AnBuiUCI/sscs-2026-zotnetic/FINAL/reportes/reporte_zotnetic_ES.txt

GUIÓN DEL REPORTE — TEAM ZOTNETIC B26

Acompaña a reporte_zotnetic_ES.pptx (presentación en español).
Qué dice cada diapositiva y para qué está, en el mismo orden que el
fichero. En español en las dos versiones: la presentación cambia de
idioma, quien la presenta no.

Generado por hacer_pptx.py junto con el .pptx. No editar a mano.
==============================================================================

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

DIAPOSITIVA 2 · 01 QUÉ HACE EL CHIP  [SECCIÓN]
----------------------------------------------
Separador. Antes de enseñar un transistor, qué problema resuelve el chip.

DIAPOSITIVA 3 · EL PRINCIPIO
----------------------------
La idea que hay que entender antes que nada: los cuatro puentes NO miden la
dirección del campo, miden su módulo en cuatro puntos.

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

La salida no dice cuánto, dice hacia dónde: un signo por eje.

DIAPOSITIVA 4 · ARQUITECTURA
----------------------------
El diagrama de bloques del sistema completo, el que ya teníais en la
presentación.

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

DIAPOSITIVA 5 · ESPECIFICACIONES
--------------------------------
La tabla de especificaciones: entradas, salidas, consumo, tipos de pad y
áreas, todo en una diapositiva.

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

DIAPOSITIVA 6 · ESPECIFICACIONES
--------------------------------
Y la misma información en unidades que se pueden imaginar. Todo el reporte
trabaja en dR/R —el cambio relativo de resistencia de un brazo del puente—
porque es lo que ve el circuito y no depende del sensor que se le ponga
delante. Pero nadie tiene intuición para 44 ppm.

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

DIAPOSITIVA 7 · 02 LOS TRES BLOQUES  [SECCIÓN]
----------------------------------------------
Separador. Empieza el recorrido por la jerarquía: primero qué hace cada bloque
y su diagrama interno, luego cada subbloque con su esquemático y sus
simulaciones, y al final el resultado del bloque.

DIAPOSITIVA 8 · GRADIENT_NAV2_V3 POR DENTRO
-------------------------------------------
El navegador por dentro, en un solo dibujo: cuatro bloques de sensado, tres de
peso y tres de salida.

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

DIAPOSITIVA 9 · LA ALIMENTACIÓN DEL BLOQUE
------------------------------------------
Cómo se reparte la alimentación dentro del bloque, que es lo último que se
rehízo.

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

DIAPOSITIVA 10 · BLOQUE 1 · SENSADO DE GRADIENTE
------------------------------------------------
El primero de los tres bloques: el sensado de gradiente.

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

DIAPOSITIVA 27 · BANCO DEL GRADIENTE · MÉTODO
---------------------------------------------
Explicados los tres subbloques, el resultado del bloque de sensado.

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

DIAPOSITIVA 28 · BANCO DEL GRADIENTE · MÉTODO
---------------------------------------------
El banco montado: los tres puentes a un lado y las cuatro cadenas colgando de
los mismos nodos, cada una con su fuente separada — se ven las cuatro.

DIAPOSITIVA 29 · TRAZABILIDAD DEL SENSADO
-----------------------------------------
La sub-sección de trazabilidad del sensado, que es lo que faltaba: hasta aquí
se enseñaba el resultado del bloque, no cómo llega la señal hasta él.

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

DIAPOSITIVA 30 · RESULTADO DEL BLOQUE · SENSADO DE GRADIENTE
------------------------------------------------------------
Aquí está el bloque entero en una sola hoja, que es como se pidió. Una COLUMNA
es un eje y una FILA es una etapa, así que un eje se sigue de arriba abajo sin
cambiar de diapositiva: el campo, lo que entrega su puente, el amplificador
que lo lee, el comparador y la decisión.

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

DIAPOSITIVA 31 · RESULTADO DEL BLOQUE · SENSADO DE GRADIENTE
------------------------------------------------------------
La misma hoja con el campo que da una AMR de verdad, dR/R del 2 %. La
diferencia con la anterior es la única variable: aquí el amplificador SATURA,
y se ve recortado contra los dos raíles en toda la fila tercera.

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

DIAPOSITIVA 32 · RESULTADO DEL BLOQUE · SENSADO DE GRADIENTE
------------------------------------------------------------
Esta diapositiva y la siguiente contestan una pregunta distinta a todo lo
anterior, y conviene decirlo antes de enseñarla. Hasta aquí el campo GIRABA
manteniendo su tamaño: se probaba si el chip acierta la dirección. Aquí se
hace lo contrario — la dirección se clava a 60°, en mitad de un sector, y lo
que se barre es el MÓDULO del campo, de casi nada hasta el 2 %.

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

DIAPOSITIVA 33 · RESULTADO DEL BLOQUE · SENSADO DE GRADIENTE
------------------------------------------------------------
La misma pregunta, en el extremo bajo y con su propia escala. Ésta es la que
da el número que importa: el campo MÍNIMO que el chip puede resolver.

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

DIAPOSITIVA 34 · RESULTADO DEL BLOQUE · SENSADO DE GRADIENTE
------------------------------------------------------------
El consumo de la cadena a lo largo del mismo barrido. Sube al pasar por la
zona activa y se aplana cuando el amplificador satura.

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

DIAPOSITIVA 35 · RESULTADO DEL BLOQUE · SENSADO DE GRADIENTE
------------------------------------------------------------
ANTES DE LEER LAS BARRAS, de qué es el porcentaje. Aquí el barrido sigue
subiendo el campo MUCHO después de que el amplificador sature, a propósito,
porque lo que se busca es dónde se rompe. Así que el denominador incluye
puntos que están fuera del alcance del bloque, y por eso salen barras del 75 %
donde otras diapositivas dan 95 %.

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

DIAPOSITIVA 36 · RESULTADO DEL BLOQUE · SENSADO DE GRADIENTE
------------------------------------------------------------
Y ahora sí, la vista condensada de la decisión, que va aquí y no antes porque
hasta este punto el comparador ya está explicado. Las salidas de los
amplificadores, las de los comparadores y las del decodificador, una debajo de
otra, con un color por eje para poder seguir un eje entero. Continuo el
esquemático, discontinuo el layout.

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

DIAPOSITIVA 37 · RESULTADO DEL BLOQUE · SENSADO DE GRADIENTE
------------------------------------------------------------
Y el número. Arriba, el eje decodificado contra el ideal — que es el eje
MENOR, no el mayor: está en la tabla de verdad del decodificador, X = XY·XZ.
Abajo, dónde cae cada frontera respecto a los 0, 120 y 240° exactos.

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

DIAPOSITIVA 38 · POR QUÉ UNOS CASOS FALLAN Y OTROS NO
-----------------------------------------------------
Ésta contesta la pregunta que deja la figura anterior: por qué los octantes
con más signos negativos salen peor. Y la respuesta no es que el chip trate
distinto a un signo que a otro.

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

DIAPOSITIVA 39 · GRADIENT2, TODO LO MEDIDO
------------------------------------------
Y todo lo medido en el bloque, junto. Hasta ahora estaba repartido entre cinco
diapositivas y no había dónde mirar «cuánto da GRADIENT2».

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

DIAPOSITIVA 40 · DÓNDE SE ROMPE, Y BAJO QUÉ CONDICIÓN
-----------------------------------------------------
Y como la tabla anterior deja una condición señalada, el paso siguiente es un
banco hecho para llevar ESA condición al límite y ninguna otra. Doce corridas
nuevas en el mismo esquemático.

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

DIAPOSITIVA 41 · BLOQUE 2 · WEIGHT
----------------------------------
El diagrama interno de WEIGHT: por dónde entra cada señal y qué sale. Se
recorre con el dedo de izquierda a derecha; los números vienen en la
diapositiva siguiente.

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

DIAPOSITIVA 46 · BLOQUE 3 · COMP_OUT
------------------------------------
El diagrama interno de COMP_OUT: por dónde entra cada señal y qué sale. Se
recorre con el dedo de izquierda a derecha; los números vienen en la
diapositiva siguiente.

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

DIAPOSITIVA 51 · ESD_CDM · PROTECCIÓN SECUNDARIA
------------------------------------------------
La protección secundaria. No está en la cadena de señal, pero sí en el área de
usuario y hay once instancias, una por pad analógico.

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

DIAPOSITIVA 53 · 03 RESULTADOS TOTALES  [SECCIÓN]
-------------------------------------------------
Separador. Explicados todos los bloques, los resultados del sistema completo.
Todos son comparaciones de layout contra esquemático.

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

DIAPOSITIVA 55 · BANCO DEL NAVEGADOR · MÉTODO
---------------------------------------------
El banco del navegador completo, el de la versión que se fabrica: los cuatro
puentes y, colgados de sus ocho nodos, los DOS navegadores — el del
esquemático y el reconstruido desde el layout con parásitos.

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

DIAPOSITIVA 56 · BANCO DEL NAVEGADOR · MÉTODO
---------------------------------------------
El método. El navegador del layout va extraído CON parásitos RC, que es lo que
hace la comparación honrada: sin parásitos se estaría comparando el
esquemático consigo mismo.

Cada cadena con su alimentación, para medir los dos consumos sin que se
mezclen.

DIAPOSITIVA 57 · RESULTADO · LAYOUT CONTRA ESQUEMÁTICO
------------------------------------------------------
El resultado en una imagen: las tres salidas de eje, las dos versiones
superpuestas.

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

DIAPOSITIVA 58 · RESULTADO · LAYOUT CONTRA ESQUEMÁTICO
------------------------------------------------------
Los números, sobre 721 puntos de 0 a 360°. Conviene decir que esta diapositiva
llegó a poner 100 %, y era un artefacto: el banco tenía la reconstrucción
cableada con el reparto de sensores viejo y estaba comparando un cableado
contra otro. Arreglado eso y refrescados los netlists extraídos, éstos son los
números de verdad.

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

DIAPOSITIVA 59 · RESULTADO · LAYOUT CONTRA ESQUEMÁTICO
------------------------------------------------------
Cómo se construye una decisión en el chip entero, que es lo que no estaba en
ninguna diapositiva: por cada eje, cuántas de las cuatro cadenas votan
(escalera gris) y qué lee el contador analógico (color).

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

DIAPOSITIVA 60 · RESULTADO · LAYOUT CONTRA ESQUEMÁTICO
------------------------------------------------------
Y las seis salidas que salen del chip, cada par con su gemela negada — que es
literalmente su negado, no el otro sentido.

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

DIAPOSITIVA 61 · RESULTADO · LAYOUT CONTRA ESQUEMÁTICO
------------------------------------------------------
Conviene dejar claro qué dicen esos seis pines, porque es fácil leerlos mal.
NO son seis sentidos. Son tres decisiones con su complemento: XP alto
significa «gana el eje X», y XN es exactamente su negado, que es lo que
alimenta el puente en H.

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

DIAPOSITIVA 62 · RESULTADO · LAYOUT CONTRA ESQUEMÁTICO
------------------------------------------------------
Los casos de prueba por octante en el navegador completo, que es lo que
pediste: el gradiente recorriendo la esfera entera, no un plano, de modo que
las ocho combinaciones de signo de X, Y y Z quedan cubiertas y con el mismo
número de muestras cada una.

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

DIAPOSITIVA 63 · RESULTADO · LAYOUT CONTRA ESQUEMÁTICO
------------------------------------------------------
Y el mismo barrido con el reparto de puertos anterior, para que se vea de
dónde se viene: 76.2 % contra 90.7 %.

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

DIAPOSITIVA 64 · RESULTADO · LAYOUT CONTRA ESQUEMÁTICO
------------------------------------------------------
Aviso antes de leerla: estas dos diapositivas son del reparto de puertos
ANTERIOR, no del que se fabrica. Están aquí porque son el diagnóstico que
llevó a la v3 — enseñan dónde se perdía el acierto, y sin ellas el cambio de
reparto parece un capricho.

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

DIAPOSITIVA 65 · RESULTADO · LAYOUT CONTRA ESQUEMÁTICO
------------------------------------------------------
Y ésta contesta la pregunta que deja la anterior: si cada cadena acierta el
90.9 %, ¿por qué el chip entero se queda en 76.2 %?

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

DIAPOSITIVA 66 · BANCO DE GEOMETRÍA · MÉTODO
--------------------------------------------
El banco de geometría: los cuatro sensores en los vértices del tetraedro de
una caja, y seis cajas distintas.

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

DE DÓNDE SALE:  XSCHEM/TEST_TOTAL/datos_geo/resumen.csv, seis cajas, producido
                por XSCHEM/TEST_TOTAL/run_nav2_geo.sh.

DIAPOSITIVA 67 · BANCO DE GEOMETRÍA · MÉTODO
--------------------------------------------
El banco de geometría montado: el navegador completo, con los sensores en los
vértices de una caja concreta. El barrido repite el experimento entero para
las seis.

DIAPOSITIVA 68 · RESULTADO · GEOMETRÍA DE LA CAJA
-------------------------------------------------
La tabla de las seis cajas. Lo que hay que leer es la FORMA, no el tamaño: la
caja cúbica de 1000 × 1000 llega al 97.8 % con gradiente alto, y achatarla a
Lz 500 cuesta acierto siempre, en las tres anchuras.

DIAPOSITIVA 69 · RESULTADO · GEOMETRÍA DE LA CAJA
-------------------------------------------------
La resolución, y por qué son DOS límites y no uno. Por abajo el offset de los
sensores pone un suelo: con un gradiente demasiado pequeño la diferencia entre
esquinas se pierde dentro del offset. Por arriba la saturación del
amplificador pone un techo. El número que se extrae —el gradiente más pequeño
con 95 % de acierto— captura los dos a la vez.

DIAPOSITIVA 70 · RESULTADO · GEOMETRÍA DE LA CAJA
-------------------------------------------------
Las seis cajas dibujadas. Al achatarlas el tetraedro pierde separación en z, y
con ella la información que distingue arriba de abajo. Explica de un vistazo
por qué la tabla penaliza siempre a las de Lz 500.

DIAPOSITIVA 71 · RESULTADO · GEOMETRÍA DE LA CAJA
-------------------------------------------------
El campo terrestre. Es común a los cuatro sensores, así que se cancela al
compararlos entre sí, pero NO en el amplificador, que lo ve entero y lo
amplifica. La curva enseña a qué nivel de fondo se pierde la medida.

DIAPOSITIVA 72 · BANCO DE FUENTE · MÉTODO
-----------------------------------------
El banco de fuente, la pregunta para la que existe el chip. Ya no se impone un
gradiente: se pone una fuente en un sitio y cada sensor lee el módulo en su
vértice.

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

DIAPOSITIVA 73 · BANCO DE FUENTE · MÉTODO
-----------------------------------------
El banco de fuente montado. Es el que más se parece a un experimento real con
un imán encima de la mesa.

DIAPOSITIVA 74 · RESULTADO · ¿APUNTA A LA FUENTE?
-------------------------------------------------
El ángulo que da el chip frente al ideal, por modelo y distancia.

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

DIAPOSITIVA 75 · RESULTADO · ¿APUNTA A LA FUENTE?
-------------------------------------------------
Ésta es la diapositiva que estaba al principio y que movimos aquí: ahora llega
en su sitio. Para cada uno de los cuatro vértices se dibuja el módulo que
debería leer y lo que su puente entrega. Las cuatro lecturas son distintas
entre sí, y esa diferencia ES el gradiente.

DIAPOSITIVA 76 · RESULTADO · ¿APUNTA A LA FUENTE?
-------------------------------------------------
Primero qué es cada eje, porque no es obvio. El eje horizontal NO es el ángulo
medido: es dónde está la fuente alrededor de la caja. El vertical sí es el
error — el ángulo entre el gradiente que el chip reconstruye de los cuatro
puentes y la dirección real a la fuente.

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

DIAPOSITIVA 77 · RESULTADO · ¿APUNTA A LA FUENTE?
-------------------------------------------------
La pregunta práctica: ¿sigue encontrando la fuente según te alejas? A la
izquierda, el acierto contra la distancia, con los dos modelos de campo y las
dos versiones de cableado. Cae de forma suave: a 2 mm el chip acierta el 91 %
y a 18 mm el 67 %.

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

DIAPOSITIVA 78 · RESULTADO · ¿APUNTA A LA FUENTE?
-------------------------------------------------
Los dos separados: lo que sale del chip, y lo que sale menos lo que daría un
chip perfecto. Lo segundo es la parte que pone el circuito. Justifica haber
corrido dos modelos en lugar de uno.

DIAPOSITIVA 79 · 04 VERIFICACIÓN FÍSICA  [SECCIÓN]
--------------------------------------------------
Separador. Se acaba la simulación y empieza lo que se entrega.

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

DIAPOSITIVA 81 · VERIFICACIÓN FÍSICA
------------------------------------
La verificación, toda sobre B26_A_filled4.gds, el fichero que se sube, no
sobre una versión anterior.

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

DIAPOSITIVA 82 · 05 CONCLUSIONES  [SECCIÓN]
-------------------------------------------
Separador. Lo esperado contra lo medido, incluido lo que no cerró.

DIAPOSITIVA 83 · LO ESPERADO CONTRA LO MEDIDO
---------------------------------------------
Tres cosas que se esperaban de una manera y resultaron ser de otra: XP y XN
cambiados respecto a su etiqueta, el umbral fuera de sitio, y el eje Z sin
poder ganar nunca.

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

DIAPOSITIVA 84 · LO QUE NO CERRÓ
--------------------------------
Lo que no cerró: el LVS de KLayout sobre el top no termina la extracción. Tres
intentos, ninguno llegó a comparar.

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

DIAPOSITIVA 85 · LA MEJORA, YA DENTRO DEL DIE
---------------------------------------------
El esquemático de la v3. Comparado con el del chip no cambia ni una celda: son
los mismos cuatro GRADIENT2, los mismos tres WEIGHT y los mismos tres
COMP_OUT.

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

DIAPOSITIVA 86 · LA MEJORA, YA DENTRO DEL DIE
---------------------------------------------
La v3 contra su propio layout, con las celdas extraídas con parásitos RC. El
verificador de grafo confirma que el navegador reconstruido ES el mismo
circuito que el esquemático de la v3, 31 celdas.

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

DIAPOSITIVA 87 · LA MEJORA, YA DENTRO DEL DIE
---------------------------------------------
De dónde sale la mejora, que se ve directamente en el análisis de las cadenas.

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

DIAPOSITIVA 88 · 06 ESTADO  [SECCIÓN]
-------------------------------------
Cierre. El chip está terminado y verificado, y el entregable es
B26_A_filled4.gds, con el navegador v3 dentro, sha 543d31ff.

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

Es la que conviene dejar en pantalla mientras se responden preguntas.
