AnBuiUCI/sscs-2026-zotnetic/FINAL/layouts_v2/RED_SUMA/RED_SUMA_flat_gf180_report.txt

# Reporte de layout: RED_SUMA
PDK: gf180
Transistores: 0
Nets: 0
Nets abutidas (difusion compartida): []
Ancho de la celda: 1.00 um
Tamano total: 3.00 x 121.30 um

## Transistores

## Conexiones (net -> pines)
