AnBuiUCI/sscs-2026-zotnetic/FINAL/integration/gds/2026-08-31_02/NOTAS.txt

2026-08-31_02 -- B26_A_filled.gds
=================================

source      openroad/out_integration/B26_A_filled.gds
written     2026-08-31 07:14
size        13,409,342 bytes raw, 2,492,394 gzipped
sha256      95ebcf92d8d36680bbf84d5530bdb882e7adeee7ccd2bdf8a0b5cda10dfe25ac

DRC filled  INCOMPLETE -- 5 table(s) raised: ldnmos, nwell, ldpmos, lvpwell, mslot
DRC circuit clean (1 tables)
density     clean
LVS klayout not run
LVS netgen  match uniquely

what changed
------------
Los escapes de pin pasan de placa maciza a peine: un dedo por diente mas una espina de 2 um que los une. Se van los once MSLOT.1 (placas de 55.7 x 44.3 um de Metal2, una por pad analogico, 5 al oeste y 6 al norte). El DRC de firma sobre el circuito corre en modo main/deep, que es el unico en el que la tabla mslot del PDK no revienta: 253 categorias, 0 items. Se entrega como B26_A_filled2.gds, byte a byte igual que este.

DRC completo -- anadido a mano el 2026-08-31, tras terminar el run
-----------------------------------------------------------------
La linea "DRC filled INCOMPLETE" de arriba es del run de TABLAS SEPARADAS, que
sobre un fichero relleno pierde cinco tablas (ldnmos, nwell, ldpmos, lvpwell y
mslot) y por eso no es un veredicto.

El run que si lo es, una sola tabla `main` en modo `deep` y un hilo, sobre este
mismo fichero:

    out/drc_B26_A_FILLED/B26_A_filled_main.lyrdb
    253 categorias declaradas, 0 items      LIMPIO
    MSLOT.1 entre las categorias, o sea que la regla corrio de verdad

Es la primera vez en este proyecto que el fichero que se entrega pasa el deck
COMPLETO, `mslot` incluida.
