AnBuiUCI/sscs-2026-zotnetic/FINAL/Layouts/COMP/COMP_flat_gf180.png

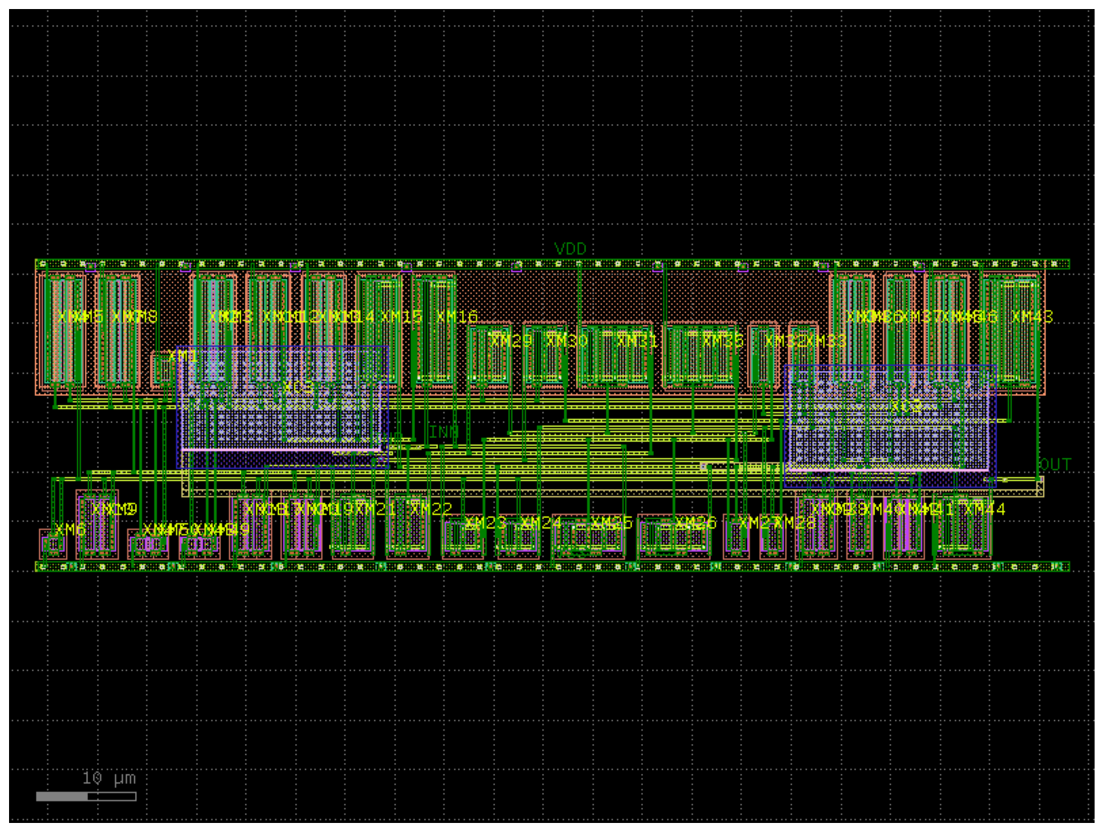
FINAL/Layouts/COMP/COMP_flat_gf180.png
