AnBuiUCI/sscs-2026-zotnetic/FINAL/Layouts/DECODER/DECODER_flat_gf180.png

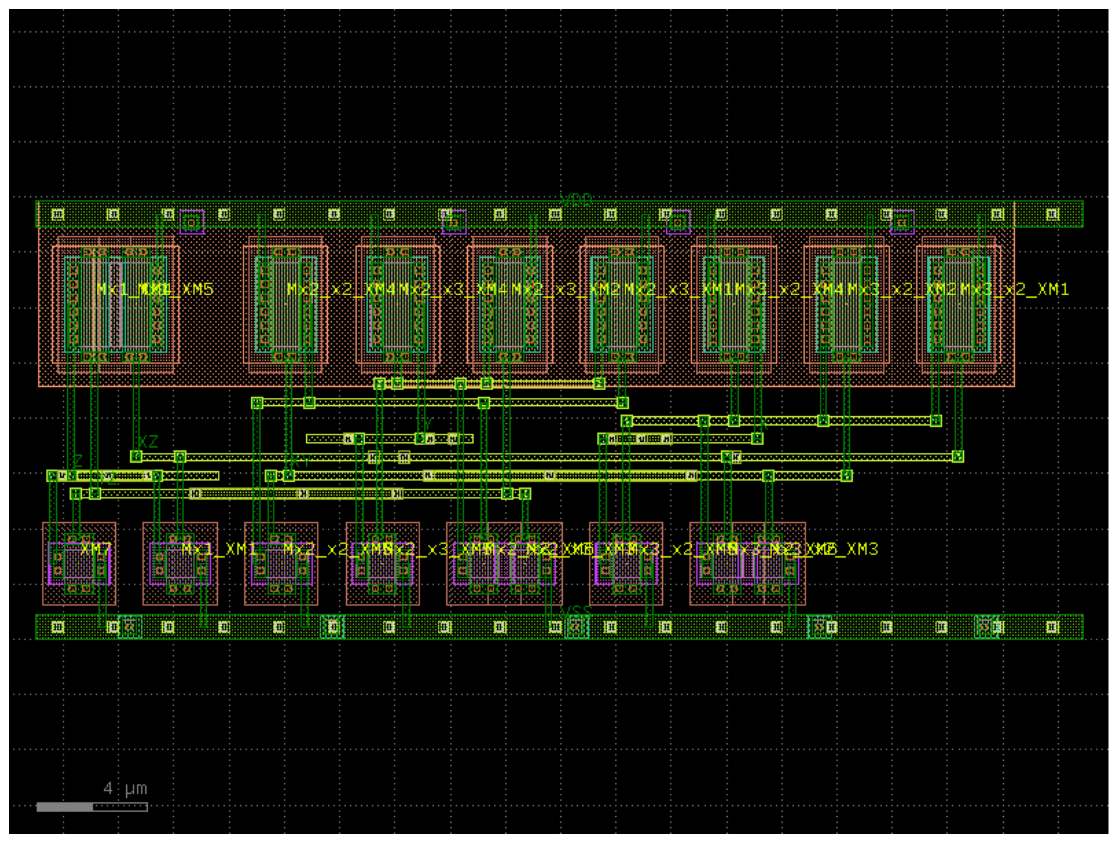
FINAL/Layouts/DECODER/DECODER_flat_gf180.png
