AnBuiUCI/sscs-2026-zotnetic/FINAL/Layouts/ESD_CDM/ESD_CDM_flat_gf180.png

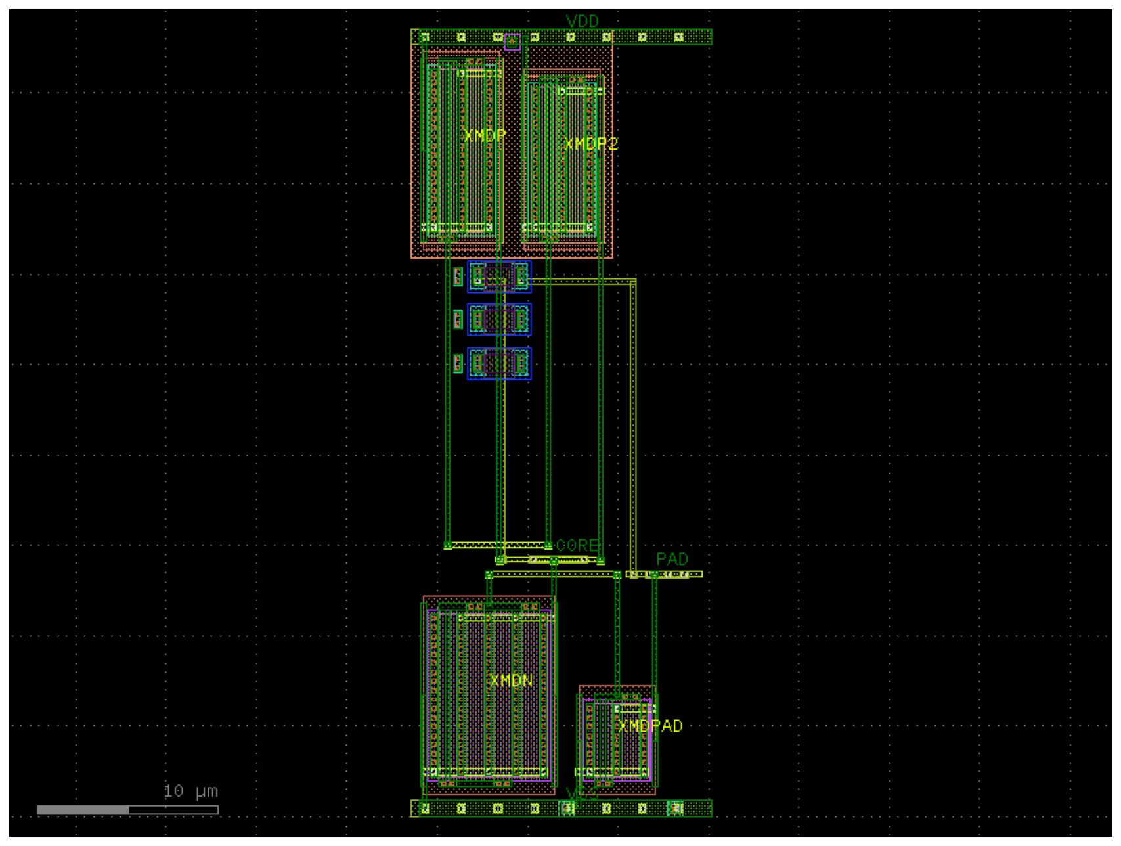
FINAL/Layouts/ESD_CDM/ESD_CDM_flat_gf180.png
