AnBuiUCI/sscs-2026-zotnetic/FINAL/Layouts/OPAM/OPAM_flat_gf180.png

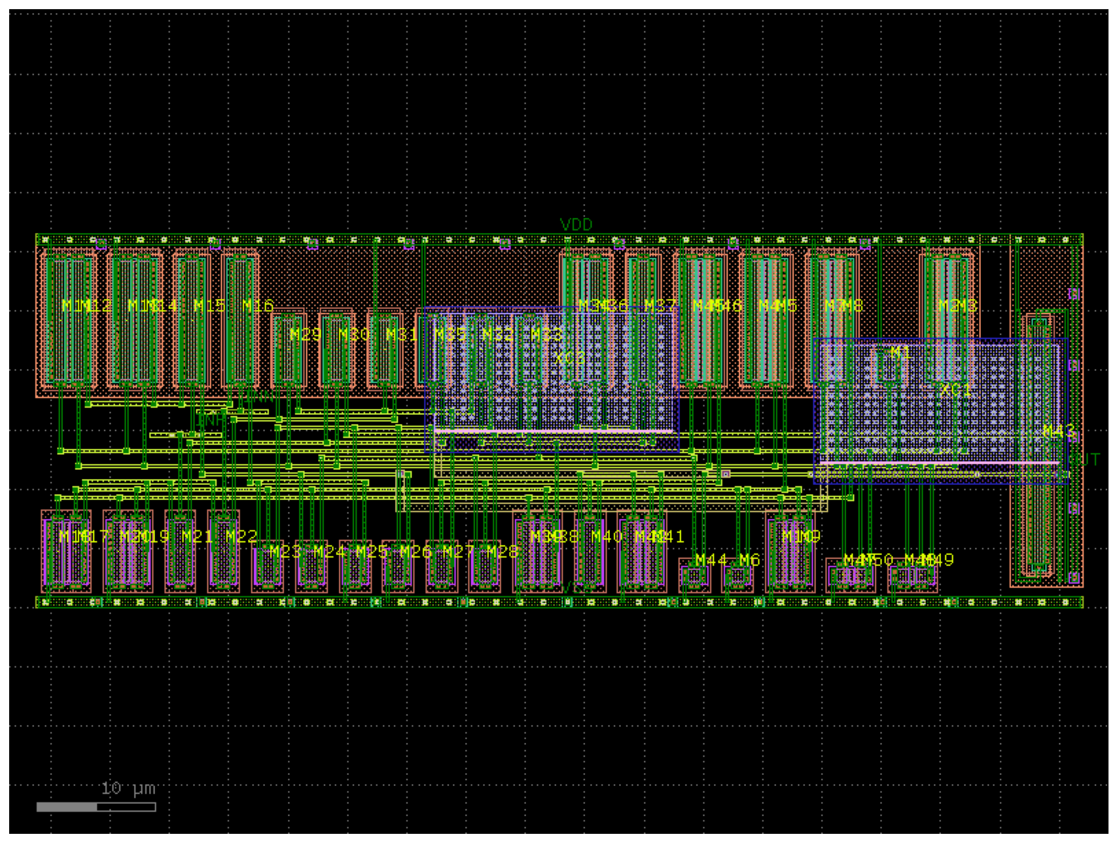
FINAL/Layouts/OPAM/OPAM_flat_gf180.png
