AnBuiUCI/sscs-2026-zotnetic/FINAL/Layouts/OPAM_LIN_flat/OPAM_LIN_flat_flat_gf180.png

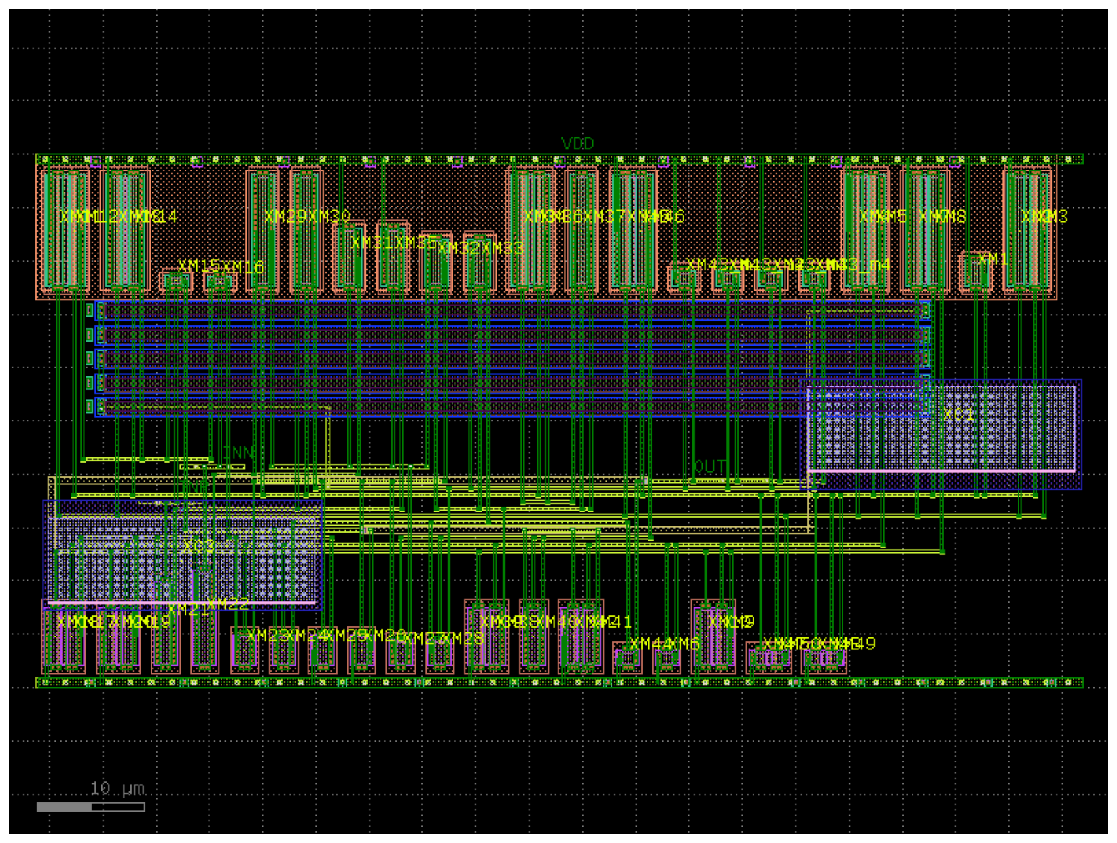
FINAL/Layouts/OPAM_LIN_flat/OPAM_LIN_flat_flat_gf180.png
