AnBuiUCI/sscs-2026-zotnetic/FINAL/Layouts/WEIGHT_COMP/WEIGHT_COMP_flat_gf180.png

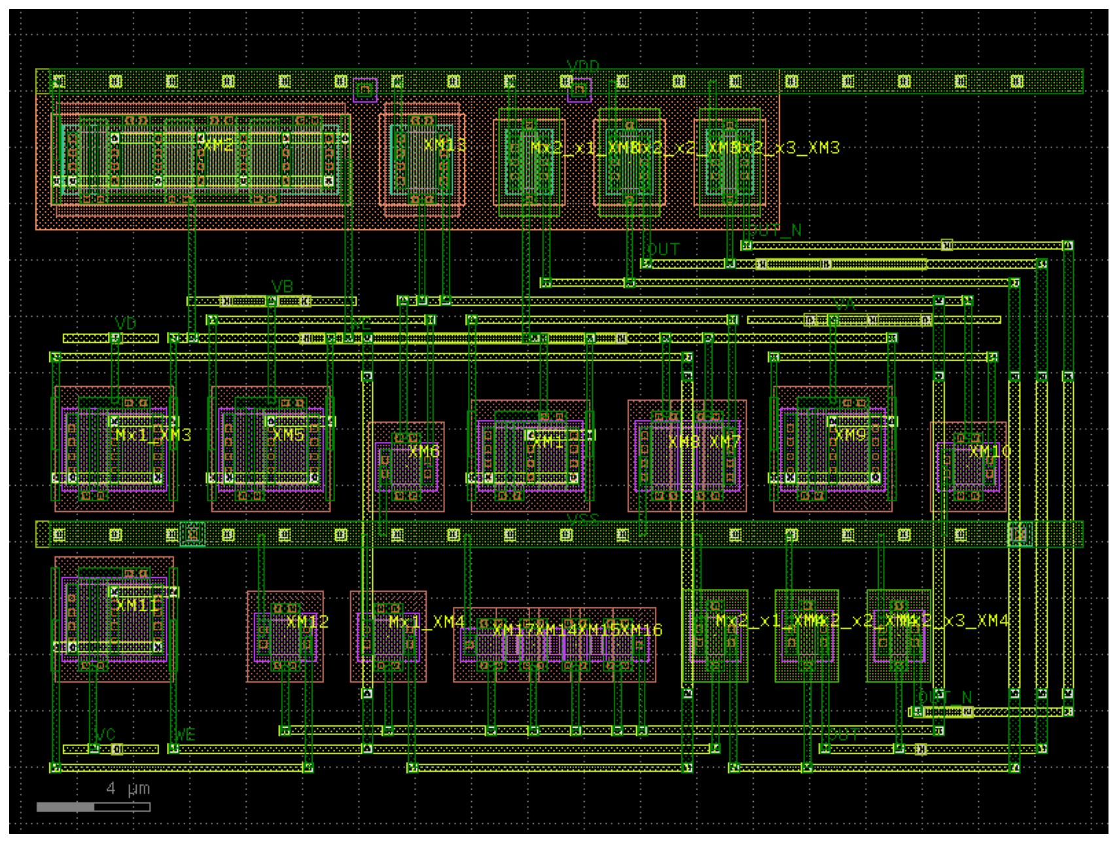
FINAL/Layouts/WEIGHT_COMP/WEIGHT_COMP_flat_gf180.png
