AnBuiUCI/sscs-2026-zotnetic/FINAL/layouts_v2/DECODER/DECODER_flat_gf180.png

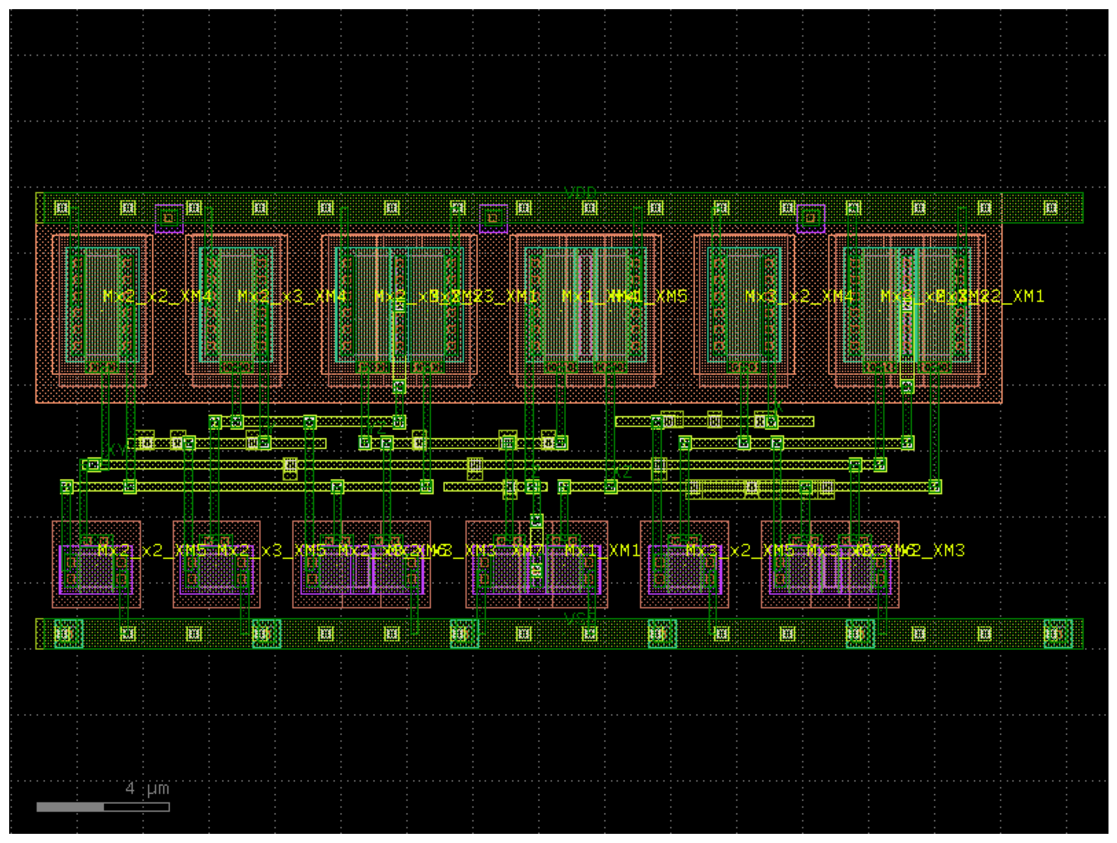
FINAL/layouts_v2/DECODER/DECODER_flat_gf180.png
