AnBuiUCI/sscs-2026-zotnetic/FINAL/layouts_v2/DECODER_MAX/DECODER_MAX_flat_gf180.png

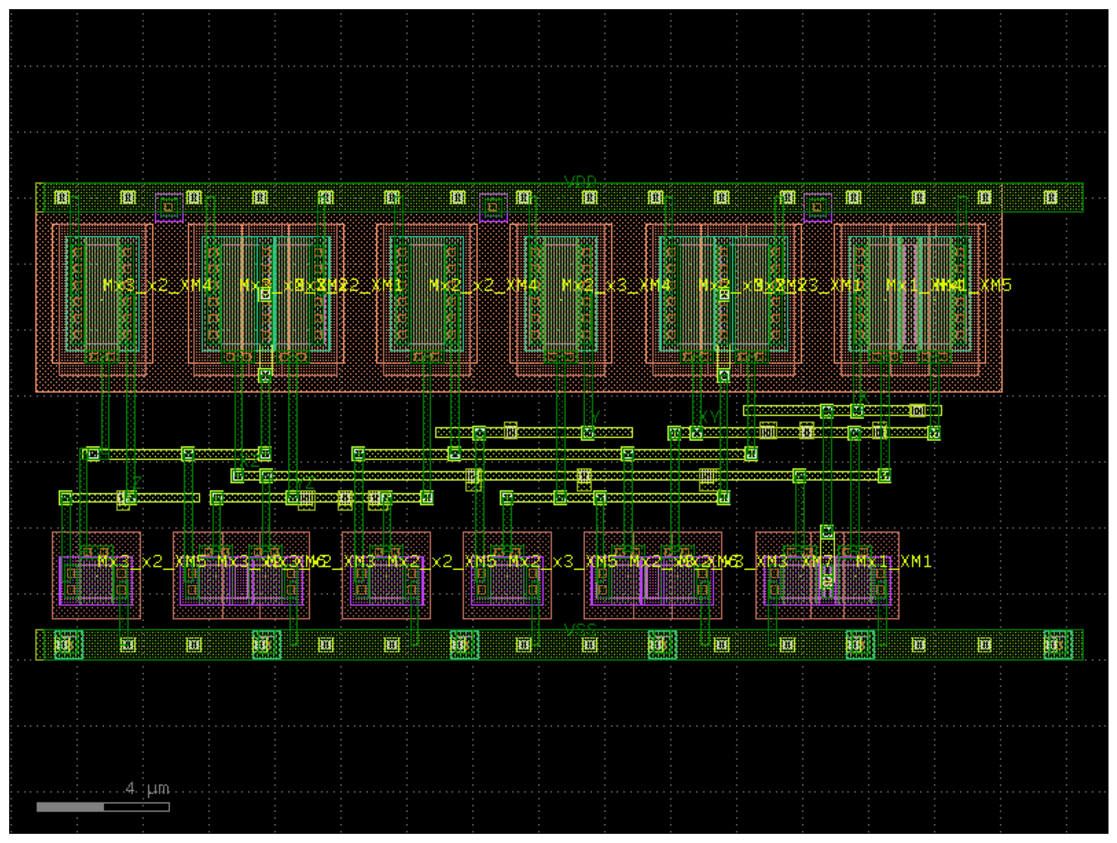
FINAL/layouts_v2/DECODER_MAX/DECODER_MAX_flat_gf180.png
