AnBuiUCI/sscs-2026-zotnetic/FINAL/layouts_v2/OPAM_LIN_flat/OPAM_LIN_flat_flat_gf180.png

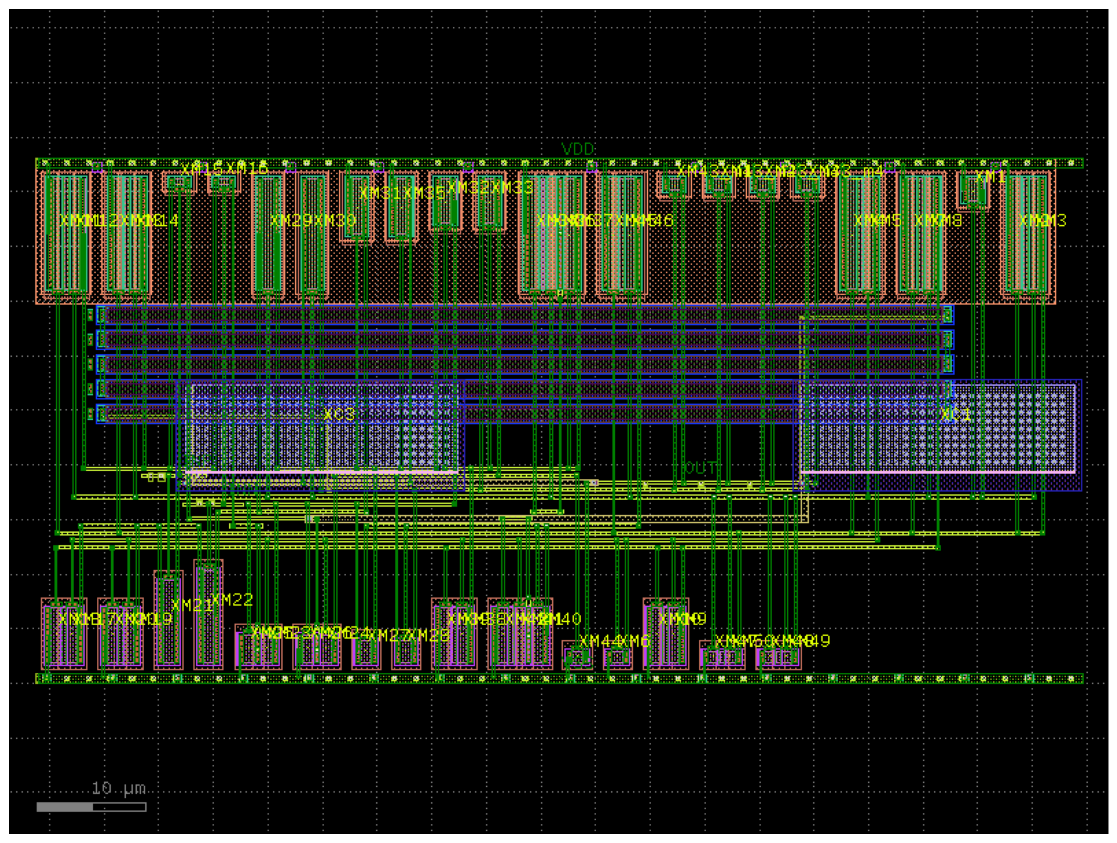
FINAL/layouts_v2/OPAM_LIN_flat/OPAM_LIN_flat_flat_gf180.png
