AnBuiUCI/sscs-2026-zotnetic/FINAL/layouts_v2/OPAM_SUMA/OPAM_SUMA_flat_gf180.png

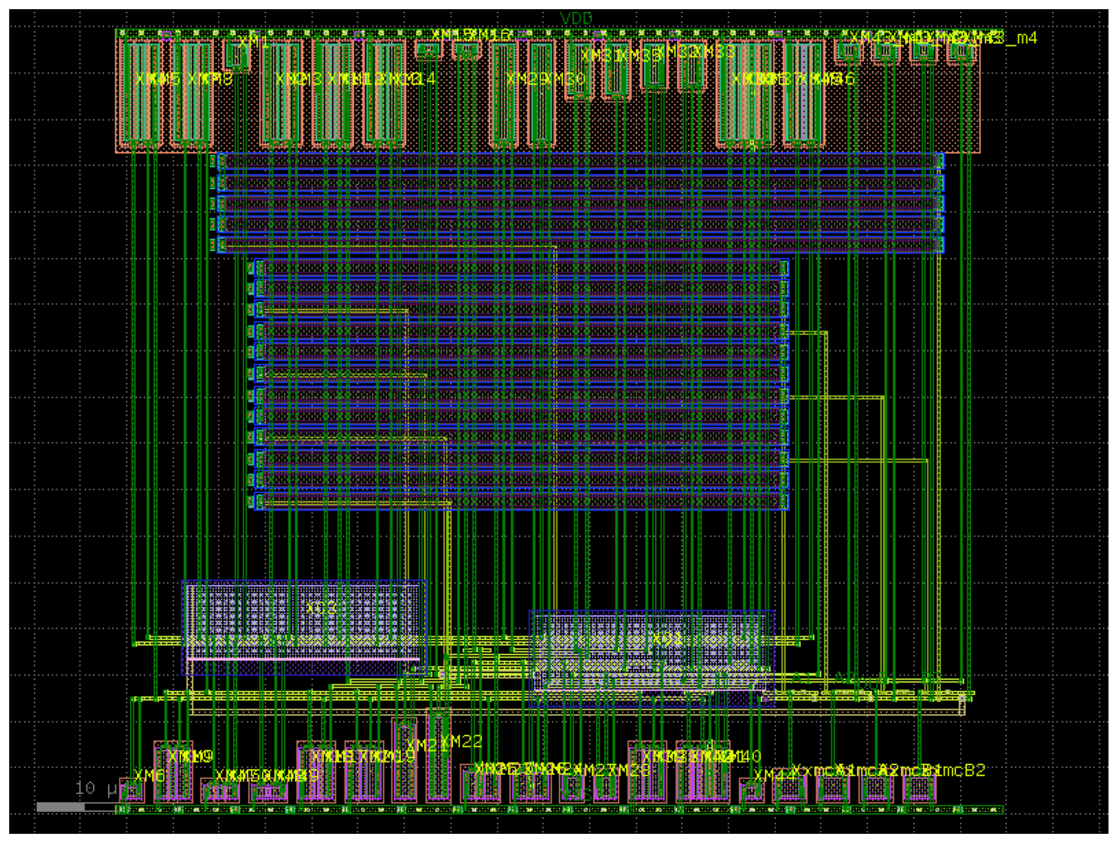
FINAL/layouts_v2/OPAM_SUMA/OPAM_SUMA_flat_gf180.png
