AnBuiUCI/sscs-2026-zotnetic/FINAL/layouts_v2/RED_SUMA/RED_SUMA_flat_gf180.png

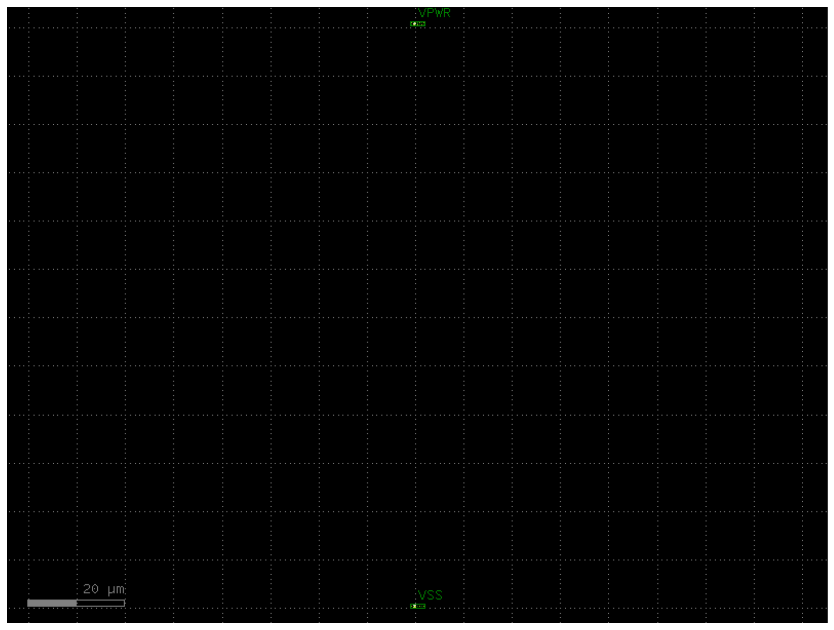
FINAL/layouts_v2/RED_SUMA/RED_SUMA_flat_gf180.png
