AnBuiUCI/sscs-2026-zotnetic/FINAL/layouts_v2/WEIGHT_COMP/WEIGHT_COMP_flat_gf180.png

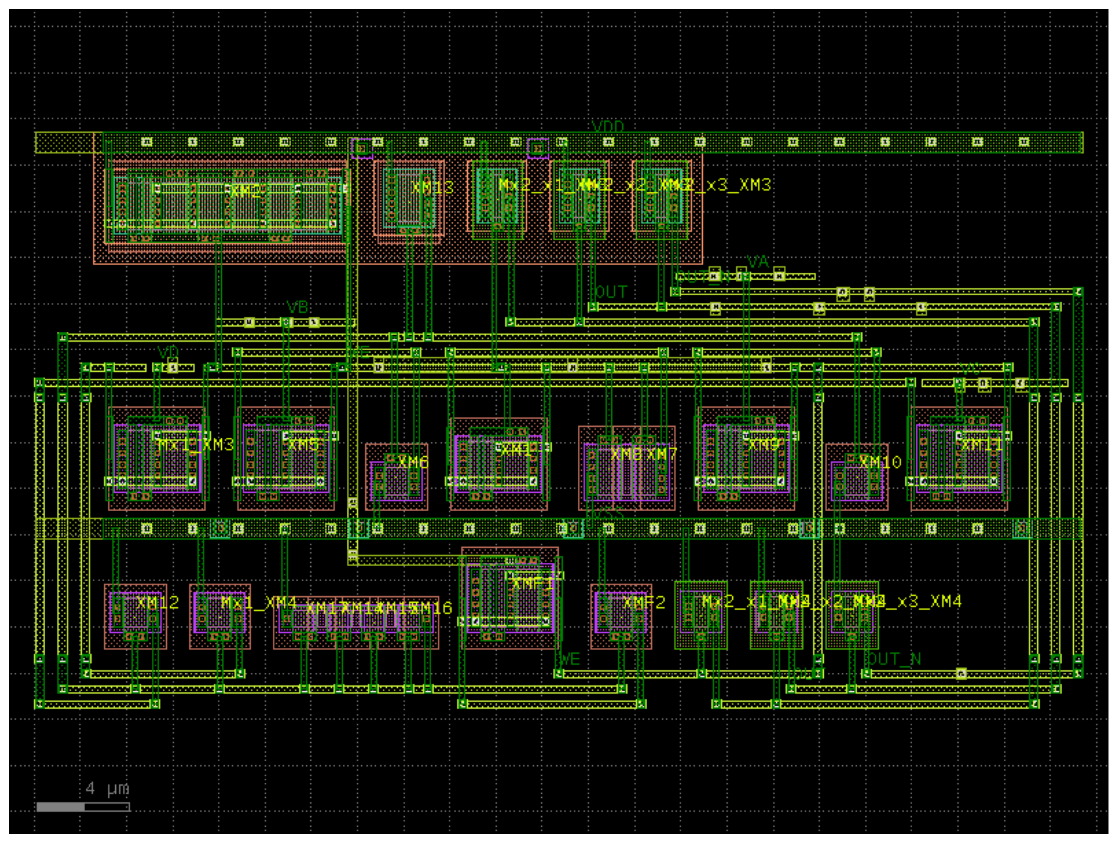
FINAL/layouts_v2/WEIGHT_COMP/WEIGHT_COMP_flat_gf180.png
