AnBuiUCI/sscs-2026-zotnetic/FINAL/openroad/out/GRADIENT_NAV.png

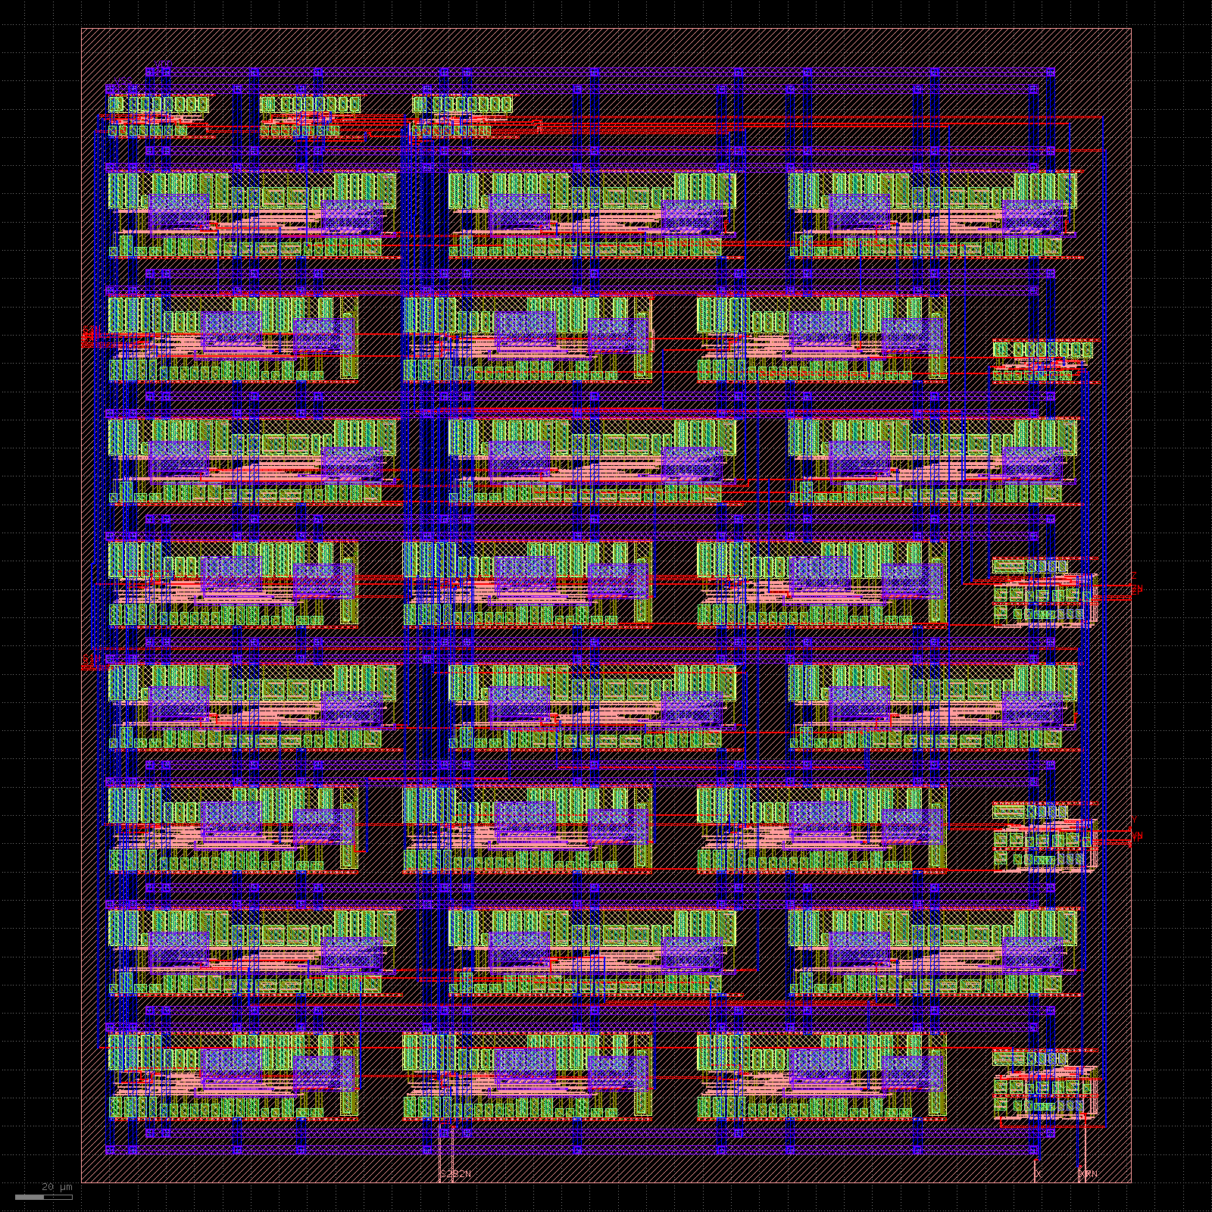
FINAL/openroad/out/GRADIENT_NAV.png
