AnBuiUCI/sscs-2026-zotnetic/FINAL/openroad/out_waferspace/cuatro.png

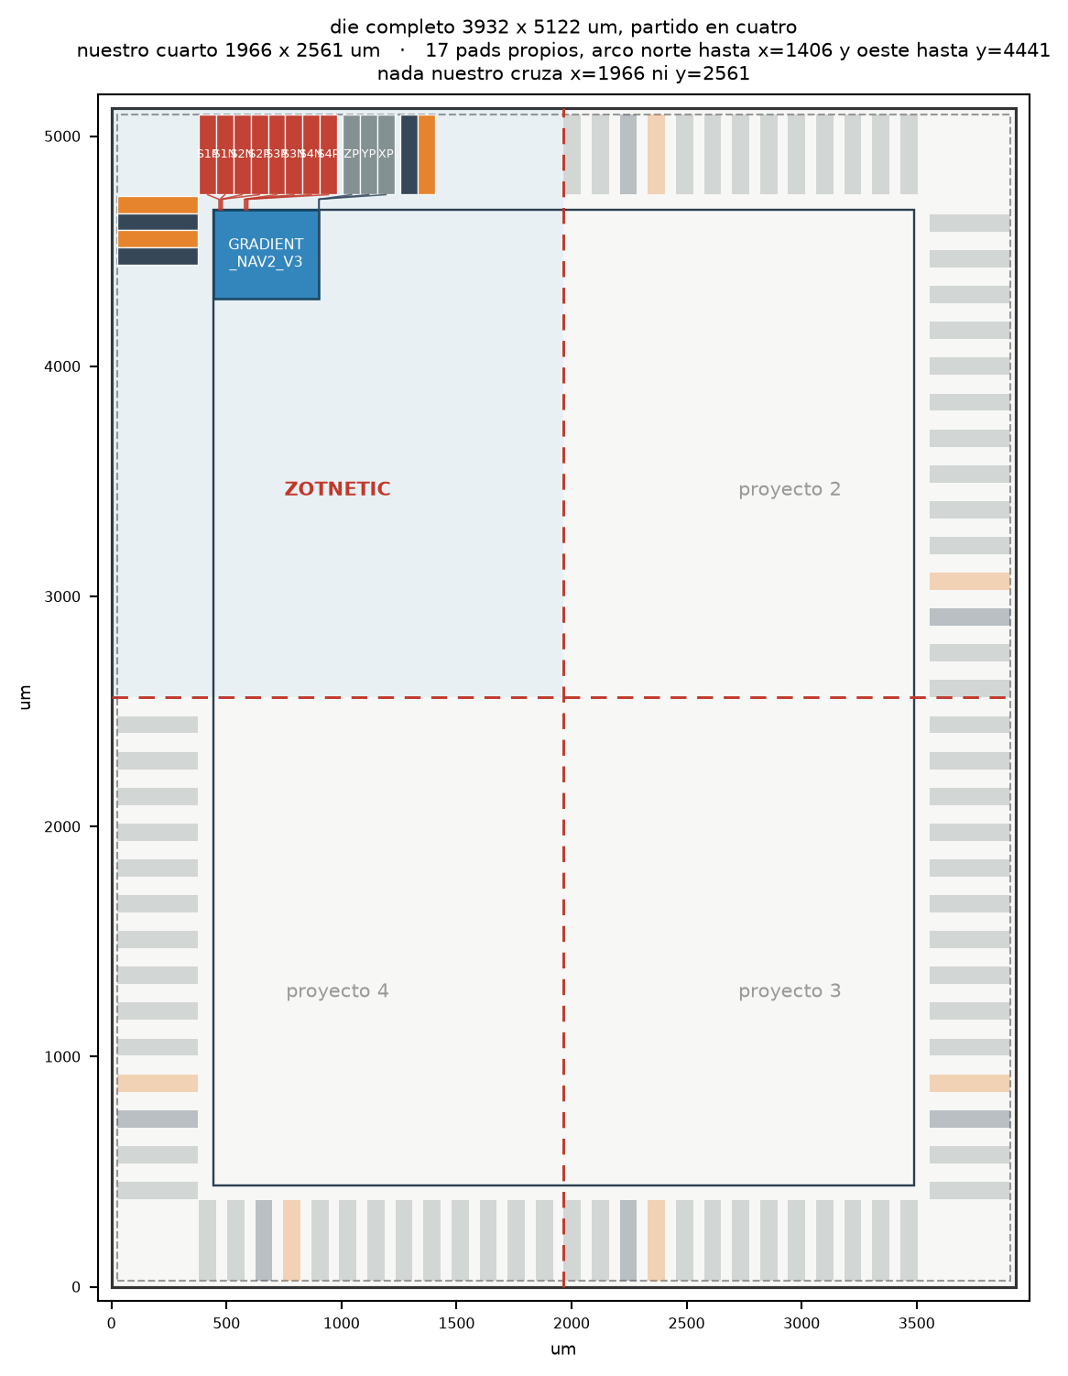
FINAL/openroad/out_waferspace/cuatro.png
