AnBuiUCI/sscs-2026-zotnetic/FINAL/openroad/out_waferspace/quarter.png

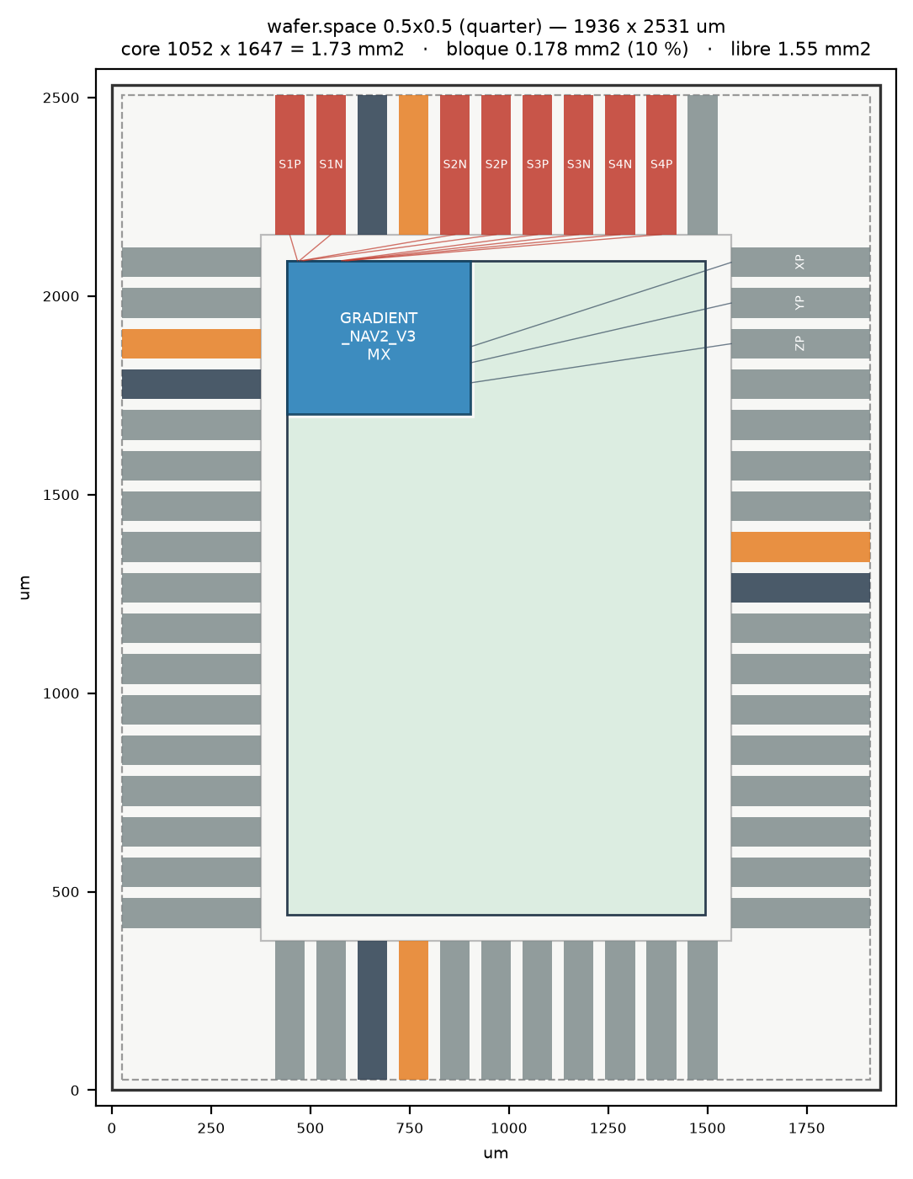
FINAL/openroad/out_waferspace/quarter.png
