AnBuiUCI/sscs-2026-zotnetic/FINAL/reportes/figuras/geo_desajuste.png

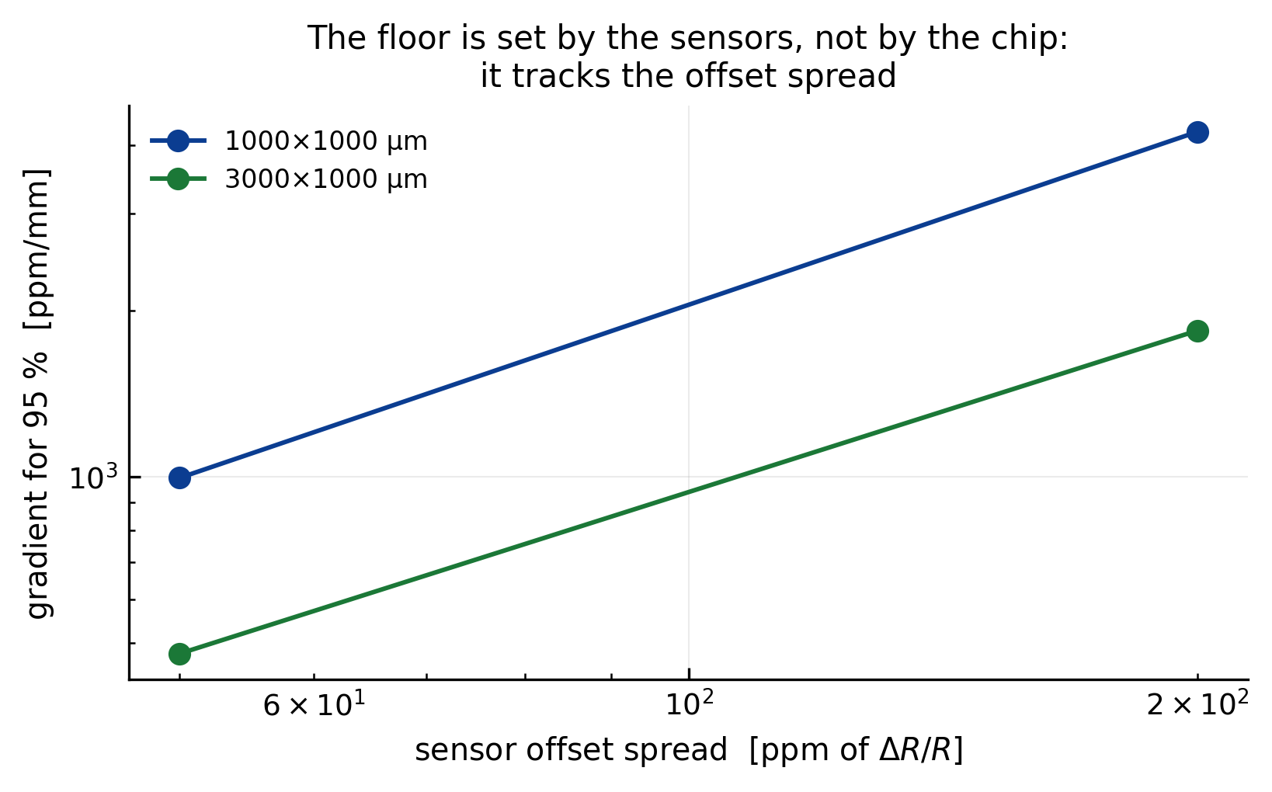
FINAL/reportes/figuras/geo_desajuste.png
