AnBuiUCI/sscs-2026-zotnetic/FINAL/reportes/figuras/geo_isotropia.png

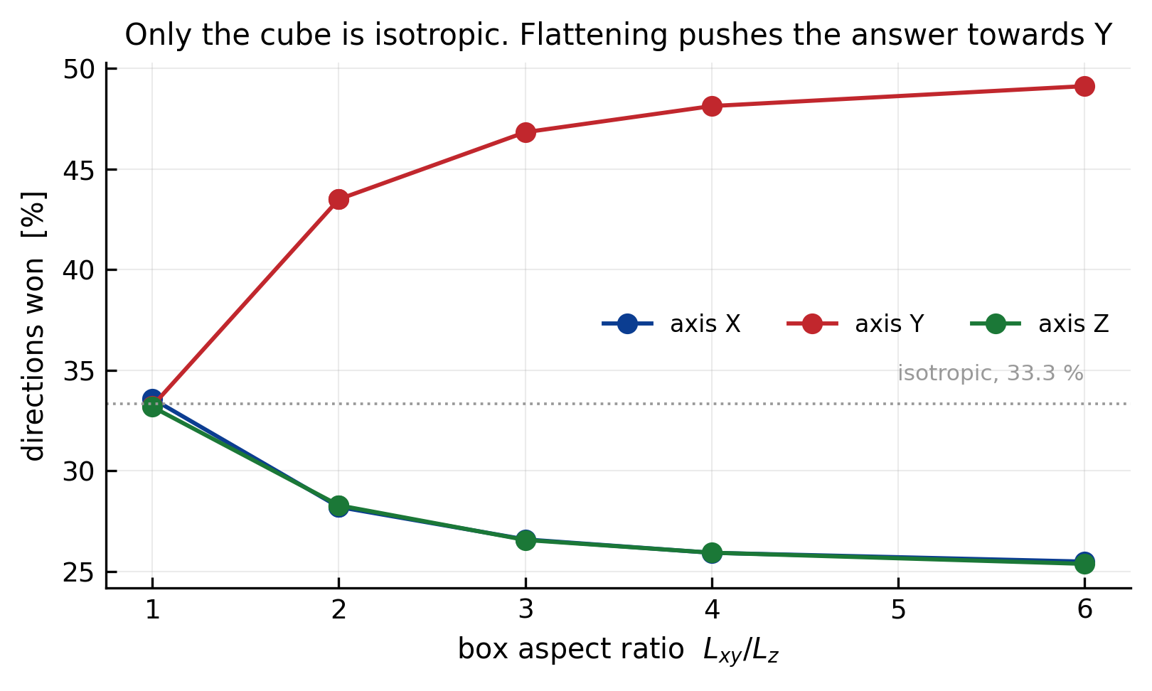
FINAL/reportes/figuras/geo_isotropia.png
