AnBuiUCI/sscs-2026-zotnetic/FINAL/reportes/figuras/geo_sentido_1000x1000.png

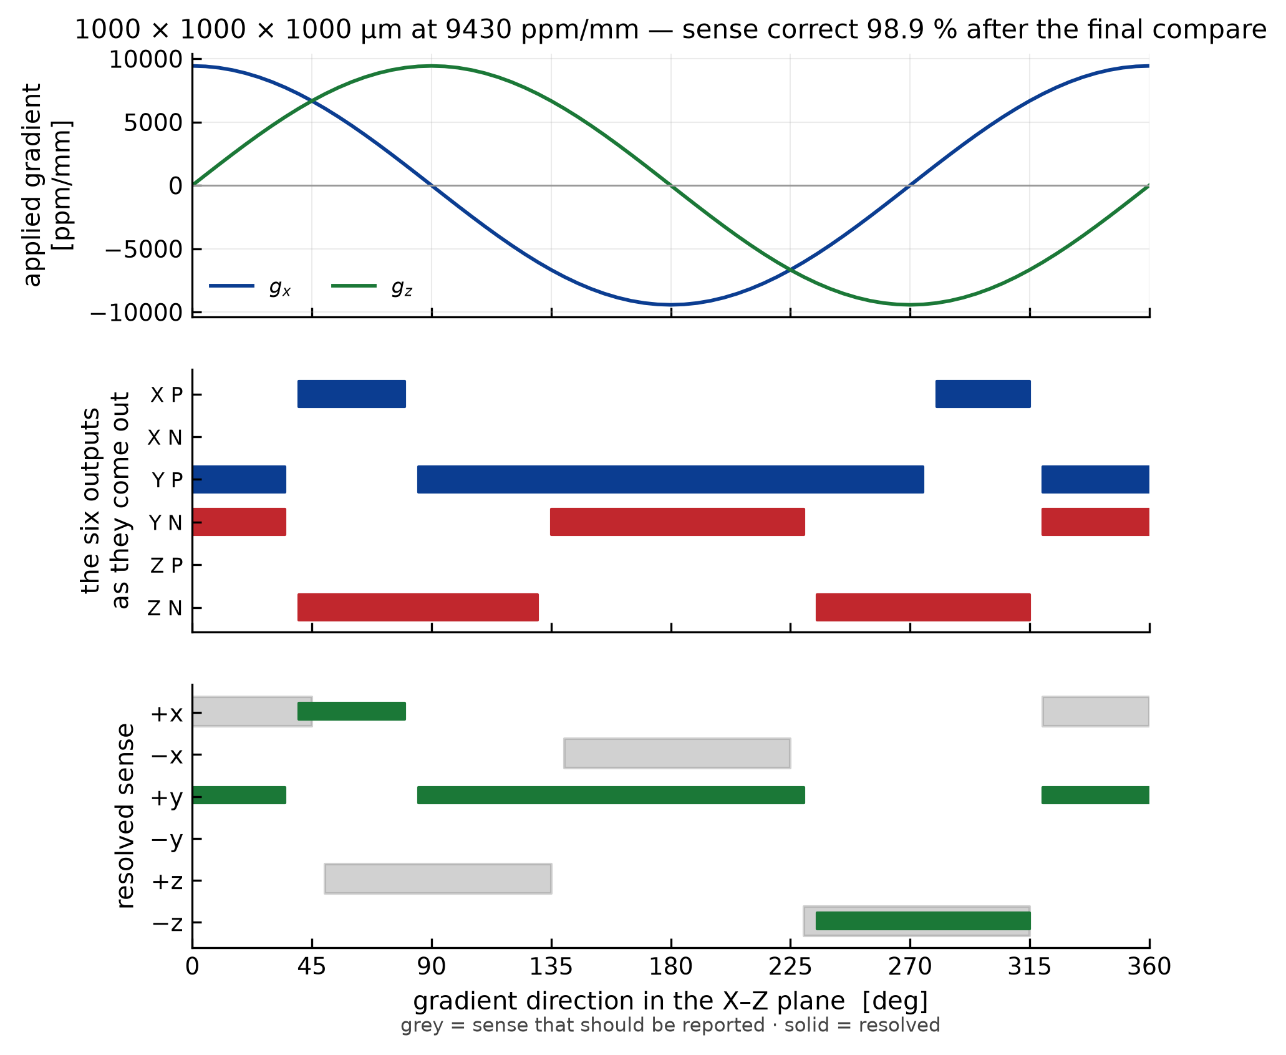
FINAL/reportes/figuras/geo_sentido_1000x1000.png
