AnBuiUCI/sscs-2026-zotnetic/FINAL/reportes/figuras/grad_amplificadores_fino.png

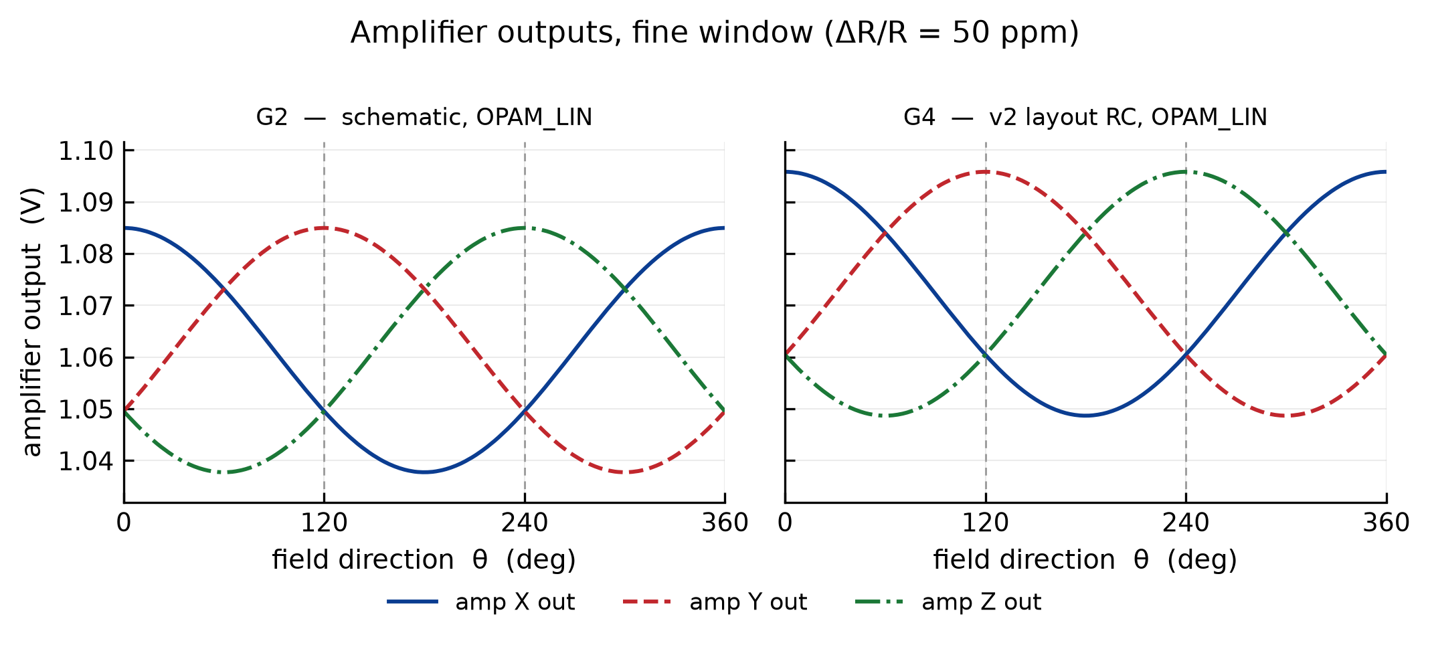
FINAL/reportes/figuras/grad_amplificadores_fino.png
