AnBuiUCI/sscs-2026-zotnetic/FINAL/reportes/figuras/grad_comparadores.png

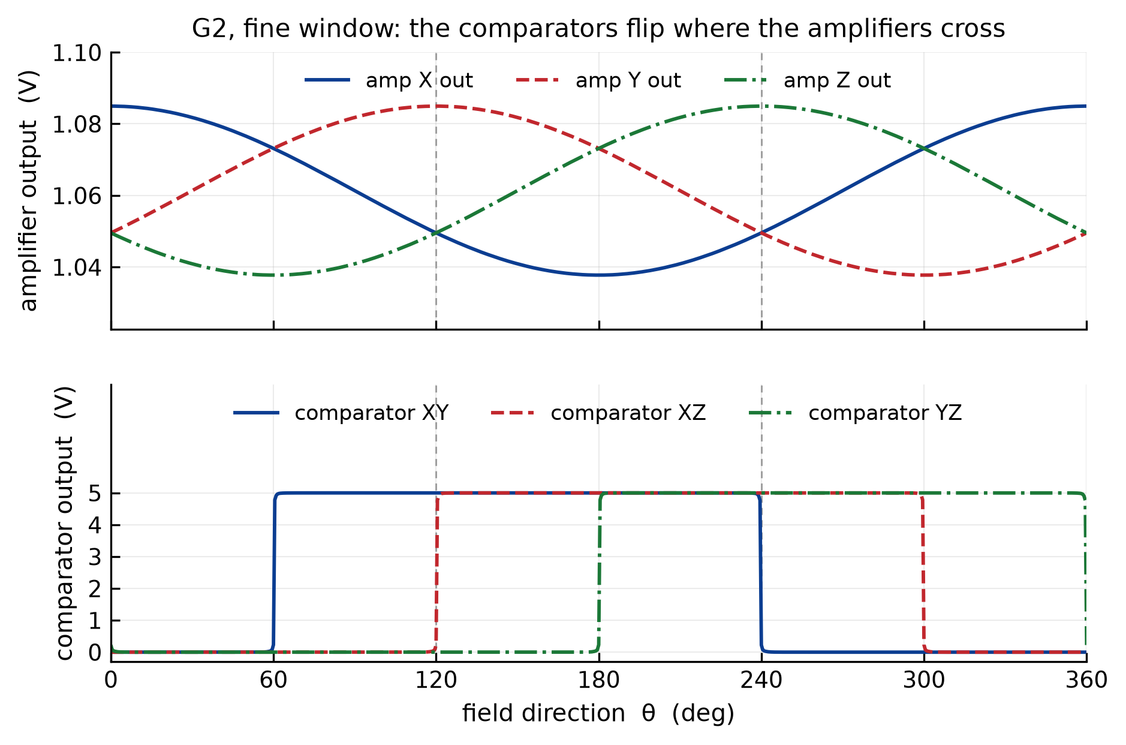
FINAL/reportes/figuras/grad_comparadores.png
