AnBuiUCI/sscs-2026-zotnetic/FINAL/reportes/figuras/grad_error_sectores.png

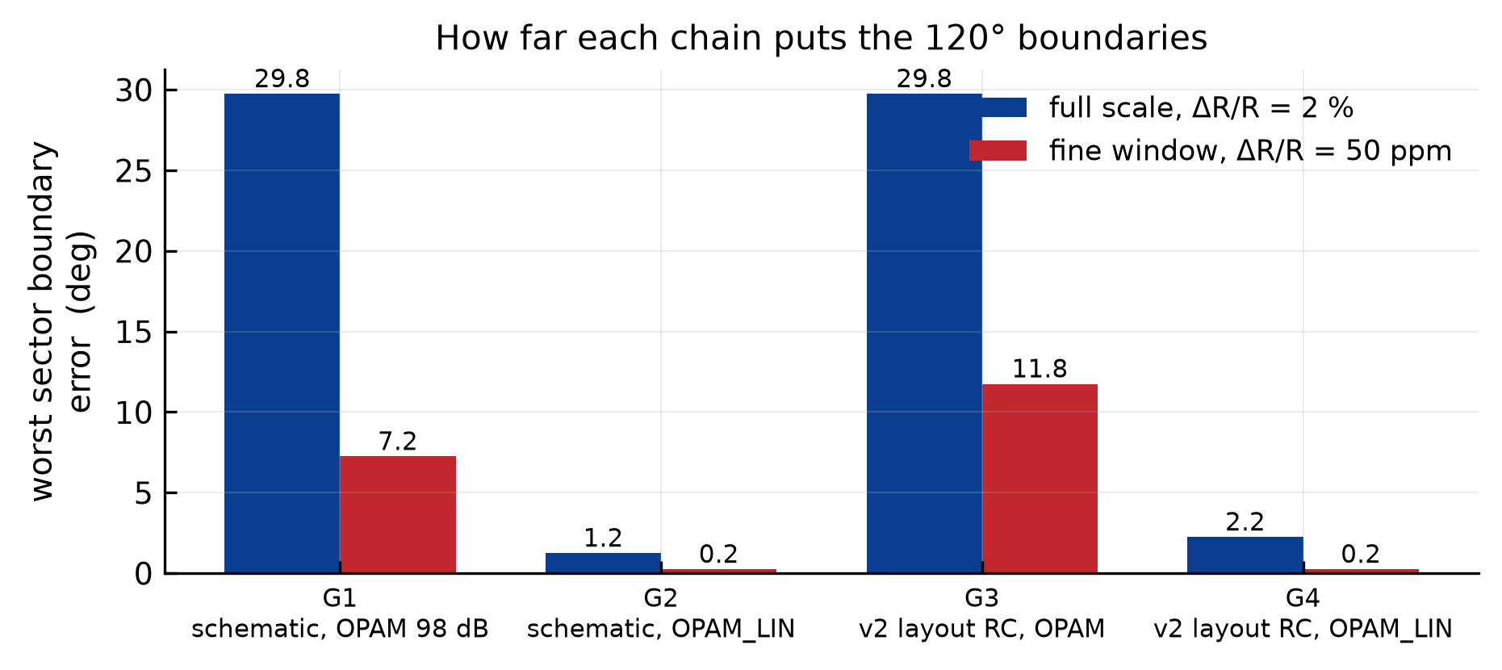
FINAL/reportes/figuras/grad_error_sectores.png
