AnBuiUCI/sscs-2026-zotnetic/FINAL/reportes/figuras/grad_estimulo.png

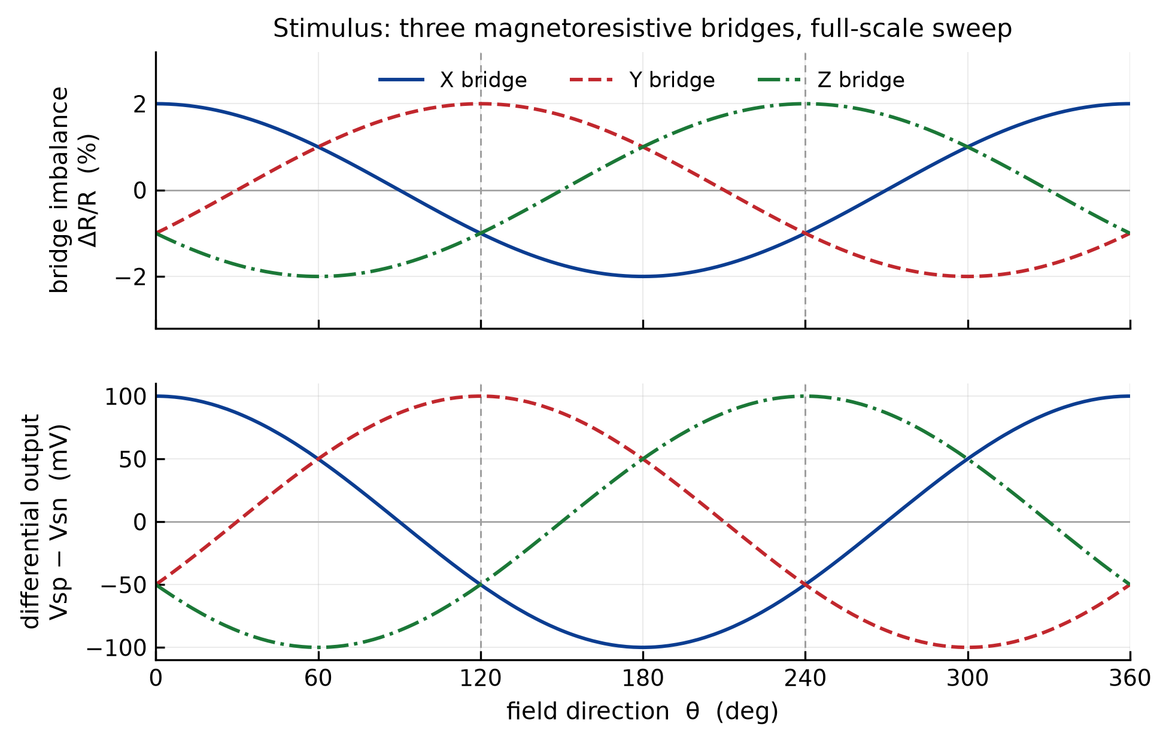
FINAL/reportes/figuras/grad_estimulo.png
