AnBuiUCI/sscs-2026-zotnetic/FINAL/reportes/figuras/grad_puente.png

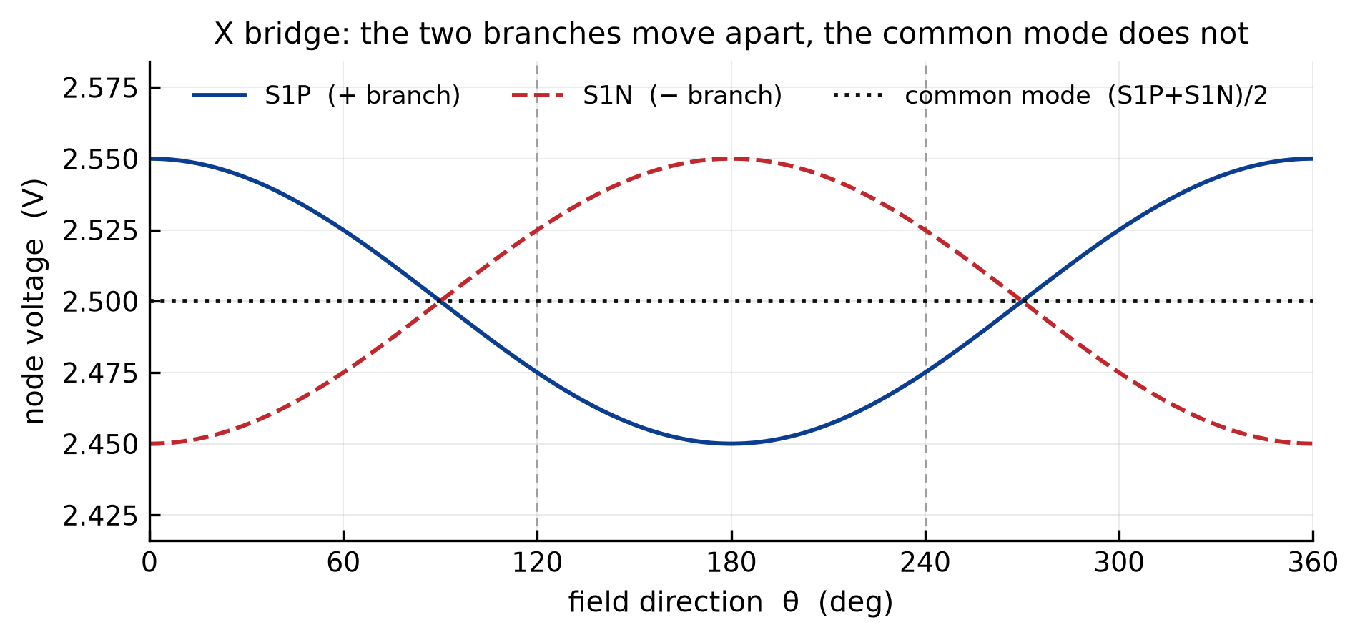
FINAL/reportes/figuras/grad_puente.png
