AnBuiUCI/sscs-2026-zotnetic/FINAL/reportes/figuras/grad_sectores.png

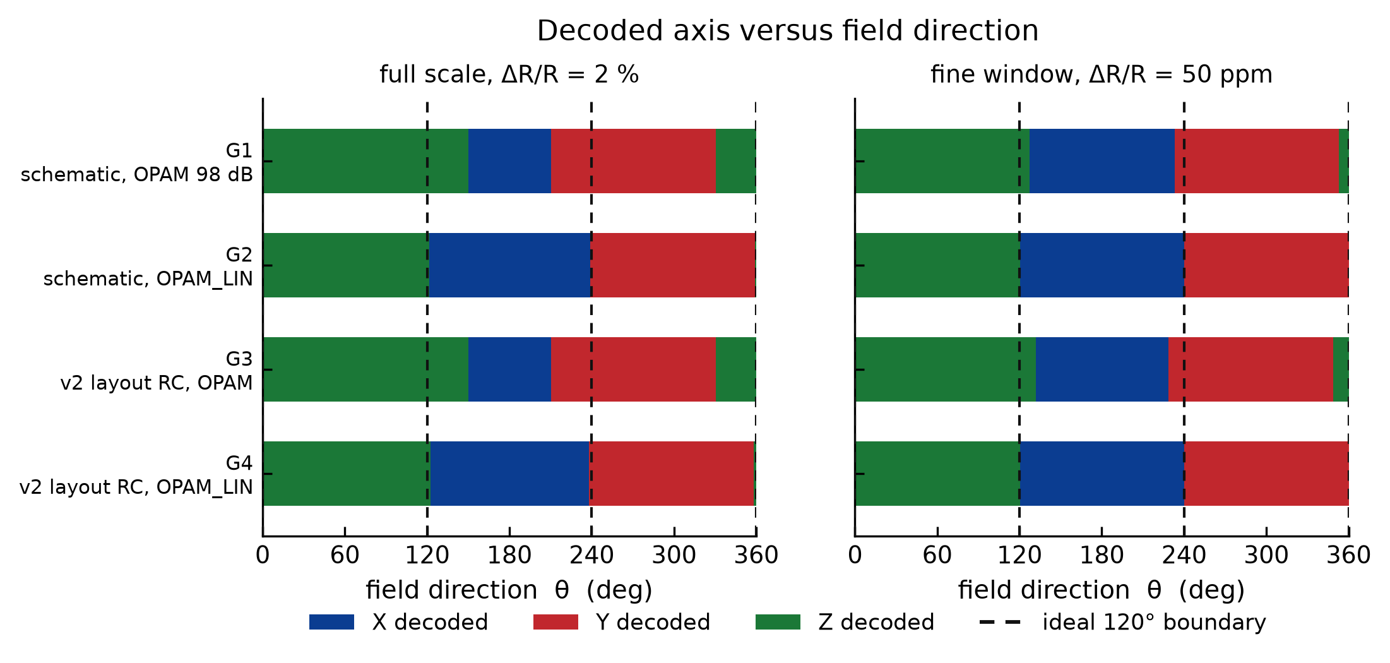
FINAL/reportes/figuras/grad_sectores.png
