AnBuiUCI/sscs-2026-zotnetic/FINAL/reportes/figuras/layout_DECODER_MAX.png

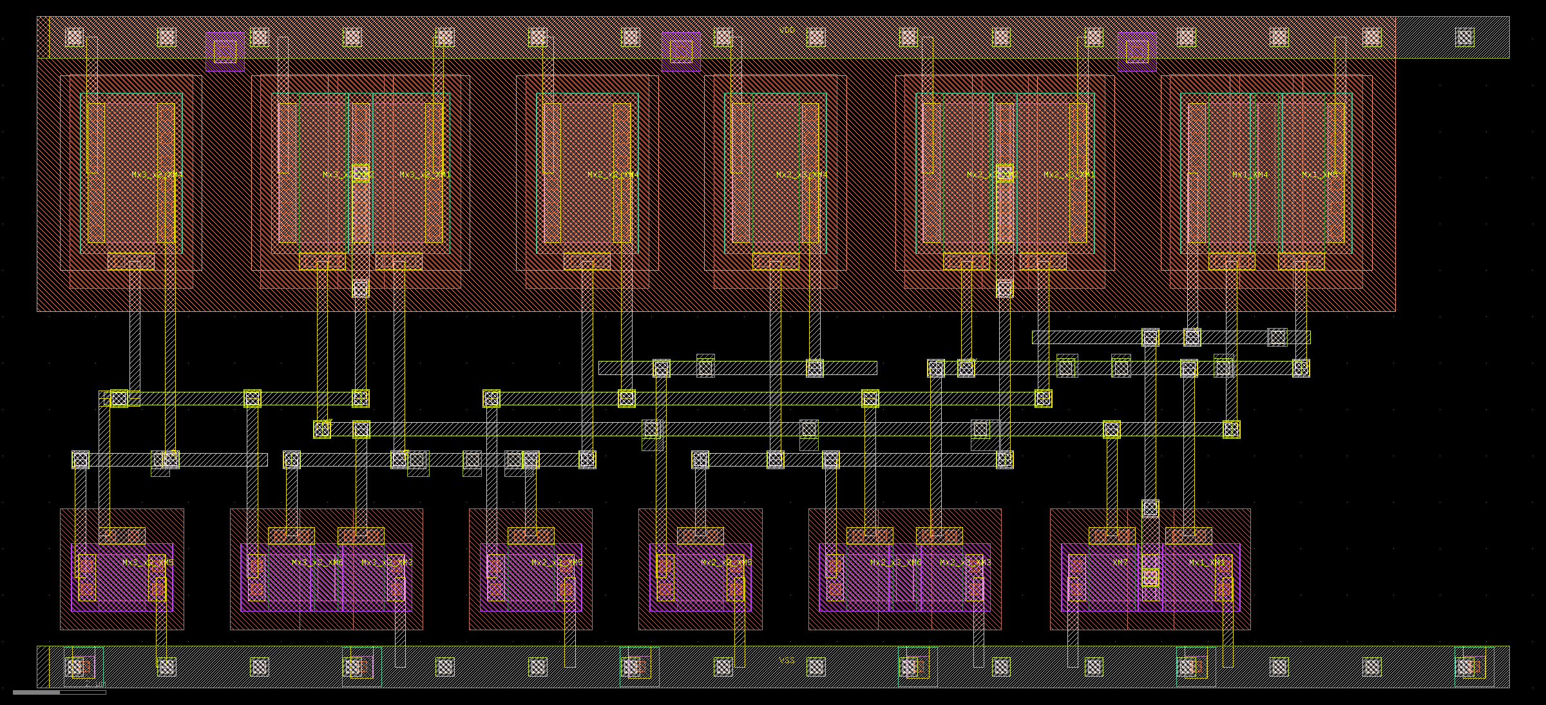
FINAL/reportes/figuras/layout_DECODER_MAX.png
