AnBuiUCI/sscs-2026-zotnetic/FINAL/reportes/figuras/layout_OPAM.png

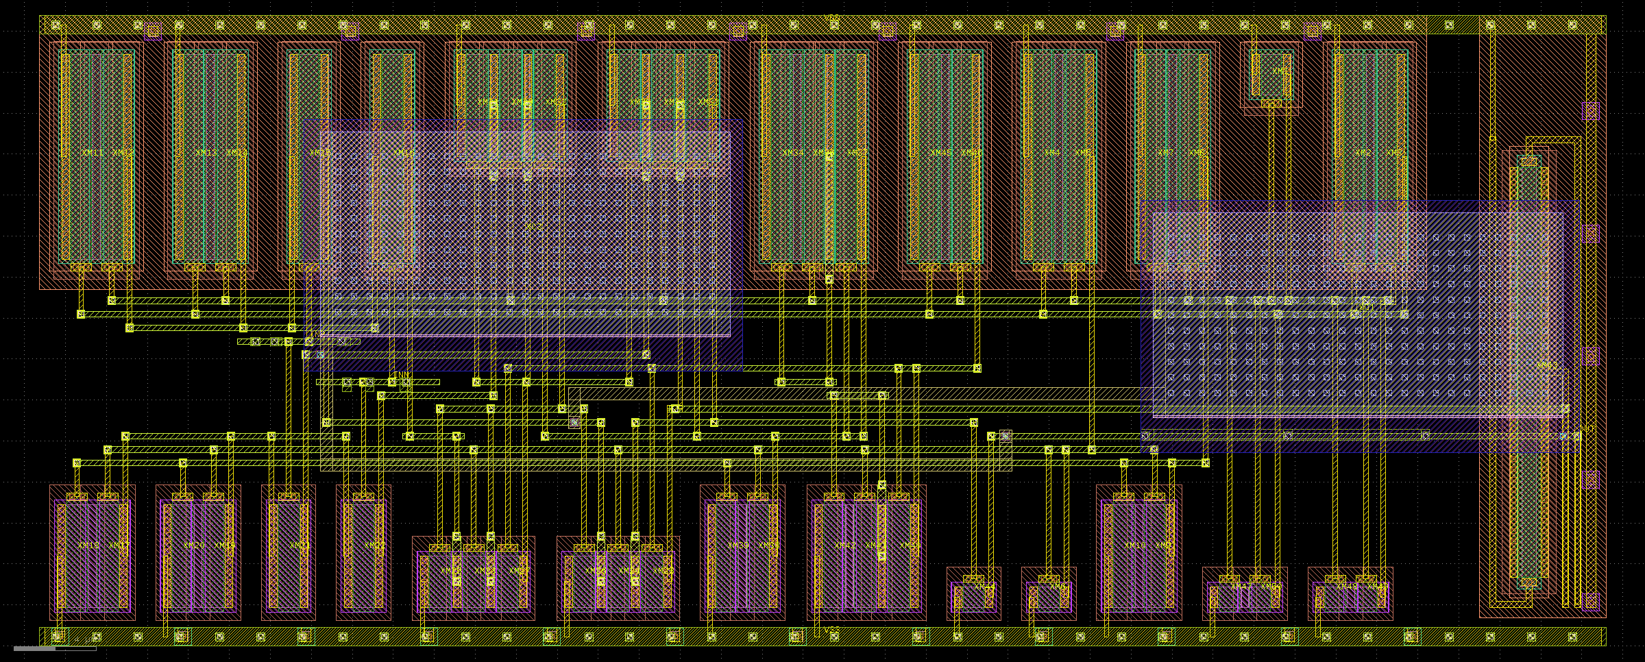
FINAL/reportes/figuras/layout_OPAM.png
