AnBuiUCI/sscs-2026-zotnetic/FINAL/reportes/figuras/sch_B26_A.png

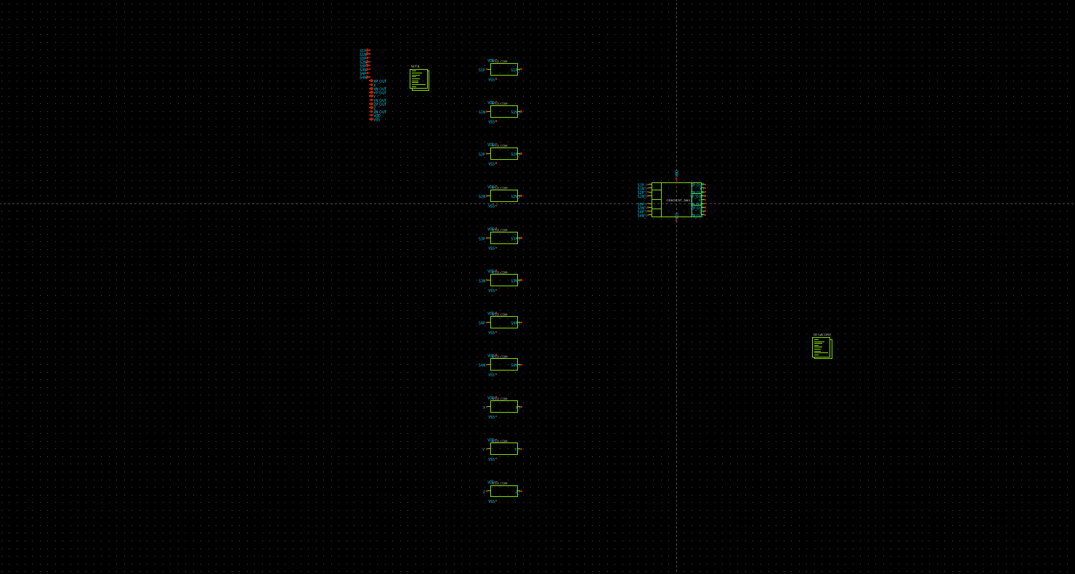
FINAL/reportes/figuras/sch_B26_A.png
