AnBuiUCI/sscs-2026-zotnetic/FINAL/reportes/figuras/sch_DECODER_MAX.png

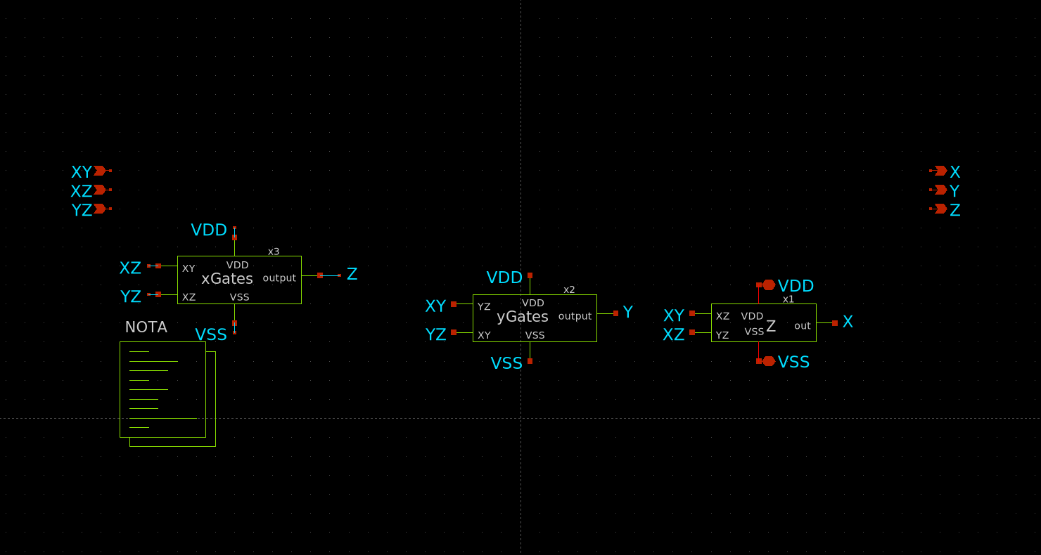
FINAL/reportes/figuras/sch_DECODER_MAX.png
