AnBuiUCI/sscs-2026-zotnetic/FINAL/reportes/figuras/sch_OPAM_LIN.png

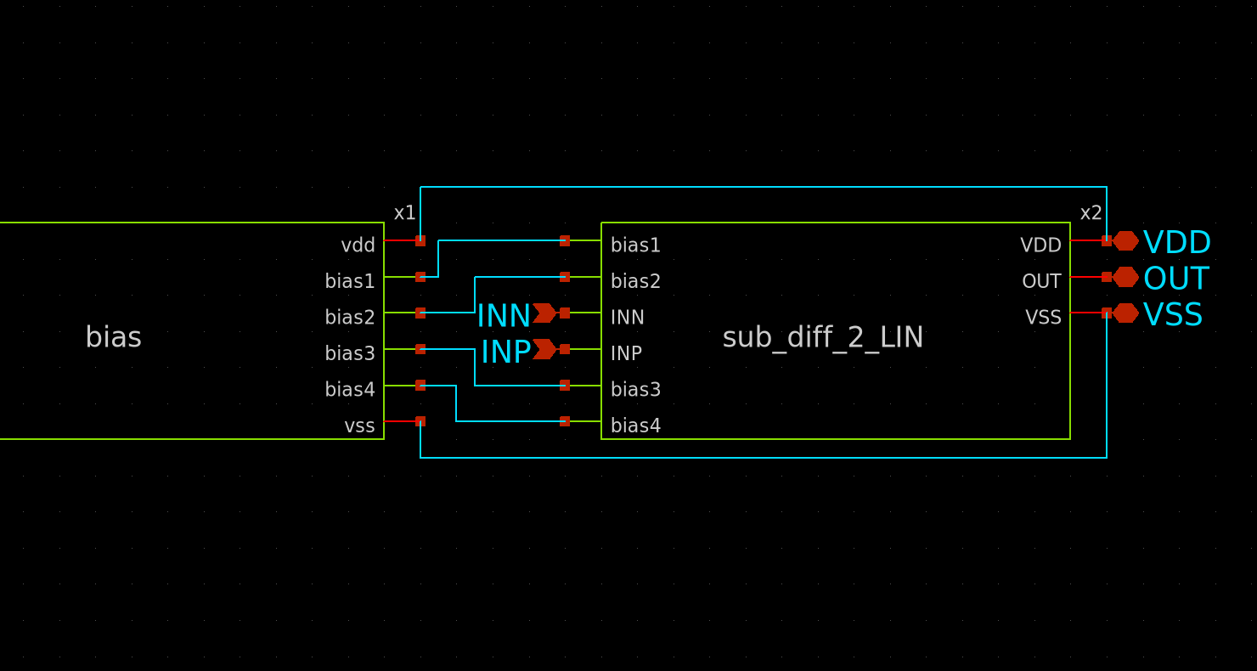
FINAL/reportes/figuras/sch_OPAM_LIN.png
