AnBuiUCI/sscs-2026-zotnetic/FINAL/reportes/figuras/sch_WEIGHT_COMP.png

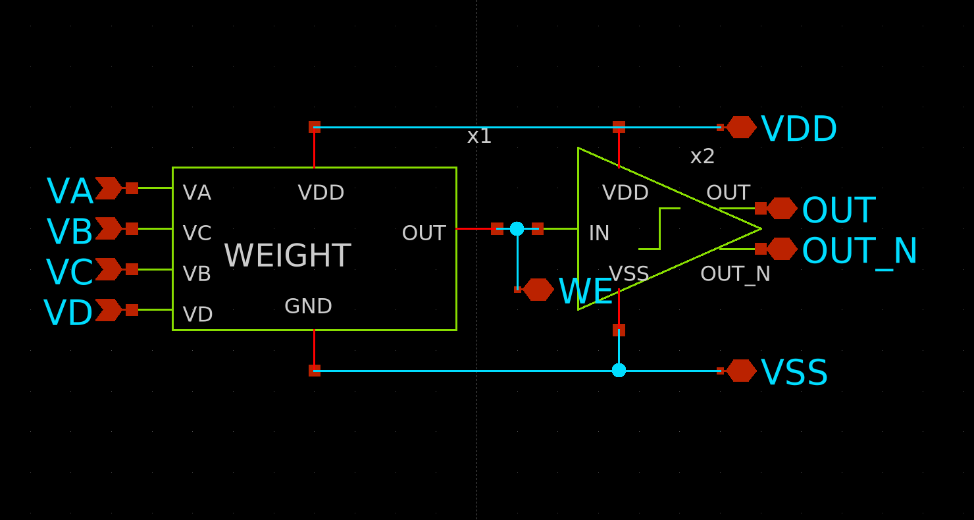
FINAL/reportes/figuras/sch_WEIGHT_COMP.png
