AnBuiUCI/sscs-2026-zotnetic/FINAL/reportes/figuras/src_caja.png

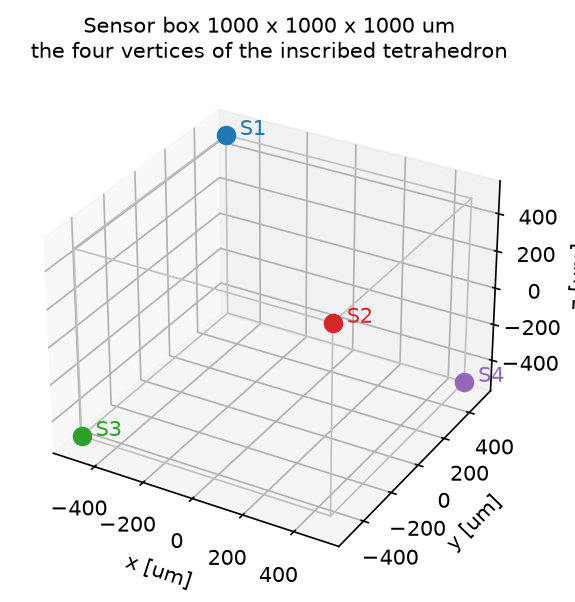
FINAL/reportes/figuras/src_caja.png
