AnBuiUCI/sscs-2026-zotnetic/FINAL/reportes/figuras/src_decision.png

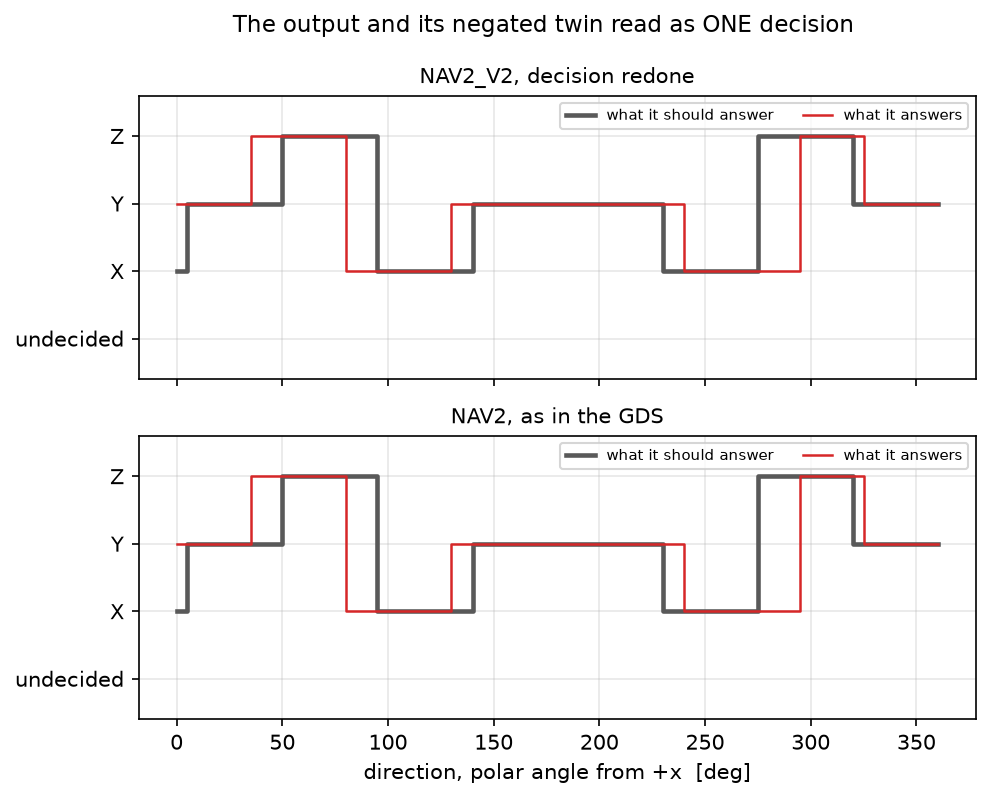
FINAL/reportes/figuras/src_decision.png
