AnBuiUCI/sscs-2026-zotnetic/FINAL/reportes/figuras/src_gradiente.png

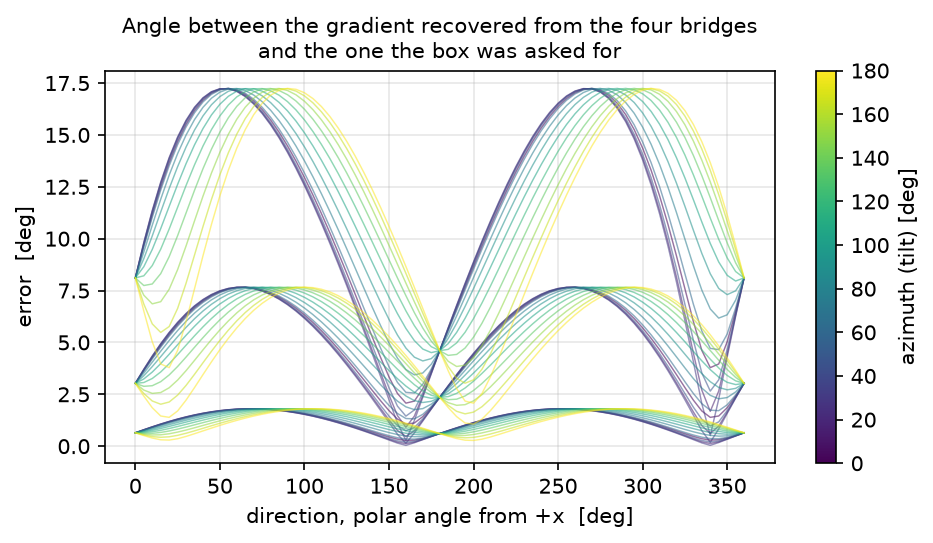
FINAL/reportes/figuras/src_gradiente.png
