AnBuiUCI/sscs-2026-zotnetic/FINAL/reportes/figuras/tb_comp_tran.png

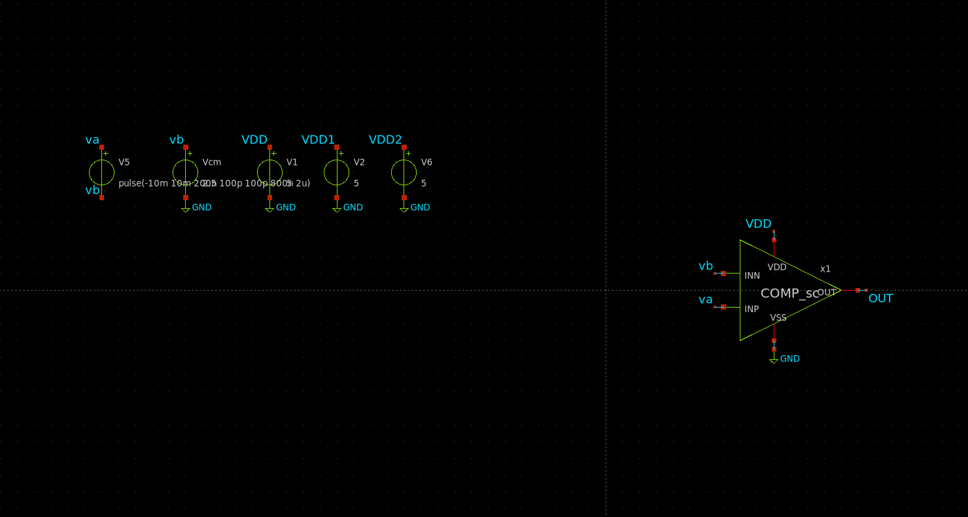
FINAL/reportes/figuras/tb_comp_tran.png
