AnBuiUCI/sscs-2026-zotnetic/FINAL/reportes/figuras/tb_opam_ac.png

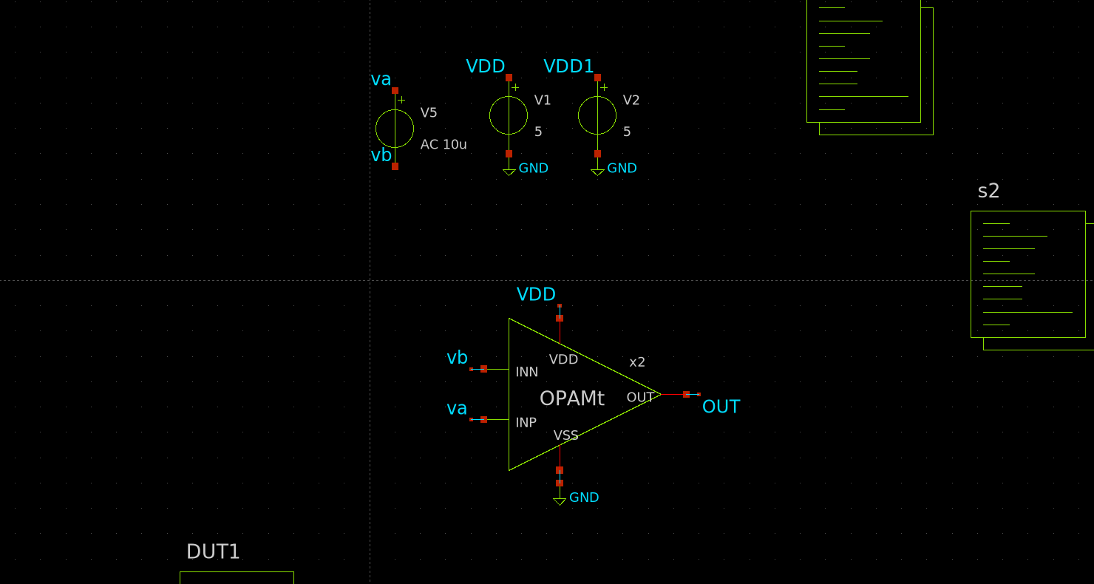
FINAL/reportes/figuras/tb_opam_ac.png
