AnBuiUCI/sscs-2026-zotnetic/FINAL/reportes/figuras/tb_TOTAL.png

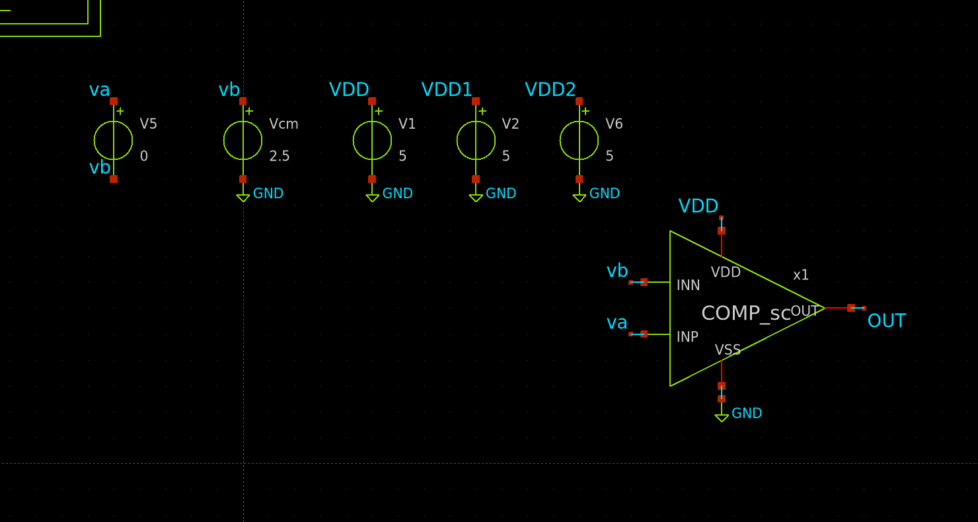
FINAL/reportes/figuras/tb_TOTAL.png
