AnBuiUCI/sscs-2026-zotnetic/FINAL/reportes/figuras/top_amplificador.png

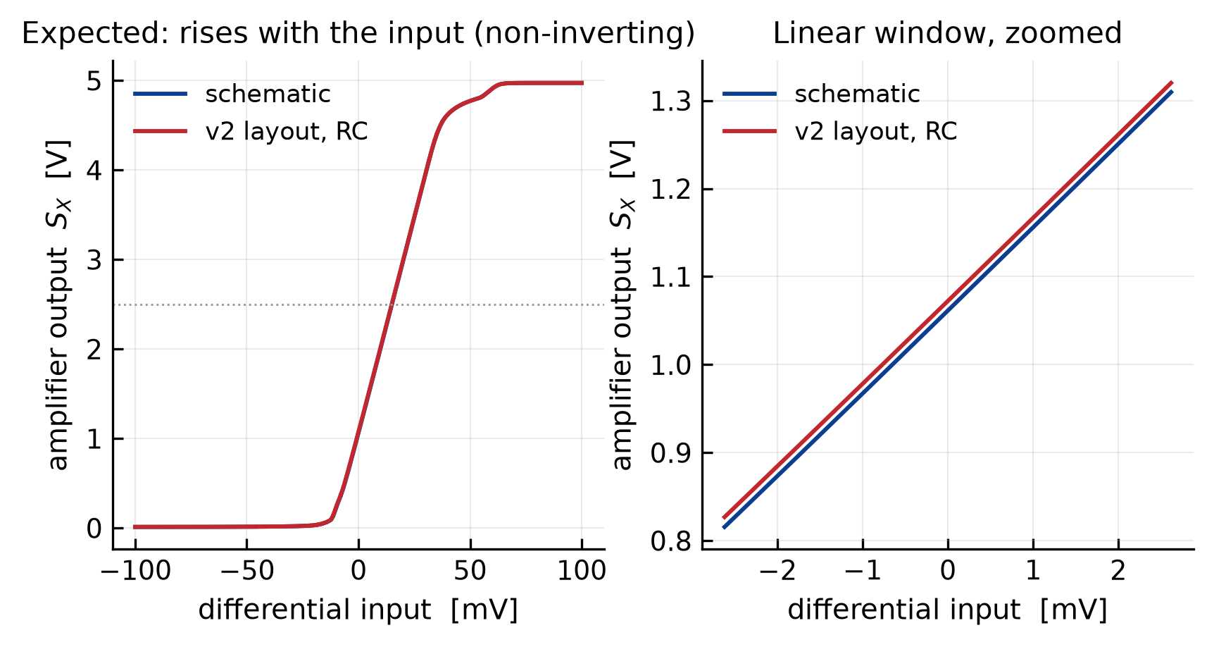
FINAL/reportes/figuras/top_amplificador.png
