AnBuiUCI/sscs-2026-zotnetic/FINAL/reportes/figuras/top_comparador.png

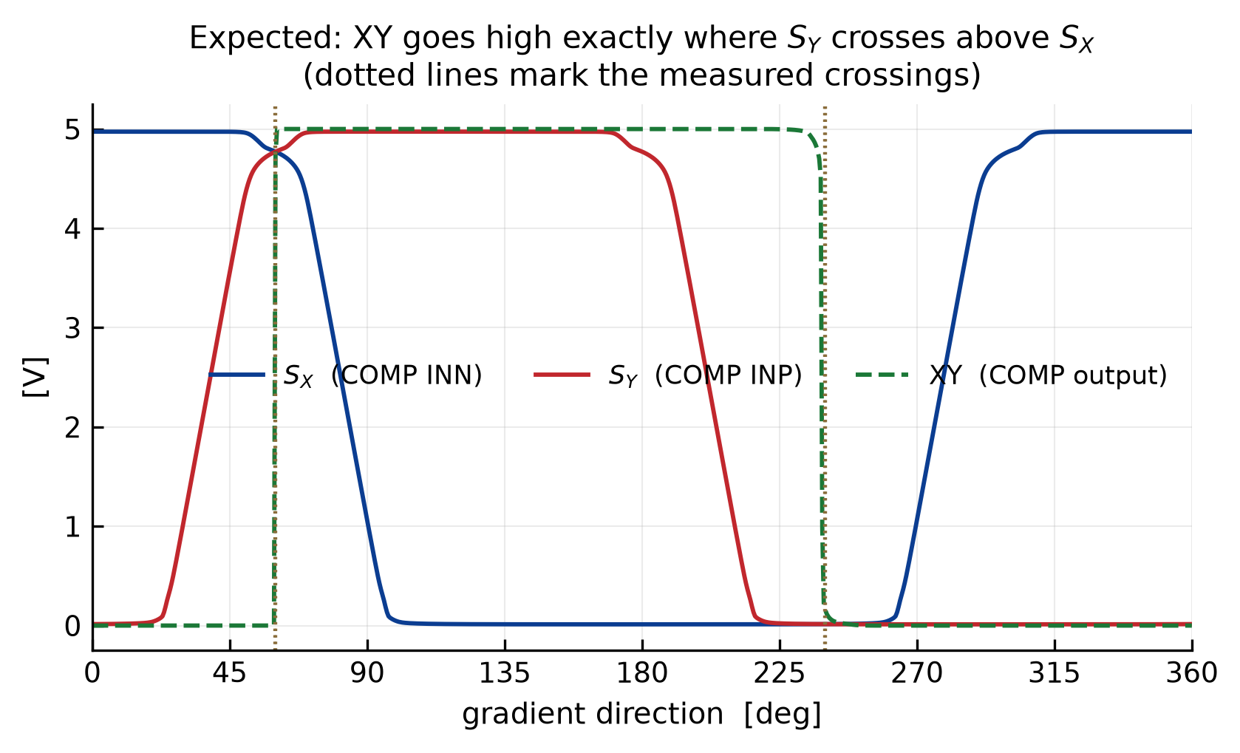
FINAL/reportes/figuras/top_comparador.png
