AnBuiUCI/sscs-2026-zotnetic/FINAL/reportes/figuras/top_decodificador.png

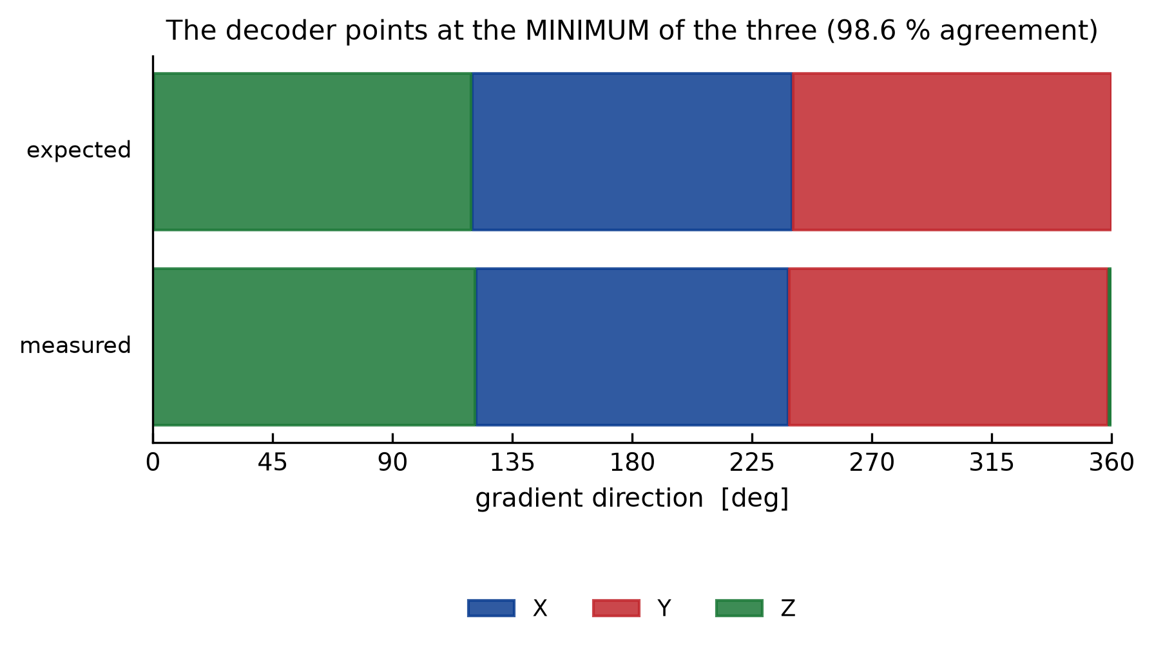
FINAL/reportes/figuras/top_decodificador.png
