AnBuiUCI/sscs-2026-zotnetic/FINAL/reportes/figuras/top_disparo.png

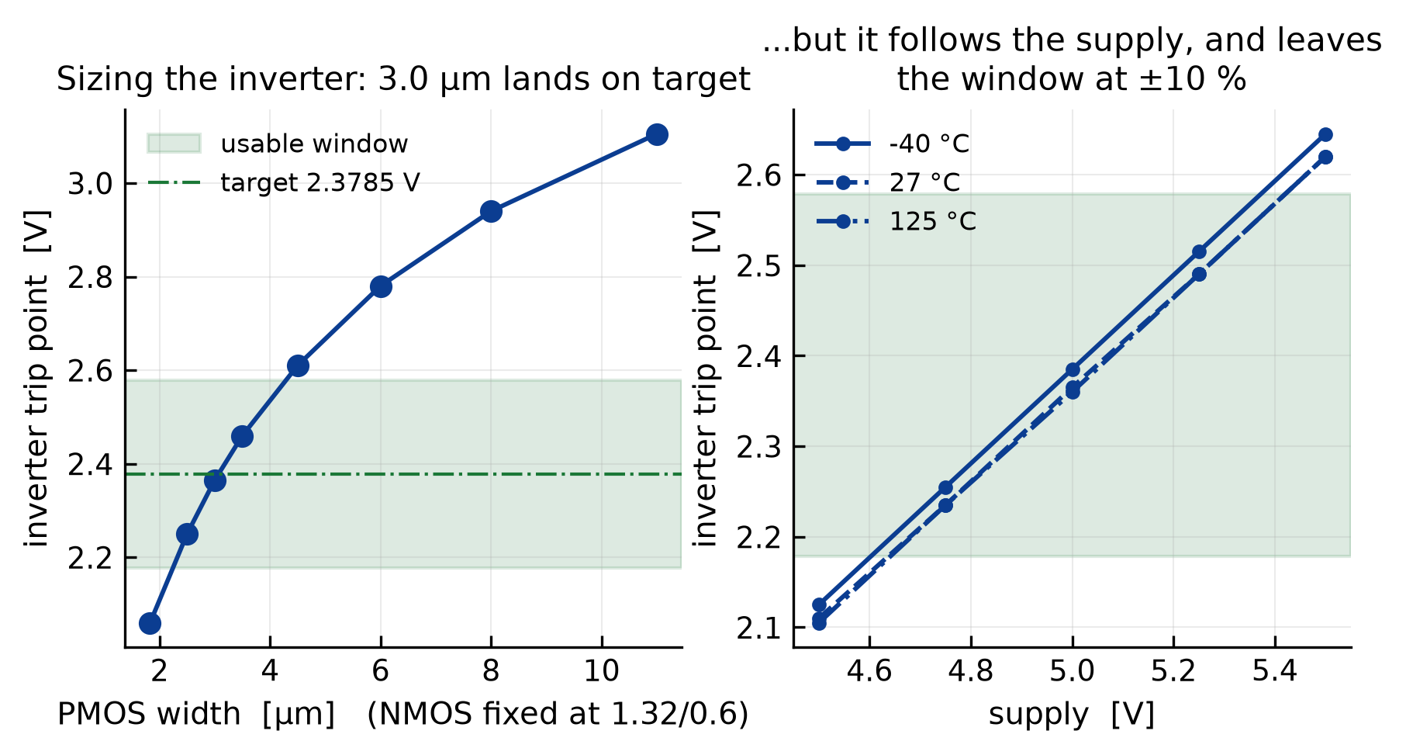
FINAL/reportes/figuras/top_disparo.png
