AnBuiUCI/sscs-2026-zotnetic/FINAL/reportes/figuras/top_estimulo.png

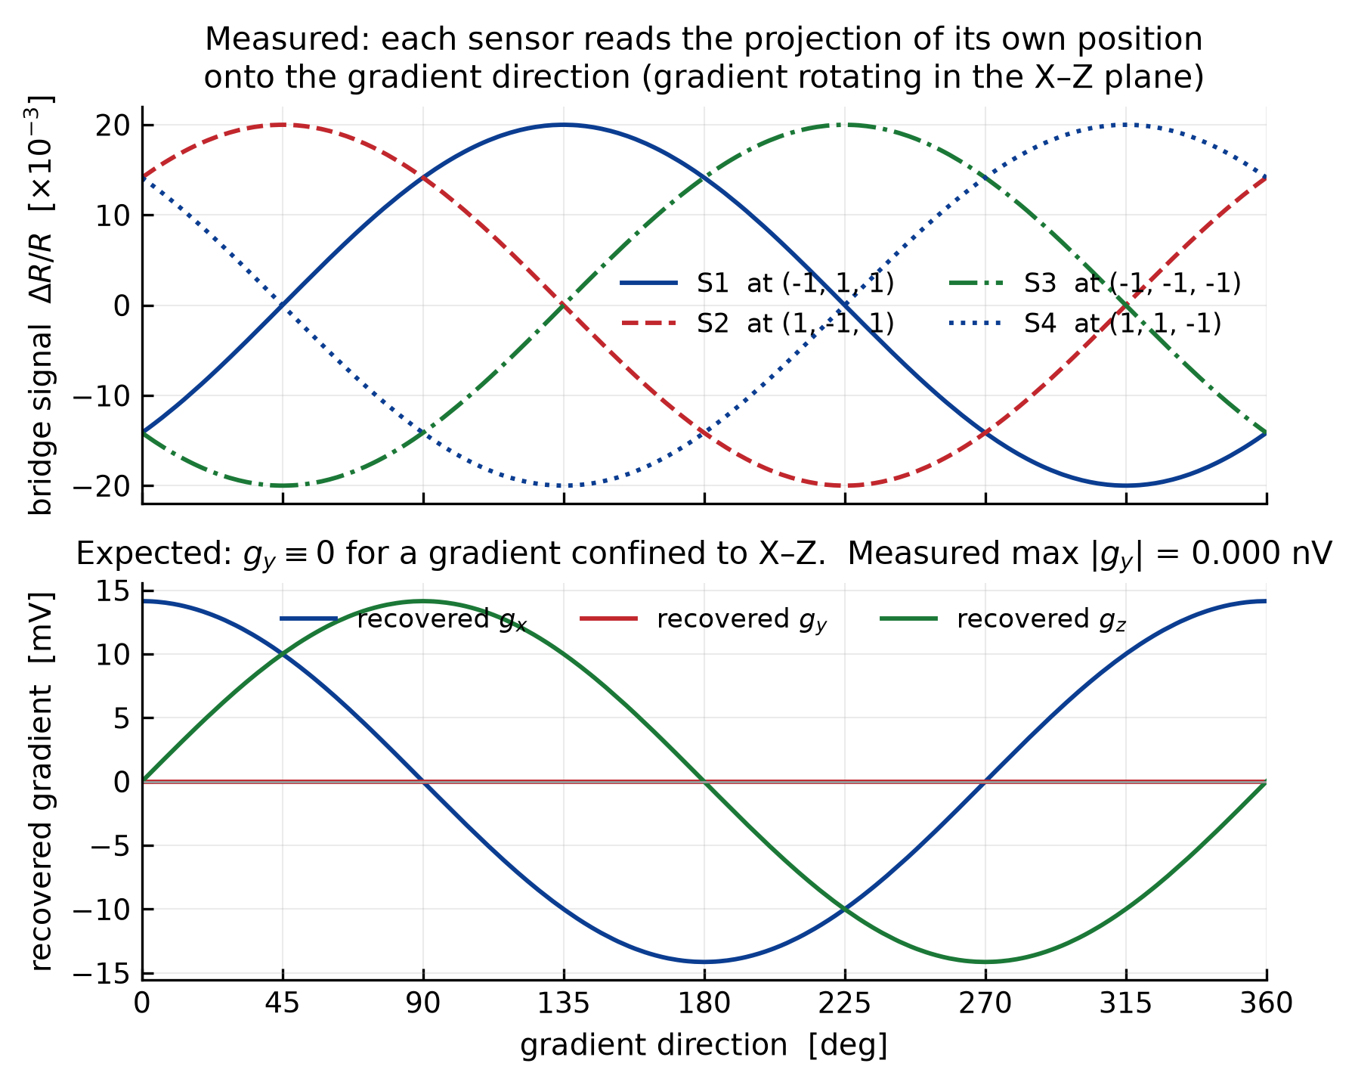
FINAL/reportes/figuras/top_estimulo.png
