AnBuiUCI/sscs-2026-zotnetic/FINAL/reportes/figuras/top_geometria.png

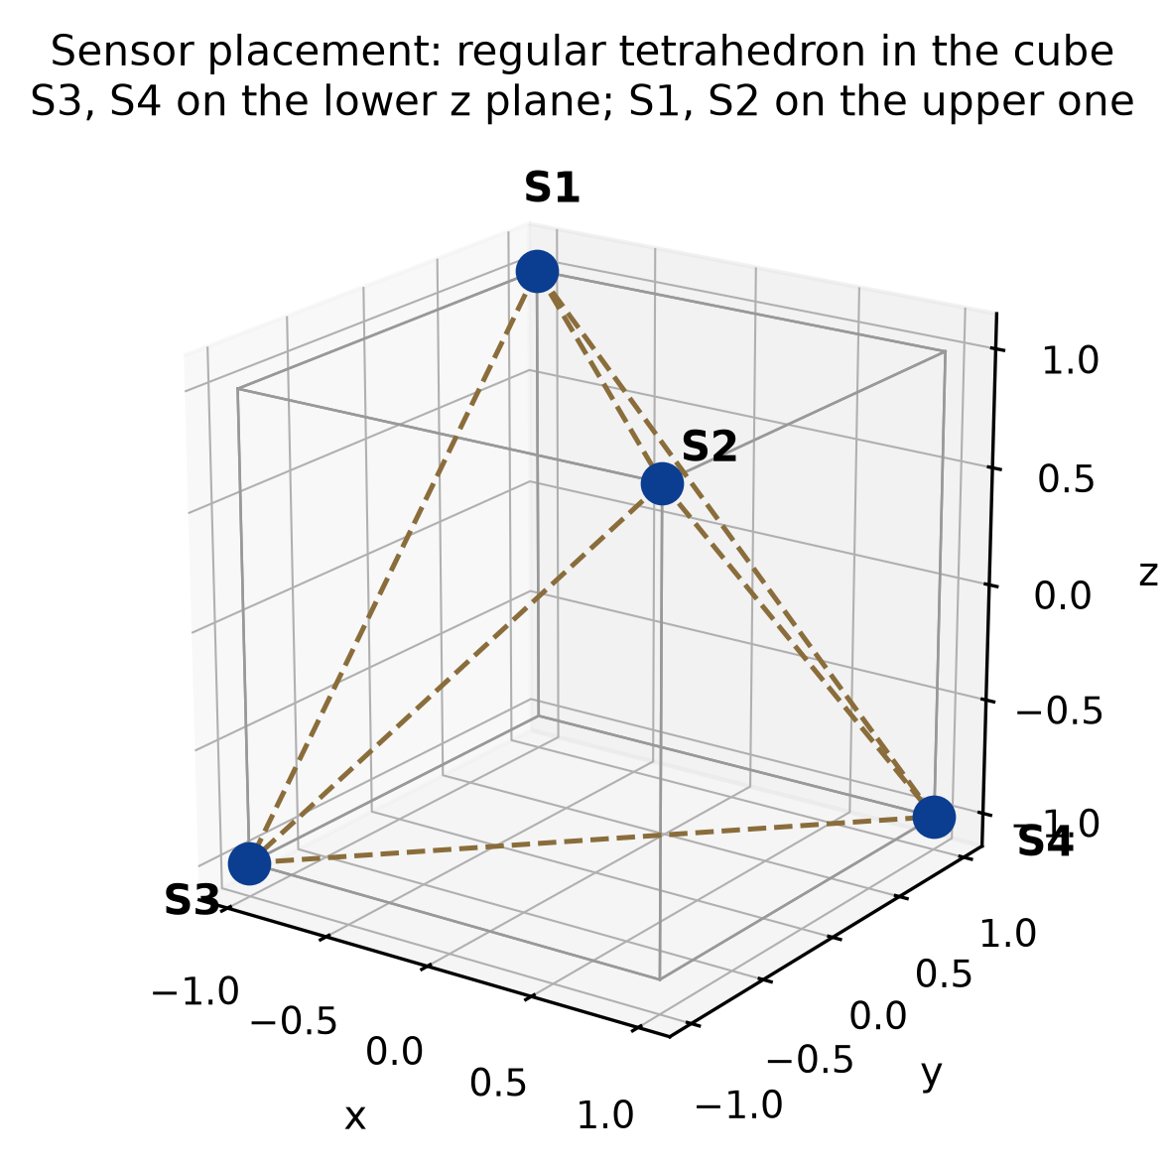
FINAL/reportes/figuras/top_geometria.png
