AnBuiUCI/sscs-2026-zotnetic/FINAL/reportes/figuras/top_pesos.png

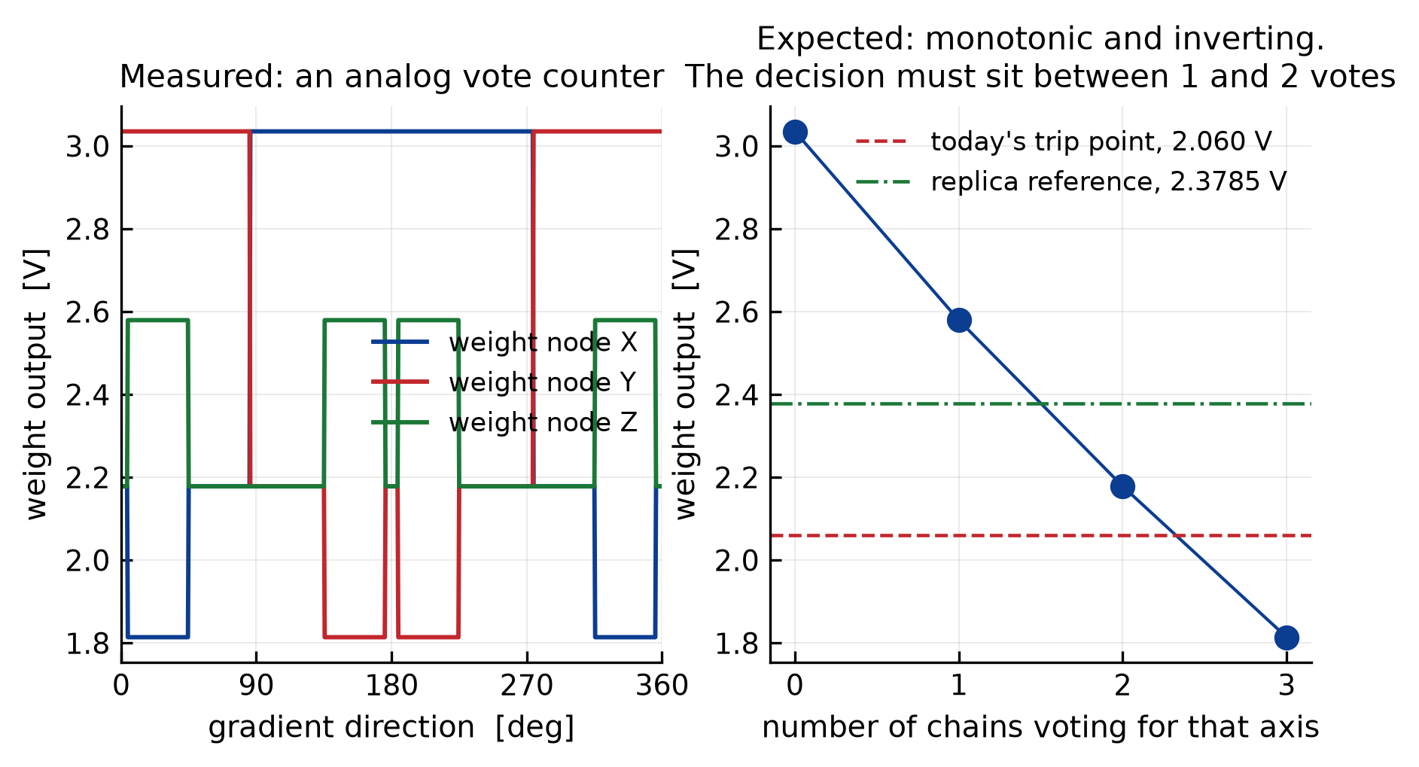
FINAL/reportes/figuras/top_pesos.png
