AnBuiUCI/sscs-2026-zotnetic/FINAL/reportes/figuras/top_salidas.png

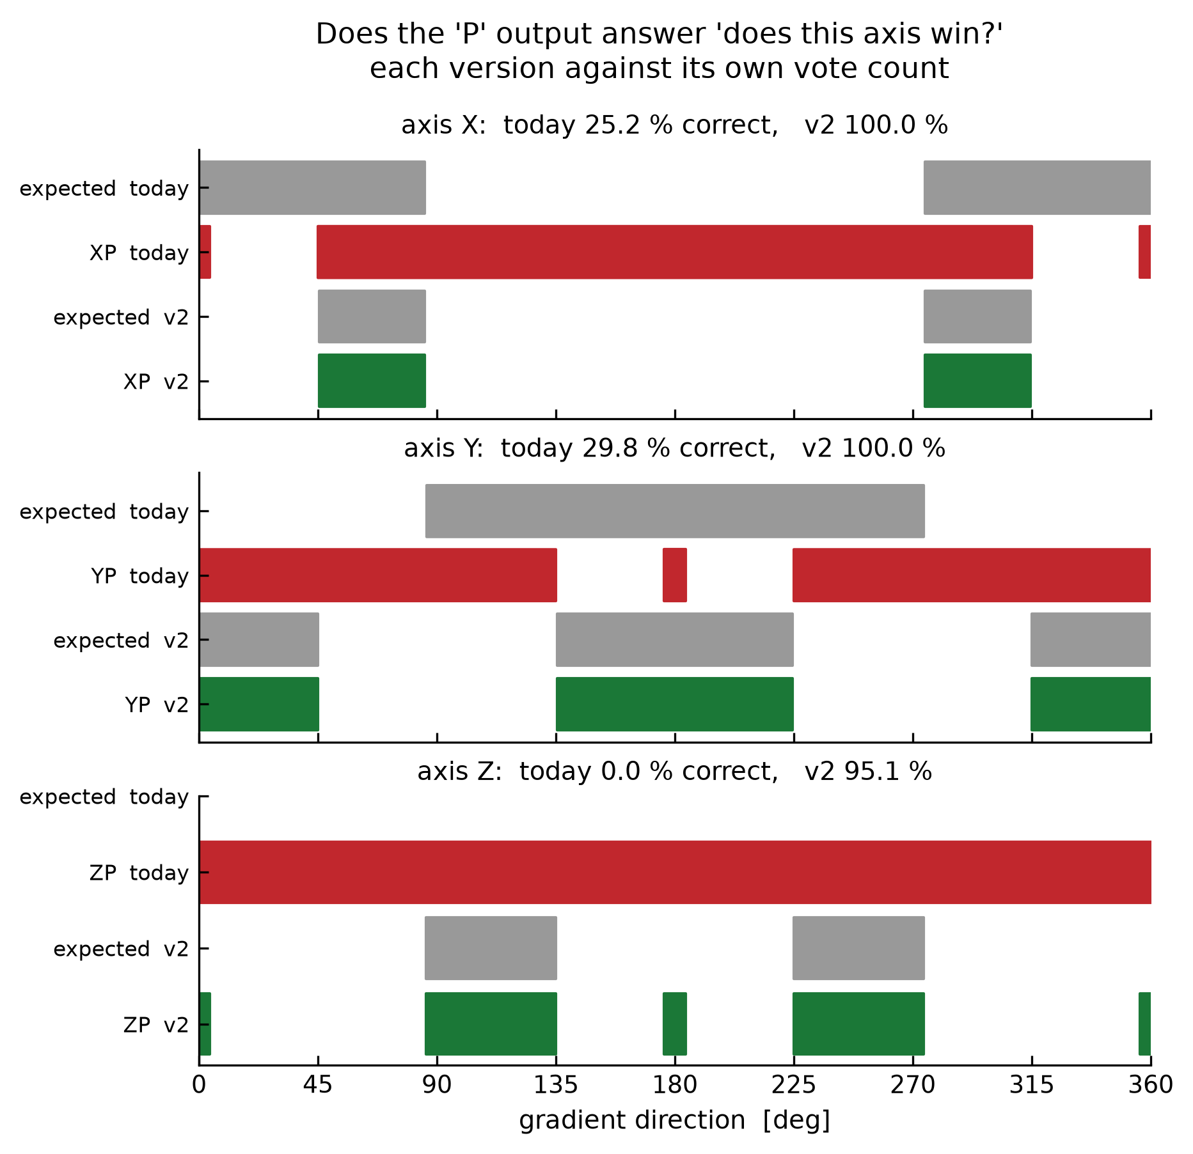
FINAL/reportes/figuras/top_salidas.png
