AnBuiUCI/sscs-2026-zotnetic/FINAL/reportes/figuras/trace_2_amplifiers_fine.png

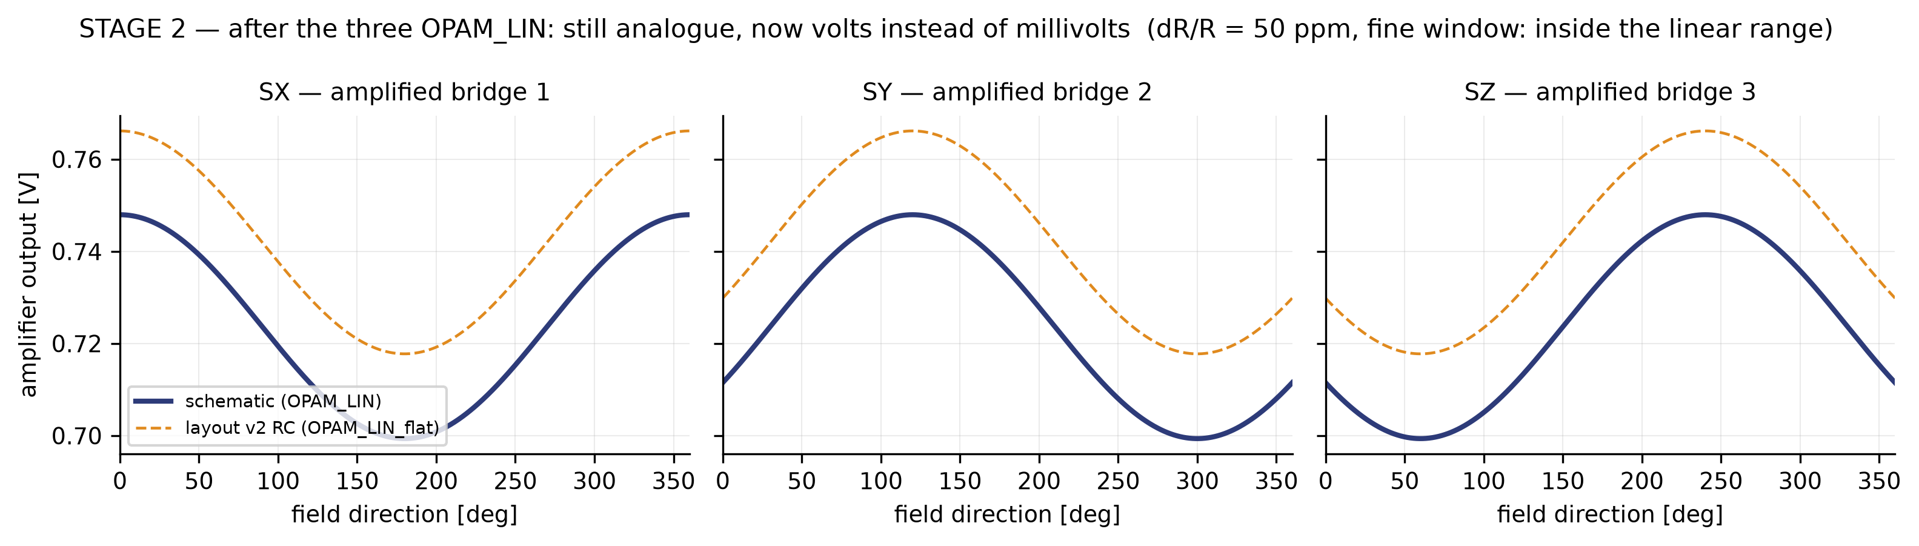
FINAL/reportes/figuras/trace_2_amplifiers_fine.png
