AnBuiUCI/sscs-2026-zotnetic/FINAL/reportes/figuras/trace_3_comparators.png

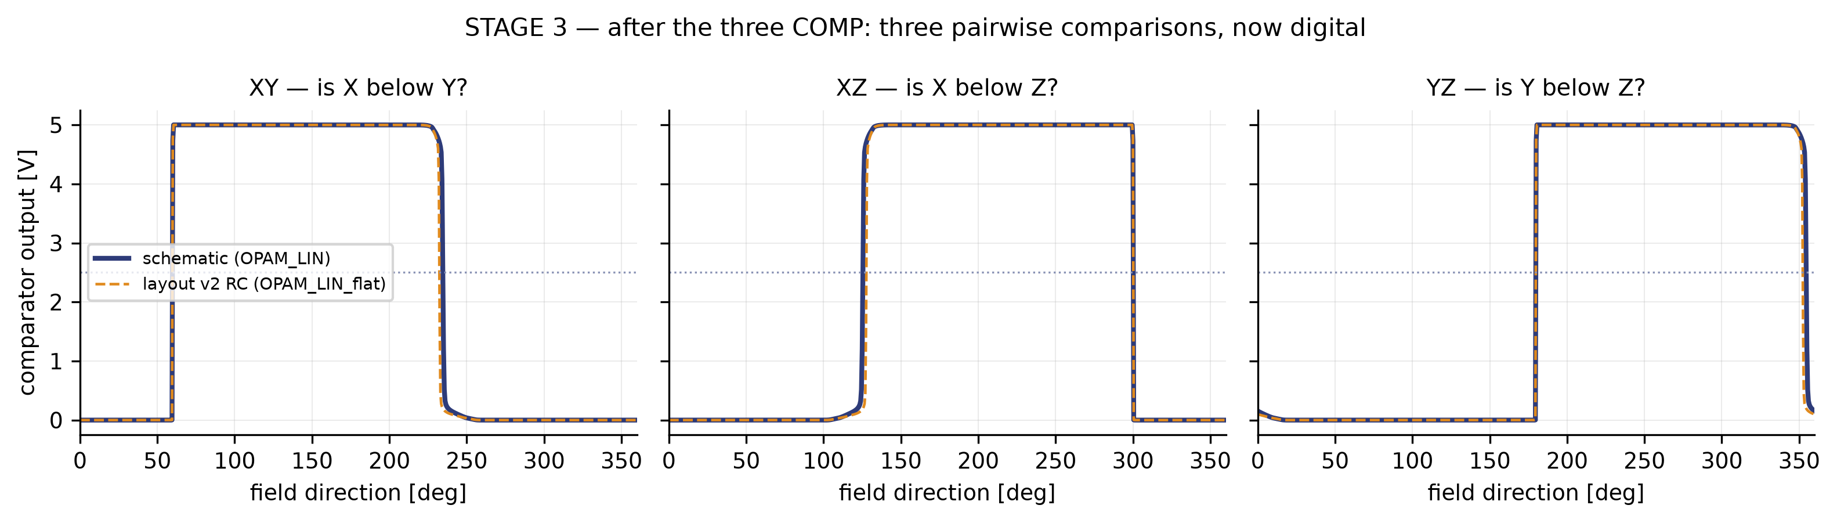
FINAL/reportes/figuras/trace_3_comparators.png
