AnBuiUCI/sscs-2026-zotnetic/FINAL/reportes/figuras/trace_4_decoder.png

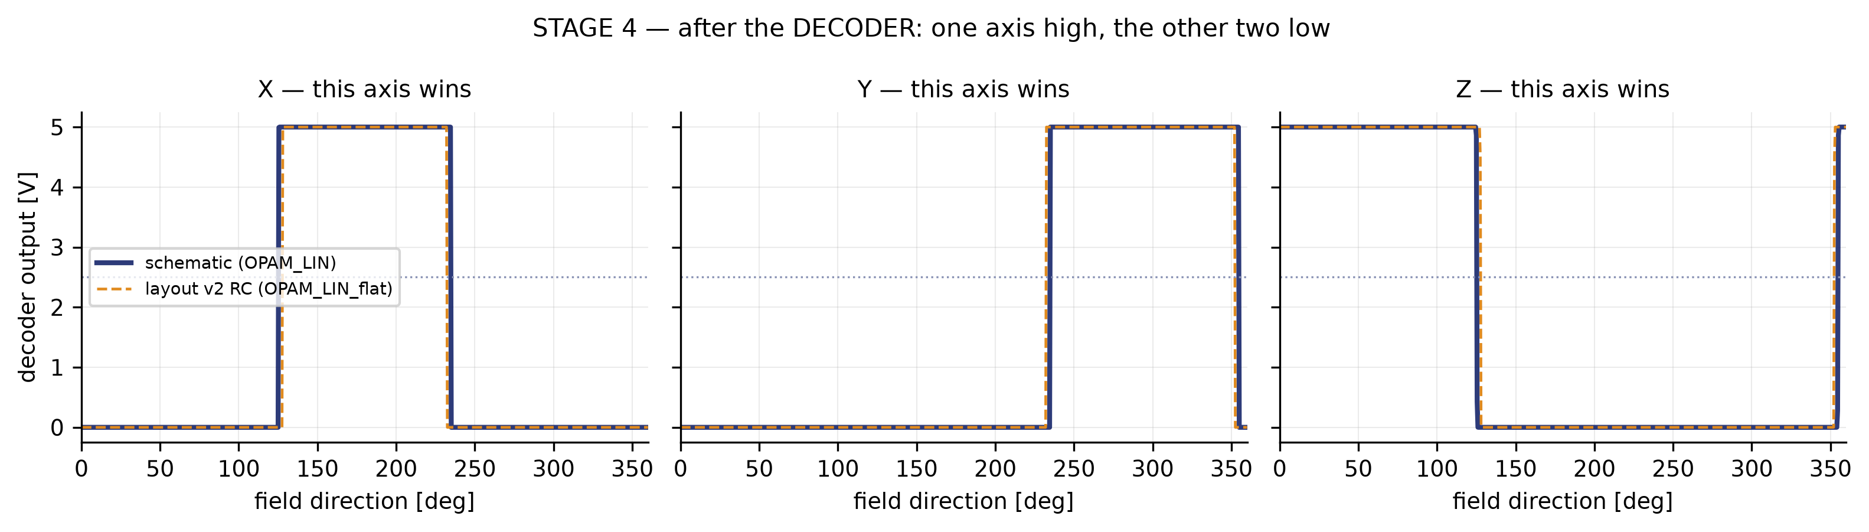
FINAL/reportes/figuras/trace_4_decoder.png
