AnBuiUCI/sscs-2026-zotnetic/FINAL/waferspace/out/quarter_layout.png

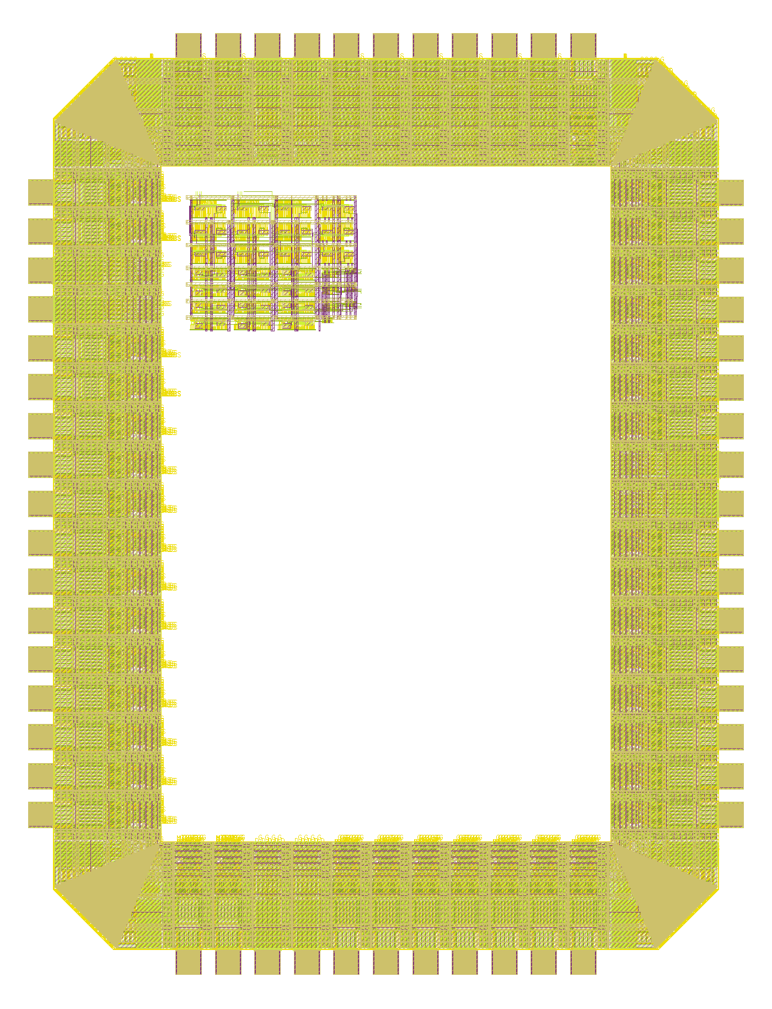
FINAL/waferspace/out/quarter_layout.png
