AnBuiUCI/sscs-2026-zotnetic/FINAL/waferspace/out_integracion/esquina.png

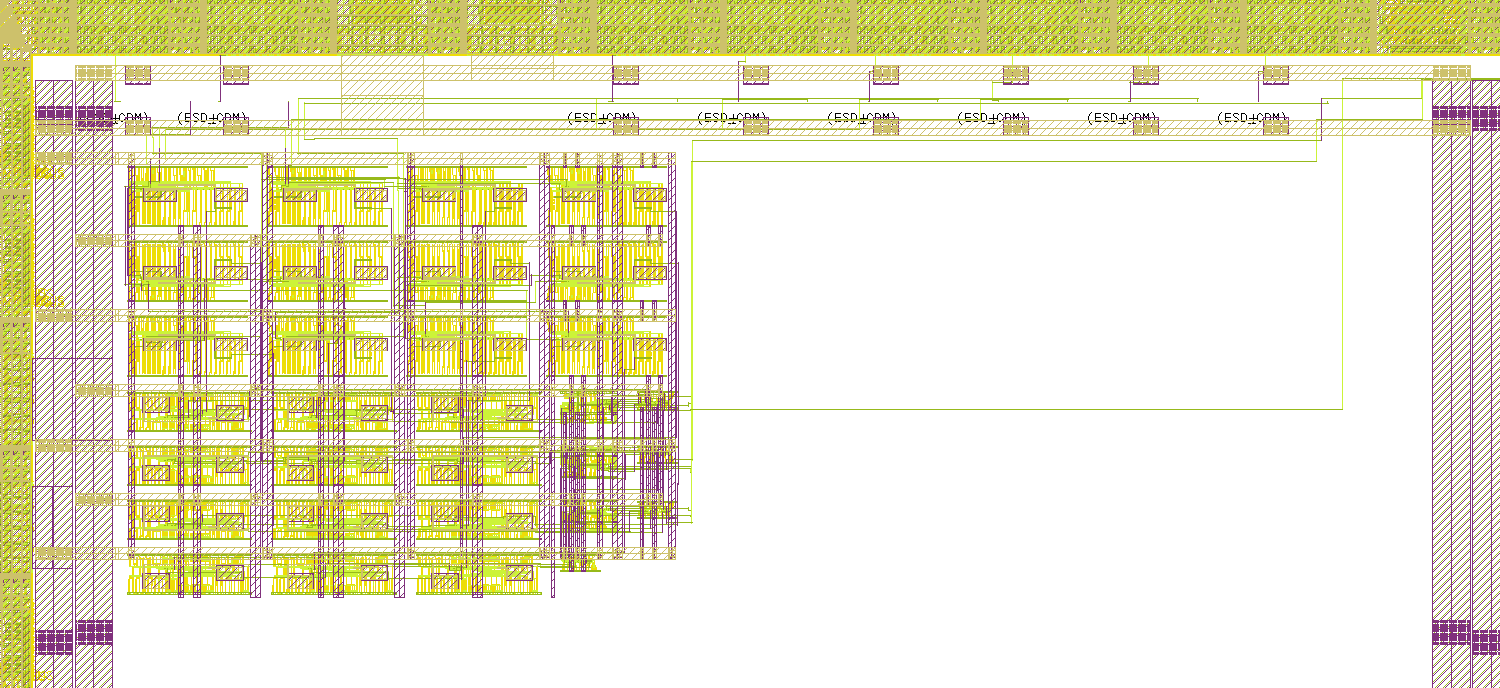
FINAL/waferspace/out_integracion/esquina.png
