AnBuiUCI/sscs-2026-zotnetic/FINAL/waferspace/out_integracion/integracion.png

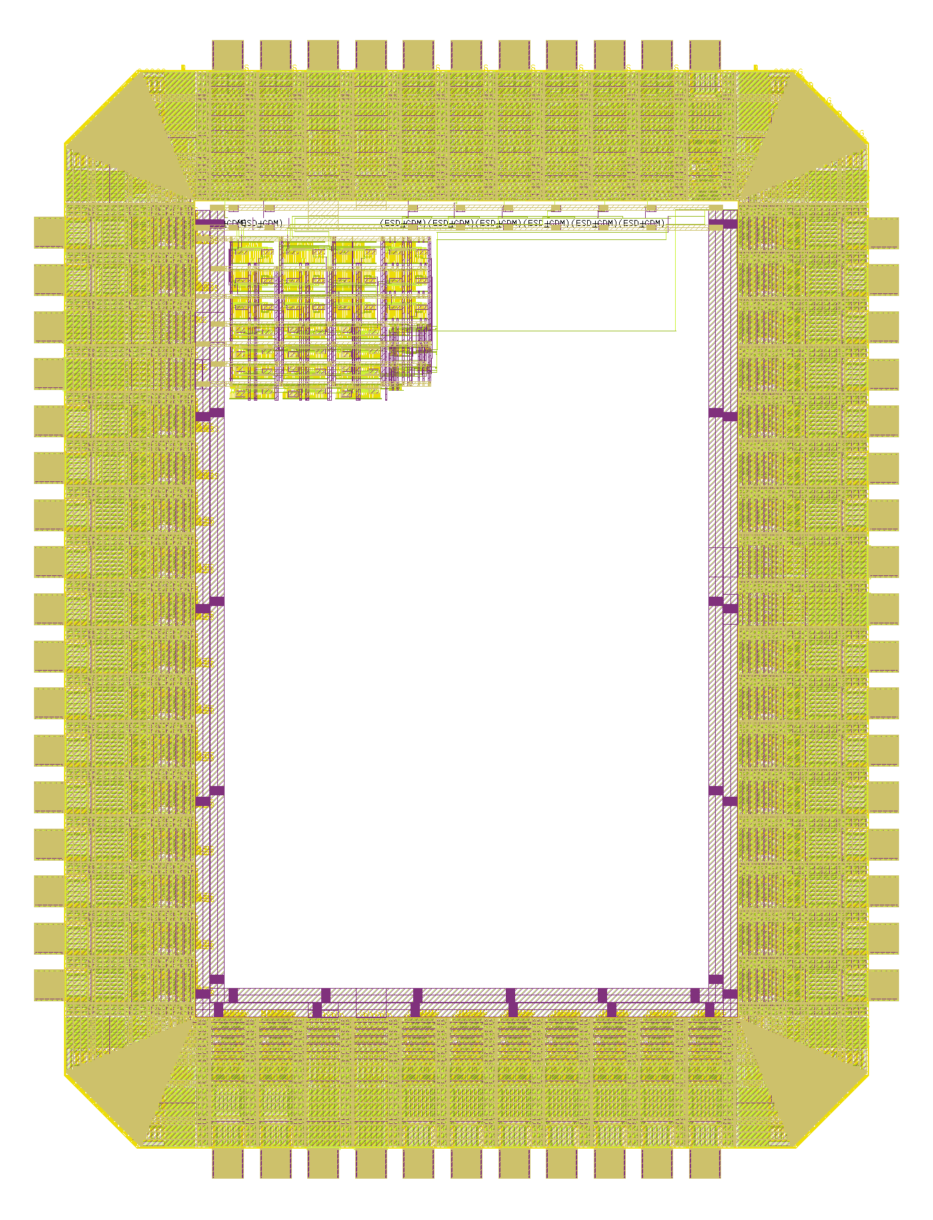
FINAL/waferspace/out_integracion/integracion.png
