AnBuiUCI/sscs-2026-zotnetic/FINAL/reportes/figuras/blk_OPAM_LIN_step.png

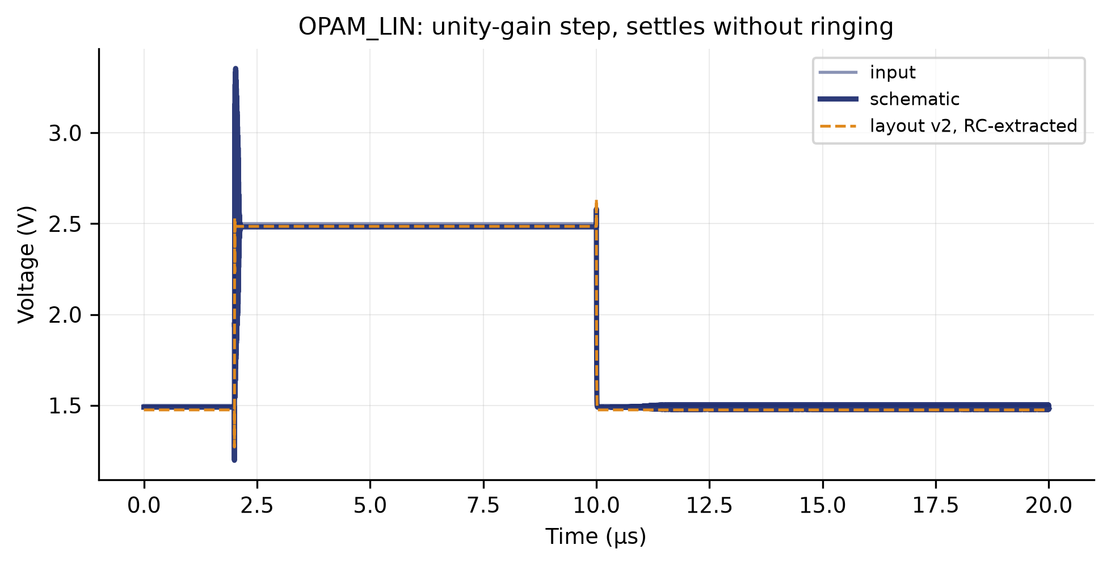
FINAL/reportes/figuras/blk_OPAM_LIN_step.png
