AnBuiUCI/sscs-2026-zotnetic/FINAL/XSCHEM/TEST/simulation/test_comp_tran.sch/step.png

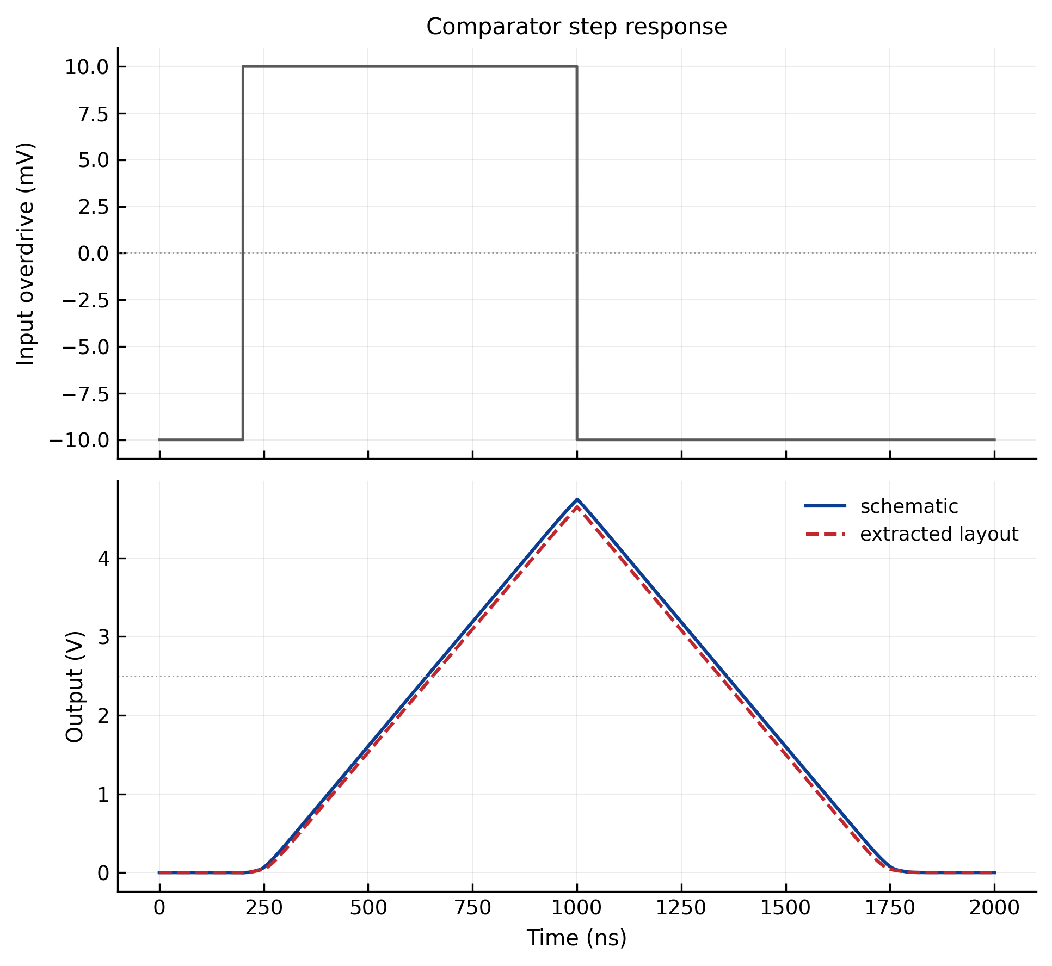
FINAL/XSCHEM/TEST/simulation/test_comp_tran.sch/step.png
