AnBuiUCI/sscs-2026-zotnetic/FINAL/XSCHEM/TEST/simulation/test_opam_g100_tran.sch/step.png

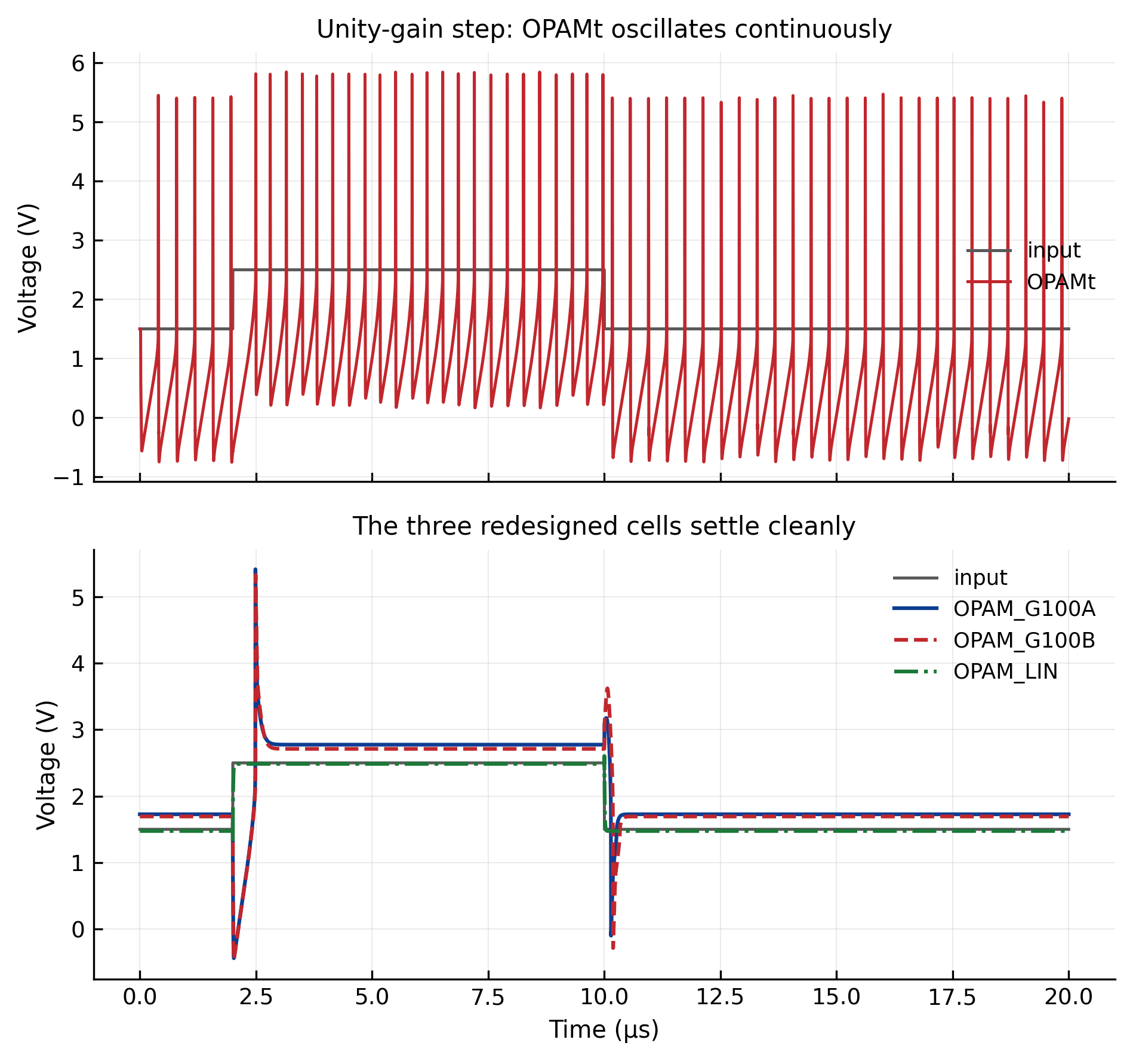
FINAL/XSCHEM/TEST/simulation/test_opam_g100_tran.sch/step.png
