AnBuiUCI/sscs-2026-zotnetic/activities/opamp2AKAM/simulations_testbench/simulation_results/biasTestBench.txt

4.54091 4.50033 0.341363 0.329879
4.54091 4.50033 0.341363 0.329879
4.54155 4.50033 0.340656 0.329122
4.54155 4.50033 0.340656 0.329122
4.54208 4.50034 0.340063 0.328862
4.54334 4.50033 0.338614 0.327808
4.5442 4.50033 0.337608 0.32716
4.57109 4.50035 0.297204 0.318748
4.56477 4.50034 0.308673 0.316467
4.5643 4.50033 0.309457 0.316592
4.55947 4.50033 0.317198 0.317525
4.55906 4.50033 0.317826 0.317689
4.55351 4.50034 0.325811 0.320612
4.55298 4.50033 0.326541 0.32081
4.55299 4.50034 0.252383 2.24822
4.553 4.50034 0.256198 2.10705
4.553 4.50032 0.260468 1.954
4.55299 4.50032 0.265292 1.75944
4.55299 4.50034 0.273903 1.39252
4.55298 4.50033 0.277271 1.24388
4.55297 4.50032 0.27143 1.50202
4.553 4.50035 0.270799 1.5309
4.55299 4.50035 0.270818 3.06819
4.553 4.50031 0.270813 1.62838
4.553 4.50031 0.270791 1.59565
4.55299 4.50035 0.270805 1.66186
4.553 4.50036 0.270794 1.6942
4.553 4.50033 0.270796 1.71029
4.55299 4.50035 0.270818 3.06819
4.55299 4.50033 0.270826 0.418535
4.55299 4.50035 0.270824 0.401985
4.55299 4.50035 0.270824 0.401985
4.55298 4.50033 0.270823 0.288559
4.553 4.50035 0.270796 0.28186
4.55299 4.50034 0.270811 0.221464
4.55299 4.50034 0.270813 0.218703
4.55298 4.50034 0.270832 0.203276
4.55297 4.50033 0.270832 0.202083
4.553 4.50033 0.270812 0.191086
4.553 4.50033 0.270796 0.186784
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
