AnBuiUCI/sscs-2026-zotnetic/activities/opamp2AKAM/simulations_testbench/simulation_results/sweep_results.txt

# bias1 bias2 bias3 bias4 gain
4 4 1.7 1 5000
4 4 1.7 1.2 4987.53
4 4 1.7 1.4 4987.53
4 4 1.9 1 4524.89
4 4 1.9 1.2 4975.12
4 4 1.9 1.4 4926.11
4 4 2.1 1 4728.13
4 4 2.1 1.2 4926.11
4 4 2.1 1.4 4878.05
4 4.2 1.7 1 4115.23
4 4.2 1.7 1.2 4975.12
4 4.2 1.7 1.4 4950.5
4 4.2 1.9 1 4950.5
4 4.2 1.9 1.2 4705.88
4 4.2 1.9 1.4 4608.29
4 4.2 2.1 1 4914
4 4.2 2.1 1.2 4854.37
4 4.2 2.1 1.4 4597.7
4 4.4 1.7 1 4587.16
4 4.4 1.7 1.2 4750.59
4 4.4 1.7 1.4 4524.89
4 4.4 1.9 1 4901.96
4 4.4 1.9 1.2 4545.45
4 4.4 1.9 1.4 4201.68
4 4.4 2.1 1 4830.92
4 4.4 2.1 1.2 3816.79
4 4.4 2.1 1.4 3787.88
4 4.6 1.7 1 1191.9
4 4.6 1.7 1.2 1164.14
4 4.6 1.7 1.4 1143.51
4 4.6 1.9 1 1101.32
4 4.6 1.9 1.2 1054.3
4 4.6 1.9 1.4 1068.95
4 4.6 2.1 1 1089.32
4 4.6 2.1 1.2 998.004
4 4.6 2.1 1.4 1012.15
4 4.8 1.7 1 19.4817
4 4.8 1.7 1.2 
4 4.8 1.7 1.4 
4 4.8 1.9 1 
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
