AnBuiUCI/sscs-2026-zotnetic/activities/opamp2AKAM/simulations_testbench/simulation_results/sweep_results_FINE.txt

# bias1 bias2 bias3 bias4 gain
4.78 4.58 1.88 1.38 1.1091
4.78 4.58 1.88 1.39 1.19503
4.78 4.58 1.88 1.4 0.996688
4.78 4.58 1.88 1.41 1.0395
4.78 4.58 1.88 1.42 1.06785
4.78 4.58 1.89 1.38 1.39381
4.78 4.58 1.89 1.39 1.14423
4.78 4.58 1.89 1.4 1.10593
4.78 4.58 1.89 1.41 1.17488
4.78 4.58 1.89 1.42 1.11303
4.78 4.58 1.9 1.38 1.09111
4.78 4.58 1.9 1.39 1.08972
4.78 4.58 1.9 1.4 0.987621
4.78 4.58 1.9 1.41 1.02016
4.78 4.58 1.9 1.42 1.11621
4.78 4.58 1.91 1.38 1.27928
4.78 4.58 1.91 1.39 0.986489
4.78 4.58 1.91 1.4 1.2302
4.78 4.58 1.91 1.41 1.19062
4.78 4.58 1.91 1.42 1.04365
4.78 4.58 1.92 1.38 1.01463
4.78 4.58 1.92 1.39 1.25287
4.78 4.58 1.92 1.4 1.18245
4.78 4.58 1.92 1.41 0.925767
4.78 4.58 1.92 1.42 1.14253
4.78 4.59 1.88 1.38 1.54609
4.78 4.59 1.88 1.39 1.38971
4.78 4.59 1.88 1.4 1.82099
4.78 4.59 1.88 1.41 1.11819
4.78 4.59 1.88 1.42 1.34635
4.78 4.59 1.89 1.38 1.20711
4.78 4.59 1.89 1.39 1.18668
4.78 4.59 1.89 1.4 1.07864
4.78 4.59 1.89 1.41 1.44325
4.78 4.59 1.89 1.42 1.37449
4.78 4.59 1.9 1.38 1.27271
4.78 4.59 1.9 1.39 1.26489
4.78 4.59 1.9 1.4 1.12151
4.78 4.59 1.9 1.41 1.43535
4.78 4.59 1.9 1.42 1.19053
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
