AnBuiUCI/sscs-2026-zotnetic/activities/opamp2AKAM/simulations_testbench/simulation_results/sweep_results_G100.txt

# bias1 bias2 bias3 bias4 gain
4.7 4.5 1.8 1.3 3527.34
4.7 4.5 1.8 1.4 263.193
4.7 4.5 1.9 1.3 296.648
4.7 4.5 1.9 1.4 294.811
4.7 4.5 2 1.3 328.839
4.7 4.5 2 1.4 323.102
4.7 4.5 2.1 1.3 355.682
4.7 4.5 2.1 1.4 349.528
4.7 4.6 1.8 1.3 124.054
4.7 4.6 1.8 1.4 125.881
4.7 4.6 1.9 1.3 120.926
4.7 4.6 1.9 1.4 3514.94
4.7 4.6 2 1.3 
4.7 4.6 2 1.4 3838.77
4.7 4.6 2.1 1.3 
4.7 4.6 2.1 1.4 
4.7 4.7 1.8 1.3 20.8128
4.7 4.7 1.8 1.4 21.3359
4.7 4.7 1.9 1.3 19.6516
4.7 4.7 1.9 1.4 20.0722
4.7 4.7 2 1.3 1375.52
4.7 4.7 2 1.4 
4.7 4.7 2.1 1.3 
4.7 4.7 2.1 1.4 
4.7 4.8 1.8 1.3 19.9296
4.7 4.8 1.8 1.4 20.1009
4.7 4.8 1.9 1.3 
4.7 4.8 1.9 1.4 20.2555
4.7 4.8 2 1.3 20.5956
4.7 4.8 2 1.4 20.7125
4.7 4.8 2.1 1.3 20.1177
4.7 4.8 2.1 1.4 20.0933
4.7 4.9 1.8 1.3 20.1301
4.7 4.9 1.8 1.4 20.1939
4.7 4.9 1.9 1.3 20.0832
4.7 4.9 1.9 1.4 20.2364
4.7 4.9 2 1.3 20.0763
4.7 4.9 2 1.4 20.1894
4.7 4.9 2.1 1.3 19.8107
4.7 4.9 2.1 1.4 19.9245
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
