AnBuiUCI/sscs-2026-zotnetic/activities/opamp2AKAM/simulations_testbench/simulation_results/tuningBias3.txt

bias3Value Gain
0 
0.05 
0.1 
0.15 
0.2 
0.25 73.0834
0.3 84.969
0.35 2136.75
0.4 4385.96
0.45 4796.16
0.5 4395.6
0.55 4926.11
0.6 4535.15
0.65 4866.18
0.7 4672.9
0.75 4464.29
0.8 4524.89
0.85 4040.4
0.9 4301.08
0.95 4149.38
1 3992.02
1.05 3861
1.1 3773.58
1.15 3752.35
1.2 3752.35
1.25 3552.4
1.3 4282.66
1.35 4587.16
1.4 4651.16
1.45 4651.16
1.5 4618.94
1.55 4576.66
1.6 4504.5
1.65 4385.96
1.7 4210.53
1.75 3984.06
1.8 3752.35
1.85 3514.94
1.9 3012.05
1.95 2735.98
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
