AnBuiUCI/sscs-2026-zotnetic/FINAL/XSCHEM/TEST_TOTAL/datos/ancho.csv

angle_deg | bx | by | bz | X1 | Y1 | Z1 | X2 | Y2 | Z2 | X3 | Y3 | Z3 | X4 | Y4 | Z4 | SX1 | SY1 | SZ1 | SX2 | SY2 | SZ2 | SX3 | SY3 | SZ3 | SX4 | SY4 | SZ4 | XY1 | XZ1 | YZ1 | XY2 | XZ2 | YZ2 | XY3 | XZ3 | YZ3 | XY4 | XZ4 | YZ4 | S1P | S1N | S2P | S2N | S3P | S3N | P_EXC | P_G1 | P_G2 | P_G3 | P_G4
0 | 0.02 | -0.01 | -0.01 | 1.66832e-08 | 1.66832e-08 | 5 | 1.66832e-08 | 1.66832e-08 | 5 | 1.67897e-08 | 1.67889e-08 | 5 | 1.67897e-08 | 1.67889e-08 | 5 | 5 | 1.73145e-08 | 1.73145e-08 | 4.95836 | 0.0378937 | 0.0378937 | 4.99968 | 0.000131644 | 0.000131644 | 4.95808 | 0.0381382 | 0.0381382 | 3.83688e-09 | 3.83688e-09 | 0.154895 | 3.83688e-09 | 3.83688e-09 | 0.154896 | 0.000305378 | 0.000305378 | 0.0989044 | 0.000305377 | 0.000305377 | 0.0988651 | 2.55 | 2.45 | 2.475 | 2.525 | 2.475 | 2.525 | -7.5e-05 | -0.0171742 | -0.016548 | -0.0170344 | -0.01641
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
