AnBuiUCI/sscs-2026-zotnetic/FINAL/XSCHEM/TEST_TOTAL/datos/fino.csv

angle_deg | bx | by | bz | X1 | Y1 | Z1 | X2 | Y2 | Z2 | X3 | Y3 | Z3 | X4 | Y4 | Z4 | SX1 | SY1 | SZ1 | SX2 | SY2 | SZ2 | SX3 | SY3 | SZ3 | SX4 | SY4 | SZ4 | XY1 | XZ1 | YZ1 | XY2 | XZ2 | YZ2 | XY3 | XZ3 | YZ3 | XY4 | XZ4 | YZ4 | S1P | S1N | S2P | S2N | S3P | S3N | P_EXC | P_G1 | P_G2 | P_G3 | P_G4
0 | 5e-05 | -2.5e-05 | -2.5e-05 | 1.66832e-08 | 1.66832e-08 | 5 | 1.66832e-08 | 1.66832e-08 | 5 | 1.67897e-08 | 1.67889e-08 | 5 | 1.67897e-08 | 1.67889e-08 | 5 | 0.062047 | 0.00196694 | 0.00196694 | 0.747949 | 0.711489 | 0.711489 | 0.0723861 | 0.00228592 | 0.00228592 | 0.766144 | 0.729839 | 0.729839 | 9.83677e-08 | 9.83677e-08 | 0.154895 | 5.0596e-07 | 5.0596e-07 | 0.158845 | 0.000309951 | 0.000309951 | 0.0989022 | 0.000312431 | 0.000312431 | 0.100862 | 2.50013 | 2.49987 | 2.49994 | 2.50006 | 2.49994 | 2.50006 | -7.5e-05 | -0.0171917 | -0.0169636 | -0.0170376 | -0.0168336
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
