AnBuiUCI/sscs-2026-zotnetic/FINAL/XSCHEM/TEST_TOTAL/datos_geo/caja.csv

kind | version | hit | indefinido | wrong | acierto_par_invertido
esfera_1e-03 | t | 69.9580 | 0.0000 | 30.0420 | 0.0000
esfera_1e-03 | v | 69.9580 | 0.0000 | 30.0420 | 0.0000
esfera_2e-03 | t | 83.6536 | 0.0293 | 16.3172 | 0.0000
esfera_2e-03 | v | 83.6536 | 0.0293 | 16.3172 | 0.0000
esfera_9e-03 | t | 90.0712 | 1.0236 | 8.9052 | 0.0000
esfera_9e-03 | v | 90.0712 | 1.0236 | 8.9052 | 0.0000
