AnBuiUCI/sscs-2026-zotnetic/FINAL/XSCHEM/TEST_TOTAL/datos_nav2/fino_nav2.csv

angulo | X | Y | Z | XP | XN | YP | YN | ZP | ZN | Xr | Yr | Zr | XPr | XNr | YPr | YNr | ZPr | ZNr | X1 | X2 | X3 | X4 | Y1 | Y2 | Y3 | Y4 | Z1 | Z2 | Z3 | Z4 | X1r | X2r | X3r | X4r | Y1r | Y2r | Y3r | Y4r | Z1r | Z2r | Z3r | Z4r | S1P | S1N | S2P | S2N | S3P | S3N | S4P | S4N | P_EXC | P_ESQ | P_LAY
0.0000 | 2.5794 | 1.81384 | 1.81384 | 7.55851e-09 | 5 | 5 | 0.00123953 | 5 | 0.00123953 | 2.57783 | 1.81088 | 1.81068 | 4.53427e-05 | 4.99996 | 4.99997 | 0.00121681 | 4.99997 | 0.00128 | 1.66832e-08 | 1.66832e-08 | 1.66832e-08 | 1.66832e-08 | 1.66832e-08 | 5 | 1.66832e-08 | 5 | 5 | 1.66833e-08 | 5 | 1.66833e-08 | 1.67901e-08 | 1.67899e-08 | 1.67901e-08 | 1.67899e-08 | 1.67931e-08 | 5 | 1.67931e-08 | 5 | 5 | 1.68006e-08 | 5 | 1.68006e-08 | 2.49991 | 2.50009 | 2.50009 | 2.49991 | 2.49991 | 2.50009 | 2.50009 | 2.49991 | -0.0001 | -0.0769385 | -0.0763929
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
