AnBuiUCI/sscs-2026-zotnetic/FINAL/XSCHEM/TEST_TOTAL/datos_geo_pre_resim_0904/caja.csv

kind | version | hit | indefinido | wrong | acierto_par_invertido
esfera_1e-03 | t | 69.9580 | 0.0000 | 30.0420 | 0.0000
esfera_1e-03 | v | 69.9580 | 0.0000 | 30.0420 | 0.0000
esfera_2e-03 | t | 83.6828 | 0.0000 | 16.3172 | 0.0000
esfera_2e-03 | v | 83.6828 | 0.0000 | 16.3172 | 0.0000
esfera_9e-03 | t | 90.7010 | 0.3838 | 8.9152 | 0.0000
esfera_9e-03 | v | 90.7010 | 0.3838 | 8.9152 | 0.0000
