AnBuiUCI/sscs-2026-zotnetic/FINAL/XSCHEM/TEST_TOTAL/datos_geo_pre_resim_0904/manifiesto.csv

idx | tipo | lxy_um | lz_um | gmm | bg | tilt_deg | off
1 | esfera_1e-03 | 1000 | 1000 | 1.000000e-03 | 0.000000e+00 | 0 | 2.000000e-04
2 | esfera_2e-03 | 1000 | 1000 | 2.223000e-03 | 0.000000e+00 | 0 | 2.000000e-04
3 | esfera_9e-03 | 1000 | 1000 | 9.430000e-03 | 0.000000e+00 | 0 | 2.000000e-04
4 | esfera_1e-03 | 1000 | 1000 | 1.000000e-03 | 0.000000e+00 | 15 | 2.000000e-04
5 | esfera_2e-03 | 1000 | 1000 | 2.223000e-03 | 0.000000e+00 | 15 | 2.000000e-04
6 | esfera_9e-03 | 1000 | 1000 | 9.430000e-03 | 0.000000e+00 | 15 | 2.000000e-04
7 | esfera_1e-03 | 1000 | 1000 | 1.000000e-03 | 0.000000e+00 | 30 | 2.000000e-04
8 | esfera_2e-03 | 1000 | 1000 | 2.223000e-03 | 0.000000e+00 | 30 | 2.000000e-04
9 | esfera_9e-03 | 1000 | 1000 | 9.430000e-03 | 0.000000e+00 | 30 | 2.000000e-04
10 | esfera_1e-03 | 1000 | 1000 | 1.000000e-03 | 0.000000e+00 | 45 | 2.000000e-04
11 | esfera_2e-03 | 1000 | 1000 | 2.223000e-03 | 0.000000e+00 | 45 | 2.000000e-04
12 | esfera_9e-03 | 1000 | 1000 | 9.430000e-03 | 0.000000e+00 | 45 | 2.000000e-04
13 | esfera_1e-03 | 1000 | 1000 | 1.000000e-03 | 0.000000e+00 | 60 | 2.000000e-04
14 | esfera_2e-03 | 1000 | 1000 | 2.223000e-03 | 0.000000e+00 | 60 | 2.000000e-04
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
