AnBuiUCI/sscs-2026-zotnetic/FINAL/XSCHEM/TEST_TOTAL/datos_nav2_pre_resim/fino_nav2.csv

angulo | X | Y | Z | XP | XN | YP | YN | ZP | ZN | Xr | Yr | Zr | XPr | XNr | YPr | YNr | ZPr | ZNr | X1 | X2 | X3 | X4 | Y1 | Y2 | Y3 | Y4 | Z1 | Z2 | Z3 | Z4 | X1r | X2r | X3r | X4r | Y1r | Y2r | Y3r | Y4r | Z1r | Z2r | Z3r | Z4r | S1P | S1N | S2P | S2N | S3P | S3N | S4P | S4N | P_EXC | P_ESQ | P_LAY
0.0000 | 2.17814 | 3.03521 | 2.17814 | 4.95175 | 7.59397e-09 | 5 | 7.55851e-09 | 4.95175 | 7.59397e-09 | 2.17666 | 3.03529 | 2.17586 | 4.94525 | 0.000103974 | 5 | 5.87453e-05 | 4.94393 | 0.000253665 | 1.66832e-08 | 5 | 1.66832e-08 | 5 | 1.66832e-08 | 1.66832e-08 | 1.66832e-08 | 1.66832e-08 | 5 | 3.63966e-08 | 5 | 3.6398e-08 | 1.67894e-08 | 5 | 1.67894e-08 | 5 | 1.67938e-08 | 1.67989e-08 | 1.67938e-08 | 1.67989e-08 | 5 | 3.72323e-08 | 5 | 3.72321e-08 | 2.49991 | 2.50009 | 2.50009 | 2.49991 | 2.49991 | 2.50009 | 2.50009 | 2.49991 | -0.0001 | -0.076842 | -0.0763046
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
