AnBuiUCI/sscs-2026-zotnetic/FINAL/XSCHEM/TEST_TOTAL/datos_top/disparo_vdd.csv

wp_um | vdd | temp_c | trip_v
3.0 | 4.5 | -40 | 2.1250
3.0 | 4.75 | -40 | 2.2550
3.0 | 5.0 | -40 | 2.3850
3.0 | 5.25 | -40 | 2.5150
3.0 | 5.5 | -40 | 2.6450
3.0 | 4.5 | 27 | 2.1100
3.0 | 4.75 | 27 | 2.2350
3.0 | 5.0 | 27 | 2.3650
3.0 | 5.25 | 27 | 2.4900
3.0 | 5.5 | 27 | 2.6200
3.0 | 4.5 | 125 | 2.1050
3.0 | 4.75 | 125 | 2.2350
3.0 | 5.0 | 125 | 2.3600
3.0 | 5.25 | 125 | 2.4900
3.0 | 5.5 | 125 | 2.6200
