AnBuiUCI/sscs-2026-zotnetic/FINAL/XSCHEM/TEST_TOTAL/datos_top/disparo_w.csv

wp_um | vdd | temp_c | trip_v
1.83 | 5.0 | 27 | 2.0600
2.5 | 5.0 | 27 | 2.2500
3.0 | 5.0 | 27 | 2.3650
3.5 | 5.0 | 27 | 2.4600
4.5 | 5.0 | 27 | 2.6100
6.0 | 5.0 | 27 | 2.7800
8.0 | 5.0 | 27 | 2.9400
11.0 | 5.0 | 27 | 3.1050
