AnBuiUCI/sscs-2026-zotnetic/FINAL/XSCHEM/TEST_TOTAL/datos_nav2_v2/fino_nav2_v2.csv

angulo | X | Y | Z | XP | XN | YP | YN | ZP | ZN | Xv | Yv | Zv | XPv | XNv | YPv | YNv | ZPv | ZNv | h_X1 | h_X2 | h_X3 | h_X4 | h_Y1 | h_Y2 | h_Y3 | h_Y4 | h_Z1 | h_Z2 | h_Z3 | h_Z4 | v_X1 | v_X2 | v_X3 | v_X4 | v_Y1 | v_Y2 | v_Y3 | v_Y4 | v_Z1 | v_Z2 | v_Z3 | v_Z4 | S1P | S1N | S2P | S2N | S3P | S3N | S4P | S4N | VREF | P_EXC | P_HOY | P_V2
0.0000 | 2.17814 | 3.03521 | 2.17814 | 4.95175 | 7.59397e-09 | 5 | 7.55851e-09 | 4.95175 | 7.59397e-09 | 3.03521 | 2.17814 | 2.17814 | 3.83685e-09 | 5 | 5 | 1.66832e-08 | 5 | 1.66832e-08 | 1.66832e-08 | 5 | 1.66832e-08 | 5 | 1.66832e-08 | 1.66832e-08 | 1.66832e-08 | 1.66832e-08 | 5 | 3.63987e-08 | 5 | 3.63969e-08 | 1.66832e-08 | 1.66832e-08 | 1.66832e-08 | 1.66832e-08 | 1.66832e-08 | 5 | 1.66832e-08 | 5 | 5 | 1.66832e-08 | 5 | 1.66832e-08 | 2.49991 | 2.50009 | 2.50009 | 2.49991 | 2.49991 | 2.50009 | 2.50009 | 2.49991 | 2.37855 | -0.0001 | -0.0768421 | -0.0875705
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
