AnBuiUCI/sscs-2026-zotnetic/FINAL/XSCHEM/TEST_TOTAL/datos_fuente/por_barrido/s001.csv

ang | peso | ux | uy | uz | miss | miss_ideal | b1_ideal | b1_medido | b2_ideal | b2_medido | b3_ideal | b3_medido | b4_ideal | b4_medido | XPv | XPt | Xv | Xt | XNv | XNt | YPv | YPt | Yv | Yt | YNv | YNt | ZPv | ZPt | Zv | Zt | ZNv | ZNt | k1XY | k1XZ | k1YZ | k2XY | k2XZ | k2YZ | k3XY | k3XZ | k3YZ | k4XY | k4XZ | k4YZ | dominante_ideal_v | votos_X_v | votos_Y_v | votos_Z_v | dominante_ideal_t | votos_X_t | votos_Y_t | votos_Z_t
0 | 0 | 1 | 0 | 0 | 1.32273 | 0 | 0.0029653 | 0.00316529 | 0.007698 | 0.00757399 | 0.0029653 | 0.00302729 | 0.007698 | 0.00752799 | 3.94036e-09 | 7.59397e-09 | 2.17814 | 2.17814 | 5 | 4.95175 | 5 | 5 | 1.81384 | 1.81384 | 1.66832e-08 | 0.00123953 | 3.94036e-09 | 7.59397e-09 | 2.17814 | 2.17814 | 5 | 4.95175 | 5 | 2.2113e-08 | 3.83687e-09 | 3.83687e-09 | 4.99996 | 5 | 5 | 5 | 3.83687e-09 | 3.83687e-09 | 0.00244431 | 5 | 0 | 2 | 2 | 0 | 0 | 2 | 2 | 0
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
