AnBuiUCI/sscs-2026-zotnetic/FINAL/XSCHEM/TEST/doc/figuras/banco_ac.png

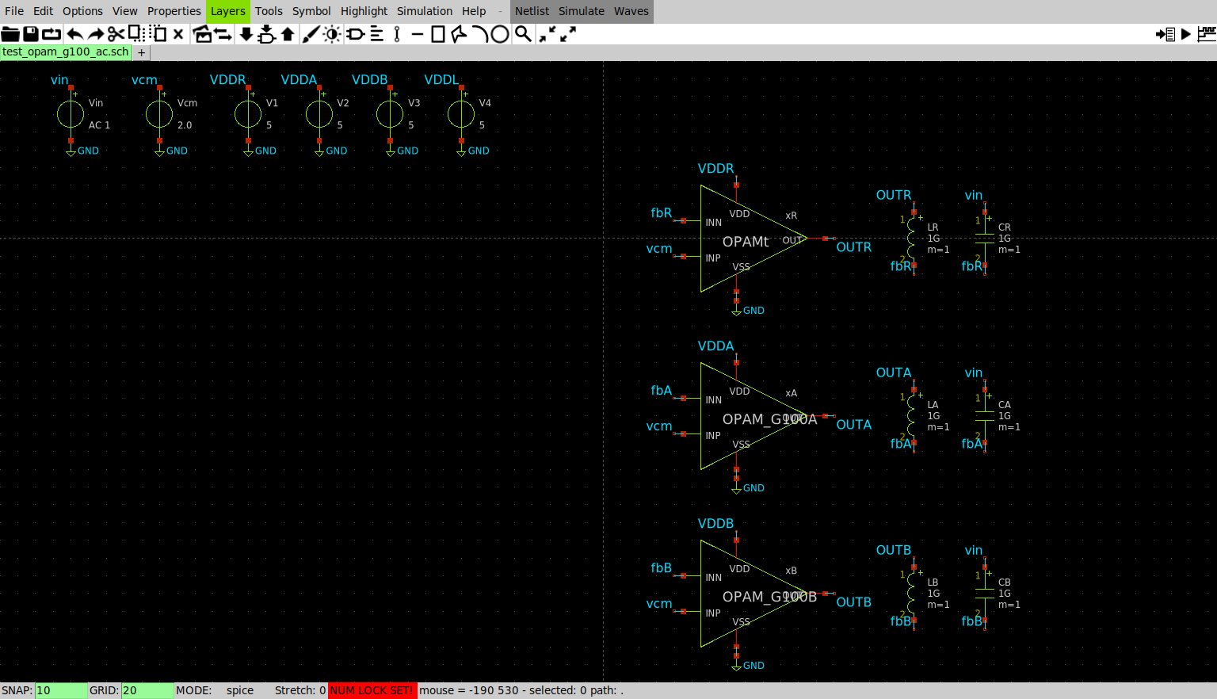
FINAL/XSCHEM/TEST/doc/figuras/banco_ac.png
