AnBuiUCI/sscs-2026-zotnetic/FINAL/XSCHEM/TEST/doc/figuras/banco_dc.png

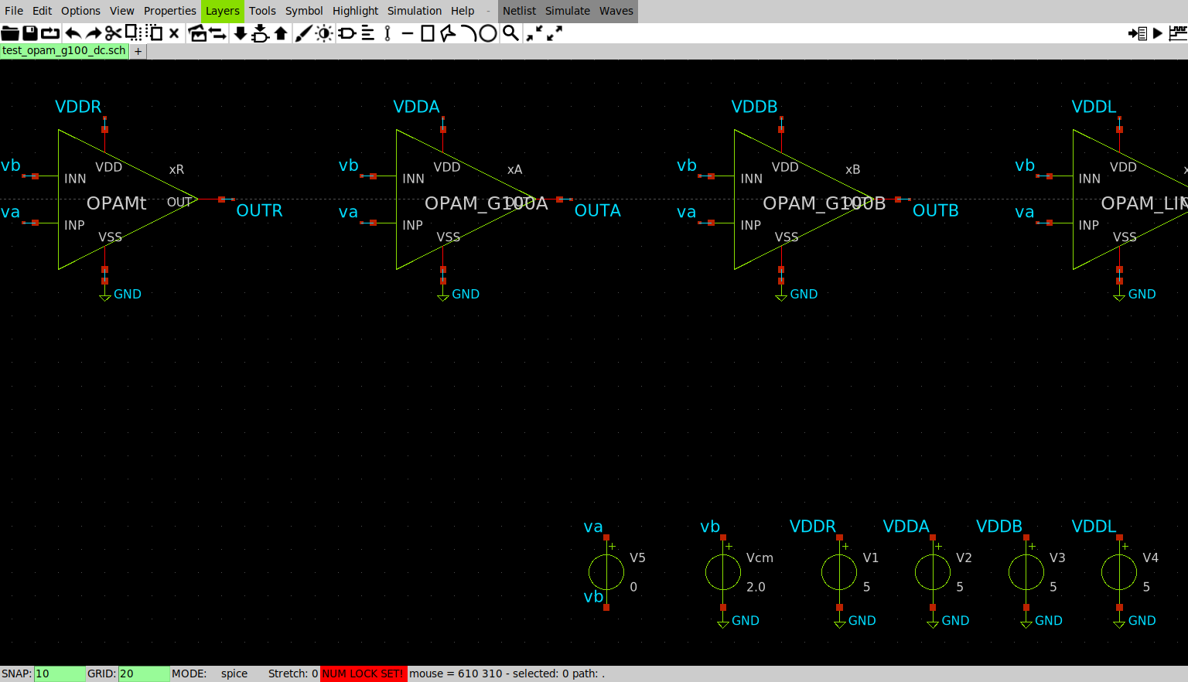
FINAL/XSCHEM/TEST/doc/figuras/banco_dc.png
