AnBuiUCI/sscs-2026-zotnetic/FINAL/XSCHEM/TEST/doc/figuras/banco_tran.png

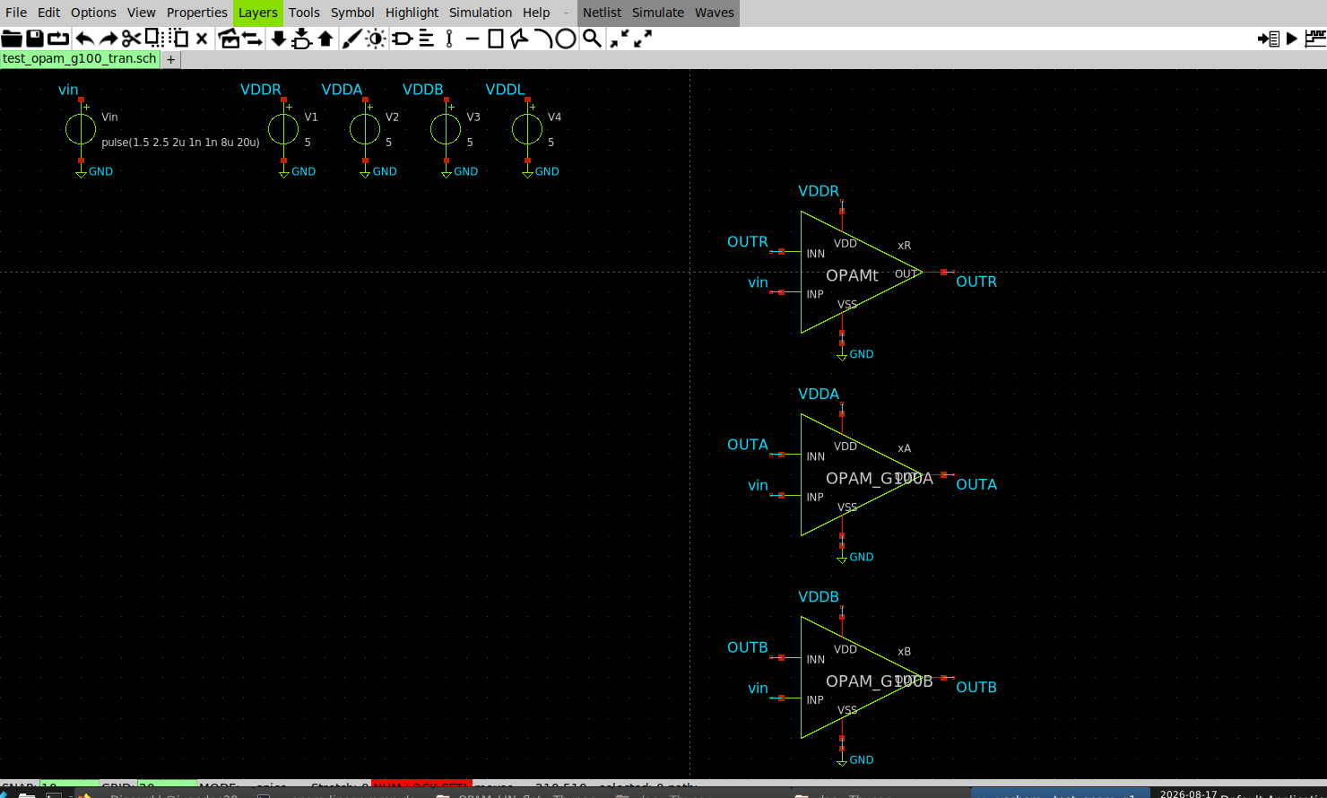
FINAL/XSCHEM/TEST/doc/figuras/banco_tran.png
