AnBuiUCI/sscs-2026-zotnetic/FINAL/XSCHEM/TEST/doc/figuras/bode.png

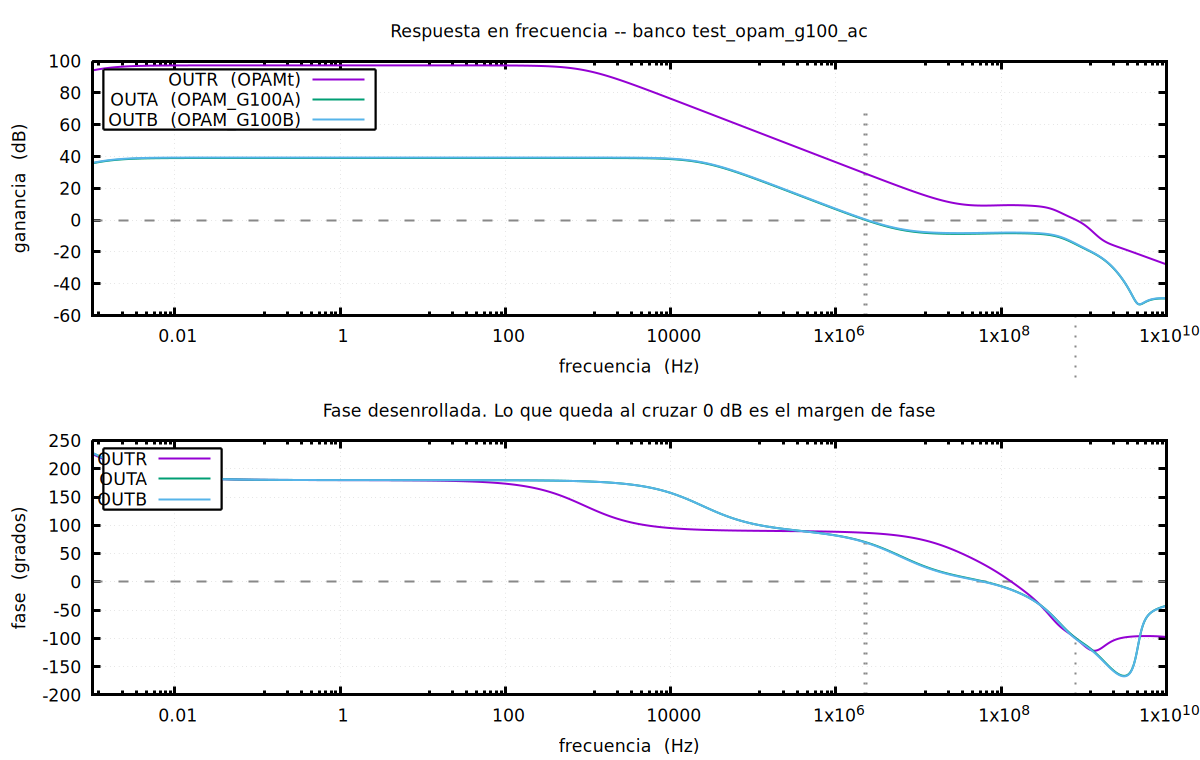
FINAL/XSCHEM/TEST/doc/figuras/bode.png
