AnBuiUCI/sscs-2026-zotnetic/FINAL/XSCHEM/TEST/doc/figuras/dc_pendiente.png

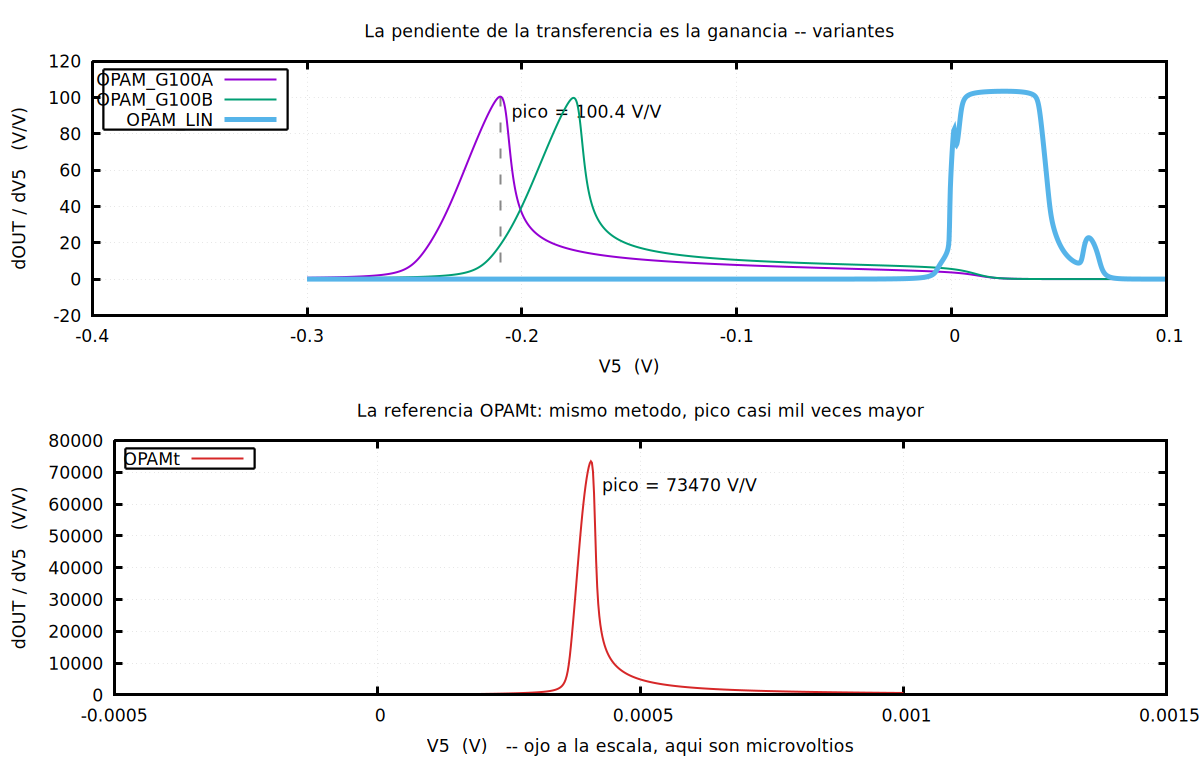
FINAL/XSCHEM/TEST/doc/figuras/dc_pendiente.png
