AnBuiUCI/sscs-2026-zotnetic/FINAL/XSCHEM/TEST/doc/figuras/dc_transferencia.png

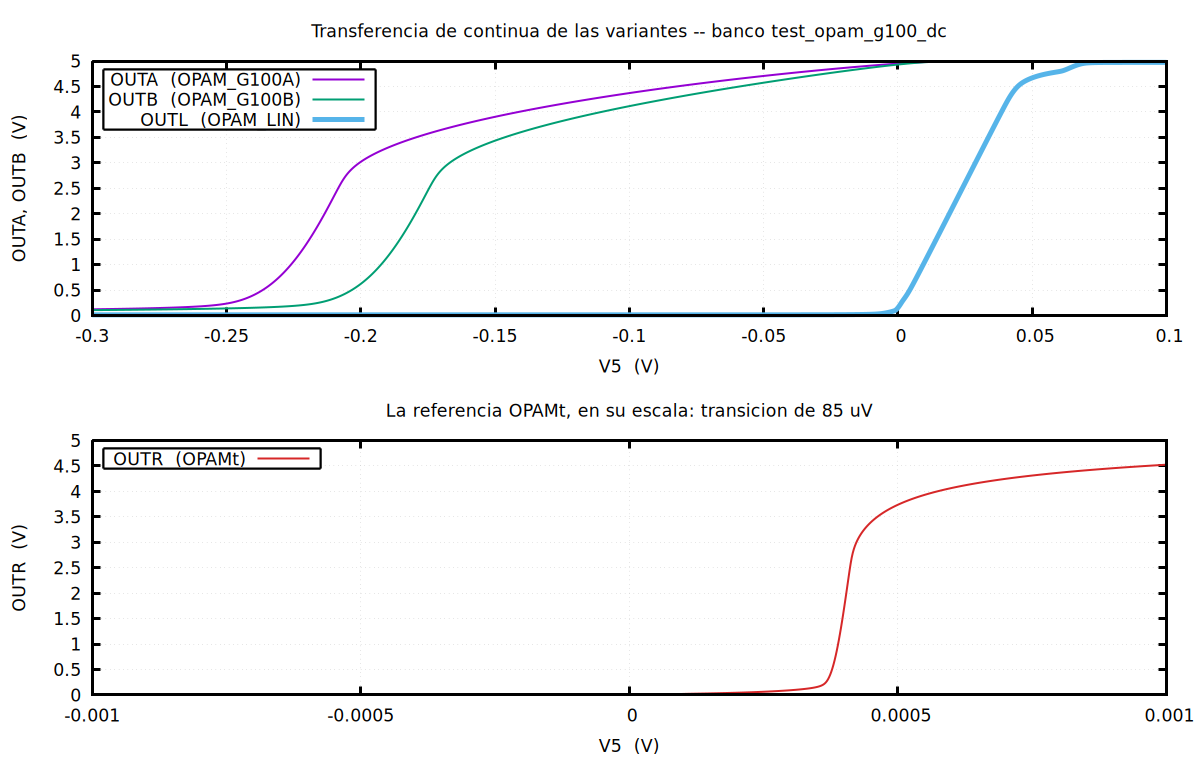
FINAL/XSCHEM/TEST/doc/figuras/dc_transferencia.png
