AnBuiUCI/sscs-2026-zotnetic/FINAL/XSCHEM/TEST/doc/figuras/ganancia_vs_out.png

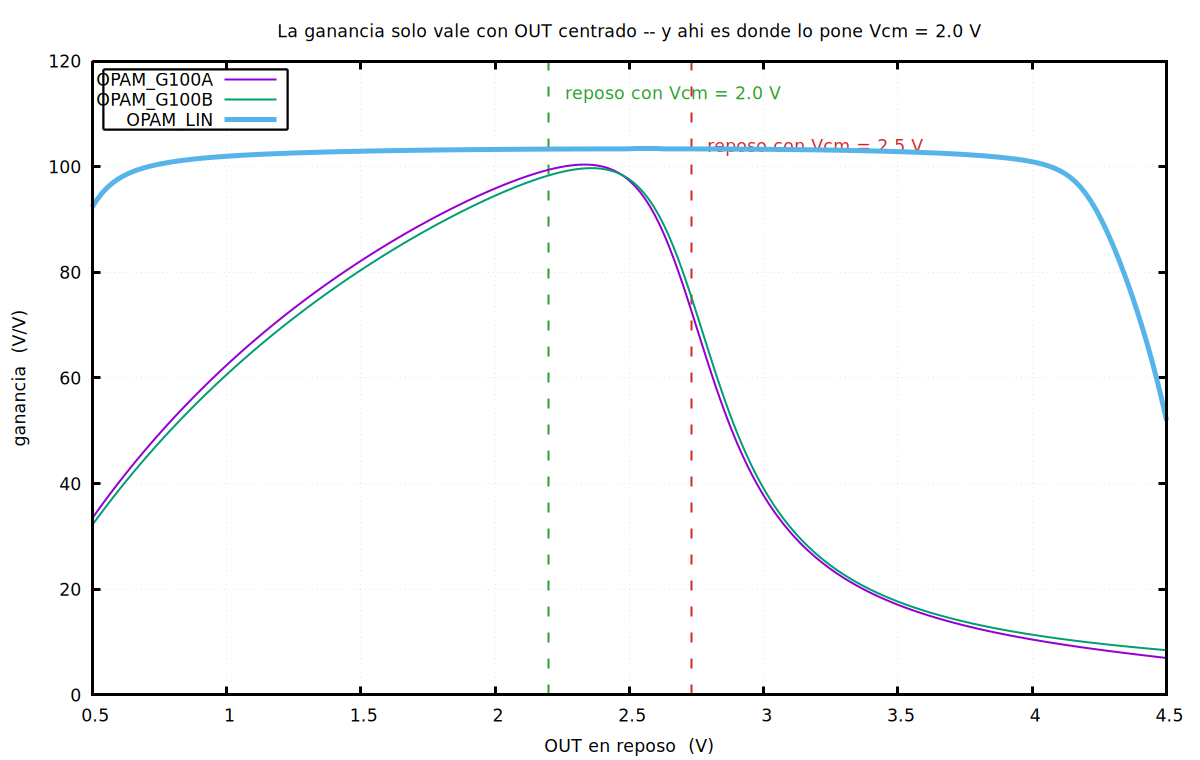
FINAL/XSCHEM/TEST/doc/figuras/ganancia_vs_out.png
