AnBuiUCI/sscs-2026-zotnetic/FINAL/XSCHEM/TEST/doc/figuras/lin_rfb.png

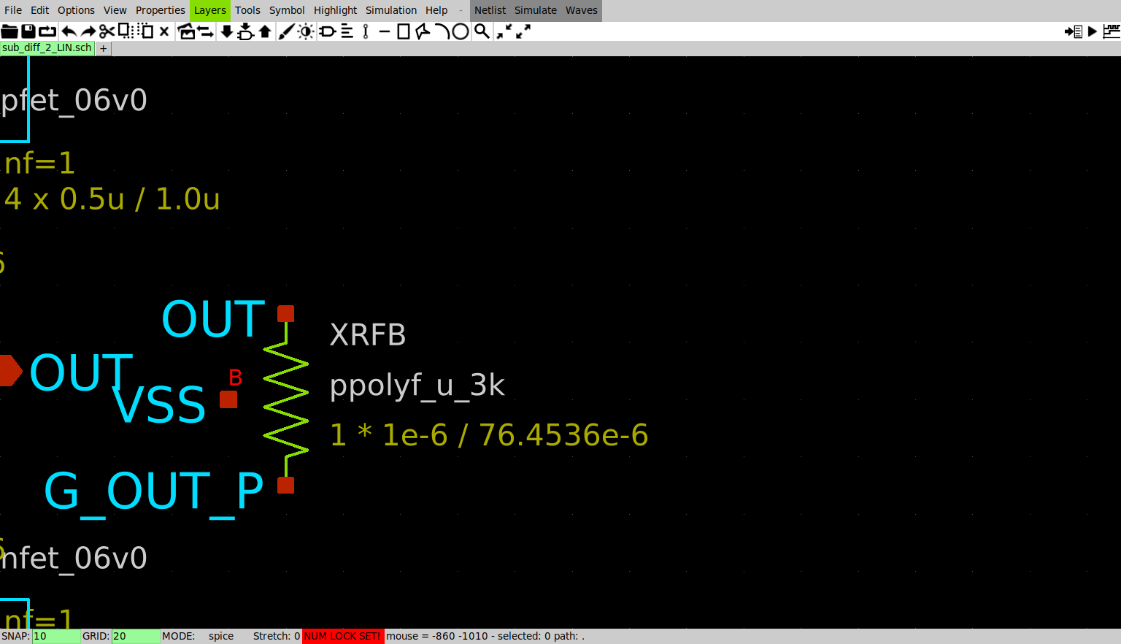
FINAL/XSCHEM/TEST/doc/figuras/lin_rfb.png
