AnBuiUCI/sscs-2026-zotnetic/FINAL/XSCHEM/TEST/doc/figuras/lin_zoom.png

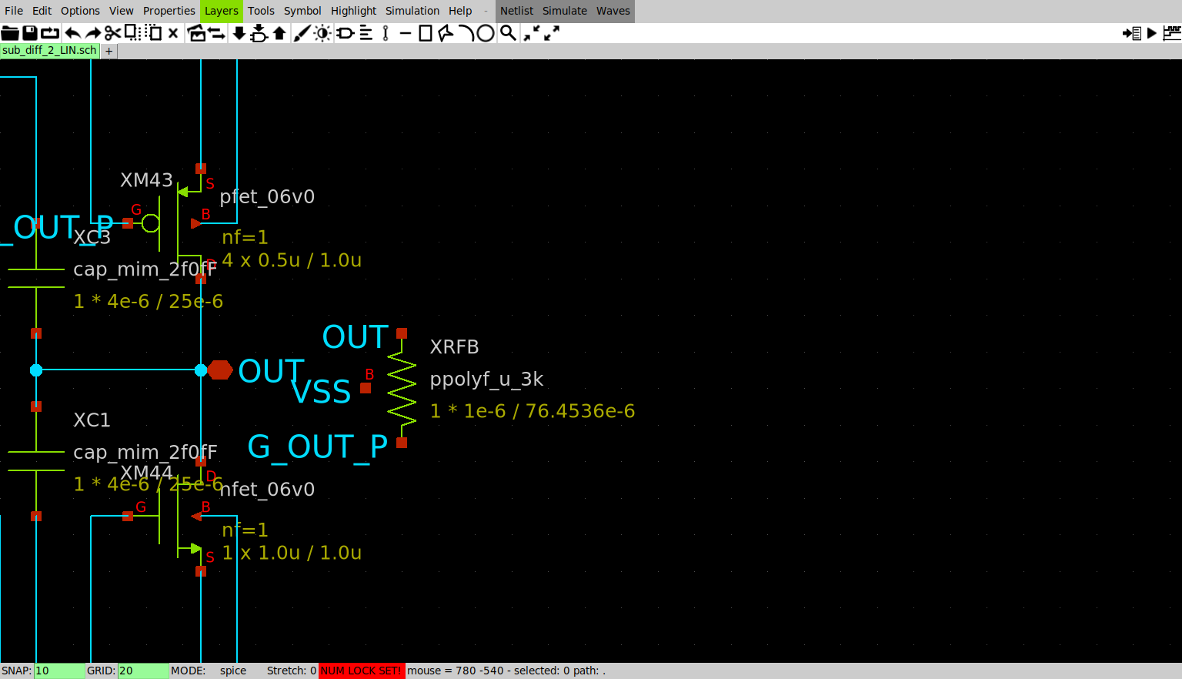
FINAL/XSCHEM/TEST/doc/figuras/lin_zoom.png
