AnBuiUCI/sscs-2026-zotnetic/FINAL/XSCHEM/TEST/doc/figuras/linealidad.png

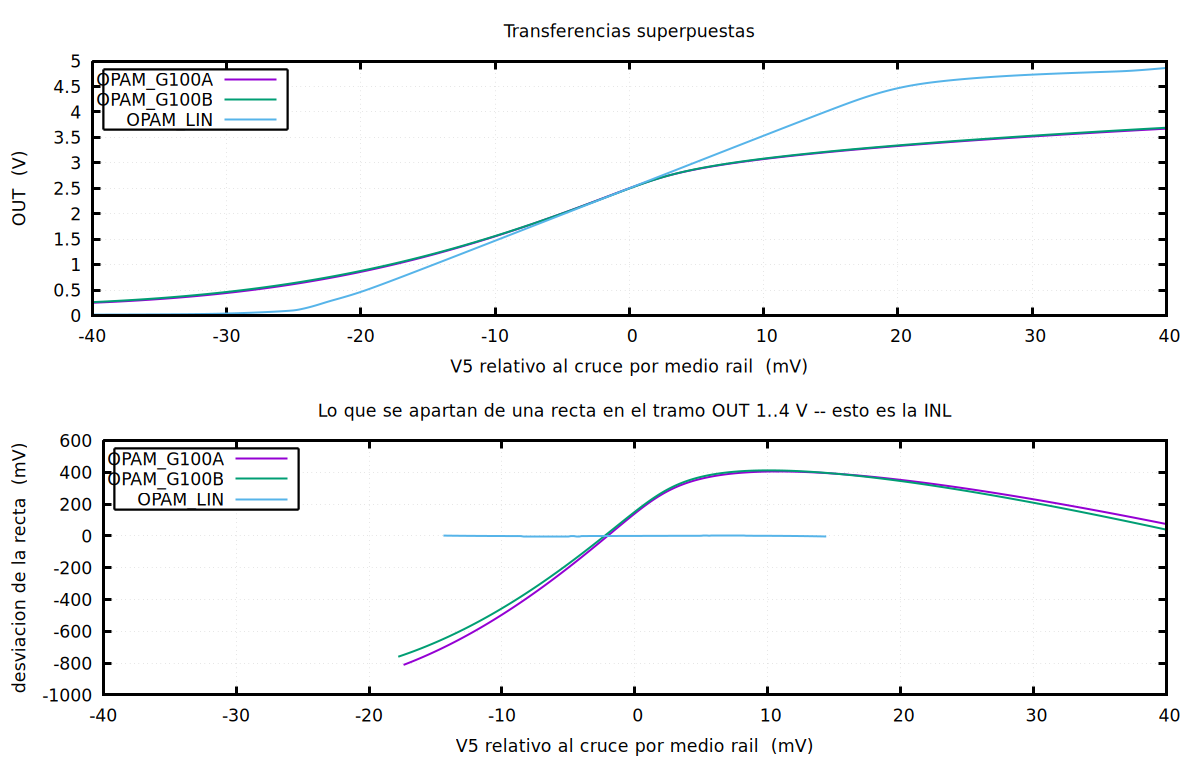
FINAL/XSCHEM/TEST/doc/figuras/linealidad.png
