AnBuiUCI/sscs-2026-zotnetic/FINAL/XSCHEM/TEST/doc/figuras/opamt.png

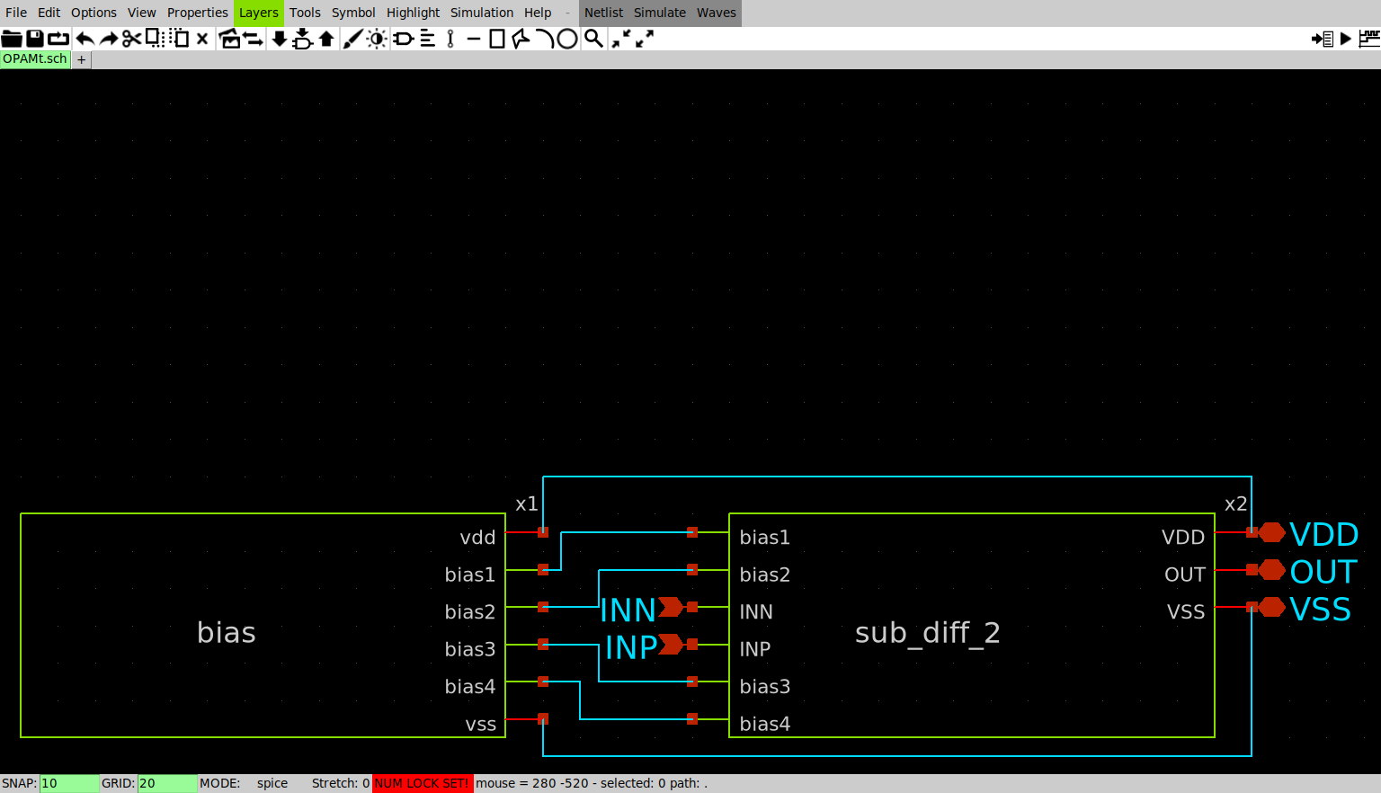
FINAL/XSCHEM/TEST/doc/figuras/opamt.png
