AnBuiUCI/sscs-2026-zotnetic/FINAL/XSCHEM/TEST/doc/figuras/sub_diff.png

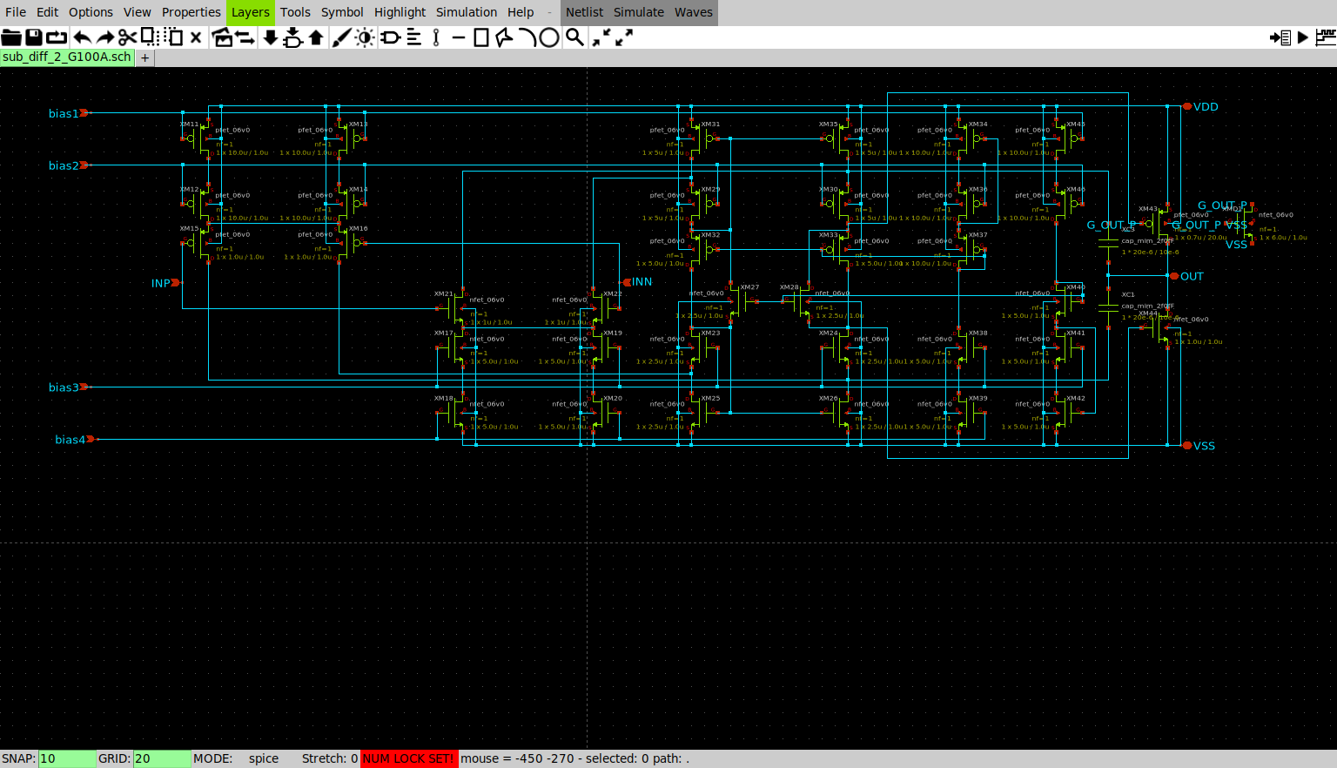
FINAL/XSCHEM/TEST/doc/figuras/sub_diff.png
