AnBuiUCI/sscs-2026-zotnetic/FINAL/XSCHEM/TEST/doc/figuras/sub_diff_der.png

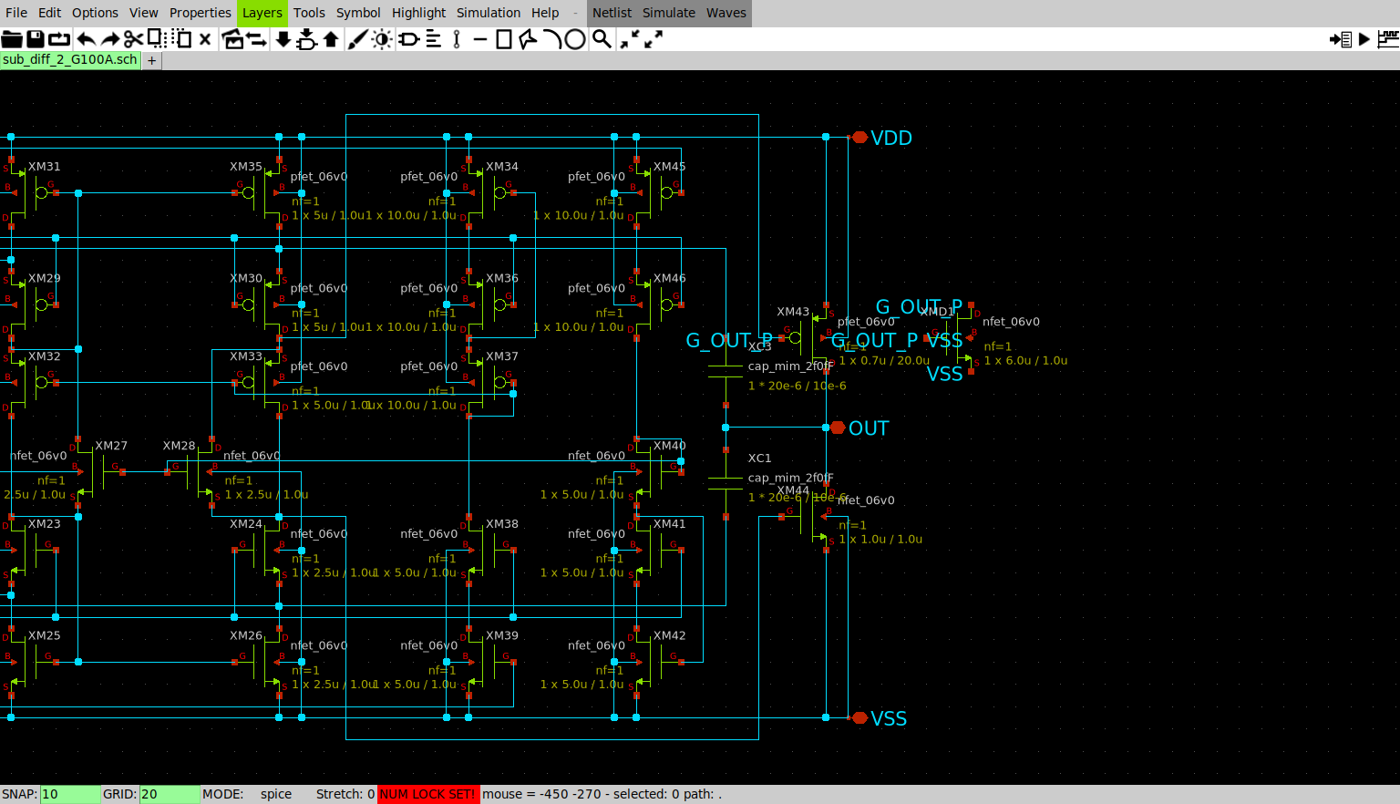
FINAL/XSCHEM/TEST/doc/figuras/sub_diff_der.png
