AnBuiUCI/sscs-2026-zotnetic/FINAL/XSCHEM/TEST/doc/figuras/sub_diff_zoom.png

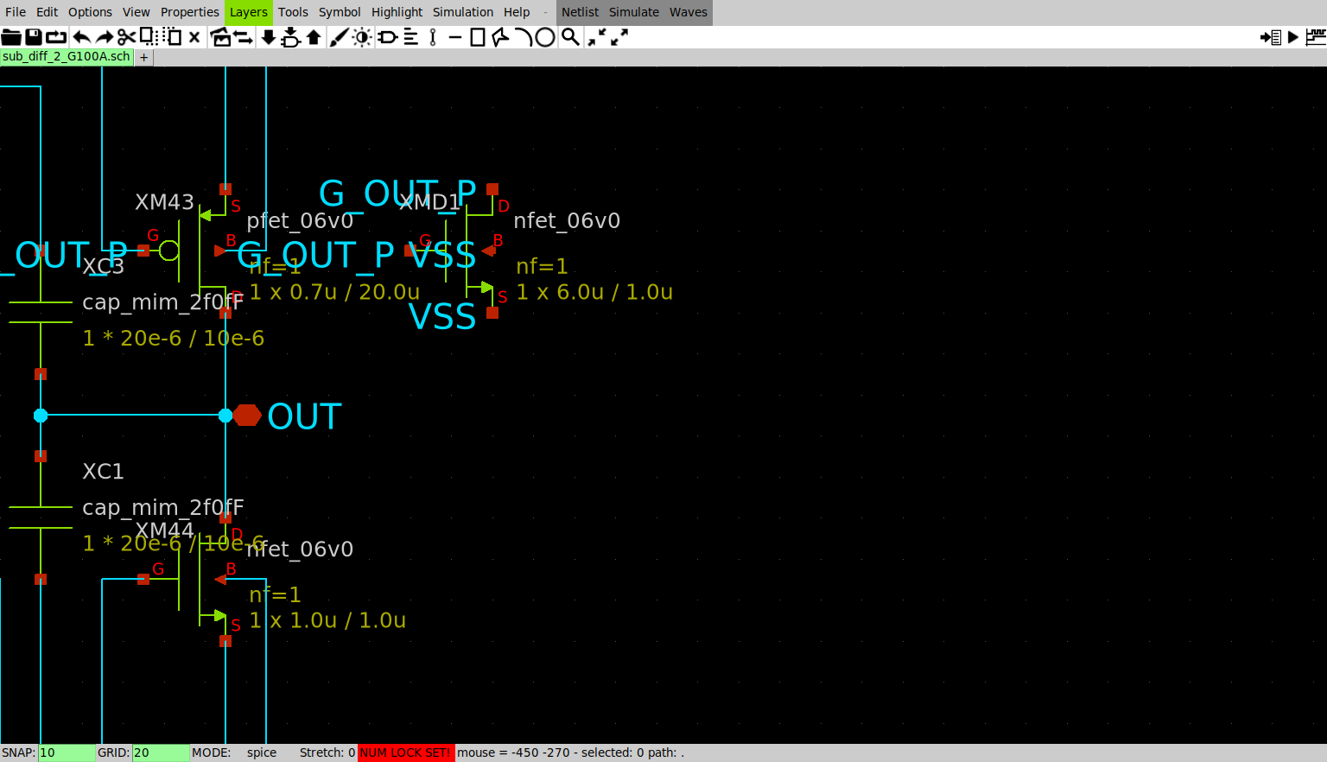
FINAL/XSCHEM/TEST/doc/figuras/sub_diff_zoom.png
