AnBuiUCI/sscs-2026-zotnetic/FINAL/XSCHEM/TEST/doc/figuras/transitorio.png

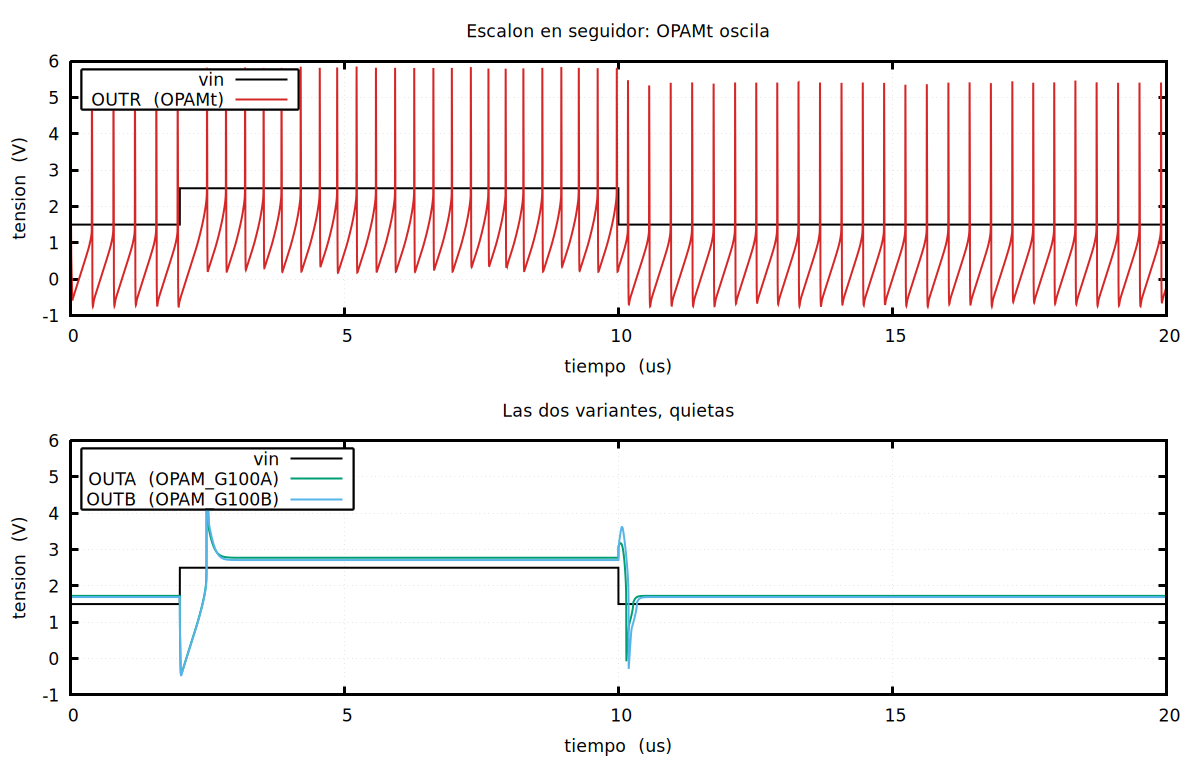
FINAL/XSCHEM/TEST/doc/figuras/transitorio.png
