AnBuiUCI/sscs-2026-zotnetic/FINAL/XSCHEM/TEST/simulation/test_decoder.sch/logic.png

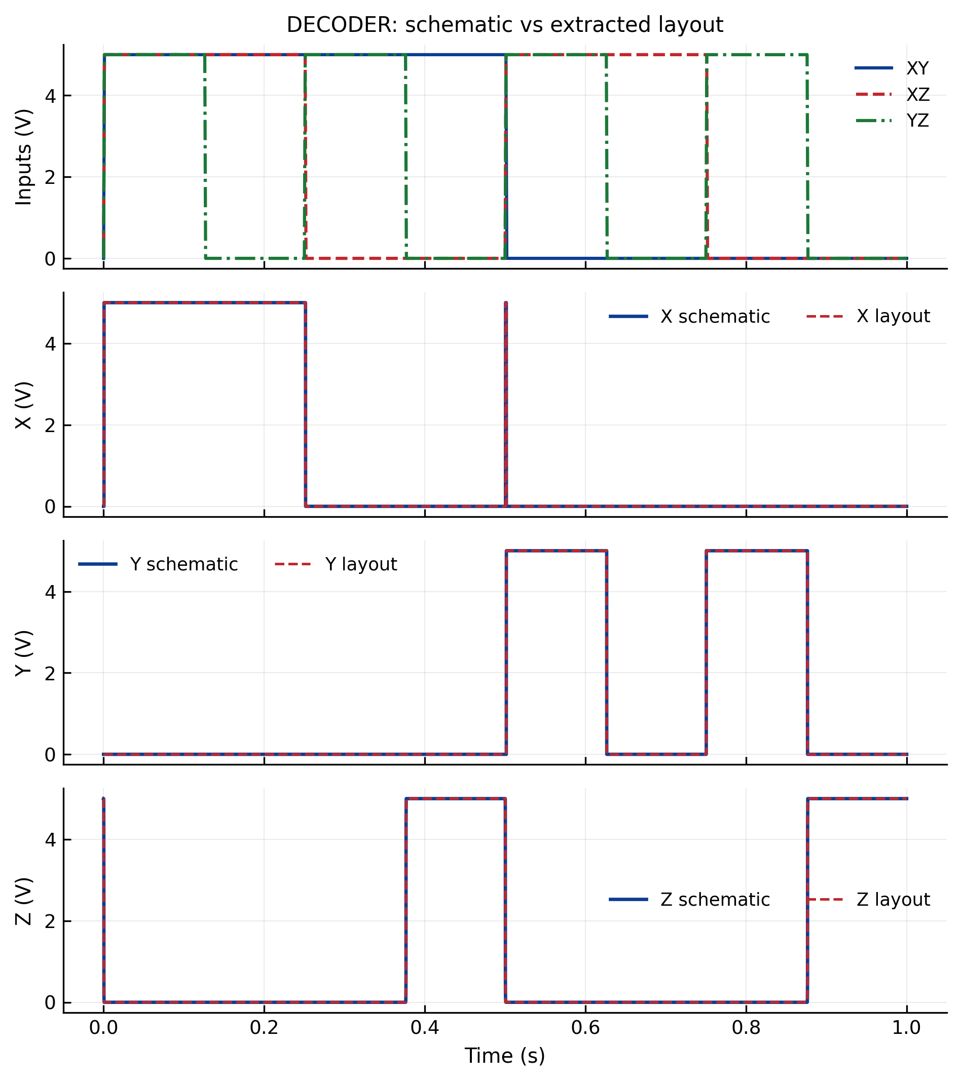
FINAL/XSCHEM/TEST/simulation/test_decoder.sch/logic.png
