AnBuiUCI/sscs-2026-zotnetic/FINAL/XSCHEM/TEST/simulation/test_decoder.sch/power.png

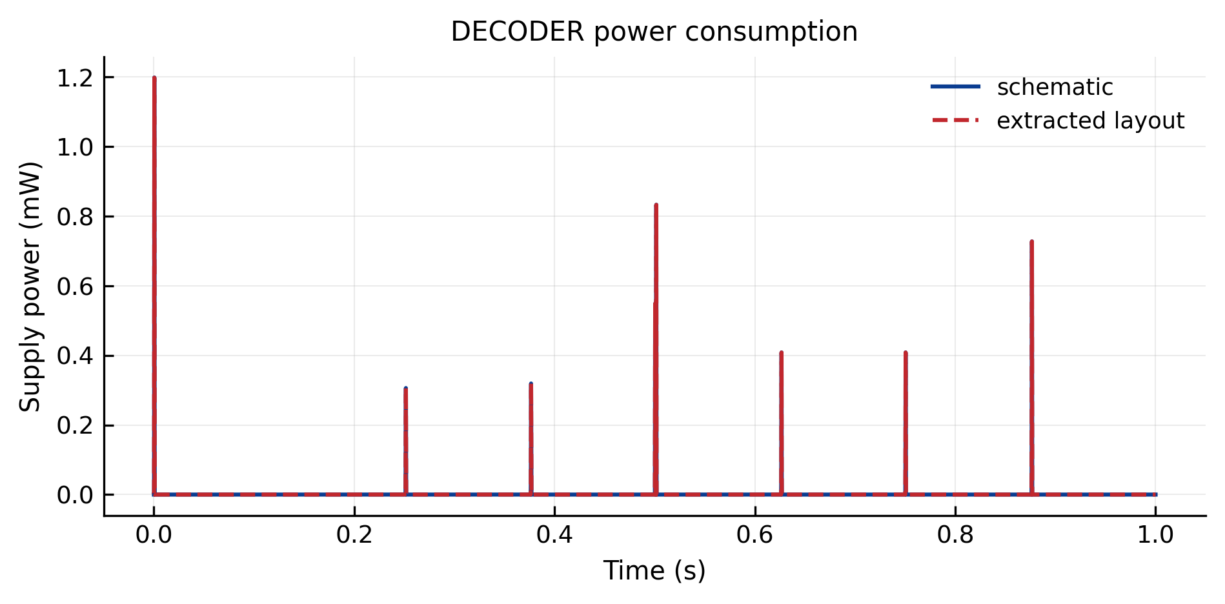
FINAL/XSCHEM/TEST/simulation/test_decoder.sch/power.png
