AnBuiUCI/sscs-2026-zotnetic/FINAL/XSCHEM/TEST/simulation/test_opam_g100_ac.sch/bode.png

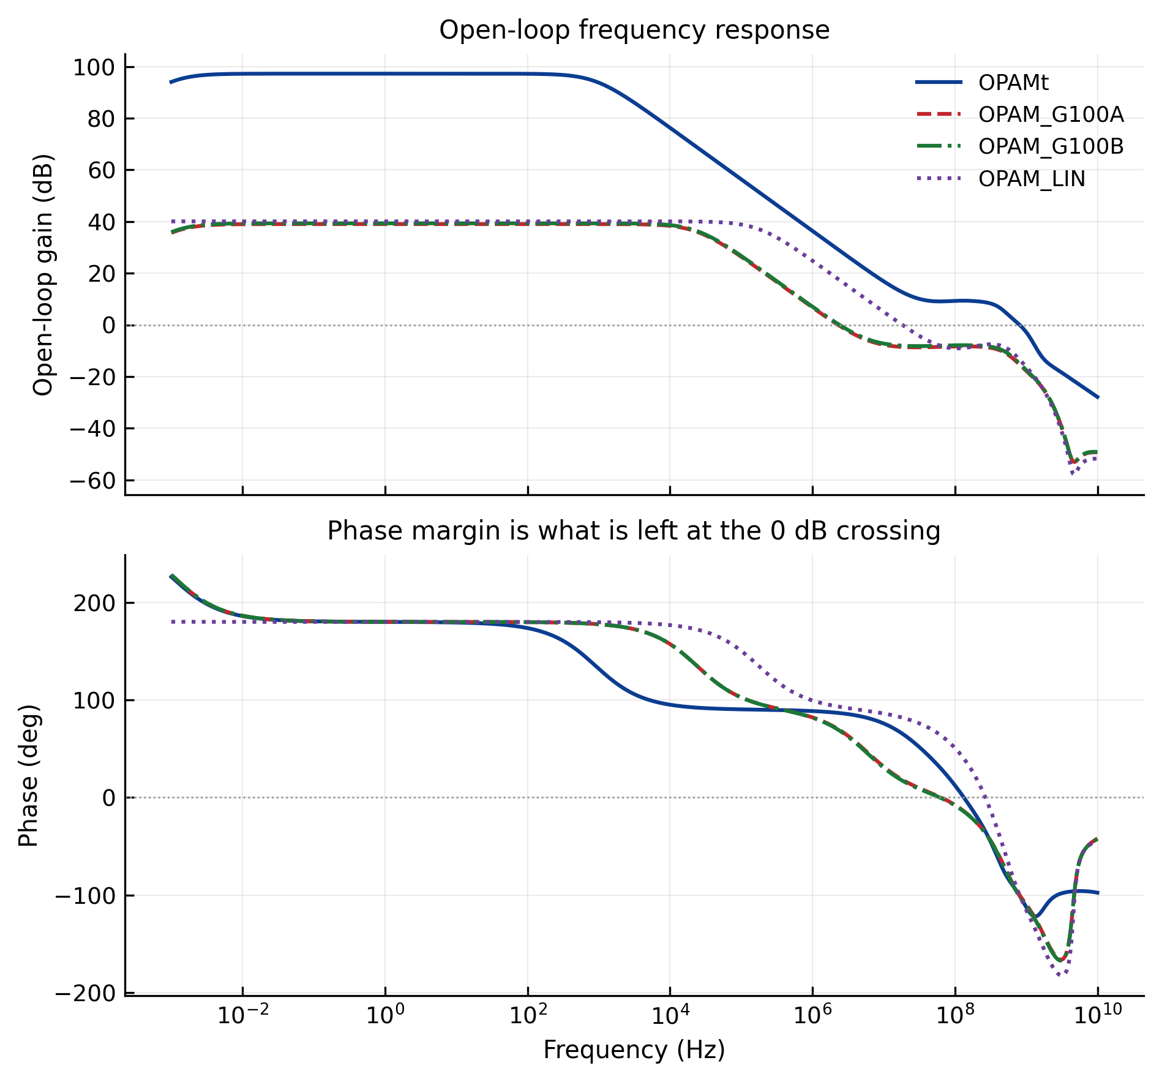
FINAL/XSCHEM/TEST/simulation/test_opam_g100_ac.sch/bode.png
