AnBuiUCI/sscs-2026-zotnetic/FINAL/XSCHEM/TEST/simulation/test_opam_g100_dc.sch/power.png

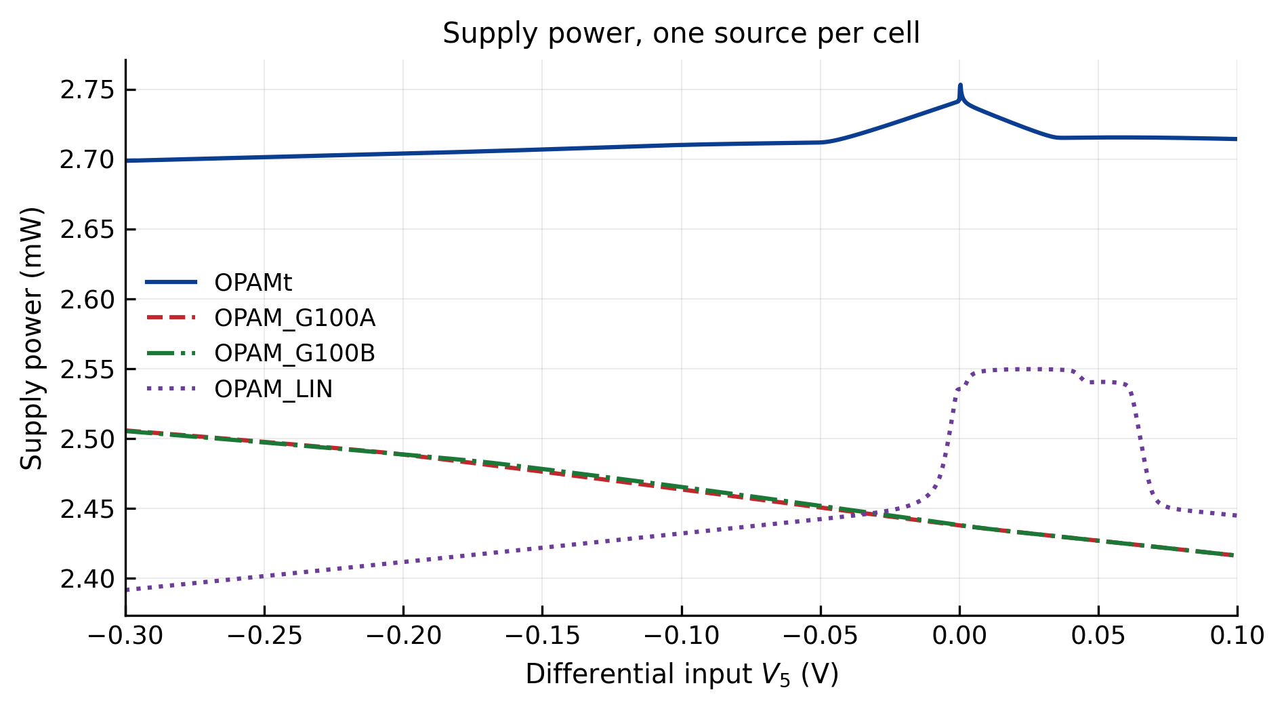
FINAL/XSCHEM/TEST/simulation/test_opam_g100_dc.sch/power.png
