AnBuiUCI/sscs-2026-zotnetic/FINAL/XSCHEM/TEST/simulation/test_weight.sch_pre/signals.png

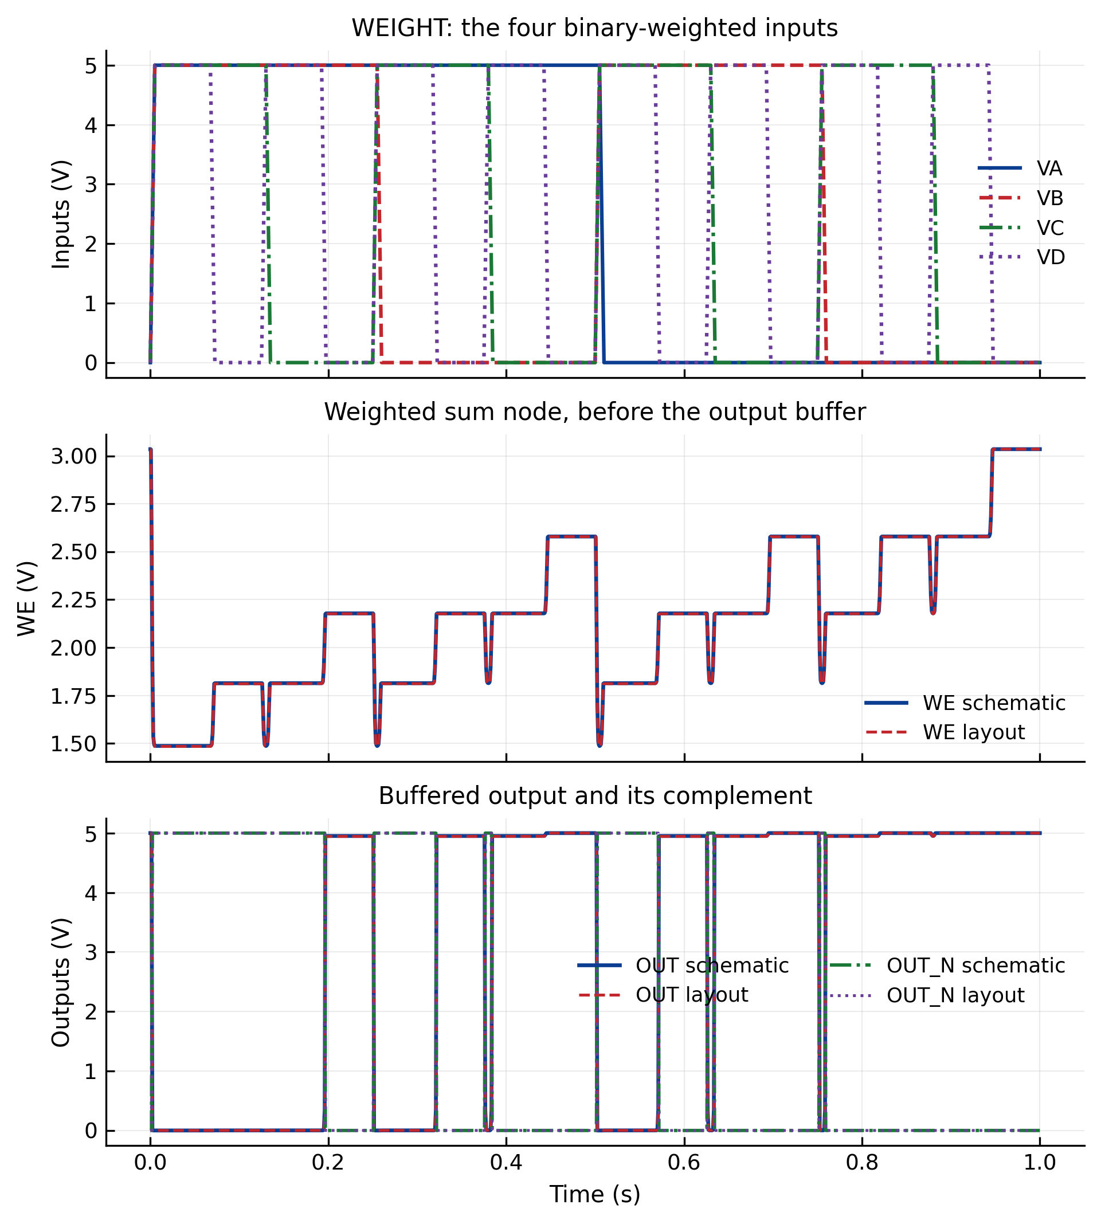
FINAL/XSCHEM/TEST/simulation/test_weight.sch_pre/signals.png
