AnBuiUCI/sscs-2026-zotnetic/FINAL/XSCHEM/TEST_TOTAL/doc/figuras/amplificadores_ancho.png

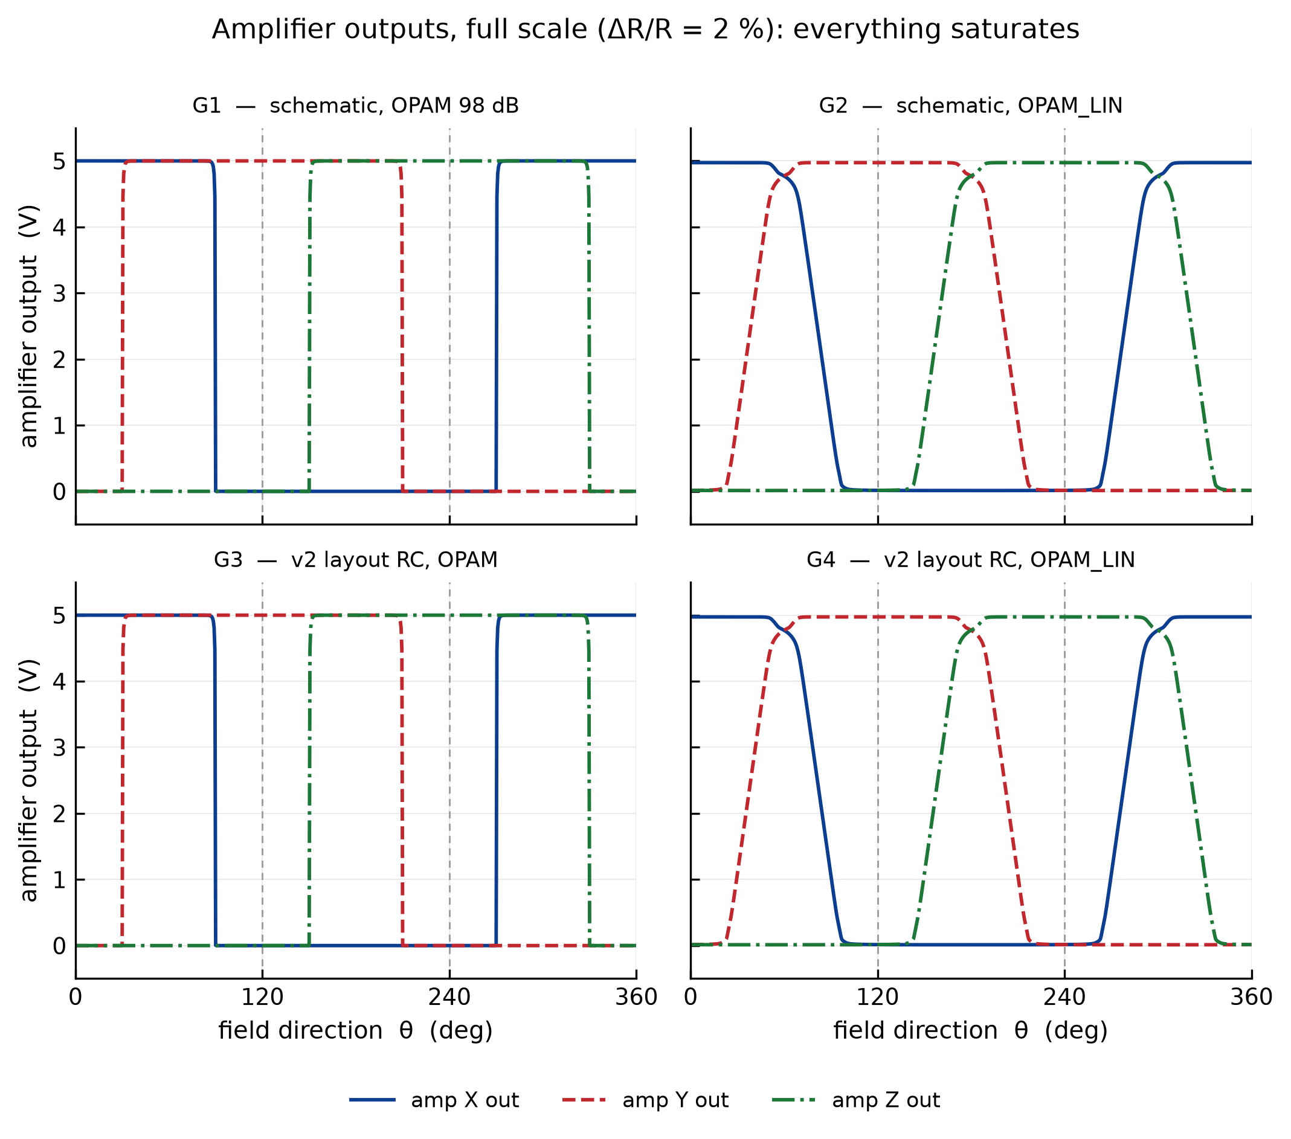
FINAL/XSCHEM/TEST_TOTAL/doc/figuras/amplificadores_ancho.png
