AnBuiUCI/sscs-2026-zotnetic/FINAL/XSCHEM/TEST_TOTAL/doc/figuras/error_sectores.png

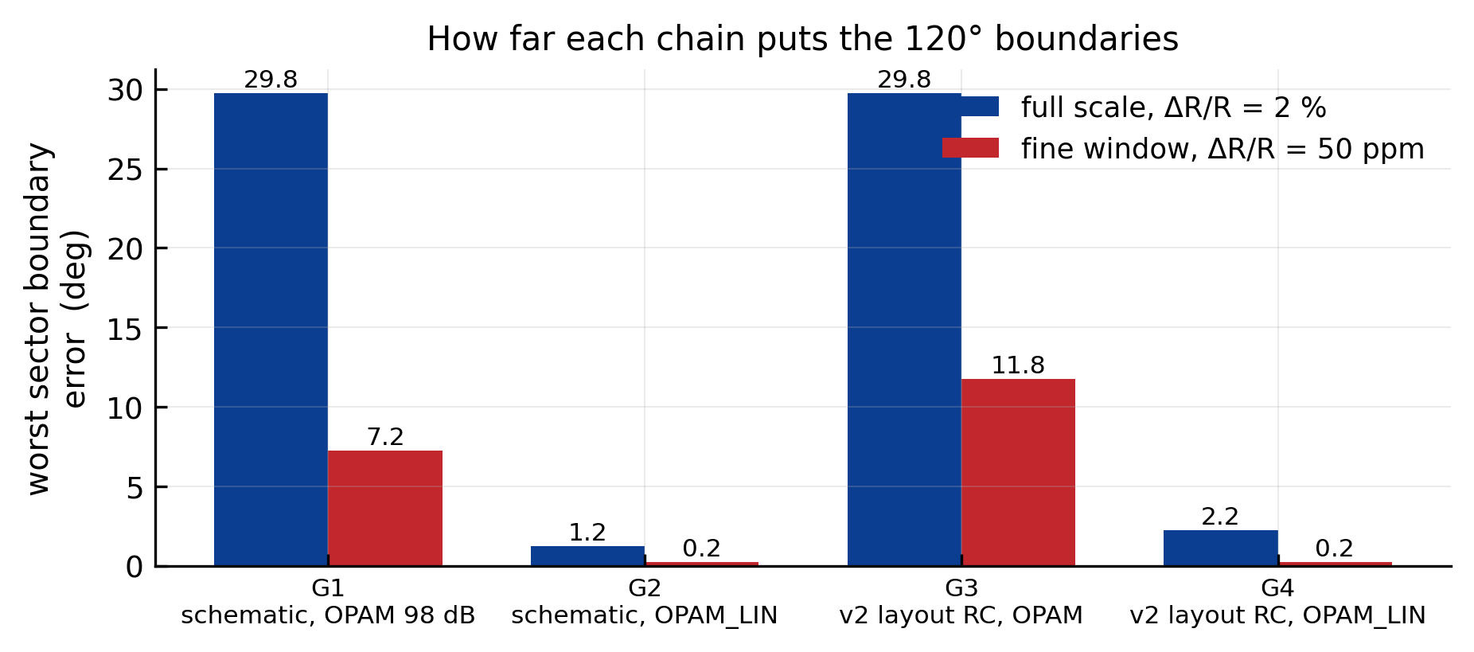
FINAL/XSCHEM/TEST_TOTAL/doc/figuras/error_sectores.png
