AnBuiUCI/sscs-2026-zotnetic/FINAL/XSCHEM/TEST_TOTAL/doc_caja/figuras/bloque1.png

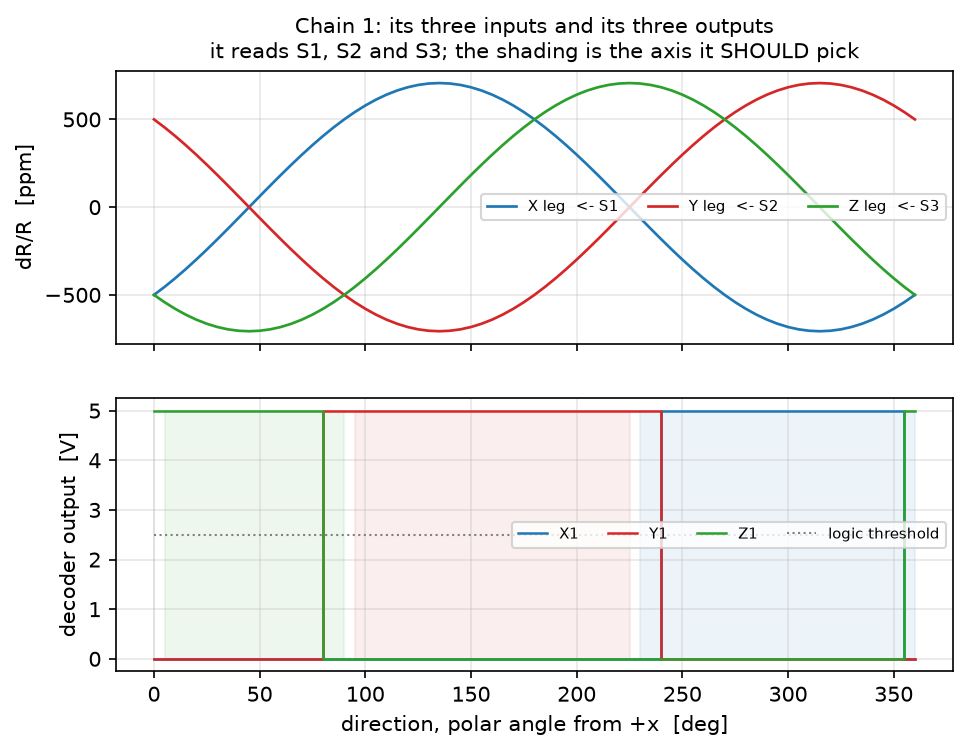
FINAL/XSCHEM/TEST_TOTAL/doc_caja/figuras/bloque1.png
