AnBuiUCI/sscs-2026-zotnetic/FINAL/XSCHEM/TEST_TOTAL/doc_caja/figuras/bloque2.png

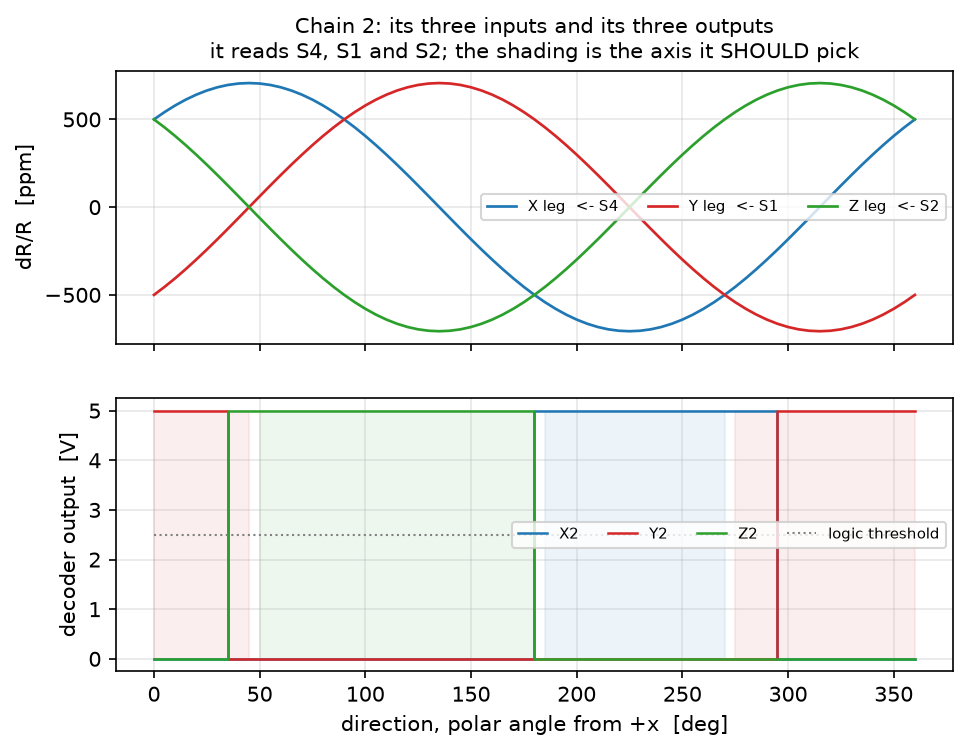
FINAL/XSCHEM/TEST_TOTAL/doc_caja/figuras/bloque2.png
