AnBuiUCI/sscs-2026-zotnetic/FINAL/XSCHEM/TEST_TOTAL/doc_caja/figuras/fuente_apunta.png

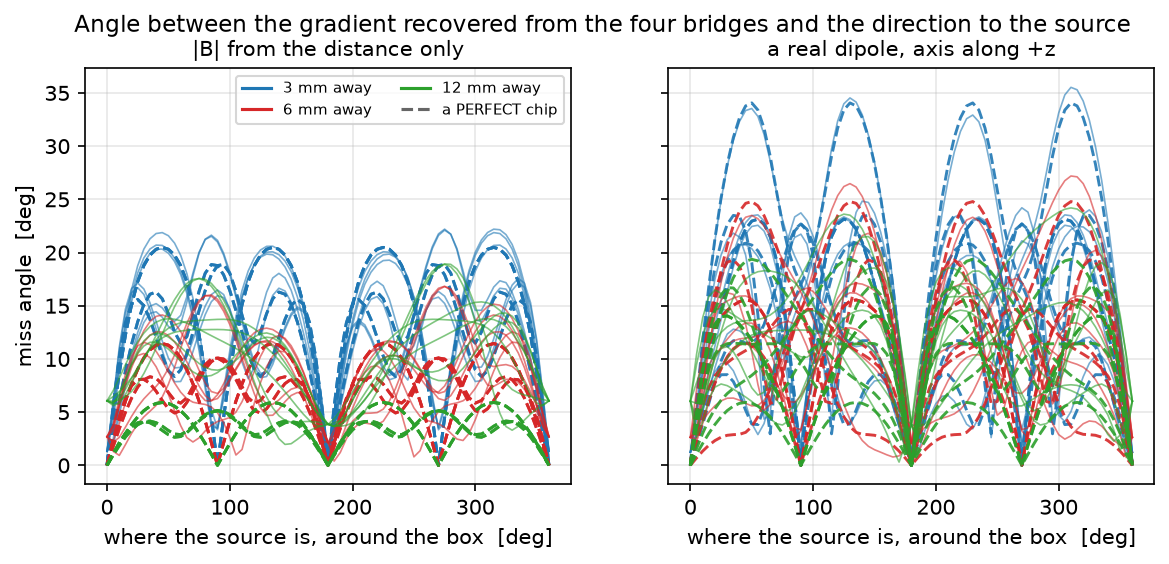
FINAL/XSCHEM/TEST_TOTAL/doc_caja/figuras/fuente_apunta.png
