AnBuiUCI/sscs-2026-zotnetic/FINAL/XSCHEM/TEST_TOTAL/doc_caja/figuras/sensores.png

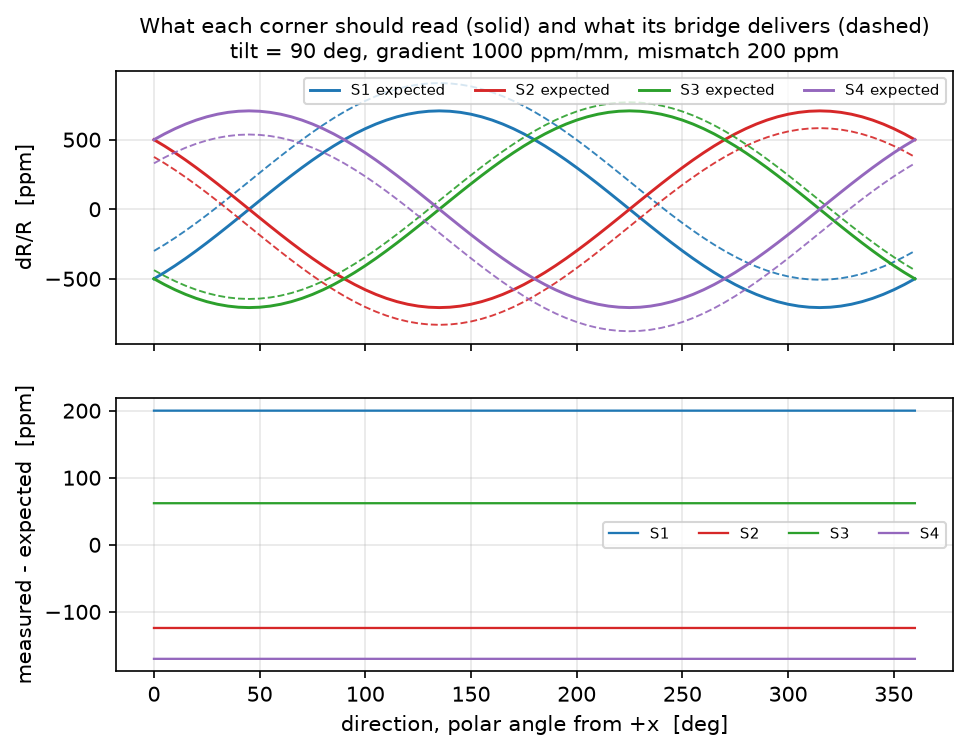
FINAL/XSCHEM/TEST_TOTAL/doc_caja/figuras/sensores.png
