AnBuiUCI/sscs-2026-zotnetic/FINAL/XSCHEM/TEST_TOTAL/doc_geo/figuras/campo_salidas_3000x500.png

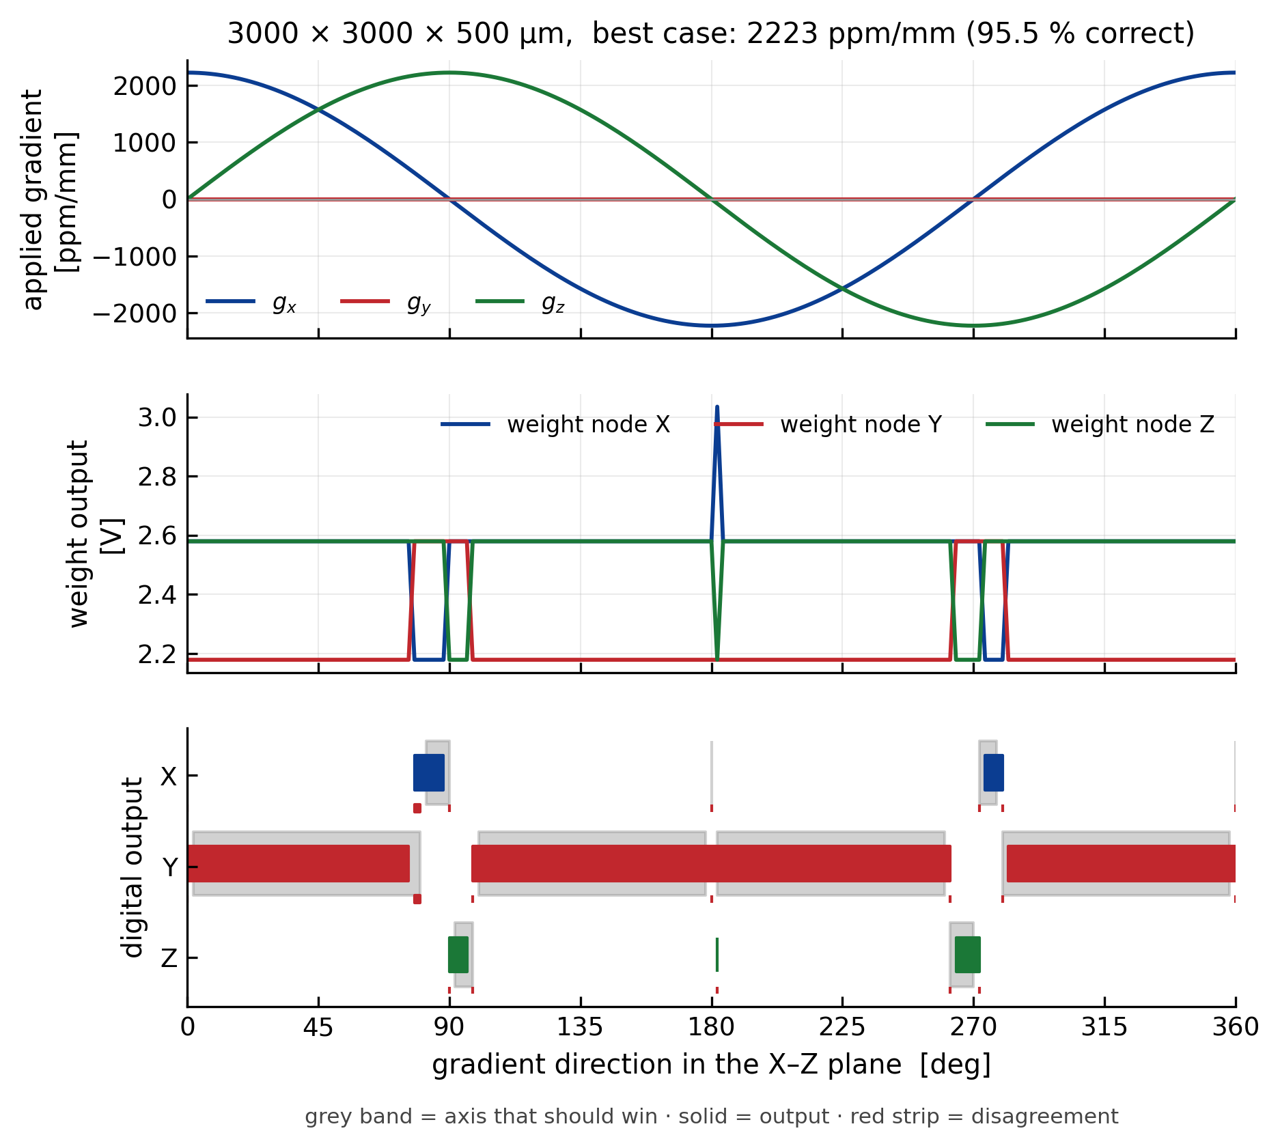
FINAL/XSCHEM/TEST_TOTAL/doc_geo/figuras/campo_salidas_3000x500.png
