AnBuiUCI/sscs-2026-zotnetic/FINAL/XSCHEM/TEST_TOTAL/doc_geo/figuras/sentido_1000x1000.png

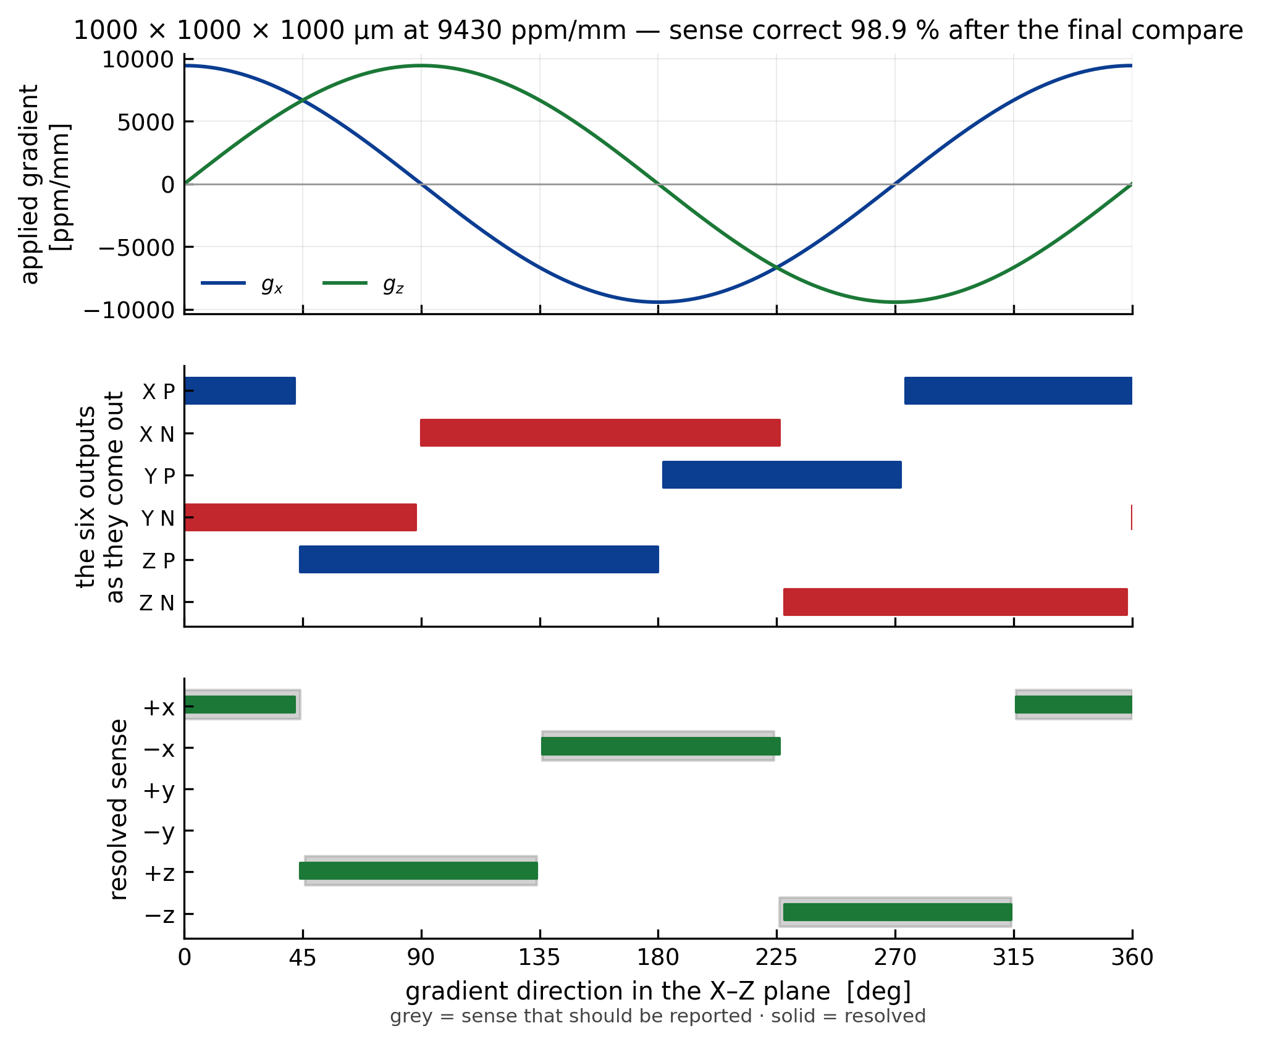
FINAL/XSCHEM/TEST_TOTAL/doc_geo/figuras/sentido_1000x1000.png
