AnBuiUCI/sscs-2026-zotnetic/FINAL/XSCHEM/TEST_TOTAL/doc_top/figuras/estimulo.png

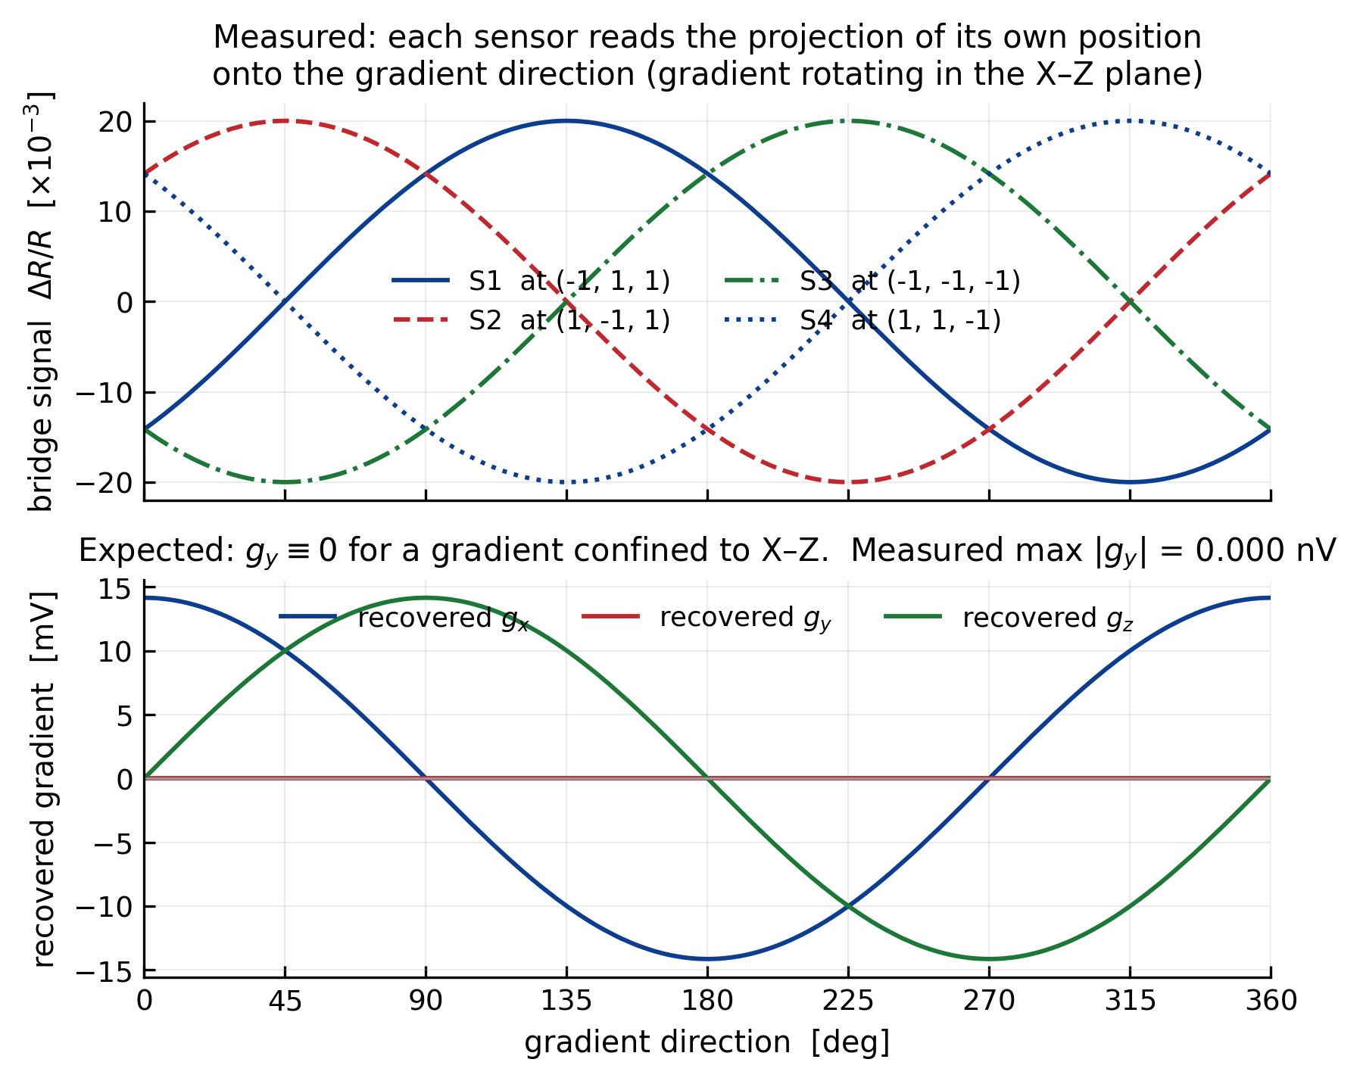
FINAL/XSCHEM/TEST_TOTAL/doc_top/figuras/estimulo.png
