AnBuiUCI/sscs-2026-zotnetic/FINAL/openroad/work_lvs/GRADIENT_NAV2_V3_extracted_ordered.spice

* NGSPICE file created from GRADIENT_NAV2_V3.ext - technology: gf180mcuD

.subckt GRADIENT_NAV2_V3 VDD VSS XP X XN YP Y YN ZP Z ZN S2P S2N S4P S4N S3P S3N S1P S1N
X0 a_55330_28838# a_55130_28794# VSS VSS nfet_06v0 ad=1.25p pd=5.5u as=2.2p ps=10.88u w=5u l=1u
X1 a_42790_49723# a_34818_54123# VDD VDD pfet_06v0 ad=2.6p pd=10.52u as=4.4p ps=20.88u w=10u l=1u
X2 a_19390_53193# a_2294_53077# VDD VDD pfet_06v0 ad=2.5p pd=10.5u as=4.4p ps=20.88u w=10u l=1u
X3 VDD VSS VDD VDD pfet_06v0 ad=0.44p pd=2.88u as=1.86749n ps=8.9035m w=1u l=2u
X4 a_25154_28838# a_24954_28794# a_24854_28838# VSS nfet_06v0 ad=2.2p pd=10.88u as=1.25p ps=5.5u w=5u l=1u
X5 a_70694_35696# a_69382_35580# VDD VDD pfet_06v0 ad=2.5p pd=10.5u as=4.4p ps=20.88u w=10u l=1u
X6 a_62366_58305# a_48510_63573# a_63566_62889# VSS nfet_06v0 ad=2.2p pd=10.88u as=1.25p ps=5.5u w=5u l=1u
X7 VDD VSS VDD VDD pfet_06v0 ad=7.92p pd=36.88u as=0 ps=0 w=18u l=2u
X8 a_72054_51200# a_72142_51084# Y VSS nfet_06v0 ad=1.0912p pd=5.84u as=0.6448p ps=3u w=2.48u l=1u
X9 VSS a_72314_66956# a_72142_51084# VSS nfet_06v0 ad=0.44p pd=2.88u as=0.44p ps=2.88u w=1u l=1u
X10 a_34818_58419# a_25666_58305# a_31030_62819# VDD pfet_06v0 ad=1.3p pd=5.52u as=2.2p ps=10.88u w=5u l=1u
X11 a_72338_24088# a_73430_16930# VDD VDD pfet_06v0 ad=2.2p pd=10.88u as=2.2p ps=10.88u w=5u l=1u
X12 a_41226_45413# a_25326_46213# a_41426_45529# VSS nfet_06v0 ad=1.65p pd=5.66u as=1.25p ps=5.5u w=5u l=1u
X13 a_31030_49723# a_25666_53077# a_34818_54123# VDD pfet_06v0 ad=2.2p pd=10.88u as=1.3p ps=5.52u w=5u l=1u
X14 a_49938_24088# a_51030_16930# VDD VDD pfet_06v0 ad=2.2p pd=10.88u as=2.2p ps=10.88u w=5u l=1u
X15 a_69542_24788# a_69342_24672# VSS VSS nfet_06v0 ad=1.25p pd=5.5u as=2.2p ps=10.88u w=5u l=1u
X16 a_4718_16930# a_5794_25172# VSS VSS nfet_06v0 ad=0.825p pd=3.16u as=1.1p ps=5.88u w=2.5u l=1u
X17 a_9598_24788# a_2254_24672# VSS VSS nfet_06v0 ad=1.25p pd=5.5u as=2.2p ps=10.88u w=5u l=1u
X18 a_7758_66967# a_25568_33300# VDD VDD pfet_06v0 ad=0.44p pd=2.88u as=0.44p ps=2.88u w=1u l=1u
X19 a_76410_51130# Y VSS VSS nfet_06v0 ad=0.5p pd=2.5u as=0.88p ps=4.88u w=2u l=1u
X20 a_25666_58305# a_25666_58305# a_28322_63689# VSS nfet_06v0 ad=0.44p pd=2.88u as=0.25p ps=1.5u w=1u l=1u
X21 a_60222_4870# a_47282_11612# VSS VSS nfet_06v0 ad=0.25p pd=1.5u as=0.44p ps=2.88u w=1u l=1u
X22 a_2986_49609# a_2594_53077# a_3606_53193# VDD pfet_06v0 ad=4.4p pd=20.88u as=2.5p ps=10.5u w=10u l=1u
X23 a_8870_62775# a_3168_33300# VDD VDD pfet_06v0 ad=0.44p pd=2.88u as=0.44p ps=2.88u w=1u l=1u
X24 a_19718_62819# a_11746_58419# VDD VDD pfet_06v0 ad=4.4p pd=20.88u as=2.6p ps=10.52u w=10u l=1u
X25 VSS VDD VSS VSS nfet_06v0 ad=4.29p pd=20.38u as=1.23306n ps=6.04388m w=9.75u l=2u
X26 a_55770_53123# a_48510_49609# a_56438_49723# VSS nfet_06v0 ad=1.1p pd=5.88u as=0.65p ps=3.02u w=2.5u l=1u
X27 a_28742_16930# a_24994_16886# a_27650_24088# VDD pfet_06v0 ad=4.4p pd=20.88u as=4.4p ps=20.88u w=10u l=1u
X28 a_75022_28794# a_75022_28794# a_77530_28794# VSS nfet_06v0 ad=2.2p pd=10.88u as=1.65p ps=5.66u w=5u l=1u
X29 a_31470_70483# a_33254_67083# VSS VSS nfet_06v0 ad=0.65p pd=3.02u as=0.65p ps=3.02u w=2.5u l=1u
X30 a_5530_37596# a_5794_28794# VSS VSS nfet_06v0 ad=0.825p pd=3.16u as=1.1p ps=5.88u w=2.5u l=1u
X31 a_49242_49609# a_48850_53077# a_49862_53193# VDD pfet_06v0 ad=4.4p pd=20.88u as=2.5p ps=10.5u w=10u l=1u
X32 a_69582_16930# a_69382_16886# VDD VDD pfet_06v0 ad=2.5p pd=10.5u as=4.4p ps=20.88u w=10u l=1u
X33 VDD VSS VDD VDD pfet_06v0 ad=4.29p pd=20.38u as=0 ps=0 w=9.75u l=2u
X34 a_25194_11728# a_24994_11612# a_26006_11728# VDD pfet_06v0 ad=4.4p pd=20.88u as=2.5p ps=10.5u w=10u l=1u
X35 a_55770_70483# a_56438_67083# VSS VSS nfet_06v0 ad=0.65p pd=3.02u as=0.65p ps=3.02u w=2.5u l=1u
X36 a_72882_4826# a_69642_4826# a_72618_13628# VSS nfet_06v0 ad=1.1p pd=5.88u as=0.825p ps=3.16u w=2.5u l=1u
X37 a_24894_11728# a_24694_11612# VDD VDD pfet_06v0 ad=2.5p pd=10.5u as=4.4p ps=20.88u w=10u l=1u
X38 a_33254_49723# a_39182_54077# a_33702_54123# VDD pfet_06v0 ad=2.2p pd=10.88u as=2.2p ps=10.88u w=5u l=1u
X39 a_32586_41059# a_33254_45959# VSS VSS nfet_06v0 ad=0.65p pd=3.02u as=1.1p ps=5.88u w=2.5u l=1u
X40 a_48750_58349# a_48550_58305# VDD VDD pfet_06v0 ad=2.5p pd=10.5u as=4.4p ps=20.88u w=10u l=1u
X41 VSS a_56438_67083# a_54654_70483# VSS nfet_06v0 ad=0.65p pd=3.02u as=0.65p ps=3.02u w=2.5u l=1u
X42 a_72104_61958# a_72104_61958# a_74368_62110# VSS nfet_06v0 ad=0.308p pd=2.28u as=0.175p ps=1.2u w=0.7u l=1u
X43 a_76686_24788# a_69342_24672# VSS VSS nfet_06v0 ad=1.25p pd=5.5u as=2.2p ps=10.88u w=5u l=1u
X44 VDD a_33702_58419# a_32142_62819# VDD pfet_06v0 ad=1.3p pd=5.52u as=1.3p ps=5.52u w=5u l=1u
X45 a_25366_58305# a_25666_58305# a_27290_63689# VSS nfet_06v0 ad=0.44p pd=2.88u as=0.25p ps=1.5u w=1u l=1u
X46 VSS VDD VSS VSS nfet_06v0 ad=7.92p pd=36.88u as=0 ps=0 w=18u l=2u
X47 a_54286_24788# a_46942_24672# VSS VSS nfet_06v0 ad=1.25p pd=5.5u as=2.2p ps=10.88u w=5u l=1u
X48 a_3168_19326# a_18586_19776# VSS ppolyf_u_1k r_width=1u r_length=76.45u
X49 a_32142_49723# a_33702_54123# VDD VDD pfet_06v0 ad=1.3p pd=5.52u as=1.3p ps=5.52u w=5u l=1u
X50 a_57550_63319# a_62366_58305# a_58002_58419# VDD pfet_06v0 ad=2.2p pd=10.88u as=2.2p ps=10.88u w=5u l=1u
X51 a_32142_67083# a_33702_71483# VDD VDD pfet_06v0 ad=1.3p pd=5.52u as=2.2p ps=10.88u w=5u l=1u
X52 a_24654_28794# a_24994_35580# a_40542_35696# VDD pfet_06v0 ad=4.4p pd=20.88u as=2.5p ps=10.5u w=10u l=1u
X53 a_53210_40989# a_7758_45415# a_55770_41059# VDD pfet_06v0 ad=4.4p pd=20.88u as=2.6p ps=10.52u w=10u l=1u
X54 a_7934_4826# a_7934_4826# a_10442_4826# VSS nfet_06v0 ad=2.2p pd=10.88u as=1.65p ps=5.66u w=5u l=1u
X55 VDD a_56886_54123# a_54214_49723# VDD pfet_06v0 ad=1.3p pd=5.52u as=1.3p ps=5.52u w=5u l=1u
X56 VDD a_56886_58419# a_55326_62819# VDD pfet_06v0 ad=2.2p pd=10.88u as=1.3p ps=5.52u w=5u l=1u
X57 a_72618_37596# a_72882_28794# VSS VSS nfet_06v0 ad=0.825p pd=3.16u as=1.1p ps=5.88u w=2.5u l=1u
X58 a_3168_10682# a_7758_45415# VSS ppolyf_u_1k r_width=1u r_length=76.45u
X59 a_50218_37596# a_50482_28794# VSS VSS nfet_06v0 ad=0.825p pd=3.16u as=1.1p ps=5.88u w=2.5u l=1u
X60 a_52550_49653# a_49242_49609# VSS VSS nfet_06v0 ad=1.25p pd=5.5u as=2.2p ps=10.88u w=5u l=1u
X61 VDD VSS VDD VDD pfet_06v0 ad=0.44p pd=2.88u as=0 ps=0 w=1u l=2u
X62 a_42790_67083# a_34366_67083# VSS VSS nfet_06v0 ad=1.3p pd=5.52u as=2.2p ps=10.88u w=5u l=1u
X63 VSS a_19718_49723# a_88406_49640# VSS nfet_06v0 ad=0.44p pd=2.88u as=0.25p ps=1.5u w=1u l=1u
X64 a_9070_49723# a_2594_53077# a_10630_54123# VDD pfet_06v0 ad=2.2p pd=10.88u as=1.3p ps=5.52u w=5u l=1u
X65 a_70256_19326# a_85674_19776# VSS ppolyf_u_1k r_width=1u r_length=76.45u
X66 a_65646_58349# a_48550_58305# VDD VDD pfet_06v0 ad=2.5p pd=10.5u as=4.4p ps=20.88u w=10u l=1u
X67 a_30334_28794# a_24994_35580# a_35070_35696# VDD pfet_06v0 ad=4.4p pd=20.88u as=2.5p ps=10.5u w=10u l=1u
X68 a_33254_67083# a_25326_66969# a_32586_70483# VSS nfet_06v0 ad=0.65p pd=3.02u as=1.1p ps=5.88u w=2.5u l=1u
X69 a_69882_11728# a_69682_11612# a_70694_11728# VDD pfet_06v0 ad=4.4p pd=20.88u as=2.5p ps=10.5u w=10u l=1u
X70 a_2594_16886# a_2594_16886# a_15534_25588# VSS nfet_06v0 ad=0.44p pd=2.88u as=0.25p ps=1.5u w=1u l=1u
X71 a_72314_66956# a_65974_67083# VDD VDD pfet_06v0 ad=0.99p pd=3.66u as=1.32p ps=6.88u w=3u l=1u
X72 a_7758_62775# a_49206_24288# cap_mim_2f0_m4m5_noshield c_width=25u c_length=8u
X73 a_73254_51084# a_84634_49596# VDD VDD pfet_06v0 ad=1.32p pd=6.88u as=1.32p ps=6.88u w=3u l=1u
X74 a_24954_24672# a_24994_16886# a_39430_16930# VDD pfet_06v0 ad=4.4p pd=20.88u as=2.5p ps=10.5u w=10u l=1u
X75 a_8398_58419# a_10182_63319# VSS VSS nfet_06v0 ad=0.65p pd=3.02u as=0.65p ps=3.02u w=2.5u l=1u
X76 a_29998_67013# a_25326_66969# a_29666_67013# VSS nfet_06v0 ad=1.25p pd=5.5u as=1.65p ps=5.66u w=5u l=1u
X77 a_70256_10682# a_7758_49607# VSS ppolyf_u_1k r_width=1u r_length=76.45u
X78 a_2554_24672# a_2594_16886# a_17030_16930# VDD pfet_06v0 ad=4.4p pd=20.88u as=2.5p ps=10.5u w=10u l=1u
X79 a_54214_67083# a_48850_70437# a_58002_71483# VDD pfet_06v0 ad=2.2p pd=10.88u as=1.3p ps=5.52u w=5u l=1u
X80 a_4218_46329# a_2594_40945# VSS VSS nfet_06v0 ad=0.25p pd=1.5u as=0.44p ps=2.88u w=1u l=1u
X81 a_26058_62773# a_25326_63573# a_26258_62889# VSS nfet_06v0 ad=2.2p pd=10.88u as=1.25p ps=5.5u w=5u l=1u
X82 a_24694_11612# a_24994_11612# a_36902_4870# VSS nfet_06v0 ad=0.44p pd=2.88u as=0.25p ps=1.5u w=1u l=1u
X83 a_85566_60230# a_83814_60230# a_84634_60114# VSS nfet_06v0 ad=0.25p pd=1.5u as=0.44p ps=2.88u w=1u l=1u
X84 a_78314_35696# a_78114_35580# VDD VDD pfet_06v0 ad=2.5p pd=10.5u as=4.4p ps=20.88u w=10u l=1u
X85 VSS a_87474_49596# a_73254_43142# VSS nfet_06v0 ad=0.44p pd=2.88u as=0.44p ps=2.88u w=1u l=1u
X86 ZN a_75388_58336# VSS VSS nfet_05v0 ad=0.5808p pd=3.52u as=0.5808p ps=3.52u w=1.32u l=0.6u
X87 VSS VDD VSS VSS nfet_06v0 ad=0.44p pd=2.88u as=0 ps=0 w=1u l=2u
X88 a_9598_4870# a_2254_4826# VSS VSS nfet_06v0 ad=1.25p pd=5.5u as=2.2p ps=10.88u w=5u l=1u
X89 a_52622_25272# a_52622_25272# a_55130_24672# VSS nfet_06v0 ad=2.2p pd=10.88u as=1.65p ps=5.66u w=5u l=1u
X90 a_69642_28794# a_69682_35580# a_84118_35696# VDD pfet_06v0 ad=4.4p pd=20.88u as=2.5p ps=10.5u w=10u l=1u
X91 a_11746_71483# a_2594_70437# a_7958_67083# VDD pfet_06v0 ad=1.3p pd=5.52u as=2.2p ps=10.88u w=5u l=1u
X92 VDD a_58002_41059# a_65974_45459# VDD pfet_06v0 ad=2.6p pd=10.52u as=2.6p ps=10.52u w=10u l=1u
X93 a_48750_40989# a_48550_40945# VDD VDD pfet_06v0 ad=2.5p pd=10.5u as=4.4p ps=20.88u w=10u l=1u
X94 a_25566_53193# a_25366_53077# VDD VDD pfet_06v0 ad=2.5p pd=10.5u as=4.4p ps=20.88u w=10u l=1u
X95 a_25366_58305# a_25666_58305# a_28602_58349# VDD pfet_06v0 ad=4.4p pd=20.88u as=2.5p ps=10.5u w=10u l=1u
X96 a_8398_58419# a_7758_62775# a_6954_58349# VDD pfet_06v0 ad=2.6p pd=10.52u as=4.4p ps=20.88u w=10u l=1u
X97 VDD VSS VDD VDD pfet_06v0 ad=0.44p pd=2.88u as=0 ps=0 w=1u l=2u
X98 VDD a_10630_58419# a_7958_62819# VDD pfet_06v0 ad=1.3p pd=5.52u as=1.3p ps=5.52u w=5u l=1u
X99 a_4218_49653# a_2594_53077# VSS VSS nfet_06v0 ad=0.25p pd=1.5u as=0.44p ps=2.88u w=1u l=1u
X100 a_55326_62819# a_56886_58419# VDD VDD pfet_06v0 ad=1.3p pd=5.52u as=2.2p ps=10.88u w=5u l=1u
X101 a_8870_66967# a_74490_28838# VSS VSS nfet_06v0 ad=0.44p pd=2.88u as=0.44p ps=2.88u w=1u l=1u
X102 a_73166_51200# a_73254_51084# Y VSS nfet_06v0 ad=1.0912p pd=5.84u as=0.6448p ps=3u w=2.48u l=1u
X103 a_57550_45959# a_62366_40945# a_58002_41059# VDD pfet_06v0 ad=2.2p pd=10.88u as=2.2p ps=10.88u w=5u l=1u
X104 VSS VDD VSS VSS nfet_06v0 ad=7.92p pd=36.88u as=0 ps=0 w=18u l=2u
X105 VDD VSS VDD VDD pfet_06v0 ad=4.29p pd=20.38u as=0 ps=0 w=9.75u l=2u
X106 a_82622_28838# a_69682_35580# VSS VSS nfet_06v0 ad=0.25p pd=1.5u as=0.44p ps=2.88u w=1u l=1u
X107 a_30830_66967# a_52090_28838# VSS VSS nfet_06v0 ad=0.44p pd=2.88u as=0.44p ps=2.88u w=1u l=1u
X108 a_42790_62819# a_34818_58419# VDD VDD pfet_06v0 ad=4.4p pd=20.88u as=2.6p ps=10.52u w=10u l=1u
X109 a_60222_28838# a_47282_35580# VSS VSS nfet_06v0 ad=0.25p pd=1.5u as=0.44p ps=2.88u w=1u l=1u
X110 a_31030_67083# a_30830_66967# a_29666_67013# VSS nfet_06v0 ad=1.3p pd=5.52u as=2.2p ps=10.88u w=5u l=1u
X111 a_6654_70553# a_2294_70437# VDD VDD pfet_06v0 ad=2.5p pd=10.5u as=4.4p ps=20.88u w=10u l=1u
X112 a_54654_53123# a_48510_49609# a_57550_49723# VSS nfet_06v0 ad=1.1p pd=5.88u as=0.65p ps=3.02u w=2.5u l=1u
X113 a_2794_35696# a_2594_35580# a_3606_35696# VDD pfet_06v0 ad=4.4p pd=20.88u as=2.5p ps=10.5u w=10u l=1u
X114 a_3606_58349# a_2294_58305# VDD VDD pfet_06v0 ad=2.5p pd=10.5u as=4.4p ps=20.88u w=10u l=1u
X115 a_65646_40989# a_48550_40945# VDD VDD pfet_06v0 ad=2.5p pd=10.5u as=4.4p ps=20.88u w=10u l=1u
X116 VSS a_10182_45959# a_8398_41059# VSS nfet_06v0 ad=1.1p pd=5.88u as=0.65p ps=3.02u w=2.5u l=1u
X117 a_9514_41059# a_8870_45415# a_6954_40989# VDD pfet_06v0 ad=2.6p pd=10.52u as=4.4p ps=20.88u w=10u l=1u
X118 a_81590_28838# a_69682_35580# VSS VSS nfet_06v0 ad=0.25p pd=1.5u as=0.44p ps=2.88u w=1u l=1u
X119 a_48294_16930# a_46982_16886# VDD VDD pfet_06v0 ad=2.5p pd=10.5u as=4.4p ps=20.88u w=10u l=1u
X120 VSS VDD VSS VSS nfet_06v0 ad=0.44p pd=2.88u as=0 ps=0 w=1u l=2u
X121 a_86922_40946# a_65974_45459# a_77242_60502# VDD pfet_06v0 ad=0.75p pd=3.5u as=1.32p ps=6.88u w=3u l=1u
X122 a_18354_49653# a_18154_49609# VSS VSS nfet_06v0 ad=1.25p pd=5.5u as=2.2p ps=10.88u w=5u l=1u
X123 VDD VSS VDD VDD pfet_06v0 ad=4.29p pd=20.38u as=0 ps=0 w=9.75u l=2u
X124 a_49862_58349# a_48550_58305# VDD VDD pfet_06v0 ad=2.5p pd=10.5u as=4.4p ps=20.88u w=10u l=1u
X125 a_5794_25172# a_2554_24672# a_5530_16930# VSS nfet_06v0 ad=1.1p pd=5.88u as=0.825p ps=3.16u w=2.5u l=1u
X126 a_19718_49723# a_11294_49723# VSS VSS nfet_06v0 ad=1.3p pd=5.52u as=2.2p ps=10.88u w=5u l=1u
X127 a_6342_11728# a_2594_11612# a_5250_4870# VDD pfet_06v0 ad=4.4p pd=20.88u as=4.4p ps=20.88u w=10u l=1u
X128 VDD VSS VDD VDD pfet_06v0 ad=0.44p pd=2.88u as=0 ps=0 w=1u l=2u
X129 a_72618_13628# a_72882_4826# VSS VSS nfet_06v0 ad=0.825p pd=3.16u as=1.1p ps=5.88u w=2.5u l=1u
X130 a_64610_49653# a_64410_49609# VSS VSS nfet_06v0 ad=1.25p pd=5.5u as=2.2p ps=10.88u w=5u l=1u
X131 a_65974_62819# a_57550_63319# VSS VSS nfet_06v0 ad=2.2p pd=10.88u as=1.3p ps=5.52u w=5u l=1u
X132 a_77242_60502# a_65974_45459# VSS VSS nfet_06v0 ad=0.33p pd=1.66u as=0.44p ps=2.88u w=1u l=1u
X133 a_7286_70553# a_2594_70437# a_6954_70553# VDD pfet_06v0 ad=2.5p pd=10.5u as=3.3p ps=10.66u w=10u l=1u
X134 a_78114_11612# a_69682_11612# a_78314_11728# VDD pfet_06v0 ad=3.3p pd=10.66u as=2.5p ps=10.5u w=10u l=1u
X135 a_12006_25588# a_7402_25288# VSS VSS nfet_06v0 ad=0.44p pd=2.88u as=0.44p ps=2.88u w=1u l=1u
X136 a_55714_11612# a_47282_11612# a_55914_11728# VDD pfet_06v0 ad=3.3p pd=10.66u as=2.5p ps=10.5u w=10u l=1u
X137 VDD a_10630_41059# a_7958_45459# VDD pfet_06v0 ad=2.2p pd=10.88u as=1.3p ps=5.52u w=5u l=1u
X138 a_87154_16930# a_69382_16886# VDD VDD pfet_06v0 ad=2.5p pd=10.5u as=4.4p ps=20.88u w=10u l=1u
X139 a_25366_40945# a_25666_40945# a_28602_40989# VDD pfet_06v0 ad=4.4p pd=20.88u as=2.5p ps=10.5u w=10u l=1u
X140 Z Z VDD VDD pfet_06v0 ad=0.52p pd=2.52u as=0.88p ps=4.88u w=2u l=1u
X141 a_42790_45459# a_31030_45459# cap_mim_2f0_m4m5_noshield c_width=20u c_length=10u
X142 a_69342_4826# a_69642_4826# a_80558_4870# VSS nfet_06v0 ad=2.2p pd=10.88u as=1.25p ps=5.5u w=5u l=1u
X143 a_72882_25172# a_69642_24672# a_72618_16930# VSS nfet_06v0 ad=1.1p pd=5.88u as=0.825p ps=3.16u w=2.5u l=1u
X144 a_73430_11728# a_69682_11612# a_72338_4870# VDD pfet_06v0 ad=4.4p pd=20.88u as=4.4p ps=20.88u w=10u l=1u
X145 a_3486_24788# a_2254_24672# VSS VSS nfet_06v0 ad=1.25p pd=5.5u as=2.2p ps=10.88u w=5u l=1u
X146 VDD a_56886_41059# a_54214_45459# VDD pfet_06v0 ad=2.2p pd=10.88u as=1.3p ps=5.52u w=5u l=1u
X147 a_64754_16930# a_46982_16886# VDD VDD pfet_06v0 ad=2.5p pd=10.5u as=4.4p ps=20.88u w=10u l=1u
X148 a_27650_24088# a_28742_16930# VDD VDD pfet_06v0 ad=2.2p pd=10.88u as=2.2p ps=10.88u w=5u l=1u
X149 a_34366_67083# a_25326_66969# a_31470_70483# VSS nfet_06v0 ad=0.65p pd=3.02u as=1.1p ps=5.88u w=2.5u l=1u
X150 a_2594_35580# a_2594_35580# VDD VDD pfet_06v0 ad=0.88p pd=4.88u as=0.88p ps=4.88u w=2u l=1u
X151 a_51786_53193# a_48550_53077# VDD VDD pfet_06v0 ad=2.5p pd=10.5u as=4.4p ps=20.88u w=10u l=1u
X152 VSS a_26058_66969# a_29998_67013# VSS nfet_06v0 ad=2.2p pd=10.88u as=1.25p ps=5.5u w=5u l=1u
X153 a_9514_41059# a_2254_46213# a_10182_45959# VSS nfet_06v0 ad=1.1p pd=5.88u as=0.65p ps=3.02u w=2.5u l=1u
X154 a_75388_58336# Z VDD VDD pfet_05v0 ad=0.8052p pd=4.54u as=0.8052p ps=4.54u w=1.83u l=0.5u
X155 a_75010_43282# X X VSS nfet_06v0 ad=0.88p pd=4.88u as=0.52p ps=2.52u w=2u l=1u
X156 a_61902_49609# a_61902_49609# a_64410_49609# VSS nfet_06v0 ad=2.2p pd=10.88u as=1.65p ps=5.66u w=5u l=1u
X157 a_72338_28838# S2N a_69842_28838# VSS nfet_06v0 ad=3.74p pd=17.88u as=3.74p ps=17.88u w=8.5u l=1u
X158 a_34818_41059# a_25666_40945# a_31030_45459# VDD pfet_06v0 ad=1.3p pd=5.52u as=2.2p ps=10.88u w=5u l=1u
X159 a_69682_11612# a_69682_11612# a_82622_4870# VSS nfet_06v0 ad=0.44p pd=2.88u as=0.25p ps=1.5u w=1u l=1u
X160 a_2254_66969# a_2594_70437# a_2494_70553# VDD pfet_06v0 ad=4.4p pd=20.88u as=2.5p ps=10.5u w=10u l=1u
X161 a_9514_70483# a_10182_67083# VSS VSS nfet_06v0 ad=0.65p pd=3.02u as=1.1p ps=5.88u w=2.5u l=1u
X162 a_2254_24672# a_2594_16886# a_18142_16930# VDD pfet_06v0 ad=4.4p pd=20.88u as=2.5p ps=10.5u w=10u l=1u
X163 VSS VDD VSS VSS nfet_06v0 ad=7.92p pd=36.88u as=0 ps=0 w=18u l=2u
X164 a_35870_24788# a_24654_24672# VSS VSS nfet_06v0 ad=1.25p pd=5.5u as=2.2p ps=10.88u w=5u l=1u
X165 a_7758_62775# a_47856_21126# VDD VDD pfet_06v0 ad=0.44p pd=2.88u as=0.44p ps=2.88u w=1u l=1u
X166 VSS VDD VSS VSS nfet_06v0 ad=7.92p pd=36.88u as=0 ps=0 w=18u l=2u
X167 a_13470_24788# a_2254_24672# VSS VSS nfet_06v0 ad=1.25p pd=5.5u as=2.2p ps=10.88u w=5u l=1u
X168 a_70574_24788# a_69342_24672# VSS VSS nfet_06v0 ad=1.25p pd=5.5u as=2.2p ps=10.88u w=5u l=1u
X169 a_3606_40989# a_2294_40945# VDD VDD pfet_06v0 ad=2.5p pd=10.5u as=4.4p ps=20.88u w=10u l=1u
X170 a_16110_58305# a_2254_63573# a_17310_62889# VSS nfet_06v0 ad=2.2p pd=10.88u as=1.25p ps=5.5u w=5u l=1u
X171 a_6594_62889# a_2254_63573# a_6294_62889# VSS nfet_06v0 ad=1.65p pd=5.66u as=1.25p ps=5.5u w=5u l=1u
X172 VSS VDD VSS VSS nfet_06v0 ad=4.29p pd=20.38u as=0 ps=0 w=9.75u l=2u
X173 a_19718_45459# a_11746_41059# VDD VDD pfet_06v0 ad=4.4p pd=20.88u as=2.6p ps=10.52u w=10u l=1u
X174 a_70256_33300# a_69682_35580# a_71606_28838# VDD pfet_06v0 ad=4.4p pd=20.88u as=4.4p ps=20.88u w=10u l=1u
X175 VSS a_11294_67083# a_19718_67083# VSS nfet_06v0 ad=1.3p pd=5.52u as=1.3p ps=5.52u w=5u l=1u
X176 a_69542_28838# a_69342_28794# VSS VSS nfet_06v0 ad=1.25p pd=5.5u as=2.2p ps=10.88u w=5u l=1u
X177 a_49862_40989# a_48550_40945# VDD VDD pfet_06v0 ad=2.5p pd=10.5u as=4.4p ps=20.88u w=10u l=1u
X178 a_26678_53193# a_25366_53077# VDD VDD pfet_06v0 ad=2.5p pd=10.5u as=4.4p ps=20.88u w=10u l=1u
X179 a_27930_16930# a_28194_25172# VSS VSS nfet_06v0 ad=0.825p pd=3.16u as=1.1p ps=5.88u w=2.5u l=1u
X180 a_9598_28838# a_2254_28794# VSS VSS nfet_06v0 ad=1.25p pd=5.5u as=2.2p ps=10.88u w=5u l=1u
X181 a_75388_53540# Y VSS VSS nfet_05v0 ad=0.5808p pd=3.52u as=0.5808p ps=3.52u w=1.32u l=0.6u
X182 a_29802_28838# a_31790_36780# a_25568_33300# VDD pfet_06v0 ad=1.76p pd=8.88u as=1.76p ps=8.88u w=4u l=1u
X183 a_71806_13618# a_72882_4826# VSS VSS nfet_06v0 ad=0.825p pd=3.16u as=1.1p ps=5.88u w=2.5u l=1u
X184 VSS VDD VSS VSS nfet_06v0 ad=4.29p pd=20.38u as=0 ps=0 w=9.75u l=2u
X185 a_7402_28838# a_9390_36780# a_3168_33300# VDD pfet_06v0 ad=1.76p pd=8.88u as=1.76p ps=8.88u w=4u l=1u
X186 a_4518_4870# a_6342_11728# VDD VDD pfet_06v0 ad=2.2p pd=10.88u as=2.2p ps=10.88u w=5u l=1u
X187 VDD a_33702_41059# a_32142_45459# VDD pfet_06v0 ad=1.3p pd=5.52u as=1.3p ps=5.52u w=5u l=1u
X188 VSS VDD VSS VSS nfet_06v0 ad=4.29p pd=20.38u as=0 ps=0 w=9.75u l=2u
X189 a_26006_35696# a_24694_35580# VDD VDD pfet_06v0 ad=2.5p pd=10.5u as=4.4p ps=20.88u w=10u l=1u
X190 a_86922_58418# a_65974_62819# a_79086_60502# VDD pfet_06v0 ad=0.75p pd=3.5u as=1.32p ps=6.88u w=3u l=1u
X191 ZP ZN VDD VDD pfet_05v0 ad=0.8052p pd=4.54u as=0.8052p ps=4.54u w=1.83u l=0.5u
X192 VSS a_33254_67083# a_32586_70483# VSS nfet_06v0 ad=1.1p pd=5.88u as=0.65p ps=3.02u w=2.5u l=1u
X193 a_33042_24788# a_32842_24672# VSS VSS nfet_06v0 ad=1.25p pd=5.5u as=2.2p ps=10.88u w=5u l=1u
X194 a_32142_67083# a_8870_66967# a_29666_67013# VSS nfet_06v0 ad=1.3p pd=5.52u as=2.2p ps=10.88u w=5u l=1u
X195 a_11294_63319# a_2254_63573# a_8398_58419# VSS nfet_06v0 ad=0.65p pd=3.02u as=1.1p ps=5.88u w=2.5u l=1u
X196 a_73768_49992# a_72104_49876# VSS VSS nfet_06v0 ad=0.175p pd=1.2u as=0.308p ps=2.28u w=0.7u l=1u
X197 a_28322_67013# a_25666_70437# VSS VSS nfet_06v0 ad=0.25p pd=1.5u as=0.44p ps=2.88u w=1u l=1u
X198 a_10642_24788# a_10442_24672# VSS VSS nfet_06v0 ad=1.25p pd=5.5u as=2.2p ps=10.88u w=5u l=1u
X199 a_76686_28838# a_69342_28794# VSS VSS nfet_06v0 ad=1.25p pd=5.5u as=2.2p ps=10.88u w=5u l=1u
X200 VDD a_56886_41059# a_55326_45459# VDD pfet_06v0 ad=2.2p pd=10.88u as=1.3p ps=5.52u w=5u l=1u
X201 VSS a_56438_49723# a_55770_53123# VSS nfet_06v0 ad=0.65p pd=3.02u as=0.65p ps=3.02u w=2.5u l=1u
X202 a_72054_60546# a_72142_60502# Z VSS nfet_06v0 ad=1.0912p pd=5.84u as=0.6448p ps=3u w=2.48u l=1u
X203 a_6954_58349# a_2594_58305# a_6654_58349# VDD pfet_06v0 ad=3.3p pd=10.66u as=2.5p ps=10.5u w=10u l=1u
X204 a_38718_63273# a_38718_63273# a_41226_62773# VSS nfet_06v0 ad=2.2p pd=10.88u as=1.65p ps=5.66u w=5u l=1u
X205 VSS a_10182_67083# a_8398_70483# VSS nfet_06v0 ad=0.65p pd=3.02u as=0.65p ps=3.02u w=2.5u l=1u
X206 a_54286_28838# a_46942_28794# VSS VSS nfet_06v0 ad=1.25p pd=5.5u as=2.2p ps=10.88u w=5u l=1u
X207 a_41226_66969# a_25326_66969# a_41426_67013# VSS nfet_06v0 ad=1.65p pd=5.66u as=1.25p ps=5.5u w=5u l=1u
X208 a_2594_58305# a_2594_58305# VDD VDD pfet_06v0 ad=0.88p pd=4.88u as=0.88p ps=4.88u w=2u l=1u
X209 a_27650_4870# S3N a_25154_4870# VSS nfet_06v0 ad=3.74p pd=17.88u as=3.74p ps=17.88u w=8.5u l=1u
X210 a_75010_51200# Y Y VSS nfet_06v0 ad=0.88p pd=4.88u as=0.52p ps=2.52u w=2u l=1u
X211 a_32142_67083# a_25666_70437# a_33702_71483# VDD pfet_06v0 ad=2.2p pd=10.88u as=1.3p ps=5.52u w=5u l=1u
X212 a_71606_4870# a_73430_11728# VDD VDD pfet_06v0 ad=2.2p pd=10.88u as=2.2p ps=10.88u w=5u l=1u
X213 a_75388_40976# X VDD VDD pfet_05v0 ad=0.8052p pd=4.54u as=0.8052p ps=4.54u w=1.83u l=0.5u
X214 a_77242_43142# a_87474_42642# VDD VDD pfet_06v0 ad=1.32p pd=6.88u as=1.32p ps=6.88u w=3u l=1u
X215 a_53210_53193# a_12006_25588# a_54654_53123# VDD pfet_06v0 ad=4.4p pd=20.88u as=2.6p ps=10.52u w=10u l=1u
X216 a_49206_4870# a_51030_11728# VDD VDD pfet_06v0 ad=2.2p pd=10.88u as=2.2p ps=10.88u w=5u l=1u
X217 VDD Z Z VDD pfet_06v0 ad=0.88p pd=4.88u as=0.52p ps=2.52u w=2u l=1u
X218 VDD VSS VDD VDD pfet_06v0 ad=7.92p pd=36.88u as=0 ps=0 w=18u l=2u
X219 VDD a_48550_53077# a_53542_53193# VDD pfet_06v0 ad=4.4p pd=20.88u as=2.5p ps=10.5u w=10u l=1u
X220 a_27290_67013# a_25666_70437# VSS VSS nfet_06v0 ad=0.25p pd=1.5u as=0.44p ps=2.88u w=1u l=1u
X221 a_85230_35696# a_69382_35580# VDD VDD pfet_06v0 ad=2.5p pd=10.5u as=4.4p ps=20.88u w=10u l=1u
X222 a_47856_9332# a_63274_9332# VSS ppolyf_u_1k r_width=1u r_length=76.45u
X223 a_30334_25272# a_30334_25272# a_32842_24672# VSS nfet_06v0 ad=2.2p pd=10.88u as=1.65p ps=5.66u w=5u l=1u
X224 X a_72142_43142# a_72054_43186# VSS nfet_06v0 ad=0.6448p pd=3u as=1.0912p ps=5.84u w=2.48u l=1u
X225 a_7934_25272# a_7934_25272# a_10442_24672# VSS nfet_06v0 ad=2.2p pd=10.88u as=1.65p ps=5.66u w=5u l=1u
X226 VSS a_84634_60114# a_79086_51084# VSS nfet_06v0 ad=0.44p pd=2.88u as=0.44p ps=2.88u w=1u l=1u
X227 VDD VSS VDD VDD pfet_06v0 ad=0.44p pd=2.88u as=0 ps=0 w=1u l=2u
X228 VSS VDD VSS VSS nfet_06v0 ad=0.44p pd=2.88u as=0 ps=0 w=1u l=2u
X229 VDD a_2294_58305# a_7286_58349# VDD pfet_06v0 ad=4.4p pd=20.88u as=2.5p ps=10.5u w=10u l=1u
X230 VSS a_42790_49723# a_73254_60502# VSS nfet_06v0 ad=0.44p pd=2.88u as=0.33p ps=1.66u w=1u l=1u
X231 VSS a_56438_63319# a_54654_58419# VSS nfet_06v0 ad=1.1p pd=5.88u as=0.65p ps=3.02u w=2.5u l=1u
X232 a_40818_58305# a_25666_58305# a_41018_58349# VDD pfet_06v0 ad=3.3p pd=10.66u as=2.5p ps=10.5u w=10u l=1u
X233 a_6954_70553# a_7758_66967# a_8398_70483# VDD pfet_06v0 ad=4.4p pd=20.88u as=2.6p ps=10.52u w=10u l=1u
X234 a_54078_12812# a_47242_4826# a_54286_4870# VSS nfet_06v0 ad=2.2p pd=10.88u as=1.25p ps=5.5u w=5u l=1u
X235 a_2294_53077# a_2594_53077# a_5530_53193# VDD pfet_06v0 ad=4.4p pd=20.88u as=2.5p ps=10.5u w=10u l=1u
X236 a_47142_24788# a_46942_24672# VSS VSS nfet_06v0 ad=1.25p pd=5.5u as=2.2p ps=10.88u w=5u l=1u
X237 a_32586_70483# a_33254_67083# VSS VSS nfet_06v0 ad=0.65p pd=3.02u as=1.1p ps=5.88u w=2.5u l=1u
X238 VDD a_33702_58419# a_31030_62819# VDD pfet_06v0 ad=2.2p pd=10.88u as=1.3p ps=5.52u w=5u l=1u
X239 VSS VDD VSS VSS nfet_06v0 ad=4.29p pd=20.38u as=0 ps=0 w=9.75u l=2u
X240 a_8398_41059# a_2254_46213# a_11294_45959# VSS nfet_06v0 ad=1.1p pd=5.88u as=0.65p ps=3.02u w=2.5u l=1u
X241 VDD a_10630_41059# a_7958_45459# VDD pfet_06v0 ad=1.3p pd=5.52u as=1.3p ps=5.52u w=5u l=1u
X242 a_8398_41059# a_7758_45415# a_6954_40989# VDD pfet_06v0 ad=2.6p pd=10.52u as=4.4p ps=20.88u w=10u l=1u
X243 a_2254_46213# a_2254_46213# VSS VSS nfet_06v0 ad=0.44p pd=2.88u as=0.44p ps=2.88u w=1u l=1u
X244 XP XN VDD VDD pfet_05v0 ad=0.8052p pd=4.54u as=0.8052p ps=4.54u w=1.83u l=0.5u
X245 a_55326_45459# a_56886_41059# VDD VDD pfet_06v0 ad=1.3p pd=5.52u as=2.2p ps=10.88u w=5u l=1u
X246 a_39430_11728# a_24694_11612# VDD VDD pfet_06v0 ad=2.5p pd=10.5u as=4.4p ps=20.88u w=10u l=1u
X247 a_15534_4870# a_2594_11612# VSS VSS nfet_06v0 ad=0.25p pd=1.5u as=0.44p ps=2.88u w=1u l=1u
X248 a_52622_28794# a_52622_28794# a_55130_28794# VSS nfet_06v0 ad=2.2p pd=10.88u as=1.65p ps=5.66u w=5u l=1u
X249 a_42790_45459# a_34818_41059# VDD VDD pfet_06v0 ad=4.4p pd=20.88u as=2.6p ps=10.52u w=10u l=1u
X250 a_49242_49609# a_48510_49609# a_49442_49653# VSS nfet_06v0 ad=2.2p pd=10.88u as=1.25p ps=5.5u w=5u l=1u
X251 a_47182_16930# a_46982_16886# VDD VDD pfet_06v0 ad=2.5p pd=10.5u as=4.4p ps=20.88u w=10u l=1u
X252 a_6954_40989# a_2594_40945# a_6654_40989# VDD pfet_06v0 ad=3.3p pd=10.66u as=2.5p ps=10.5u w=10u l=1u
X253 a_8870_45415# a_47856_9332# VDD VDD pfet_06v0 ad=0.44p pd=2.88u as=0.44p ps=2.88u w=1u l=1u
X254 a_6926_45529# a_2254_46213# a_6594_45529# VSS nfet_06v0 ad=1.25p pd=5.5u as=1.65p ps=5.66u w=5u l=1u
X255 a_29666_49653# a_25326_49609# a_29366_49653# VSS nfet_06v0 ad=1.65p pd=5.66u as=1.25p ps=5.5u w=5u l=1u
X256 a_31470_53123# a_12006_25588# a_30026_53193# VDD pfet_06v0 ad=2.6p pd=10.52u as=4.4p ps=20.88u w=10u l=1u
X257 a_40382_45529# a_26058_45413# VSS VSS nfet_06v0 ad=1.25p pd=5.5u as=2.2p ps=10.88u w=5u l=1u
X258 a_2594_40945# a_2594_40945# VDD VDD pfet_06v0 ad=0.88p pd=4.88u as=0.88p ps=4.88u w=2u l=1u
X259 a_52550_62889# a_49242_62773# VSS VSS nfet_06v0 ad=1.25p pd=5.5u as=2.2p ps=10.88u w=5u l=1u
X260 VDD VSS VDD VDD pfet_06v0 ad=4.29p pd=20.38u as=0 ps=0 w=9.75u l=2u
X261 a_28194_4826# a_24954_4826# a_27930_13628# VSS nfet_06v0 ad=1.1p pd=5.88u as=0.825p ps=3.16u w=2.5u l=1u
X262 a_5250_63689# a_2594_58305# VSS VSS nfet_06v0 ad=0.25p pd=1.5u as=0.44p ps=2.88u w=1u l=1u
X263 a_69842_4870# a_69642_4826# a_69542_4870# VSS nfet_06v0 ad=2.2p pd=10.88u as=1.25p ps=5.5u w=5u l=1u
X264 a_2254_49609# a_2254_49609# VSS VSS nfet_06v0 ad=0.44p pd=2.88u as=0.44p ps=2.88u w=1u l=1u
X265 a_47856_34650# a_63274_34200# VSS ppolyf_u_1k r_width=1u r_length=76.45u
X266 a_70256_9332# a_85674_9332# VSS ppolyf_u_1k r_width=1u r_length=76.45u
X267 a_25154_4870# a_24954_4826# a_24854_4870# VSS nfet_06v0 ad=2.2p pd=10.88u as=1.25p ps=5.5u w=5u l=1u
X268 Y Y VDD VDD pfet_06v0 ad=0.52p pd=2.52u as=0.52p ps=2.52u w=2u l=1u
X269 VDD VSS VDD VDD pfet_06v0 ad=0.44p pd=2.88u as=0 ps=0 w=1u l=2u
X270 a_72304_49992# a_72104_49876# VSS VSS nfet_06v0 ad=0.5456p pd=3.36u as=0.5456p ps=3.36u w=1.24u l=1u
X271 a_69342_4826# a_69682_11612# a_85230_11728# VDD pfet_06v0 ad=4.4p pd=20.88u as=2.5p ps=10.5u w=10u l=1u
X272 a_73430_35696# a_75022_28794# a_72882_28794# VSS nfet_06v0 ad=0.88p pd=4.88u as=0.88p ps=4.88u w=2u l=1u
X273 a_2454_4870# a_2254_4826# VSS VSS nfet_06v0 ad=1.25p pd=5.5u as=2.2p ps=10.88u w=5u l=1u
X274 a_79086_43142# a_87474_60114# VDD VDD pfet_06v0 ad=1.32p pd=6.88u as=1.32p ps=6.88u w=3u l=1u
X275 VDD a_2294_40945# a_7286_40989# VDD pfet_06v0 ad=4.4p pd=20.88u as=2.5p ps=10.5u w=10u l=1u
X276 a_30830_66967# a_47856_33300# VDD VDD pfet_06v0 ad=0.44p pd=2.88u as=0.44p ps=2.88u w=1u l=1u
X277 a_65974_67083# a_58002_71483# VDD VDD pfet_06v0 ad=2.6p pd=10.52u as=4.4p ps=20.88u w=10u l=1u
X278 a_42466_16930# a_24694_16886# VDD VDD pfet_06v0 ad=2.5p pd=10.5u as=4.4p ps=20.88u w=10u l=1u
X279 a_46982_11612# a_47282_11612# a_59190_4870# VSS nfet_06v0 ad=0.44p pd=2.88u as=0.25p ps=1.5u w=1u l=1u
X280 a_40818_40945# a_25666_40945# a_41018_40989# VDD pfet_06v0 ad=3.3p pd=10.66u as=2.5p ps=10.5u w=10u l=1u
X281 a_9514_53123# a_10182_49723# VSS VSS nfet_06v0 ad=0.65p pd=3.02u as=0.65p ps=3.02u w=2.5u l=1u
X282 a_65974_49723# a_58002_54123# VDD VDD pfet_06v0 ad=4.4p pd=20.88u as=2.6p ps=10.52u w=10u l=1u
X283 VDD VSS VDD VDD pfet_06v0 ad=7.92p pd=36.88u as=0 ps=0 w=18u l=2u
X284 a_7934_28794# a_2594_35580# a_12670_35696# VDD pfet_06v0 ad=4.4p pd=20.88u as=2.5p ps=10.5u w=10u l=1u
X285 VSS a_57550_49723# a_65974_49723# VSS nfet_06v0 ad=1.3p pd=5.52u as=1.3p ps=5.52u w=5u l=1u
X286 VSS a_75154_66956# a_72142_43142# VSS nfet_06v0 ad=0.44p pd=2.88u as=0.44p ps=2.88u w=1u l=1u
X287 a_52910_58349# a_48550_58305# VDD VDD pfet_06v0 ad=2.5p pd=10.5u as=4.4p ps=20.88u w=10u l=1u
X288 a_31030_62819# a_33702_58419# VDD VDD pfet_06v0 ad=1.3p pd=5.52u as=2.2p ps=10.88u w=5u l=1u
X289 a_73166_60546# a_73254_60502# Z VSS nfet_06v0 ad=1.0912p pd=5.84u as=0.6448p ps=3u w=2.48u l=1u
X290 a_4518_28838# S1P a_2754_28838# VSS nfet_06v0 ad=3.3p pd=15.88u as=3.3p ps=15.88u w=7.5u l=1u
X291 a_25568_9332# a_24994_11612# a_26918_4870# VDD pfet_06v0 ad=4.4p pd=20.88u as=4.4p ps=20.88u w=10u l=1u
X292 a_6594_49653# a_7758_49607# a_7958_49723# VSS nfet_06v0 ad=2.2p pd=10.88u as=1.3p ps=5.52u w=5u l=1u
X293 VDD a_33702_54123# a_31030_49723# VDD pfet_06v0 ad=1.3p pd=5.52u as=1.3p ps=5.52u w=5u l=1u
X294 X X VDD VDD pfet_06v0 ad=0.52p pd=2.52u as=0.88p ps=4.88u w=2u l=1u
X295 a_52850_45529# a_7758_45415# a_55326_45459# VSS nfet_06v0 ad=2.2p pd=10.88u as=1.3p ps=5.52u w=5u l=1u
X296 a_2754_24788# a_2554_24672# a_2454_24788# VSS nfet_06v0 ad=2.2p pd=10.88u as=1.25p ps=5.5u w=5u l=1u
X297 a_55914_35696# a_55714_35580# VDD VDD pfet_06v0 ad=2.5p pd=10.5u as=4.4p ps=20.88u w=10u l=1u
X298 a_53182_49653# a_48510_49609# a_52850_49653# VSS nfet_06v0 ad=1.25p pd=5.5u as=1.65p ps=5.66u w=5u l=1u
X299 VSS VDD VSS VSS nfet_06v0 ad=4.29p pd=20.38u as=0 ps=0 w=9.75u l=2u
X300 a_36902_28838# a_24994_35580# VSS VSS nfet_06v0 ad=0.25p pd=1.5u as=0.44p ps=2.88u w=1u l=1u
X301 a_33702_58419# a_25666_58305# a_32142_62819# VDD pfet_06v0 ad=1.3p pd=5.52u as=2.2p ps=10.88u w=5u l=1u
X302 a_51506_63689# a_48850_58305# VSS VSS nfet_06v0 ad=0.25p pd=1.5u as=0.44p ps=2.88u w=1u l=1u
X303 a_72338_24088# S3N a_69842_24788# VSS nfet_06v0 ad=3.74p pd=17.88u as=3.74p ps=17.88u w=8.5u l=1u
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
