AnBuiUCI/sscs-2026-zotnetic/FINAL/openroad/work_lvs_prueba/B26_A_extracted.spice

* NGSPICE file created from B26_A.ext - technology: gf180mcuD

.subckt B26_A S1N S1P S2N S2P S3N S3P S4N S4P VDD VSS X XN_IN XN_OUT XP_IN XP_OUT
+ Y YN_IN YN_OUT YP_IN YP_OUT Z ZN_IN ZN_OUT ZP_IN ZP_OUT S1N_I S1P_I S2N_I S2P_I
+ S3N_I S3P_I S4N_I S4P_I X_I Y_I Z_I
X0 a_52560_157284# a_67978_157284# VSS ppolyf_u_1k r_width=1u r_length=76.45u
X1 a_60034_140838# a_59834_140794# VSS VSS nfet_06v0 ad=1.25p pd=5.5u as=2.2p ps=10.88u w=5u l=1u
X2 a_99296_173976# a_106078_175068# Y_I VSS nfet_06v0 ad=1.0912p pd=5.84u as=0.6448p ps=3u w=2.48u l=1u
X3 a_112558_173624# a_110806_173624# a_111626_173580# VSS nfet_06v0 ad=0.25p pd=1.5u as=0.44p ps=2.88u w=1u l=1u
X4 a_73934_140794# a_74234_140794# a_85150_140838# VSS nfet_06v0 ad=2.2p pd=10.88u as=1.25p ps=5.5u w=5u l=1u
X5 a_99096_182484# a_99096_182484# VDD VDD pfet_06v0 ad=0.88p pd=4.88u as=0.88p ps=4.88u w=2u l=1u
X6 a_73934_128810# a_74274_135596# a_89822_135712# VDD pfet_06v0 ad=4.4p pd=20.88u as=2.5p ps=10.5u w=10u l=1u
X7 a_91602_182373# a_91402_182329# VSS VSS nfet_06v0 ad=1.25p pd=5.5u as=2.2p ps=10.88u w=5u l=1u
X8 a_36506_185843# a_29246_182329# a_37174_182443# VSS nfet_06v0 ad=1.1p pd=5.88u as=0.65p ps=3.02u w=2.5u l=1u
X9 VSS VDD VSS VSS nfet_06v0 ad=7.92p pd=36.88u as=1.23306n ps=6.04388m w=18u l=2u
X10 a_102014_140794# a_102014_140794# a_104522_140794# VSS nfet_06v0 ad=2.2p pd=10.88u as=1.65p ps=5.66u w=5u l=1u
X11 VSS a_38286_191067# a_46710_191067# VSS nfet_06v0 ad=1.3p pd=5.52u as=1.3p ps=5.52u w=5u l=1u
X12 VDD a_60694_186843# a_59134_182443# VDD pfet_06v0 ad=2.2p pd=10.88u as=1.3p ps=5.52u w=5u l=1u
X13 a_38998_140838# a_30160_145300# VDD VDD pfet_06v0 ad=0.44p pd=2.88u as=0.44p ps=2.88u w=1u l=1u
X14 a_79614_152778# a_74274_159564# a_84350_159680# VDD pfet_06v0 ad=4.4p pd=20.88u as=2.5p ps=10.5u w=10u l=1u
X15 a_79842_182373# a_34750_182327# a_82318_182443# VSS nfet_06v0 ad=2.2p pd=10.88u as=1.3p ps=5.52u w=5u l=1u
X16 a_31710_149586# a_38998_140838# cap_mim_2f0_m4m5_noshield c_width=25u c_length=8u
X17 VDD VSS VDD VDD pfet_06v0 ad=4.29p pd=20.38u as=1.86749n ps=8.9035m w=9.75u l=2u
X18 a_31210_165013# a_29586_168437# VSS VSS nfet_06v0 ad=0.25p pd=1.5u as=0.44p ps=2.88u w=1u l=1u
X19 VSS a_61358_173707# a_69782_173707# VSS nfet_06v0 ad=1.3p pd=5.52u as=1.3p ps=5.52u w=5u l=1u
X20 a_53250_182373# a_53050_182329# VSS VSS nfet_06v0 ad=1.25p pd=5.5u as=2.2p ps=10.88u w=5u l=1u
X21 a_96634_140794# a_96674_147580# a_111110_147696# VDD pfet_06v0 ad=4.4p pd=20.88u as=2.5p ps=10.5u w=10u l=1u
X22 S4N S4N_I VDD ppolyf_u r_width=16u r_length=4u
X23 a_75842_194421# a_75842_194421# a_78498_190997# VSS nfet_06v0 ad=0.44p pd=2.88u as=0.25p ps=1.5u w=1u l=1u
X24 a_36062_182443# a_35862_182327# a_33586_182373# VSS nfet_06v0 ad=1.3p pd=5.52u as=2.2p ps=10.88u w=5u l=1u
X25 a_99096_165124# a_99096_165124# a_101360_165240# VSS nfet_06v0 ad=0.308p pd=2.28u as=0.175p ps=1.2u w=0.7u l=1u
X26 VSS a_83430_191067# a_82762_194467# VSS nfet_06v0 ad=0.65p pd=3.02u as=0.65p ps=3.02u w=2.5u l=1u
X27 a_30178_182373# a_29978_182329# VSS VSS nfet_06v0 ad=1.25p pd=5.5u as=2.2p ps=10.88u w=5u l=1u
X28 a_33918_182373# a_29246_182329# a_33586_182373# VSS nfet_06v0 ad=1.25p pd=5.5u as=1.65p ps=5.66u w=5u l=1u
X29 a_54110_137602# S3P_I a_52186_135712# VDD pfet_06v0 ad=0.242p pd=1.98u as=0.242p ps=1.98u w=0.55u l=1u
X30 VDD a_75542_177061# a_80534_177177# VDD pfet_06v0 ad=4.4p pd=20.88u as=2.5p ps=10.5u w=10u l=1u
D0 VSS X diode_nd2ps_06v0 pj=40u area=99.99999p
X31 a_75502_182329# a_75842_185797# a_75742_185913# VDD pfet_06v0 ad=4.4p pd=20.88u as=2.5p ps=10.5u w=10u l=1u
X32 VDD a_83878_186843# a_81206_182443# VDD pfet_06v0 ad=1.3p pd=5.52u as=1.3p ps=5.52u w=5u l=1u
X33 VSS a_60246_165083# a_59578_168483# VSS nfet_06v0 ad=1.1p pd=5.88u as=0.65p ps=3.02u w=2.5u l=1u
X34 VSS VDD VSS VSS nfet_06v0 ad=4.29p pd=20.38u as=0 ps=0 w=9.75u l=2u
X35 a_59578_194467# a_60246_191067# VSS VSS nfet_06v0 ad=0.65p pd=3.02u as=1.1p ps=5.88u w=2.5u l=1u
X36 a_102104_165240# a_99096_165124# VSS VSS nfet_06v0 ad=0.5456p pd=3.36u as=0.5456p ps=3.36u w=1.24u l=1u
X37 a_34750_164967# a_30160_133316# VDD VDD pfet_06v0 ad=0.44p pd=2.88u as=0.44p ps=2.88u w=1u l=1u
X38 a_29746_152822# a_29546_152778# a_30478_152822# VSS nfet_06v0 ad=2.2p pd=10.88u as=1.25p ps=5.5u w=5u l=1u
X39 a_58022_182443# a_60694_186843# VDD VDD pfet_06v0 ad=1.3p pd=5.52u as=2.2p ps=10.88u w=5u l=1u
X40 a_33286_182373# a_29978_182329# VSS VSS nfet_06v0 ad=1.25p pd=5.5u as=2.2p ps=10.88u w=5u l=1u
X41 a_29486_168553# a_29286_168437# VDD VDD pfet_06v0 ad=2.5p pd=10.5u as=4.4p ps=20.88u w=10u l=1u
X42 a_74134_140838# a_73934_140794# VSS VSS nfet_06v0 ad=1.25p pd=5.5u as=2.2p ps=10.88u w=5u l=1u
X43 a_77474_152778# a_74234_152778# a_77210_161580# VSS nfet_06v0 ad=1.1p pd=5.88u as=0.825p ps=3.16u w=2.5u l=1u
X44 X_I X_I VDD VDD pfet_06v0 ad=0.52p pd=2.52u as=0.88p ps=4.88u w=2u l=1u
X45 a_37622_178107# a_29586_177061# a_36062_173707# VDD pfet_06v0 ad=1.3p pd=5.52u as=2.2p ps=10.88u w=5u l=1u
X46 a_53910_140838# a_55734_147696# VDD VDD pfet_06v0 ad=2.2p pd=10.88u as=2.2p ps=10.88u w=5u l=1u
X47 a_85150_152822# a_73934_152778# VSS VSS nfet_06v0 ad=1.25p pd=5.5u as=2.2p ps=10.88u w=5u l=1u
X48 a_34750_190951# a_56794_152822# VSS VSS nfet_06v0 ad=0.44p pd=2.88u as=0.44p ps=2.88u w=1u l=1u
X49 a_59578_177107# a_52318_173593# a_60246_173707# VSS nfet_06v0 ad=1.1p pd=5.88u as=0.65p ps=3.02u w=2.5u l=1u
X50 a_59134_191067# a_52658_194421# a_60694_195467# VDD pfet_06v0 ad=2.2p pd=10.88u as=1.3p ps=5.52u w=5u l=1u
X51 a_52658_168437# a_52658_168437# a_55314_165013# VSS nfet_06v0 ad=0.44p pd=2.88u as=0.25p ps=1.5u w=1u l=1u
X52 a_76930_152822# S4N_I a_74434_152822# VSS nfet_06v0 ad=3.74p pd=17.88u as=3.74p ps=17.88u w=8.5u l=1u
X53 a_104146_166448# a_99096_165124# VSS VSS nfet_06v0 ad=0.5456p pd=3.36u as=0.5456p ps=3.36u w=1.24u l=1u
X54 a_96534_140838# a_96334_140794# VSS VSS nfet_06v0 ad=1.25p pd=5.5u as=2.2p ps=10.88u w=5u l=1u
X55 VSS VDD VSS VSS nfet_06v0 ad=4.29p pd=20.38u as=0 ps=0 w=9.75u l=2u
X56 a_111110_159680# a_96374_159564# VDD VDD pfet_06v0 ad=2.5p pd=10.5u as=4.4p ps=20.88u w=10u l=1u
X57 a_29746_128854# a_29546_128810# a_30478_128854# VSS nfet_06v0 ad=2.2p pd=10.88u as=1.25p ps=5.5u w=5u l=1u
X58 a_35862_190951# a_97248_157284# VDD VDD pfet_06v0 ad=0.44p pd=2.88u as=0.44p ps=2.88u w=1u l=1u
X59 a_36062_165083# a_29586_168437# a_37622_169483# VDD pfet_06v0 ad=2.2p pd=10.88u as=1.3p ps=5.52u w=5u l=1u
X60 a_74848_134666# a_35862_164967# VSS ppolyf_u_1k r_width=1u r_length=76.45u
X61 a_77474_128810# a_74234_128810# a_77210_137612# VSS nfet_06v0 ad=1.1p pd=5.88u as=0.825p ps=3.16u w=2.5u l=1u
X62 a_33946_185913# a_34750_182327# a_35390_185843# VDD pfet_06v0 ad=4.4p pd=20.88u as=2.6p ps=10.52u w=10u l=1u
X63 a_99330_152822# S2N_I a_96834_152822# VSS nfet_06v0 ad=3.74p pd=17.88u as=3.74p ps=17.88u w=8.5u l=1u
X64 a_32522_161580# S3N_I a_29786_159680# VDD pfet_06v0 ad=0.22p pd=1.88u as=0.22p ps=1.88u w=0.5u l=1u
X65 a_57822_164967# a_56794_128854# VSS VSS nfet_06v0 ad=0.44p pd=2.88u as=0.44p ps=2.88u w=1u l=1u
X66 a_85150_128854# a_73934_128810# VSS VSS nfet_06v0 ad=1.25p pd=5.5u as=2.2p ps=10.88u w=5u l=1u
X67 a_79542_182373# a_76234_182329# VSS VSS nfet_06v0 ad=1.25p pd=5.5u as=2.2p ps=10.88u w=5u l=1u
X68 VDD a_37622_186843# a_34950_182443# VDD pfet_06v0 ad=2.2p pd=10.88u as=1.3p ps=5.52u w=5u l=1u
X69 a_91194_177177# a_90994_177061# VDD VDD pfet_06v0 ad=2.5p pd=10.5u as=4.4p ps=20.88u w=10u l=1u
X70 a_56718_194537# a_52358_194421# VDD VDD pfet_06v0 ad=2.5p pd=10.5u as=4.4p ps=20.88u w=10u l=1u
X71 X_I a_104234_166332# a_104146_166448# VSS nfet_06v0 ad=0.6448p pd=3u as=1.0912p ps=5.84u w=2.48u l=1u
X72 a_56658_173637# a_52318_173593# a_56358_173637# VSS nfet_06v0 ad=1.65p pd=5.66u as=1.25p ps=5.5u w=5u l=1u
X73 VSS a_37174_173707# a_35390_177107# VSS nfet_06v0 ad=1.1p pd=5.88u as=0.65p ps=3.02u w=2.5u l=1u
X74 a_76930_128854# S1N_I a_74434_128854# VSS nfet_06v0 ad=3.74p pd=17.88u as=3.74p ps=17.88u w=8.5u l=1u
X75 a_68418_182373# a_68218_182329# VSS VSS nfet_06v0 ad=1.25p pd=5.5u as=2.2p ps=10.88u w=5u l=1u
X76 a_51886_135712# a_51686_135596# VDD VDD pfet_06v0 ad=2.5p pd=10.5u as=4.4p ps=20.88u w=10u l=1u
X77 a_97248_134666# a_34750_173591# VSS ppolyf_u_1k r_width=1u r_length=76.45u
X78 a_56658_182373# a_35862_182327# a_59134_182443# VSS nfet_06v0 ad=2.2p pd=10.88u as=1.3p ps=5.52u w=5u l=1u
X79 VSS VDD VSS VSS nfet_06v0 ad=4.29p pd=20.38u as=0 ps=0 w=9.75u l=2u
X80 a_58462_185843# a_60246_182443# VSS VSS nfet_06v0 ad=0.65p pd=3.02u as=0.65p ps=3.02u w=2.5u l=1u
X81 a_99330_128854# S1N_I a_96834_128854# VSS nfet_06v0 ad=3.74p pd=17.88u as=3.74p ps=17.88u w=8.5u l=1u
X82 a_42526_152822# a_29586_159564# VSS VSS nfet_06v0 ad=0.25p pd=1.5u as=0.44p ps=2.88u w=1u l=1u
X83 a_81070_148780# a_74234_140794# a_81278_140838# VSS nfet_06v0 ad=2.2p pd=10.88u as=1.25p ps=5.5u w=5u l=1u
X84 a_38998_140838# a_34394_140838# VSS VSS nfet_06v0 ad=0.44p pd=2.88u as=0.44p ps=2.88u w=1u l=1u
X85 a_34950_182443# a_37622_186843# VDD VDD pfet_06v0 ad=1.3p pd=5.52u as=2.2p ps=10.88u w=5u l=1u
X86 a_58022_182443# a_57822_182327# a_56658_182373# VSS nfet_06v0 ad=1.3p pd=5.52u as=2.2p ps=10.88u w=5u l=1u
X87 a_104234_166332# a_114466_164956# VDD VDD pfet_06v0 ad=1.32p pd=6.88u as=1.32p ps=6.88u w=3u l=1u
X88 VDD VSS VDD VDD pfet_06v0 ad=4.29p pd=20.38u as=0 ps=0 w=9.75u l=2u
X89 a_29446_152822# a_29246_152778# VSS VSS nfet_06v0 ad=1.25p pd=5.5u as=2.2p ps=10.88u w=5u l=1u
X90 VSS a_111626_182316# a_106078_175068# VSS nfet_06v0 ad=0.44p pd=2.88u as=0.44p ps=2.88u w=1u l=1u
X91 a_35390_177107# a_37174_173707# VSS VSS nfet_06v0 ad=0.65p pd=3.02u as=1.1p ps=5.88u w=2.5u l=1u
X92 Y Y_I VDD ppolyf_u r_width=16u r_length=4u
X93 a_36590_152822# a_29246_152778# VSS VSS nfet_06v0 ad=1.25p pd=5.5u as=2.2p ps=10.88u w=5u l=1u
X94 a_46710_191067# a_38286_191067# VSS VSS nfet_06v0 ad=1.3p pd=5.52u as=2.2p ps=10.88u w=5u l=1u
X95 a_59134_182443# a_60694_186843# VDD VDD pfet_06v0 ad=1.3p pd=5.52u as=1.3p ps=5.52u w=5u l=1u
X96 a_76434_182373# a_76234_182329# VSS VSS nfet_06v0 ad=1.25p pd=5.5u as=2.2p ps=10.88u w=5u l=1u
X97 a_96674_147580# a_96674_147580# a_109614_140838# VSS nfet_06v0 ad=0.44p pd=2.88u as=0.25p ps=1.5u w=1u l=1u
X98 a_69782_173707# a_61358_173707# VSS VSS nfet_06v0 ad=1.3p pd=5.52u as=2.2p ps=10.88u w=5u l=1u
X99 a_52358_194421# a_52658_194421# a_55594_194537# VDD pfet_06v0 ad=4.4p pd=20.88u as=2.5p ps=10.5u w=10u l=1u
X100 a_42526_128854# a_29586_135596# VSS VSS nfet_06v0 ad=0.25p pd=1.5u as=0.44p ps=2.88u w=1u l=1u
X101 S3N S3N_I VDD ppolyf_u r_width=16u r_length=4u
X102 YP_OUT YN_OUT VDD VDD pfet_05v0 ad=0.8052p pd=4.54u as=0.8052p ps=4.54u w=1.83u l=0.5u
X103 VSS a_83430_165083# a_82762_168483# VSS nfet_06v0 ad=1.1p pd=5.88u as=0.65p ps=3.02u w=2.5u l=1u
X104 a_99096_173860# a_99096_173860# VDD VDD pfet_06v0 ad=0.88p pd=4.88u as=0.88p ps=4.88u w=2u l=1u
X105 a_82762_194467# a_83430_191067# VSS VSS nfet_06v0 ad=0.65p pd=3.02u as=1.1p ps=5.88u w=2.5u l=1u
X106 a_42638_182329# a_29586_185797# a_46382_185913# VDD pfet_06v0 ad=4.4p pd=20.88u as=2.5p ps=10.5u w=10u l=1u
X107 a_90558_190997# a_76234_190953# VSS VSS nfet_06v0 ad=1.25p pd=5.5u as=2.2p ps=10.88u w=5u l=1u
X108 a_81206_182443# a_83878_186843# VDD VDD pfet_06v0 ad=1.3p pd=5.52u as=2.2p ps=10.88u w=5u l=1u
X109 a_29446_128854# a_29246_128810# VSS VSS nfet_06v0 ad=1.25p pd=5.5u as=2.2p ps=10.88u w=5u l=1u
X110 a_36590_128854# a_29246_128810# VSS VSS nfet_06v0 ad=1.25p pd=5.5u as=2.2p ps=10.88u w=5u l=1u
X111 a_81646_168483# a_92966_165083# cap_mim_2f0_m4m5_noshield c_width=20u c_length=10u
X112 VSS VDD VSS VSS nfet_06v0 ad=7.92p pd=36.88u as=0 ps=0 w=18u l=2u
X113 a_102002_166448# X_I X_I VSS nfet_06v0 ad=0.88p pd=4.88u as=0.52p ps=2.52u w=2u l=1u
X114 a_88894_173593# a_75842_177061# a_92638_177177# VDD pfet_06v0 ad=4.4p pd=20.88u as=2.5p ps=10.5u w=10u l=1u
X115 a_82762_177107# a_75502_173593# a_83430_173707# VSS nfet_06v0 ad=1.1p pd=5.88u as=0.65p ps=3.02u w=2.5u l=1u
D1 VSS Y diode_nd2ps_06v0 pj=40u area=99.99999p
X116 a_112222_159680# a_96374_159564# VDD VDD pfet_06v0 ad=2.5p pd=10.5u as=4.4p ps=20.88u w=10u l=1u
X117 a_30598_135712# a_29286_135596# VDD VDD pfet_06v0 ad=2.5p pd=10.5u as=4.4p ps=20.88u w=10u l=1u
X118 a_60694_195467# a_52658_194421# a_59134_191067# VDD pfet_06v0 ad=1.3p pd=5.52u as=2.2p ps=10.88u w=5u l=1u
X119 a_54110_137602# a_57822_164967# cap_mim_2f0_m4m5_noshield c_width=25u c_length=8u
X120 a_98598_152822# a_100422_159680# VDD VDD pfet_06v0 ad=2.2p pd=10.88u as=2.2p ps=10.88u w=5u l=1u
X121 a_37174_173707# a_29246_173593# a_36506_177107# VSS nfet_06v0 ad=0.65p pd=3.02u as=1.1p ps=5.88u w=2.5u l=1u
X122 a_81070_160764# a_81070_160764# a_82706_159564# VDD pfet_06v0 ad=4.4p pd=20.88u as=3.3p ps=10.66u w=10u l=1u
X123 a_37622_169483# a_29586_168437# a_36062_165083# VDD pfet_06v0 ad=1.3p pd=5.52u as=2.2p ps=10.88u w=5u l=1u
X124 a_84994_195467# a_75842_194421# a_81206_191067# VDD pfet_06v0 ad=1.3p pd=5.52u as=2.2p ps=10.88u w=5u l=1u
X125 a_92966_182443# a_84994_186843# VDD VDD pfet_06v0 ad=4.4p pd=20.88u as=2.6p ps=10.52u w=10u l=1u
X126 a_35390_185843# a_34750_182327# a_33946_185913# VDD pfet_06v0 ad=2.6p pd=10.52u as=4.4p ps=20.88u w=10u l=1u
X127 S3P S3P_I VDD ppolyf_u r_width=16u r_length=4u
X128 a_61810_169483# a_65710_164969# a_61358_165083# VSS nfet_06v0 ad=1.1p pd=5.88u as=1.1p ps=5.88u w=2.5u l=1u
X129 a_29246_190953# a_29246_190953# VSS VSS nfet_06v0 ad=0.44p pd=2.88u as=0.44p ps=2.88u w=1u l=1u
X130 VDD VSS VDD VDD pfet_06v0 ad=4.29p pd=20.38u as=0 ps=0 w=9.75u l=2u
X131 a_89822_135712# a_73974_135596# VDD VDD pfet_06v0 ad=2.5p pd=10.5u as=4.4p ps=20.88u w=10u l=1u
X132 a_61358_191067# a_52318_190953# a_58462_194467# VSS nfet_06v0 ad=0.65p pd=3.02u as=1.1p ps=5.88u w=2.5u l=1u
X133 VDD a_38738_186843# a_46710_182443# VDD pfet_06v0 ad=2.6p pd=10.52u as=2.6p ps=10.52u w=10u l=1u
X134 a_96874_147696# a_96674_147580# a_97686_147696# VDD pfet_06v0 ad=4.4p pd=20.88u as=2.5p ps=10.5u w=10u l=1u
X135 a_55186_140794# a_58782_148780# a_55734_147696# VDD pfet_06v0 ad=1.76p pd=8.88u as=1.76p ps=8.88u w=4u l=1u
X136 a_84350_159680# a_73974_159564# VDD VDD pfet_06v0 ad=2.5p pd=10.5u as=4.4p ps=20.88u w=10u l=1u
X137 VSS a_60246_182443# a_58462_185843# VSS nfet_06v0 ad=0.65p pd=3.02u as=0.65p ps=3.02u w=2.5u l=1u
D2 Y VDD diode_pd2nw_06v0 pj=40u area=99.99999p
X138 a_78498_190997# a_75842_194421# VSS VSS nfet_06v0 ad=0.25p pd=1.5u as=0.44p ps=2.88u w=1u l=1u
X139 a_34394_152822# a_36382_160764# a_30160_157284# VDD pfet_06v0 ad=1.76p pd=8.88u as=1.76p ps=8.88u w=4u l=1u
X140 a_69782_191067# a_61358_191067# VSS VSS nfet_06v0 ad=2.2p pd=10.88u as=1.3p ps=5.52u w=5u l=1u
X141 a_101360_165240# a_99096_165124# a_101060_165240# VSS nfet_06v0 ad=0.175p pd=1.2u as=0.175p ps=1.2u w=0.7u l=1u
X142 a_91402_190953# a_75502_190953# a_91602_190997# VSS nfet_06v0 ad=1.65p pd=5.66u as=1.25p ps=5.5u w=5u l=1u
X143 VDD VSS VDD VDD pfet_06v0 ad=0.44p pd=2.88u as=0 ps=0 w=1u l=2u
X144 a_33946_194537# a_35862_190951# a_36506_194467# VDD pfet_06v0 ad=4.4p pd=20.88u as=2.6p ps=10.52u w=10u l=1u
X145 a_80534_177177# a_75842_177061# a_80202_177177# VDD pfet_06v0 ad=2.5p pd=10.5u as=3.3p ps=10.66u w=10u l=1u
X146 a_75742_185913# a_75542_185797# VDD VDD pfet_06v0 ad=2.5p pd=10.5u as=4.4p ps=20.88u w=10u l=1u
X147 a_29586_135596# a_29586_135596# VDD VDD pfet_06v0 ad=0.88p pd=4.88u as=0.88p ps=4.88u w=2u l=1u
X148 a_82318_182443# a_83878_186843# VDD VDD pfet_06v0 ad=1.3p pd=5.52u as=1.3p ps=5.52u w=5u l=1u
X149 a_29586_185797# a_29586_185797# a_32242_182373# VSS nfet_06v0 ad=0.44p pd=2.88u as=0.25p ps=1.5u w=1u l=1u
X150 a_36506_177107# a_35862_173591# a_33946_177177# VDD pfet_06v0 ad=2.6p pd=10.52u as=4.4p ps=20.88u w=10u l=1u
X151 a_66174_186797# a_66174_186797# a_67810_185797# VDD pfet_06v0 ad=4.4p pd=20.88u as=3.3p ps=10.66u w=10u l=1u
X152 VSS a_46710_165083# a_115398_165000# VSS nfet_06v0 ad=0.44p pd=2.88u as=0.25p ps=1.5u w=1u l=1u
X153 a_30478_152822# a_29246_152778# VSS VSS nfet_06v0 ad=1.25p pd=5.5u as=2.2p ps=10.88u w=5u l=1u
X154 a_29286_177061# a_29586_177061# a_31210_173637# VSS nfet_06v0 ad=0.44p pd=2.88u as=0.25p ps=1.5u w=1u l=1u
X155 a_53050_190953# a_52318_190953# a_53250_190997# VSS nfet_06v0 ad=2.2p pd=10.88u as=1.25p ps=5.5u w=5u l=1u
X156 VDD a_60694_186843# a_59134_182443# VDD pfet_06v0 ad=1.3p pd=5.52u as=1.3p ps=5.52u w=5u l=1u
D3 VSS Y diode_nd2ps_06v0 pj=40u area=99.99999p
X157 a_75542_194421# a_75842_194421# a_78778_194537# VDD pfet_06v0 ad=4.4p pd=20.88u as=2.5p ps=10.5u w=10u l=1u
X158 VDD a_37622_186843# a_36062_182443# VDD pfet_06v0 ad=1.3p pd=5.52u as=1.3p ps=5.52u w=5u l=1u
X159 a_86182_140838# a_74274_147580# VSS VSS nfet_06v0 ad=0.25p pd=1.5u as=0.44p ps=2.88u w=1u l=1u
X160 a_99134_175068# a_99306_190940# VDD VDD pfet_06v0 ad=1.32p pd=6.88u as=1.32p ps=6.88u w=3u l=1u
X161 a_57822_182327# a_101482_140838# VSS VSS nfet_06v0 ad=0.44p pd=2.88u as=0.44p ps=2.88u w=1u l=1u
X162 a_100158_183808# a_99096_182484# VSS VSS nfet_06v0 ad=0.5456p pd=3.36u as=0.5456p ps=3.36u w=1.24u l=1u
X163 a_55314_165013# a_52658_168437# VSS VSS nfet_06v0 ad=0.25p pd=1.5u as=0.44p ps=2.88u w=1u l=1u
X164 a_79082_140838# a_74234_140794# a_76398_149586# VSS nfet_06v0 ad=1.1p pd=5.88u as=0.825p ps=3.16u w=2.5u l=1u
X165 a_74848_145750# a_90266_145300# VSS ppolyf_u_1k r_width=1u r_length=76.45u
X166 a_82762_168483# a_83430_165083# VSS VSS nfet_06v0 ad=0.65p pd=3.02u as=0.65p ps=3.02u w=2.5u l=1u
X167 VSS a_46710_173707# a_110806_173624# VSS nfet_06v0 ad=0.44p pd=2.88u as=0.44p ps=2.88u w=1u l=1u
X168 VDD VSS VDD VDD pfet_06v0 ad=7.92p pd=36.88u as=0 ps=0 w=18u l=2u
D4 VSS S4N diode_nd2ps_06v0 pj=40u area=99.99999p
X169 VSS a_76234_182329# a_80174_182373# VSS nfet_06v0 ad=2.2p pd=10.88u as=1.25p ps=5.5u w=5u l=1u
X170 a_62062_147696# a_51686_147580# VDD VDD pfet_06v0 ad=2.5p pd=10.5u as=4.4p ps=20.88u w=10u l=1u
X171 a_68010_168553# a_67810_168437# VDD VDD pfet_06v0 ad=2.5p pd=10.5u as=4.4p ps=20.88u w=10u l=1u
X172 a_96374_159564# a_96674_159564# a_108582_152822# VSS nfet_06v0 ad=0.44p pd=2.88u as=0.25p ps=1.5u w=1u l=1u
X173 a_33586_190997# a_29246_190953# a_33286_190997# VSS nfet_06v0 ad=1.65p pd=5.66u as=1.25p ps=5.5u w=5u l=1u
X174 a_59134_173707# a_35862_173591# a_56658_173637# VSS nfet_06v0 ad=1.3p pd=5.52u as=2.2p ps=10.88u w=5u l=1u
X175 a_38286_173707# a_29246_173593# a_35390_177107# VSS nfet_06v0 ad=0.65p pd=3.02u as=1.1p ps=5.88u w=2.5u l=1u
X176 a_30478_128854# a_29246_128810# VSS VSS nfet_06v0 ad=1.25p pd=5.5u as=2.2p ps=10.88u w=5u l=1u
X177 VDD VSS VDD VDD pfet_06v0 ad=0.44p pd=2.88u as=0 ps=0 w=1u l=2u
D5 VSS S4N diode_nd2ps_06v0 pj=40u area=99.99999p
X178 VSS VDD VSS VSS nfet_06v0 ad=7.92p pd=36.88u as=0 ps=0 w=18u l=2u
X179 a_74234_152778# a_74274_159564# a_88710_159680# VDD pfet_06v0 ad=4.4p pd=20.88u as=2.5p ps=10.5u w=10u l=1u
X180 X_I X_I a_102002_166448# VSS nfet_06v0 ad=0.52p pd=2.52u as=0.88p ps=4.88u w=2u l=1u
X181 a_97248_145750# a_112666_145300# VSS ppolyf_u_1k r_width=1u r_length=76.45u
X182 a_100246_183692# a_92966_173707# VSS VSS nfet_06v0 ad=0.33p pd=1.66u as=0.44p ps=2.88u w=1u l=1u
X183 a_83430_173707# a_75502_173593# a_82762_177107# VSS nfet_06v0 ad=0.65p pd=3.02u as=1.1p ps=5.88u w=2.5u l=1u
X184 a_83878_195467# a_75842_194421# a_82318_191067# VDD pfet_06v0 ad=1.3p pd=5.52u as=2.2p ps=10.88u w=5u l=1u
X185 Z_I a_100246_183692# a_100158_183808# VSS nfet_06v0 ad=0.6448p pd=3u as=1.0912p ps=5.84u w=2.48u l=1u
X186 VDD VSS VDD VDD pfet_06v0 ad=4.29p pd=20.38u as=0 ps=0 w=9.75u l=2u
X187 a_69782_173707# a_61810_178107# VDD VDD pfet_06v0 ad=4.4p pd=20.88u as=2.6p ps=10.52u w=10u l=1u
X188 a_56990_182373# a_52318_182329# a_56658_182373# VSS nfet_06v0 ad=1.25p pd=5.5u as=1.65p ps=5.66u w=5u l=1u
D6 S3P VDD diode_pd2nw_06v0 pj=40u area=99.99999p
X189 a_56358_173637# a_53050_173593# VSS VSS nfet_06v0 ad=1.25p pd=5.5u as=2.2p ps=10.88u w=5u l=1u
X190 a_51686_135596# a_51986_135596# a_69458_135712# VDD pfet_06v0 ad=4.4p pd=20.88u as=2.5p ps=10.5u w=10u l=1u
X191 a_52658_177061# a_52658_177061# VDD VDD pfet_06v0 ad=0.88p pd=4.88u as=0.88p ps=4.88u w=2u l=1u
X192 a_67810_194421# a_52658_194421# a_68010_194537# VDD pfet_06v0 ad=3.3p pd=10.66u as=2.5p ps=10.5u w=10u l=1u
X193 a_96374_135596# a_96674_135596# a_108582_128854# VSS nfet_06v0 ad=0.44p pd=2.88u as=0.25p ps=1.5u w=1u l=1u
X194 a_30160_145300# a_45578_145300# VSS ppolyf_u_1k r_width=1u r_length=76.45u
X195 a_81206_182443# a_57822_182327# a_79842_182373# VSS nfet_06v0 ad=1.3p pd=5.52u as=2.2p ps=10.88u w=5u l=1u
D7 Y VDD diode_pd2nw_06v0 pj=40u area=99.99999p
X196 a_79842_190997# a_75502_190953# a_79542_190997# VSS nfet_06v0 ad=1.65p pd=5.66u as=1.25p ps=5.5u w=5u l=1u
X197 a_84994_169483# a_88894_164969# a_84542_165083# VSS nfet_06v0 ad=1.1p pd=5.88u as=1.1p ps=5.88u w=2.5u l=1u
X198 VDD VSS VDD VDD pfet_06v0 ad=0.44p pd=2.88u as=0 ps=0 w=1u l=2u
X199 a_99046_183808# a_99096_182484# VSS VSS nfet_06v0 ad=0.5456p pd=3.36u as=0.5456p ps=3.36u w=1.24u l=1u
X200 VSS a_61358_165083# a_69782_165083# VSS nfet_06v0 ad=1.3p pd=5.52u as=1.3p ps=5.52u w=5u l=1u
X201 a_68218_190953# a_52318_190953# a_68418_190997# VSS nfet_06v0 ad=1.65p pd=5.66u as=1.25p ps=5.5u w=5u l=1u
X202 a_29286_185797# a_29586_185797# a_32522_185913# VDD pfet_06v0 ad=4.4p pd=20.88u as=2.5p ps=10.5u w=10u l=1u
X203 a_81278_140838# a_73934_140794# VSS VSS nfet_06v0 ad=1.25p pd=5.5u as=2.2p ps=10.88u w=5u l=1u
X204 VDD VSS VDD VDD pfet_06v0 ad=4.29p pd=20.38u as=0 ps=0 w=9.75u l=2u
X205 a_31710_161570# a_32786_152778# VSS VSS nfet_06v0 ad=0.825p pd=3.16u as=1.1p ps=5.88u w=2.5u l=1u
X206 a_76398_161570# a_57822_190951# cap_mim_2f0_m4m5_noshield c_width=25u c_length=8u
X207 a_29978_190953# a_29246_190953# a_30178_190997# VSS nfet_06v0 ad=2.2p pd=10.88u as=1.25p ps=5.5u w=5u l=1u
X208 a_38018_159564# a_29586_159564# a_38218_159680# VDD pfet_06v0 ad=3.3p pd=10.66u as=2.5p ps=10.5u w=10u l=1u
X209 VSS VDD VSS VSS nfet_06v0 ad=0.44p pd=2.88u as=0 ps=0 w=1u l=2u
X210 a_46710_182443# a_38738_186843# VDD VDD pfet_06v0 ad=2.6p pd=10.52u as=4.4p ps=20.88u w=10u l=1u
X211 VSS a_83430_182443# a_81646_185843# VSS nfet_06v0 ad=0.65p pd=3.02u as=0.65p ps=3.02u w=2.5u l=1u
X212 a_32242_128854# a_33334_135712# VDD VDD pfet_06v0 ad=2.2p pd=10.88u as=2.2p ps=10.88u w=5u l=1u
X213 a_29786_147696# a_29586_147580# a_29486_147696# VDD pfet_06v0 ad=4.4p pd=20.88u as=2.5p ps=10.5u w=10u l=1u
X214 VSS a_99306_190940# a_99134_175068# VSS nfet_06v0 ad=0.44p pd=2.88u as=0.44p ps=2.88u w=1u l=1u
D8 S2P VDD diode_pd2nw_06v0 pj=40u area=99.99999p
X215 a_35862_164967# a_74848_133316# VDD VDD pfet_06v0 ad=0.44p pd=2.88u as=0.44p ps=2.88u w=1u l=1u
X216 a_54110_161570# a_55186_152778# VSS VSS nfet_06v0 ad=0.825p pd=3.16u as=1.1p ps=5.88u w=2.5u l=1u
X217 a_92966_191067# a_84542_191067# VSS VSS nfet_06v0 ad=2.2p pd=10.88u as=1.3p ps=5.52u w=5u l=1u
X218 a_109614_140838# a_96674_147580# VSS VSS nfet_06v0 ad=0.25p pd=1.5u as=0.44p ps=2.88u w=1u l=1u
X219 a_57822_182327# a_97248_145300# VDD VDD pfet_06v0 ad=0.44p pd=2.88u as=0.44p ps=2.88u w=1u l=1u
X220 a_55594_194537# a_52358_194421# VDD VDD pfet_06v0 ad=2.5p pd=10.5u as=4.4p ps=20.88u w=10u l=1u
X221 a_99134_183692# a_92966_191067# VSS VSS nfet_06v0 ad=0.33p pd=1.66u as=0.44p ps=2.88u w=1u l=1u
X222 a_54642_128854# a_55734_135712# VDD VDD pfet_06v0 ad=2.2p pd=10.88u as=2.2p ps=10.88u w=5u l=1u
X223 a_32522_149596# S2N_I a_29786_147696# VDD pfet_06v0 ad=0.22p pd=1.88u as=0.22p ps=1.88u w=0.5u l=1u
X224 a_59578_168483# a_52318_164969# a_60246_165083# VSS nfet_06v0 ad=1.1p pd=5.88u as=0.65p ps=3.02u w=2.5u l=1u
X225 a_44938_168553# a_44738_168437# VDD VDD pfet_06v0 ad=2.5p pd=10.5u as=4.4p ps=20.88u w=10u l=1u
X226 a_31710_137602# a_32786_128810# VSS VSS nfet_06v0 ad=0.825p pd=3.16u as=1.1p ps=5.88u w=2.5u l=1u
X227 a_46382_185913# a_29286_185797# VDD VDD pfet_06v0 ad=2.5p pd=10.5u as=4.4p ps=20.88u w=10u l=1u
X228 a_76234_190953# a_75502_190953# a_76434_190997# VSS nfet_06v0 ad=2.2p pd=10.88u as=1.25p ps=5.5u w=5u l=1u
X229 VDD a_83878_186843# a_82318_182443# VDD pfet_06v0 ad=1.3p pd=5.52u as=1.3p ps=5.52u w=5u l=1u
X230 a_31510_128854# a_33334_135712# VDD VDD pfet_06v0 ad=2.2p pd=10.88u as=2.2p ps=10.88u w=5u l=1u
X231 a_92638_177177# a_75542_177061# VDD VDD pfet_06v0 ad=2.5p pd=10.5u as=4.4p ps=20.88u w=10u l=1u
X232 a_53050_164969# a_52658_168437# a_53670_168553# VDD pfet_06v0 ad=4.4p pd=20.88u as=2.5p ps=10.5u w=10u l=1u
X233 a_54110_137602# a_55186_128810# VSS VSS nfet_06v0 ad=0.825p pd=3.16u as=1.1p ps=5.88u w=2.5u l=1u
X234 a_101482_152822# a_103470_160764# a_97248_157284# VDD pfet_06v0 ad=1.76p pd=8.88u as=1.76p ps=8.88u w=4u l=1u
X235 a_36062_182443# a_37622_186843# VDD VDD pfet_06v0 ad=1.3p pd=5.52u as=2.2p ps=10.88u w=5u l=1u
D9 S3P VDD diode_pd2nw_06v0 pj=40u area=99.99999p
X236 VSS a_69782_165083# a_104234_183692# VSS nfet_06v0 ad=0.44p pd=2.88u as=0.33p ps=1.66u w=1u l=1u
X237 a_44738_194421# a_29586_194421# a_44938_194537# VDD pfet_06v0 ad=3.3p pd=10.66u as=2.5p ps=10.5u w=10u l=1u
X238 a_96674_135596# a_96674_135596# VDD VDD pfet_06v0 ad=0.88p pd=4.88u as=0.88p ps=4.88u w=2u l=1u
X239 a_38738_186843# a_42638_182329# a_38286_182443# VSS nfet_06v0 ad=1.1p pd=5.88u as=1.1p ps=5.88u w=2.5u l=1u
X240 a_55734_147696# a_51986_147580# a_54642_140838# VDD pfet_06v0 ad=4.4p pd=20.88u as=4.4p ps=20.88u w=10u l=1u
X241 VSS a_37174_165083# a_35390_168483# VSS nfet_06v0 ad=1.1p pd=5.88u as=0.65p ps=3.02u w=2.5u l=1u
X242 a_57326_140794# a_57326_140794# a_59834_140794# VSS nfet_06v0 ad=2.2p pd=10.88u as=1.65p ps=5.66u w=5u l=1u
X243 a_36506_168483# a_35862_164967# a_33946_168553# VDD pfet_06v0 ad=2.6p pd=10.52u as=4.4p ps=20.88u w=10u l=1u
D10 VSS S3P diode_nd2ps_06v0 pj=40u area=99.99999p
X244 a_74848_145750# a_90266_146200# VSS ppolyf_u_1k r_width=1u r_length=76.45u
X245 a_80202_177177# a_38998_140838# a_81646_177107# VDD pfet_06v0 ad=4.4p pd=20.88u as=2.6p ps=10.52u w=10u l=1u
X246 VDD VSS VDD VDD pfet_06v0 ad=7.92p pd=36.88u as=0 ps=0 w=18u l=2u
X247 a_57018_177177# a_35862_173591# a_59578_177107# VDD pfet_06v0 ad=4.4p pd=20.88u as=2.6p ps=10.52u w=10u l=1u
X248 a_58462_177107# a_60246_173707# VSS VSS nfet_06v0 ad=0.65p pd=3.02u as=1.1p ps=5.88u w=2.5u l=1u
X249 a_57326_128810# a_51986_135596# a_62062_135712# VDD pfet_06v0 ad=4.4p pd=20.88u as=2.5p ps=10.5u w=10u l=1u
X250 a_99296_182600# a_99096_182484# VSS VSS nfet_06v0 ad=0.5456p pd=3.36u as=0.5456p ps=3.36u w=1.24u l=1u
X251 VSS a_46710_191067# a_103078_190984# VSS nfet_06v0 ad=0.44p pd=2.88u as=0.25p ps=1.5u w=1u l=1u
X252 a_82122_140794# a_74234_140794# a_82322_140838# VSS nfet_06v0 ad=1.65p pd=5.66u as=1.25p ps=5.5u w=5u l=1u
X253 a_84542_165083# a_89358_169437# a_84994_169483# VDD pfet_06v0 ad=2.2p pd=10.88u as=2.2p ps=10.88u w=5u l=1u
X254 a_33946_185913# a_29586_185797# a_33646_185913# VDD pfet_06v0 ad=3.3p pd=10.66u as=2.5p ps=10.5u w=10u l=1u
X255 a_113914_183772# a_92966_182443# a_106078_183692# VDD pfet_06v0 ad=0.75p pd=3.5u as=1.32p ps=6.88u w=3u l=1u
X256 a_80174_182373# a_75502_182329# a_79842_182373# VSS nfet_06v0 ad=1.25p pd=5.5u as=1.65p ps=5.66u w=5u l=1u
X257 a_97248_145750# a_112666_146200# VSS ppolyf_u_1k r_width=1u r_length=76.45u
X258 a_75842_177061# a_75842_177061# VDD VDD pfet_06v0 ad=0.88p pd=4.88u as=0.88p ps=4.88u w=2u l=1u
X259 VDD a_61810_178107# a_69782_173707# VDD pfet_06v0 ad=2.6p pd=10.52u as=2.6p ps=10.52u w=10u l=1u
X260 a_35390_194467# a_29246_190953# a_38286_191067# VSS nfet_06v0 ad=1.1p pd=5.88u as=0.65p ps=3.02u w=2.5u l=1u
X261 a_34750_173591# a_97248_133316# VDD VDD pfet_06v0 ad=0.44p pd=2.88u as=0.44p ps=2.88u w=1u l=1u
X262 a_97686_147696# a_96374_147580# VDD VDD pfet_06v0 ad=2.5p pd=10.5u as=4.4p ps=20.88u w=10u l=1u
D11 S2P VDD diode_pd2nw_06v0 pj=40u area=99.99999p
X263 VDD VSS VDD VDD pfet_06v0 ad=7.92p pd=36.88u as=0 ps=0 w=18u l=2u
X264 a_60246_191067# a_66174_195421# a_60694_195467# VDD pfet_06v0 ad=2.2p pd=10.88u as=2.2p ps=10.88u w=5u l=1u
X265 a_35390_168483# a_37174_165083# VSS VSS nfet_06v0 ad=0.65p pd=3.02u as=1.1p ps=5.88u w=2.5u l=1u
X266 a_29246_173593# a_29586_177061# a_29486_177177# VDD pfet_06v0 ad=4.4p pd=20.88u as=2.5p ps=10.5u w=10u l=1u
X267 a_99134_166332# a_102146_190940# VDD VDD pfet_06v0 ad=1.32p pd=6.88u as=1.32p ps=6.88u w=3u l=1u
X268 VDD VSS VDD VDD pfet_06v0 ad=0.44p pd=2.88u as=0 ps=0 w=1u l=2u
D12 VSS S2P diode_nd2ps_06v0 pj=40u area=99.99999p
X269 a_51646_140794# a_51986_147580# a_67534_147696# VDD pfet_06v0 ad=4.4p pd=20.88u as=2.5p ps=10.5u w=10u l=1u
X270 VSS VDD VSS VSS nfet_06v0 ad=4.29p pd=20.38u as=0 ps=0 w=9.75u l=2u
X271 a_89358_169437# a_75502_164969# a_90558_165013# VSS nfet_06v0 ad=2.2p pd=10.88u as=1.25p ps=5.5u w=5u l=1u
X272 a_69782_165083# a_61358_165083# VSS VSS nfet_06v0 ad=1.3p pd=5.52u as=2.2p ps=10.88u w=5u l=1u
X273 a_91602_190997# a_91402_190953# VSS VSS nfet_06v0 ad=1.25p pd=5.5u as=2.2p ps=10.88u w=5u l=1u
X274 a_69782_165083# a_61810_169483# VDD VDD pfet_06v0 ad=4.4p pd=20.88u as=2.6p ps=10.52u w=10u l=1u
X275 X_I a_106078_166332# a_99296_165240# VSS nfet_06v0 ad=0.6448p pd=3u as=1.0912p ps=5.84u w=2.48u l=1u
D13 Z VDD diode_pd2nw_06v0 pj=40u area=99.99999p
X276 VSS VDD VSS VSS nfet_06v0 ad=0.44p pd=2.88u as=0 ps=0 w=1u l=2u
X277 a_32242_182373# a_29586_185797# VSS VSS nfet_06v0 ad=0.25p pd=1.5u as=0.44p ps=2.88u w=1u l=1u
X278 a_96874_135712# a_96674_135596# a_96574_135712# VDD pfet_06v0 ad=4.4p pd=20.88u as=2.5p ps=10.5u w=10u l=1u
X279 a_98598_140838# a_100422_147696# VDD VDD pfet_06v0 ad=2.2p pd=10.88u as=2.2p ps=10.88u w=5u l=1u
X280 a_29978_164969# a_29586_168437# a_30598_168553# VDD pfet_06v0 ad=4.4p pd=20.88u as=2.5p ps=10.5u w=10u l=1u
X281 a_52146_152822# a_51946_152778# a_51846_152822# VSS nfet_06v0 ad=2.2p pd=10.88u as=1.25p ps=5.5u w=5u l=1u
X282 a_115398_165000# a_69782_165083# a_114466_164956# VSS nfet_06v0 ad=0.25p pd=1.5u as=0.44p ps=2.88u w=1u l=1u
X283 a_81646_185843# a_83430_182443# VSS VSS nfet_06v0 ad=0.65p pd=3.02u as=1.1p ps=5.88u w=2.5u l=1u
X284 a_69782_191067# a_58022_191067# cap_mim_2f0_m4m5_noshield c_width=20u c_length=10u
X285 a_31210_173637# a_29586_177061# VSS VSS nfet_06v0 ad=0.25p pd=1.5u as=0.44p ps=2.88u w=1u l=1u
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
