AnBuiUCI/sscs-2026-zotnetic/FINAL/openroad/work_lvs/GRADIENT_NAV_extracted_ordered.spice

* NGSPICE file created from GRADIENT_NAV.ext - technology: gf180mcuD

.subckt GRADIENT_NAV S1N VDD XN VSS S1P S2N S2P S3N S3P S4N S4P XP YN YP ZN ZP X Y Z
X0 a_27480_4860# a_23302_4744# a_25466_8260# VSS nfet_06v0 ad=1.1p pd=5.88u as=1.1p ps=5.88u w=2.5u l=1u
X1 a_31310_31016# a_26982_30900# VSS VSS nfet_06v0 ad=1.25p pd=5.5u as=2.2p ps=10.88u w=5u l=1u
X2 a_6648_57052# a_9306_60336# a_7070_60452# VDD pfet_06v0 ad=2.2p pd=10.88u as=2.2p ps=10.88u w=5u l=1u
X3 a_6498_65848# a_9174_65732# a_9374_65848# VSS nfet_06v0 ad=2.2p pd=10.88u as=1.3p ps=5.52u w=5u l=1u
X4 a_20242_69248# a_2210_69132# VDD VDD pfet_06v0 ad=2.5p pd=10.5u as=4.4p ps=20.88u w=10u l=1u
X5 a_54718_69248# a_50370_69132# VDD VDD pfet_06v0 ad=2.5p pd=10.5u as=4.4p ps=20.88u w=10u l=1u
X6 a_6648_22332# a_2470_22216# a_4634_25732# VSS nfet_06v0 ad=1.1p pd=5.88u as=1.1p ps=5.88u w=2.5u l=1u
X7 a_52716_57052# a_44134_56936# a_53736_57052# VSS nfet_06v0 ad=2.2p pd=10.88u as=1.25p ps=5.5u w=5u l=1u
X8 VDD a_60290_69248# a_23622_74260# VDD pfet_06v0 ad=2.6p pd=10.52u as=2.6p ps=10.52u w=10u l=1u
X9 a_57264_39692# a_44174_42976# VSS VSS nfet_06v0 ad=0.25p pd=1.5u as=0.44p ps=2.88u w=1u l=1u
X10 a_4634_8260# a_5916_4860# VSS VSS nfet_06v0 ad=1.1p pd=5.88u as=1.1p ps=5.88u w=2.5u l=1u
X11 a_23502_4860# a_23302_4744# a_23202_4860# VSS nfet_06v0 ad=2.2p pd=10.88u as=1.25p ps=5.5u w=5u l=1u
X12 a_47922_43092# a_44174_42976# a_46830_39692# VDD pfet_06v0 ad=2.2p pd=10.88u as=2.2p ps=10.88u w=5u l=1u
X13 a_65840_41360# a_2030_74376# Z VSS nfet_06v0 ad=1.0912p pd=5.84u as=0.6448p ps=3u w=2.48u l=1u
X14 a_48312_57052# a_44134_56936# a_46298_60452# VSS nfet_06v0 ad=1.1p pd=5.88u as=1.1p ps=5.88u w=2.5u l=1u
X15 a_57534_13656# a_59174_17056# VDD VDD pfet_06v0 ad=1.3p pd=5.52u as=1.3p ps=5.52u w=5u l=1u
X16 a_53326_65848# a_50670_69132# VSS VSS nfet_06v0 ad=0.25p pd=1.5u as=0.44p ps=2.88u w=1u l=1u
X17 a_30138_42976# a_30138_42976# a_31762_42976# VDD pfet_06v0 ad=4.4p pd=20.88u as=4.4p ps=20.88u w=10u l=1u
X18 a_8644_4744# a_8644_4744# a_11052_4860# VSS nfet_06v0 ad=2.2p pd=10.88u as=2.2p ps=10.88u w=5u l=1u
X19 a_3102_13656# a_2902_13540# VSS VSS nfet_06v0 ad=1.25p pd=5.5u as=2.2p ps=10.88u w=5u l=1u
X20 a_56422_31016# a_59174_34416# VDD VDD pfet_06v0 ad=1.3p pd=5.52u as=1.3p ps=5.52u w=5u l=1u
X21 a_8782_34416# a_10486_31016# VSS VSS nfet_06v0 ad=0.65p pd=3.02u as=0.65p ps=3.02u w=2.5u l=1u
X22 a_60290_17056# a_50670_16940# a_56422_13656# VDD pfet_06v0 ad=1.3p pd=5.52u as=2.2p ps=10.88u w=5u l=1u
X23 a_40574_16940# a_26250_13540# a_41694_13656# VSS nfet_06v0 ad=2.2p pd=10.88u as=1.25p ps=5.5u w=5u l=1u
X24 a_14334_74260# a_12130_51776# VDD VDD pfet_06v0 ad=2.6p pd=10.52u as=4.4p ps=20.88u w=10u l=1u
X25 a_44334_57052# a_44134_56936# a_44034_57052# VSS nfet_06v0 ad=2.2p pd=10.88u as=1.25p ps=5.5u w=5u l=1u
X26 a_11014_17056# a_2510_16940# a_9374_13656# VDD pfet_06v0 ad=1.3p pd=5.52u as=2.2p ps=10.88u w=5u l=1u
X27 a_16632_22332# a_2510_25616# VSS VSS nfet_06v0 ad=0.25p pd=1.5u as=0.44p ps=2.88u w=1u l=1u
X28 a_6258_60452# a_2510_60336# a_5166_57052# VDD pfet_06v0 ad=2.2p pd=10.88u as=2.2p ps=10.88u w=5u l=1u
X29 a_67842_40152# a_66178_40036# VSS VSS nfet_06v0 ad=0.175p pd=1.2u as=0.308p ps=2.28u w=0.7u l=1u
X30 a_2710_60452# a_2510_60336# a_2410_60452# VDD pfet_06v0 ad=4.4p pd=20.88u as=2.5p ps=10.5u w=10u l=1u
X31 VSS a_4314_74260# a_4226_74376# VSS nfet_06v0 ad=0.44p pd=2.88u as=0.44p ps=2.88u w=1u l=1u
X32 a_56942_17056# a_58646_13656# VSS VSS nfet_06v0 ad=0.65p pd=3.02u as=0.65p ps=3.02u w=2.5u l=1u
X33 a_46298_60452# a_32142_65732# cap_mim_2f0_m4m5_noshield c_width=20u c_length=10u
X34 a_30938_69248# a_26590_69132# a_30638_69248# VDD pfet_06v0 ad=4.4p pd=20.88u as=2.5p ps=10.5u w=10u l=1u
X35 a_8062_30900# a_27480_22332# VSS VSS nfet_06v0 ad=0.44p pd=2.88u as=0.44p ps=2.88u w=1u l=1u
X36 a_52294_65848# a_50670_69132# VSS VSS nfet_06v0 ad=0.25p pd=1.5u as=0.44p ps=2.88u w=1u l=1u
X37 a_2510_69132# a_2510_69132# VDD VDD pfet_06v0 ad=0.88p pd=4.88u as=0.88p ps=4.88u w=2u l=1u
X38 a_6858_34416# a_8062_30900# a_8782_34416# VDD pfet_06v0 ad=4.4p pd=20.88u as=2.6p ps=10.52u w=10u l=1u
X39 a_3402_22332# a_2170_22216# VSS VSS nfet_06v0 ad=1.25p pd=5.5u as=2.2p ps=10.88u w=5u l=1u
X40 VDD a_13282_75936# a_16830_74260# VDD pfet_06v0 ad=1.32p pd=6.88u as=1.32p ps=6.88u w=3u l=1u
X41 X a_16742_74376# a_64728_5320# VSS nfet_06v0 ad=0.6448p pd=3u as=1.0912p ps=5.84u w=2.48u l=1u
X42 a_50570_17056# a_50370_16940# VDD VDD pfet_06v0 ad=2.5p pd=10.5u as=4.4p ps=20.88u w=10u l=1u
X43 a_33978_34416# a_26250_30900# a_34566_31016# VSS nfet_06v0 ad=1.1p pd=5.88u as=0.65p ps=3.02u w=2.5u l=1u
X44 a_2170_56936# a_2470_56936# a_14568_57052# VSS nfet_06v0 ad=2.2p pd=10.88u as=1.25p ps=5.5u w=5u l=1u
X45 a_26278_25732# a_26748_22332# VSS VSS nfet_06v0 ad=1.1p pd=5.88u as=1.1p ps=5.88u w=2.5u l=1u
X46 a_33454_48376# a_35094_51776# VDD VDD pfet_06v0 ad=1.3p pd=5.52u as=1.3p ps=5.52u w=5u l=1u
X47 a_68598_57016# a_68686_56900# VDD VDD pfet_06v0 ad=1.32p pd=6.88u as=1.32p ps=6.88u w=3u l=1u
X48 VDD a_59174_69248# a_56422_65848# VDD pfet_06v0 ad=2.2p pd=10.88u as=1.3p ps=5.52u w=5u l=1u
X49 a_33978_17056# a_34566_13656# VSS VSS nfet_06v0 ad=0.65p pd=3.02u as=0.65p ps=3.02u w=2.5u l=1u
X50 a_23542_60452# a_23342_60336# a_23242_60452# VDD pfet_06v0 ad=4.4p pd=20.88u as=2.5p ps=10.5u w=10u l=1u
X51 VDD a_59174_17056# a_56422_13656# VDD pfet_06v0 ad=1.3p pd=5.52u as=1.3p ps=5.52u w=5u l=1u
X52 a_47580_57052# a_50970_60336# a_47922_60452# VDD pfet_06v0 ad=2.2p pd=10.88u as=2.2p ps=10.88u w=5u l=1u
X53 a_10308_57052# a_2170_56936# VSS VSS nfet_06v0 ad=1.25p pd=5.5u as=2.2p ps=10.88u w=5u l=1u
X54 a_27494_74376# a_27582_74260# VDD VDD pfet_06v0 ad=1.32p pd=6.88u as=1.32p ps=6.88u w=3u l=1u
X55 VSS a_44490_13656# a_64638_57016# VSS nfet_06v0 ad=0.44p pd=2.88u as=0.44p ps=2.88u w=1u l=1u
X56 a_24234_22332# a_23002_22216# VSS VSS nfet_06v0 ad=1.25p pd=5.5u as=2.2p ps=10.88u w=5u l=1u
X57 a_28214_13656# a_26590_16940# VSS VSS nfet_06v0 ad=0.25p pd=1.5u as=0.44p ps=2.88u w=1u l=1u
X58 a_8262_13656# a_2510_16940# a_12130_17056# VDD pfet_06v0 ad=2.2p pd=10.88u as=1.3p ps=5.52u w=5u l=1u
X59 a_2530_75936# a_36210_34416# VDD VDD pfet_06v0 ad=2.6p pd=10.52u as=4.4p ps=20.88u w=10u l=1u
X60 a_2210_51660# a_2510_51660# a_5446_51776# VDD pfet_06v0 ad=4.4p pd=20.88u as=2.5p ps=10.5u w=10u l=1u
X61 VSS a_59758_65848# a_23622_74260# VSS nfet_06v0 ad=1.3p pd=5.52u as=1.3p ps=5.52u w=5u l=1u
X62 a_46098_22332# S4P a_44334_22332# VSS nfet_06v0 ad=2.2p pd=10.88u as=2.2p ps=10.88u w=5u l=1u
X63 a_32142_13540# a_48312_4860# VSS VSS nfet_06v0 ad=0.44p pd=2.88u as=0.44p ps=2.88u w=1u l=1u
X64 VSS a_58646_31016# a_56942_34416# VSS nfet_06v0 ad=1.1p pd=5.88u as=0.65p ps=3.02u w=2.5u l=1u
X65 a_10486_31016# a_2170_30900# a_9898_34416# VSS nfet_06v0 ad=0.65p pd=3.02u as=1.1p ps=5.88u w=2.5u l=1u
X66 a_2370_22332# a_2170_22216# VSS VSS nfet_06v0 ad=1.25p pd=5.5u as=2.2p ps=10.88u w=5u l=1u
X67 a_36210_51776# a_40030_48260# a_35678_48376# VSS nfet_06v0 ad=1.1p pd=5.88u as=1.1p ps=5.88u w=2.5u l=1u
X68 a_5916_39692# a_9306_42976# a_6258_43092# VDD pfet_06v0 ad=2.2p pd=10.88u as=2.2p ps=10.88u w=5u l=1u
X69 a_15600_57052# a_2510_60336# VSS VSS nfet_06v0 ad=0.25p pd=1.5u as=0.44p ps=2.88u w=1u l=1u
X70 a_8782_17056# a_8062_13540# a_6858_17056# VDD pfet_06v0 ad=2.6p pd=10.52u as=4.4p ps=20.88u w=10u l=1u
X71 a_26490_51776# a_26290_51660# VDD VDD pfet_06v0 ad=2.5p pd=10.5u as=4.4p ps=20.88u w=10u l=1u
X72 a_9898_51776# a_9174_48260# a_6858_51776# VDD pfet_06v0 ad=2.6p pd=10.52u as=4.4p ps=20.88u w=10u l=1u
X73 a_31762_60336# a_23342_60336# a_31962_60452# VDD pfet_06v0 ad=4.4p pd=20.88u as=2.5p ps=10.5u w=10u l=1u
X74 VDD a_35094_51776# a_32342_48376# VDD pfet_06v0 ad=1.3p pd=5.52u as=1.3p ps=5.52u w=5u l=1u
X75 a_32904_57052# a_31884_57052# VSS VSS nfet_06v0 ad=1.25p pd=5.5u as=2.2p ps=10.88u w=5u l=1u
X76 a_59174_17056# a_64110_13540# a_58646_13656# VSS nfet_06v0 ad=1.1p pd=5.88u as=1.1p ps=5.88u w=2.5u l=1u
X77 a_23302_4744# a_23342_8144# a_34998_8260# VDD pfet_06v0 ad=4.4p pd=20.88u as=2.5p ps=10.5u w=10u l=1u
X78 a_64654_34300# a_64654_34300# a_66278_34300# VDD pfet_06v0 ad=4.4p pd=20.88u as=4.4p ps=20.88u w=10u l=1u
X79 a_12870_74260# a_59758_48376# VSS VSS nfet_06v0 ad=2.2p pd=10.88u as=1.3p ps=5.52u w=5u l=1u
X80 a_6858_34416# a_9174_30900# a_9898_34416# VDD pfet_06v0 ad=4.4p pd=20.88u as=2.6p ps=10.52u w=10u l=1u
X81 a_46830_22332# S4N a_44334_22332# VSS nfet_06v0 ad=2.2p pd=10.88u as=2.2p ps=10.88u w=5u l=1u
X82 a_32862_34416# a_2530_75936# cap_mim_2f0_m4m5_noshield c_width=20u c_length=10u
X83 a_47110_60452# a_47580_57052# VSS VSS nfet_06v0 ad=1.1p pd=5.88u as=1.1p ps=5.88u w=2.5u l=1u
X84 a_44174_25616# a_44174_25616# VDD VDD pfet_06v0 ad=0.88p pd=4.88u as=0.88p ps=4.88u w=2u l=1u
X85 a_56942_69248# a_23622_74260# cap_mim_2f0_m4m5_noshield c_width=20u c_length=10u
X86 a_50970_60336# a_50970_60336# a_52594_60336# VDD pfet_06v0 ad=4.4p pd=20.88u as=4.4p ps=20.88u w=10u l=1u
X87 a_26748_4860# a_30138_8144# a_27090_8260# VDD pfet_06v0 ad=2.2p pd=10.88u as=2.2p ps=10.88u w=5u l=1u
X88 a_2170_22216# a_2510_25616# a_15278_25732# VDD pfet_06v0 ad=4.4p pd=20.88u as=2.5p ps=10.5u w=10u l=1u
X89 a_23202_57052# a_23002_56936# VSS VSS nfet_06v0 ad=1.25p pd=5.5u as=2.2p ps=10.88u w=5u l=1u
X90 VSS a_2118_74260# a_2030_74376# VSS nfet_06v0 ad=0.44p pd=2.88u as=0.44p ps=2.88u w=1u l=1u
X91 a_56422_65848# a_32142_65732# a_54658_65848# VSS nfet_06v0 ad=1.3p pd=5.52u as=2.2p ps=10.88u w=5u l=1u
X92 a_45066_57052# a_43834_56936# VSS VSS nfet_06v0 ad=1.25p pd=5.5u as=2.2p ps=10.88u w=5u l=1u
X93 a_20410_65848# a_12130_69248# VDD VDD pfet_06v0 ad=2.6p pd=10.52u as=4.4p ps=20.88u w=10u l=1u
X94 a_31750_51776# a_26290_51660# VDD VDD pfet_06v0 ad=2.5p pd=10.5u as=4.4p ps=20.88u w=10u l=1u
X95 a_4634_25732# a_5916_22332# VSS VSS nfet_06v0 ad=1.1p pd=5.88u as=1.1p ps=5.88u w=2.5u l=1u
X96 a_50670_34300# a_50670_34300# a_53326_31016# VSS nfet_06v0 ad=0.44p pd=2.88u as=0.25p ps=1.5u w=1u l=1u
X97 VSS a_34566_48376# a_32862_51776# VSS nfet_06v0 ad=1.1p pd=5.88u as=0.65p ps=3.02u w=2.5u l=1u
X98 a_51972_4860# a_43834_4744# VSS VSS nfet_06v0 ad=1.25p pd=5.5u as=2.2p ps=10.88u w=5u l=1u
X99 a_36432_4860# a_23342_8144# VSS VSS nfet_06v0 ad=0.25p pd=1.5u as=0.44p ps=2.88u w=1u l=1u
X100 a_29476_39576# a_23342_42976# a_33886_43092# VDD pfet_06v0 ad=4.4p pd=20.88u as=2.5p ps=10.5u w=10u l=1u
X101 a_5166_39692# a_6258_43092# VDD VDD pfet_06v0 ad=2.2p pd=10.88u as=2.2p ps=10.88u w=5u l=1u
X102 a_19378_13656# a_18358_13656# VSS VSS nfet_06v0 ad=1.25p pd=5.5u as=2.2p ps=10.88u w=5u l=1u
X103 a_54658_48376# a_32142_48260# a_56422_48376# VSS nfet_06v0 ad=2.2p pd=10.88u as=1.3p ps=5.52u w=5u l=1u
X104 a_25466_25732# a_26748_22332# VSS VSS nfet_06v0 ad=1.1p pd=5.88u as=1.1p ps=5.88u w=2.5u l=1u
X105 a_55390_65848# a_51062_65732# VSS VSS nfet_06v0 ad=1.25p pd=5.5u as=2.2p ps=10.88u w=5u l=1u
X106 a_33454_65848# a_35094_69248# VDD VDD pfet_06v0 ad=1.3p pd=5.52u as=1.3p ps=5.52u w=5u l=1u
X107 a_44374_25732# a_44174_25616# a_44074_25732# VDD pfet_06v0 ad=4.4p pd=20.88u as=2.5p ps=10.5u w=10u l=1u
X108 a_33454_13656# a_35094_17056# VDD VDD pfet_06v0 ad=1.3p pd=5.52u as=2.2p ps=10.88u w=5u l=1u
X109 a_7070_43092# a_8644_39576# a_6648_39692# VSS nfet_06v0 ad=1.1p pd=5.88u as=1.1p ps=5.88u w=2.5u l=1u
X110 a_2710_60452# a_2510_60336# a_3522_60452# VDD pfet_06v0 ad=4.4p pd=20.88u as=2.5p ps=10.5u w=10u l=1u
X111 a_56422_31016# a_59174_34416# VDD VDD pfet_06v0 ad=1.3p pd=5.52u as=2.2p ps=10.88u w=5u l=1u
X112 X X VDD VDD pfet_06v0 ad=0.52p pd=2.52u as=0.52p ps=2.52u w=2u l=1u
X113 a_50370_34300# a_50670_34300# a_52294_31016# VSS nfet_06v0 ad=0.44p pd=2.88u as=0.25p ps=1.5u w=1u l=1u
X114 a_2210_69132# a_2510_69132# a_5446_69248# VDD pfet_06v0 ad=4.4p pd=20.88u as=2.5p ps=10.5u w=10u l=1u
X115 a_55830_34416# a_50370_34300# VDD VDD pfet_06v0 ad=2.5p pd=10.5u as=4.4p ps=20.88u w=10u l=1u
X116 a_26250_30900# a_26590_34300# a_26490_34416# VDD pfet_06v0 ad=4.4p pd=20.88u as=2.5p ps=10.5u w=10u l=1u
X117 a_51682_17056# a_50370_16940# VDD VDD pfet_06v0 ad=2.5p pd=10.5u as=4.4p ps=20.88u w=10u l=1u
X118 a_15278_43092# a_2210_42976# VDD VDD pfet_06v0 ad=2.5p pd=10.5u as=4.4p ps=20.88u w=10u l=1u
X119 VDD a_14246_74376# a_15066_74260# VDD pfet_06v0 ad=1.32p pd=6.88u as=1.32p ps=6.88u w=3u l=1u
X120 a_32862_34416# a_26250_30900# a_35678_31016# VSS nfet_06v0 ad=1.1p pd=5.88u as=0.65p ps=3.02u w=2.5u l=1u
X121 a_12130_34416# a_2510_34300# a_8262_31016# VDD pfet_06v0 ad=1.3p pd=5.52u as=2.2p ps=10.88u w=5u l=1u
X122 a_16494_16940# a_16494_16940# a_18118_16940# VDD pfet_06v0 ad=4.4p pd=20.88u as=4.4p ps=20.88u w=10u l=1u
X123 a_23542_60452# a_23342_60336# a_24354_60452# VDD pfet_06v0 ad=4.4p pd=20.88u as=2.5p ps=10.5u w=10u l=1u
X124 a_30138_25616# a_23302_22216# a_31140_22332# VSS nfet_06v0 ad=2.2p pd=10.88u as=1.25p ps=5.5u w=5u l=1u
X125 a_26490_69248# a_26290_69132# VDD VDD pfet_06v0 ad=2.5p pd=10.5u as=4.4p ps=20.88u w=10u l=1u
X126 a_9898_69248# a_9174_65732# a_6858_69248# VDD pfet_06v0 ad=2.6p pd=10.52u as=4.4p ps=20.88u w=10u l=1u
X127 a_55018_17056# a_32142_13540# a_56942_17056# VDD pfet_06v0 ad=4.4p pd=20.88u as=2.6p ps=10.52u w=10u l=1u
X128 a_27090_8260# a_23342_8144# a_25998_4860# VDD pfet_06v0 ad=2.2p pd=10.88u as=2.2p ps=10.88u w=5u l=1u
X129 VDD a_35094_69248# a_32342_65848# VDD pfet_06v0 ad=1.3p pd=5.52u as=1.3p ps=5.52u w=5u l=1u
X130 a_11052_57052# a_2470_56936# a_12072_57052# VSS nfet_06v0 ad=2.2p pd=10.88u as=1.25p ps=5.5u w=5u l=1u
X131 a_60290_17056# a_64110_13540# a_59758_13656# VSS nfet_06v0 ad=1.1p pd=5.88u as=1.1p ps=5.88u w=2.5u l=1u
X132 a_6858_51776# a_2510_51660# a_6558_51776# VDD pfet_06v0 ad=4.4p pd=20.88u as=2.5p ps=10.5u w=10u l=1u
X133 VSS a_66922_56900# a_66834_57016# VSS nfet_06v0 ad=0.44p pd=2.88u as=0.44p ps=2.88u w=1u l=1u
X134 a_52794_8260# a_52594_8144# VDD VDD pfet_06v0 ad=2.5p pd=10.5u as=4.4p ps=20.88u w=10u l=1u
X135 a_33978_17056# a_34566_13656# VSS VSS nfet_06v0 ad=0.65p pd=3.02u as=1.1p ps=5.88u w=2.5u l=1u
X136 a_42398_17056# a_42198_16940# VDD VDD pfet_06v0 ad=2.5p pd=10.5u as=4.4p ps=20.88u w=10u l=1u
X137 a_11598_31016# a_2170_30900# a_8782_34416# VSS nfet_06v0 ad=0.65p pd=3.02u as=1.1p ps=5.88u w=2.5u l=1u
X138 a_26590_51660# a_26590_51660# a_29246_48376# VSS nfet_06v0 ad=0.44p pd=2.88u as=0.25p ps=1.5u w=1u l=1u
X139 VSS a_12870_74260# a_15998_74376# VSS nfet_06v0 ad=0.44p pd=2.88u as=0.25p ps=1.5u w=1u l=1u
X140 a_32862_51776# a_13282_75936# cap_mim_2f0_m4m5_noshield c_width=20u c_length=10u
X141 a_47580_22332# a_44134_22216# a_47110_25732# VSS nfet_06v0 ad=1.1p pd=5.88u as=1.1p ps=5.88u w=2.5u l=1u
X142 a_30938_34416# a_26590_34300# a_31750_34416# VDD pfet_06v0 ad=4.4p pd=20.88u as=2.5p ps=10.5u w=10u l=1u
X143 a_5916_22332# a_2470_22216# a_5446_25732# VSS nfet_06v0 ad=1.1p pd=5.88u as=1.1p ps=5.88u w=2.5u l=1u
X144 a_43834_39576# a_44134_39576# a_56232_39692# VSS nfet_06v0 ad=2.2p pd=10.88u as=1.25p ps=5.5u w=5u l=1u
X145 a_9306_25616# a_2470_22216# a_10308_22332# VSS nfet_06v0 ad=2.2p pd=10.88u as=1.25p ps=5.5u w=5u l=1u
X146 a_6498_31016# a_2170_30900# a_6198_31016# VSS nfet_06v0 ad=2.2p pd=10.88u as=1.25p ps=5.5u w=5u l=1u
X147 VDD a_11014_34416# a_9374_31016# VDD pfet_06v0 ad=1.3p pd=5.52u as=1.3p ps=5.52u w=5u l=1u
X148 a_66178_40036# a_66178_40036# a_68442_40152# VSS nfet_06v0 ad=0.308p pd=2.28u as=0.175p ps=1.2u w=0.7u l=1u
X149 a_27902_43092# a_23342_42976# a_25266_39692# VDD pfet_06v0 ad=2.2p pd=10.88u as=2.2p ps=10.88u w=5u l=1u
X150 X a_27494_74376# a_64728_6528# VSS nfet_06v0 ad=0.6448p pd=3u as=1.0912p ps=5.84u w=2.48u l=1u
X151 a_2410_25732# a_2210_25616# VDD VDD pfet_06v0 ad=2.5p pd=10.5u as=4.4p ps=20.88u w=10u l=1u
X152 a_31750_69248# a_26290_69132# VDD VDD pfet_06v0 ad=2.5p pd=10.5u as=4.4p ps=20.88u w=10u l=1u
X153 a_29526_34416# a_26290_34300# VDD VDD pfet_06v0 ad=2.5p pd=10.5u as=4.4p ps=20.88u w=10u l=1u
X154 a_44174_8144# a_44174_8144# VDD VDD pfet_06v0 ad=0.88p pd=4.88u as=0.88p ps=4.88u w=2u l=1u
X155 a_26748_22332# a_23302_22216# a_26278_25732# VSS nfet_06v0 ad=1.1p pd=5.88u as=1.1p ps=5.88u w=2.5u l=1u
X156 a_13054_43092# a_2210_42976# VDD VDD pfet_06v0 ad=2.5p pd=10.5u as=4.4p ps=20.88u w=10u l=1u
X157 a_8062_13540# a_27480_4860# VSS VSS nfet_06v0 ad=0.44p pd=2.88u as=0.44p ps=2.88u w=1u l=1u
X158 a_43874_25616# a_44174_25616# a_58866_25732# VDD pfet_06v0 ad=4.4p pd=20.88u as=2.5p ps=10.5u w=10u l=1u
X159 a_50308_56936# a_44174_60336# a_54718_60452# VDD pfet_06v0 ad=4.4p pd=20.88u as=2.5p ps=10.5u w=10u l=1u
X160 a_2210_25616# a_2510_25616# a_15600_22332# VSS nfet_06v0 ad=0.44p pd=2.88u as=0.25p ps=1.5u w=1u l=1u
X161 a_23242_25732# a_23042_25616# VDD VDD pfet_06v0 ad=2.5p pd=10.5u as=4.4p ps=20.88u w=10u l=1u
X162 a_64728_41360# a_66178_40036# VSS VSS nfet_06v0 ad=0.5456p pd=3.36u as=0.5456p ps=3.36u w=1.24u l=1u
X163 a_64728_22792# a_14978_74376# Y VSS nfet_06v0 ad=1.0912p pd=5.84u as=0.6448p ps=3u w=2.48u l=1u
X164 a_57534_65848# a_8062_65732# a_54658_65848# VSS nfet_06v0 ad=1.3p pd=5.52u as=2.2p ps=10.88u w=5u l=1u
X165 a_64726_56900# a_60290_17056# VDD VDD pfet_06v0 ad=4.4p pd=20.88u as=2.6p ps=10.52u w=10u l=1u
X166 a_7230_31016# a_2902_30900# VSS VSS nfet_06v0 ad=1.25p pd=5.5u as=2.2p ps=10.88u w=5u l=1u
X167 a_32862_51776# a_32142_48260# a_30938_51776# VDD pfet_06v0 ad=2.6p pd=10.52u as=4.4p ps=20.88u w=10u l=1u
X168 a_51062_65732# a_50330_65732# a_51262_65848# VSS nfet_06v0 ad=2.2p pd=10.88u as=1.25p ps=5.5u w=5u l=1u
X169 a_2470_4744# a_2510_8144# a_14166_8260# VDD pfet_06v0 ad=4.4p pd=20.88u as=2.5p ps=10.5u w=10u l=1u
X170 Y a_25730_74376# a_64728_24000# VSS nfet_06v0 ad=0.6448p pd=3u as=1.0912p ps=5.84u w=2.48u l=1u
X171 a_27090_8260# a_29476_4744# a_26748_4860# VSS nfet_06v0 ad=1.1p pd=5.88u as=1.1p ps=5.88u w=2.5u l=1u
X172 a_46830_57052# a_47922_60452# VDD VDD pfet_06v0 ad=2.2p pd=10.88u as=2.2p ps=10.88u w=5u l=1u
X173 a_67538_65848# a_66518_65848# VSS VSS nfet_06v0 ad=1.25p pd=5.5u as=2.2p ps=10.88u w=5u l=1u
X174 a_59174_17056# a_50670_16940# a_57534_13656# VDD pfet_06v0 ad=1.3p pd=5.52u as=2.2p ps=10.88u w=5u l=1u
X175 a_30638_17056# a_26290_16940# VDD VDD pfet_06v0 ad=2.5p pd=10.5u as=4.4p ps=20.88u w=10u l=1u
X176 VDD a_36210_17056# a_44490_13656# VDD pfet_06v0 ad=2.6p pd=10.52u as=2.6p ps=10.52u w=10u l=1u
X177 a_32142_48260# a_48734_43092# VDD VDD pfet_06v0 ad=0.308p pd=2.28u as=0.308p ps=2.28u w=0.7u l=20u
X178 a_28514_74376# a_24034_75936# a_27582_74260# VSS nfet_06v0 ad=0.25p pd=1.5u as=0.44p ps=2.88u w=1u l=1u
X179 a_54658_31016# a_50330_30900# a_55390_31016# VSS nfet_06v0 ad=2.2p pd=10.88u as=1.25p ps=5.5u w=5u l=1u
X180 a_54658_48376# a_8062_48260# a_57534_48376# VSS nfet_06v0 ad=2.2p pd=10.88u as=1.3p ps=5.52u w=5u l=1u
X181 a_2530_75936# a_35678_31016# VSS VSS nfet_06v0 ad=1.3p pd=5.52u as=2.2p ps=10.88u w=5u l=1u
X182 a_44374_25732# a_44174_25616# a_45186_25732# VDD pfet_06v0 ad=4.4p pd=20.88u as=2.5p ps=10.5u w=10u l=1u
X183 a_27480_57052# a_30138_60336# a_27902_60452# VDD pfet_06v0 ad=2.2p pd=10.88u as=2.2p ps=10.88u w=5u l=1u
X184 a_23302_39576# a_23302_39576# VSS VSS nfet_06v0 ad=0.44p pd=2.88u as=0.44p ps=2.88u w=1u l=1u
X185 a_23502_22332# a_23302_22216# a_23202_22332# VSS nfet_06v0 ad=2.2p pd=10.88u as=1.25p ps=5.5u w=5u l=1u
X186 VSS a_64726_56900# a_64638_57016# VSS nfet_06v0 ad=0.44p pd=2.88u as=0.44p ps=2.88u w=1u l=1u
X187 a_29476_22216# a_29476_22216# a_31884_22332# VSS nfet_06v0 ad=2.2p pd=10.88u as=2.2p ps=10.88u w=5u l=1u
X188 a_9174_48260# a_7070_43092# VDD VDD pfet_06v0 ad=0.308p pd=2.28u as=0.308p ps=2.28u w=0.7u l=20u
X189 a_58866_43092# a_43874_42976# VDD VDD pfet_06v0 ad=2.5p pd=10.5u as=4.4p ps=20.88u w=10u l=1u
X190 a_30938_51776# a_9174_48260# a_33978_51776# VDD pfet_06v0 ad=4.4p pd=20.88u as=2.6p ps=10.52u w=10u l=1u
X191 a_11598_48376# a_16494_51660# a_12130_51776# VDD pfet_06v0 ad=2.2p pd=10.88u as=2.2p ps=10.88u w=5u l=1u
X192 a_6858_69248# a_2510_69132# a_6558_69248# VDD pfet_06v0 ad=4.4p pd=20.88u as=2.5p ps=10.5u w=10u l=1u
X193 a_56942_34416# a_32142_30900# a_55018_34416# VDD pfet_06v0 ad=2.6p pd=10.52u as=4.4p ps=20.88u w=10u l=1u
X194 a_50670_16940# a_50670_16940# VDD VDD pfet_06v0 ad=0.88p pd=4.88u as=0.88p ps=4.88u w=2u l=1u
X195 a_9174_13540# a_4434_4860# cap_mim_2f0_m4m5_noshield c_width=20u c_length=10u
X196 VSS a_58646_48376# a_58058_51776# VSS nfet_06v0 ad=1.1p pd=5.88u as=0.65p ps=3.02u w=2.5u l=1u
X197 a_31140_4860# a_23002_4744# VSS VSS nfet_06v0 ad=1.25p pd=5.5u as=2.2p ps=10.88u w=5u l=1u
X198 VSS a_34566_31016# a_33978_34416# VSS nfet_06v0 ad=0.65p pd=3.02u as=0.65p ps=3.02u w=2.5u l=1u
X199 a_8782_51776# a_10486_48376# VSS VSS nfet_06v0 ad=0.65p pd=3.02u as=1.1p ps=5.88u w=2.5u l=1u
X200 a_2510_25616# a_2510_25616# VDD VDD pfet_06v0 ad=0.88p pd=4.88u as=0.88p ps=4.88u w=2u l=1u
X201 a_42438_65848# a_26250_65732# a_43458_65848# VSS nfet_06v0 ad=2.2p pd=10.88u as=1.25p ps=5.5u w=5u l=1u
X202 a_15600_4860# a_2510_8144# VSS VSS nfet_06v0 ad=0.25p pd=1.5u as=0.44p ps=2.88u w=1u l=1u
X203 VDD a_44490_13656# a_65038_58692# VDD pfet_06v0 ad=1.32p pd=6.88u as=0.75p ps=3.5u w=3u l=1u
X204 a_9306_60336# a_9306_60336# a_10930_60336# VDD pfet_06v0 ad=4.4p pd=20.88u as=4.4p ps=20.88u w=10u l=1u
X205 a_35400_39692# a_23002_39576# VSS VSS nfet_06v0 ad=1.25p pd=5.5u as=2.2p ps=10.88u w=5u l=1u
X206 a_2510_69132# a_2510_69132# a_5166_65848# VSS nfet_06v0 ad=0.44p pd=2.88u as=0.25p ps=1.5u w=1u l=1u
X207 a_9174_48260# a_4434_39692# cap_mim_2f0_m4m5_noshield c_width=20u c_length=10u
X208 a_26250_13540# a_26250_13540# VSS VSS nfet_06v0 ad=0.44p pd=2.88u as=0.44p ps=2.88u w=1u l=1u
X209 a_8062_13540# a_27902_8260# VDD VDD pfet_06v0 ad=0.308p pd=2.28u as=0.308p ps=2.28u w=0.7u l=20u
X210 VDD a_24034_75936# a_23934_76052# VDD pfet_06v0 ad=1.32p pd=6.88u as=0.75p ps=3.5u w=3u l=1u
X211 a_8062_13540# a_25266_4860# cap_mim_2f0_m4m5_noshield c_width=20u c_length=10u
X212 VSS a_10486_65848# a_9898_69248# VSS nfet_06v0 ad=1.1p pd=5.88u as=0.65p ps=3.02u w=2.5u l=1u
X213 a_4634_8260# S1P a_2710_8260# VDD pfet_06v0 ad=4.4p pd=20.88u as=4.4p ps=20.88u w=10u l=1u
X214 a_64110_48260# a_50670_51660# a_68402_51776# VDD pfet_06v0 ad=4.4p pd=20.88u as=2.5p ps=10.5u w=10u l=1u
X215 a_2370_4860# a_2170_4744# VSS VSS nfet_06v0 ad=1.25p pd=5.5u as=2.2p ps=10.88u w=5u l=1u
X216 a_69828_6528# a_68598_57016# X VSS nfet_06v0 ad=1.0912p pd=5.84u as=0.6448p ps=3u w=2.48u l=1u
X217 a_23002_39576# a_23342_42976# a_36110_43092# VDD pfet_06v0 ad=4.4p pd=20.88u as=2.5p ps=10.5u w=10u l=1u
X218 a_17762_74376# a_13282_75936# a_16830_74260# VSS nfet_06v0 ad=0.25p pd=1.5u as=0.44p ps=2.88u w=1u l=1u
X219 a_38034_25732# a_23042_25616# VDD VDD pfet_06v0 ad=2.5p pd=10.5u as=4.4p ps=20.88u w=10u l=1u
X220 a_55018_34416# a_8062_30900# a_58058_34416# VDD pfet_06v0 ad=4.4p pd=20.88u as=2.6p ps=10.52u w=10u l=1u
X221 a_31140_57052# a_23002_56936# VSS VSS nfet_06v0 ad=1.25p pd=5.5u as=2.2p ps=10.88u w=5u l=1u
X222 a_3582_74260# a_12130_34416# VDD VDD pfet_06v0 ad=4.4p pd=20.88u as=2.6p ps=10.52u w=10u l=1u
X223 VDD Z Z VDD pfet_06v0 ad=0.88p pd=4.88u as=0.52p ps=2.52u w=2u l=1u
X224 VSS a_35678_13656# a_44490_13656# VSS nfet_06v0 ad=1.3p pd=5.52u as=1.3p ps=5.52u w=5u l=1u
X225 a_17202_8260# a_2210_8144# VDD VDD pfet_06v0 ad=2.5p pd=10.5u as=4.4p ps=20.88u w=10u l=1u
X226 a_24354_8260# a_23042_8144# VDD VDD pfet_06v0 ad=2.5p pd=10.5u as=4.4p ps=20.88u w=10u l=1u
X227 a_8062_48260# a_25266_39692# cap_mim_2f0_m4m5_noshield c_width=20u c_length=10u
X228 a_3522_25732# a_2210_25616# VDD VDD pfet_06v0 ad=2.5p pd=10.5u as=4.4p ps=20.88u w=10u l=1u
X229 a_32862_69248# a_32142_65732# a_30938_69248# VDD pfet_06v0 ad=2.6p pd=10.52u as=4.4p ps=20.88u w=10u l=1u
X230 a_64728_6528# a_66178_5204# VSS VSS nfet_06v0 ad=0.5456p pd=3.36u as=0.5456p ps=3.36u w=1.24u l=1u
X231 a_2902_30900# a_2170_30900# a_3102_31016# VSS nfet_06v0 ad=2.2p pd=10.88u as=1.25p ps=5.5u w=5u l=1u
X232 a_31962_8260# a_31762_8144# VDD VDD pfet_06v0 ad=2.5p pd=10.5u as=4.4p ps=20.88u w=10u l=1u
X233 a_15950_13540# a_15950_13540# a_18358_13656# VSS nfet_06v0 ad=2.2p pd=10.88u as=2.2p ps=10.88u w=5u l=1u
X234 a_14166_43092# a_2210_42976# VDD VDD pfet_06v0 ad=2.5p pd=10.5u as=4.4p ps=20.88u w=10u l=1u
X235 VDD a_11014_51776# a_8262_48376# VDD pfet_06v0 ad=2.2p pd=10.88u as=1.3p ps=5.52u w=5u l=1u
X236 a_6258_43092# a_8644_39576# a_5916_39692# VSS nfet_06v0 ad=1.1p pd=5.88u as=1.1p ps=5.88u w=2.5u l=1u
X237 VDD a_13282_75936# a_13182_76052# VDD pfet_06v0 ad=1.32p pd=6.88u as=0.75p ps=3.5u w=3u l=1u
X238 a_24354_25732# a_23042_25616# VDD VDD pfet_06v0 ad=2.5p pd=10.5u as=4.4p ps=20.88u w=10u l=1u
X239 a_58646_65848# a_50330_65732# a_58058_69248# VSS nfet_06v0 ad=0.65p pd=3.02u as=1.1p ps=5.88u w=2.5u l=1u
X240 a_69084_6528# X VSS VSS nfet_06v0 ad=0.5p pd=2.5u as=0.88p ps=4.88u w=2u l=1u
X241 a_54358_48376# a_51062_48260# VSS VSS nfet_06v0 ad=1.25p pd=5.5u as=2.2p ps=10.88u w=5u l=1u
X242 VDD a_2118_74260# a_4314_74260# VDD pfet_06v0 ad=1.32p pd=6.88u as=1.32p ps=6.88u w=3u l=1u
X243 a_48312_22332# a_50970_25616# a_48734_25732# VDD pfet_06v0 ad=2.2p pd=10.88u as=2.2p ps=10.88u w=5u l=1u
X244 a_7670_51776# a_2210_51660# VDD VDD pfet_06v0 ad=2.5p pd=10.5u as=4.4p ps=20.88u w=10u l=1u
X245 Y a_4226_74376# a_65840_24000# VSS nfet_06v0 ad=0.6448p pd=3u as=1.0912p ps=5.84u w=2.48u l=1u
X246 a_2170_30900# a_2170_30900# VSS VSS nfet_06v0 ad=0.44p pd=2.88u as=0.44p ps=2.88u w=1u l=1u
X247 a_23342_42976# a_23342_42976# a_37464_39692# VSS nfet_06v0 ad=0.44p pd=2.88u as=0.25p ps=1.5u w=1u l=1u
X248 VSS a_20410_65848# a_24998_74376# VSS nfet_06v0 ad=0.44p pd=2.88u as=0.44p ps=2.88u w=1u l=1u
X249 a_66518_31016# a_50330_30900# a_67538_31016# VSS nfet_06v0 ad=2.2p pd=10.88u as=1.25p ps=5.5u w=5u l=1u
X250 VDD a_11014_34416# a_9374_31016# VDD pfet_06v0 ad=2.2p pd=10.88u as=1.3p ps=5.52u w=5u l=1u
X251 a_27090_43092# a_29476_39576# a_26748_39692# VSS nfet_06v0 ad=1.1p pd=5.88u as=1.1p ps=5.88u w=2.5u l=1u
X252 a_47110_60452# S2N a_44374_60452# VDD pfet_06v0 ad=4.4p pd=20.88u as=4.4p ps=20.88u w=10u l=1u
X253 a_31884_39692# a_23302_39576# a_32904_39692# VSS nfet_06v0 ad=2.2p pd=10.88u as=1.25p ps=5.5u w=5u l=1u
X254 a_32342_13656# a_32142_13540# a_30578_13656# VSS nfet_06v0 ad=1.3p pd=5.52u as=2.2p ps=10.88u w=5u l=1u
X255 a_11598_65848# a_16494_69132# a_12130_69248# VDD pfet_06v0 ad=2.2p pd=10.88u as=2.2p ps=10.88u w=5u l=1u
X256 a_30938_69248# a_9174_65732# a_33978_69248# VDD pfet_06v0 ad=4.4p pd=20.88u as=2.6p ps=10.52u w=10u l=1u
X257 a_26982_48260# a_26590_51660# a_27602_51776# VDD pfet_06v0 ad=4.4p pd=20.88u as=2.5p ps=10.5u w=10u l=1u
X258 a_56942_69248# a_58646_65848# VSS VSS nfet_06v0 ad=0.65p pd=3.02u as=1.1p ps=5.88u w=2.5u l=1u
X259 VSS a_34566_31016# a_33978_34416# VSS nfet_06v0 ad=1.1p pd=5.88u as=0.65p ps=3.02u w=2.5u l=1u
X260 a_9174_13540# a_6648_4860# VSS VSS nfet_06v0 ad=0.44p pd=2.88u as=0.44p ps=2.88u w=1u l=1u
X261 a_5446_17056# a_2210_16940# VDD VDD pfet_06v0 ad=2.5p pd=10.5u as=4.4p ps=20.88u w=10u l=1u
X262 VDD a_35094_34416# a_32342_31016# VDD pfet_06v0 ad=2.2p pd=10.88u as=1.3p ps=5.52u w=5u l=1u
X263 a_47922_43092# a_50308_39576# a_47580_39692# VSS nfet_06v0 ad=1.1p pd=5.88u as=1.1p ps=5.88u w=2.5u l=1u
X264 a_9174_65732# a_4434_57052# cap_mim_2f0_m4m5_noshield c_width=20u c_length=10u
X265 a_58646_13656# a_64654_16940# a_59174_17056# VDD pfet_06v0 ad=2.2p pd=10.88u as=2.2p ps=10.88u w=5u l=1u
X266 a_6198_65848# a_2902_65732# VSS VSS nfet_06v0 ad=1.25p pd=5.5u as=2.2p ps=10.88u w=5u l=1u
X267 a_27182_13656# a_26982_13540# VSS VSS nfet_06v0 ad=1.25p pd=5.5u as=2.2p ps=10.88u w=5u l=1u
X268 a_30578_48376# a_26250_48260# a_30278_48376# VSS nfet_06v0 ad=2.2p pd=10.88u as=1.25p ps=5.5u w=5u l=1u
X269 a_17614_48376# a_2902_48260# VSS VSS nfet_06v0 ad=1.25p pd=5.5u as=2.2p ps=10.88u w=5u l=1u
X270 a_18118_51660# a_2510_51660# a_18318_51776# VDD pfet_06v0 ad=4.4p pd=20.88u as=2.5p ps=10.5u w=10u l=1u
X271 a_66178_5204# a_66178_5204# VDD VDD pfet_06v0 ad=0.88p pd=4.88u as=0.88p ps=4.88u w=2u l=1u
X272 a_64110_65732# a_50670_69132# a_68402_69248# VDD pfet_06v0 ad=4.4p pd=20.88u as=2.5p ps=10.5u w=10u l=1u
X273 a_32862_17056# a_34566_13656# VSS VSS nfet_06v0 ad=0.65p pd=3.02u as=1.1p ps=5.88u w=2.5u l=1u
X274 a_9374_13656# a_11014_17056# VDD VDD pfet_06v0 ad=1.3p pd=5.52u as=1.3p ps=5.52u w=5u l=1u
X275 a_9898_34416# a_10486_31016# VSS VSS nfet_06v0 ad=0.65p pd=3.02u as=0.65p ps=3.02u w=2.5u l=1u
X276 a_44334_39692# a_44134_39576# a_45066_39692# VSS nfet_06v0 ad=2.2p pd=10.88u as=1.25p ps=5.5u w=5u l=1u
X277 VSS a_58646_48376# a_56942_51776# VSS nfet_06v0 ad=0.65p pd=3.02u as=0.65p ps=3.02u w=2.5u l=1u
X278 a_55830_60452# a_43874_60336# VDD VDD pfet_06v0 ad=2.5p pd=10.5u as=4.4p ps=20.88u w=10u l=1u
X279 a_8262_31016# a_11014_34416# VDD VDD pfet_06v0 ad=1.3p pd=5.52u as=1.3p ps=5.52u w=5u l=1u
X280 a_54718_25732# a_43874_25616# VDD VDD pfet_06v0 ad=2.5p pd=10.5u as=4.4p ps=20.88u w=10u l=1u
X281 a_8644_56936# a_2510_60336# a_13054_60452# VDD pfet_06v0 ad=4.4p pd=20.88u as=2.5p ps=10.5u w=10u l=1u
X282 a_58296_57052# a_44174_60336# VSS VSS nfet_06v0 ad=0.25p pd=1.5u as=0.44p ps=2.88u w=1u l=1u
X283 a_57534_48376# a_59174_51776# VDD VDD pfet_06v0 ad=1.3p pd=5.52u as=1.3p ps=5.52u w=5u l=1u
X284 a_58058_17056# a_58646_13656# VSS VSS nfet_06v0 ad=0.65p pd=3.02u as=0.65p ps=3.02u w=2.5u l=1u
X285 a_48734_8260# a_50308_4744# a_48312_4860# VSS nfet_06v0 ad=1.1p pd=5.88u as=1.1p ps=5.88u w=2.5u l=1u
X286 a_2530_75936# a_35678_31016# VSS VSS nfet_06v0 ad=2.2p pd=10.88u as=1.3p ps=5.52u w=5u l=1u
X287 a_8062_65732# a_25266_57052# cap_mim_2f0_m4m5_noshield c_width=20u c_length=10u
X288 VSS a_10486_65848# a_8782_69248# VSS nfet_06v0 ad=0.65p pd=3.02u as=0.65p ps=3.02u w=2.5u l=1u
X289 a_31310_48376# a_26982_48260# VSS VSS nfet_06v0 ad=1.25p pd=5.5u as=2.2p ps=10.88u w=5u l=1u
X290 a_60290_51776# a_50670_51660# a_56422_48376# VDD pfet_06v0 ad=1.3p pd=5.52u as=2.2p ps=10.88u w=5u l=1u
X291 a_8782_17056# a_20410_13656# cap_mim_2f0_m4m5_noshield c_width=20u c_length=10u
X292 a_6648_39692# a_2470_39576# a_4634_43092# VSS nfet_06v0 ad=1.1p pd=5.88u as=1.1p ps=5.88u w=2.5u l=1u
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
