AnBuiUCI/sscs-2026-zotnetic/FINAL/XSCHEM/TEST_TOTAL/simulation/test_GRADIENT.sch/test_GRADIENT.spice

** sch_path: /foss/designs/a_zonetic2026/XSCHEM/TEST_TOTAL/test_GRADIENT.sch
**.subckt test_GRADIENT
V1 VEXC GND 5
V2 VDD1 GND 5
V6 VDD2 GND 5
x2 S1N S1P VDD1 X1 S2N Y1 Z1 S2P GND S3N S3P GRADIENT
x3 S1N S1P VDD2 X2 S2N Y2 Z2 S2P GND S3N S3P GRADIENT2
R1 VEXC S2P r=' 1meg*(1-v(by)) '
R2 VEXC S2N r=' 1meg*(1+v(by)) '
R3 S2P GND r=' 1meg*(1+v(by)) '
R4 S2N GND r=' 1meg*(1-v(by)) '
V3 VDD3 GND 5
V4 VDD4 GND 5
R5 VEXC S3P r=' 1meg*(1-v(bz)) '
R6 VEXC S3N r=' 1meg*(1+v(bz)) '
R7 S3P GND r=' 1meg*(1+v(bz)) '
R8 S3N GND r=' 1meg*(1-v(bz)) '
R9 VEXC S1P r=' 1meg*(1-v(bx)) '
R10 VEXC S1N r=' 1meg*(1+v(bx)) '
R11 S1P GND r=' 1meg*(1+v(bx)) '
R12 S1N GND r=' 1meg*(1-v(bx)) '
**** begin user architecture code

.include /foss/designs/pdks/gf180mcuD/libs.tech/ngspice/design.ngspice
.lib /foss/designs/pdks/gf180mcuD/libs.tech/ngspice/sm141064.ngspice typical
.lib /foss/designs/pdks/gf180mcuD/libs.tech/ngspice/sm141064.ngspice cap_mim
.lib /foss/designs/pdks/gf180mcuD/libs.tech/ngspice/sm141064.ngspice res_typical
.lib /foss/designs/pdks/gf180mcuD/libs.tech/ngspice/sm141064.ngspice moscap_typical
.lib /foss/designs/pdks/gf180mcuD/libs.tech/ngspice/sm141064.ngspice mimcap_typical



* THE FIELD. Three components 120 degrees apart, which is what makes them sum
* to zero: the vector only changes DIRECTION, not magnitude. Sweeping
* Vang from 0 to 360 covers the whole circle, and if the chain is right each
* eje deberia ganar exactamente 120 grados: X de -60 a 60, Y de 60 a 180 y Z de
* 180 to 300. How far those three boundaries drift is the figure of the bench.
*
* v(amp) IS dR/R, with no conversion factors in between: each bridge arm is
* 1meg*(1 +- v(bx)), so the amplifier sees VEXC*v(bx) of differential signal
* and the common mode stays pinned at VEXC/2 whatever happens to
* la senal. Eso segundo no es un adorno: si el modo comun se moviera con la
* signal it would mix with these cells' common-mode sensitivity and there
* would be no way to separate the two when reading the curve.
*
* Va con fuentes B y resistencias de comportamiento, y no barriendo
* resistors, because dc takes two nested sources at most and here there are
* TWELVE resistors that must all move at once and consistently.
*
* AND A SECOND MODE, for the octant cases. The rotation above pins the three
* readings to bx+by+bz = 0, so patterns like (+,+,+) are unreachable by
* construction and this bench can only ever see three of the eight sign
* combinations. With v(sel) = 1 each reading becomes v(amp) times its own
* coefficient cx/cy/cz, so the SIGNS of those three coefficients pick the
* octant and their MAGNITUDES pick the ordering, while sweeping Vamp still
* sweeps the field inside that octant.
*
* The decoder puts out the SMALLEST axis (X = XY*XZ), so the expected answer
* at every point is argmin(cx, cy, cz) -- a truth table checkable entry by
* entry. Coefficients are given distinct magnitudes on purpose: three equal
* ones are a three-way tie with no right answer.
*
* v(sel) = 0 leaves the rotation exactly as it was: nothing above changes.
Vamp amp 0 0.02
Vang ang 0 0
Vsel sel 0 0
Vcx cx 0 1
Vcy cy 0 0
Vcz cz 0 0
Bbx bx 0 v='v(sel) > 0.5 ? v(amp)*v(cx) : v(amp)*cos( v(ang)       *3.14159265358979/180)'
Bby by 0 v='v(sel) > 0.5 ? v(amp)*v(cy) : v(amp)*cos((v(ang)-120.0)*3.14159265358979/180)'
Bbz bz 0 v='v(sel) > 0.5 ? v(amp)*v(cz) : v(amp)*cos((v(ang)+120.0)*3.14159265358979/180)'




* THE SAME TWO CHAINS, REBUILT FROM THE v2 LAYOUT BLOCKS.
* They hang off the SAME six sensor nodes as the schematic ones and each
* carries its own supply, so current draw can be compared too.
*
* La topologia es la de COMBINATION/GRADIENT.sch, copiada nodo a nodo:
*
*     amp X: S1N->INN  S1P->INP  -> SX        COMP XY: INN=SX INP=SY -> XY
*     amp Y: S2N->INN  S2P->INP  -> SY        COMP XZ: INN=SX INP=SZ -> XZ
*     amp Z: S3N->INN  S3P->INP  -> SZ        COMP YZ: INN=SY INP=SZ -> YZ
*                                             DECODER: XY XZ YZ -> X Y Z
*
* CAREFUL WITH THE PORT ORDER. xschem emits them in the order of the symbol B
* lines and magic in the order it finds them in the layout, and they do NOT agree:
* el esquematico declara OPAM VDD INN OUT INP VSS y el extraido OPAM VSS VDD OUT
* INP INN. Cablear las dos igual significa cosas distintas y no da ningun error.
* That is why the real order is written above each group, and why the files are
* the _V2_ ones produced by TEST/preparar_extraidos.sh: it renames the subcircuit
* -- both declare the same name and cannot be included together -- and normalises
* the order. Note that OPAM_LIN_flat has OUT in the middle and the others do not.
.include ../../../../layouts_v2/OPAM/mag/OPAM_V2_pex_rc.spice
.include ../../../../layouts_v2/OPAM_LIN_flat/mag/OPAM_LIN_flat_V2_pex_rc.spice
.include ../../../../layouts_v2/COMP/mag/COMP_V2_pex_rc.spice
.include ../../../../layouts_v2/DECODER/mag/DECODER_V2_pex_rc.spice

* --- G3: the G1 chain, with the v2 layout OPAM
* .subckt OPAM_V2     VSS VDD OUT INP INN
XA31 GND VDD3 SX3 S1P S1N OPAM_V2
XA32 GND VDD3 SY3 S2P S2N OPAM_V2
XA33 GND VDD3 SZ3 S3P S3N OPAM_V2
* .subckt COMP_V2     VSS VDD OUT INP INN
XC31 GND VDD3 XY3 SY3 SX3 COMP_V2
XC32 GND VDD3 XZ3 SZ3 SX3 COMP_V2
XC33 GND VDD3 YZ3 SZ3 SY3 COMP_V2
* .subckt DECODER_V2  VSS VDD YZ Z XY XZ Y X
XD3  GND VDD3 YZ3 Z3 XY3 XZ3 Y3 X3 DECODER_V2

* --- G4: the G2 chain, with the v2 layout OPAM_LIN_flat
* .subckt OPAM_LIN_flat_V2  VSS VDD INP OUT INN
XA41 GND VDD4 S1P SX4 S1N OPAM_LIN_flat_V2
XA42 GND VDD4 S2P SY4 S2N OPAM_LIN_flat_V2
XA43 GND VDD4 S3P SZ4 S3N OPAM_LIN_flat_V2
* .subckt COMP_V2     VSS VDD OUT INP INN
XC41 GND VDD4 XY4 SY4 SX4 COMP_V2
XC42 GND VDD4 XZ4 SZ4 SX4 COMP_V2
XC43 GND VDD4 YZ4 SZ4 SY4 COMP_V2
* .subckt DECODER_V2  VSS VDD YZ Z XY XZ Y X
XD4  GND VDD4 YZ4 Z4 XY4 XZ4 Y4 X4 DECODER_V2




* CAREFUL: not one brace in this text. xschem counts them to find where the
* attribute block ends and a single one inside a comment cuts it in half,
* leaving the netlist with the template 'blabla' and raising no error.
*
* This bench does NOT need a common-mode source, unlike test_comp_* and
* test_opam_*: there the input pair were two gates with no DC path to
* ground, and here the bridge itself provides it.
*
* The intermediate signals of the schematic chains come out by hierarchical
* name, v(x2.SX) and company. In the hand-rebuilt ones the nodes are
* primer nivel y se llaman SX3, XY3 y asi.
.save all
.control
* Fondo de escala de una AMR tipica: dR/R = 2 %, o sea 100 mV diferenciales.
alter Vamp = 0.02
dc Vang 0 360 0.5
wrdata ancho.txt v(X1) v(Y1) v(Z1) v(X2) v(Y2) v(Z2) v(X3) v(Y3) v(Z3) v(X4) v(Y4) v(Z4) v(x2.SX) v(x2.SY) v(x2.SZ) v(x3.SX) v(x3.SY) v(x3.SZ) v(SX3) v(SY3) v(SZ3) v(SX4) v(SY4) v(SZ4) v(x2.net1) v(x2.net2) v(x2.net3) v(x3.net1) v(x3.net2) v(x3.net3) v(XY3) v(XZ3) v(YZ3) v(XY4) v(XZ4) v(YZ4) v(S1P) v(S1N) v(S2P) v(S2N) v(S3P) v(S3N) v(VEXC)*i(V1) v(VDD1)*i(V2) v(VDD2)*i(V6) v(VDD3)*i(V3) v(VDD4)*i(V4)
* Ventana fina: dR/R = 50 ppm, o sea 250 uV diferenciales.
alter Vamp = 50u
dc Vang 0 360 0.5
wrdata fino.txt v(X1) v(Y1) v(Z1) v(X2) v(Y2) v(Z2) v(X3) v(Y3) v(Z3) v(X4) v(Y4) v(Z4) v(x2.SX) v(x2.SY) v(x2.SZ) v(x3.SX) v(x3.SY) v(x3.SZ) v(SX3) v(SY3) v(SZ3) v(SX4) v(SY4) v(SZ4) v(x2.net1) v(x2.net2) v(x2.net3) v(x3.net1) v(x3.net2) v(x3.net3) v(XY3) v(XZ3) v(YZ3) v(XY4) v(XZ4) v(YZ4) v(S1P) v(S1N) v(S2P) v(S2N) v(S3P) v(S3N) v(VEXC)*i(V1) v(VDD1)*i(V2) v(VDD2)*i(V6) v(VDD3)*i(V3) v(VDD4)*i(V4)
* --------------------------------------------------------------------------
* FIELD SWEEP. Everything above turns the field and keeps its size; these two
* do the opposite -- hold the direction and sweep the MAGNITUDE, which is the
* axis a real magnet moves along as you walk towards it.
*
* The angle is parked at 60 deg, the middle of a sector: on a boundary the
* decision is meant to be undefined and the sweep would only measure noise.
*
* AND THE SWEEP DOES NOT START AT ZERO. With Vamp = 0 the three bridges are
* identical, so the three amplifiers sit at the same output and all three
* comparators land exactly on their trip point: the operating point is not
* unique and ngspice spends the sweep in gmin stepping. Starting one step in
* costs nothing and the solution is definite everywhere.
*
* Only the linear-amplifier chain, G2 (schematic) and G4 (layout), and their
* own new files so ancho.txt and fino.txt keep the column order analizar.py
* reads.
alter Vang = 60
dc Vamp 20u 0.02 20u
wrdata campo.txt v(S1P) v(S1N) v(S2P) v(S2N) v(S3P) v(S3N)
+ v(x3.SX) v(x3.SY) v(x3.SZ) v(x3.net1) v(x3.net2) v(x3.net3)
+ v(X2) v(Y2) v(Z2)
+ v(SX4) v(SY4) v(SZ4) v(XY4) v(XZ4) v(YZ4)
+ v(X4) v(Y4) v(Z4)
+ v(VDD2)*i(V6) v(VDD4)*i(V4)
* And the low end on its own scale, where the offsets and the noise live.
dc Vamp 1u 1m 1u
wrdata campo_fino.txt v(S1P) v(S1N) v(S2P) v(S2N) v(S3P) v(S3N)
+ v(x3.SX) v(x3.SY) v(x3.SZ) v(x3.net1) v(x3.net2) v(x3.net3)
+ v(X2) v(Y2) v(Z2)
+ v(SX4) v(SY4) v(SZ4) v(XY4) v(XZ4) v(YZ4)
+ v(X4) v(Y4) v(Z4)
+ v(VDD2)*i(V6) v(VDD4)*i(V4)
* --------------------------------------------------------------------------
* OCTANT CASES. Eight sign patterns times three magnitude orderings, so
* every axis gets to be the smallest, the middle one and the largest in
* each octant: 24 cases. The coefficients are written into the file as
* its first three vectors, so each file says which case it is and no
* separate manifest can drift out of step with it.
alter Vsel = 1
* case 01: c = (+1.0, +0.6, +0.3)  ->  expected Z
alter Vcx = 1.0
alter Vcy = 0.6
alter Vcz = 0.3
dc Vamp 200u 0.02 200u
wrdata oct_01.txt v(cx) v(cy) v(cz) v(S1P) v(S1N) v(S2P) v(S2N) v(S3P) v(S3N)
+ v(x3.SX) v(x3.SY) v(x3.SZ) v(x3.net1) v(x3.net2) v(x3.net3)
+ v(X2) v(Y2) v(Z2)
+ v(SX4) v(SY4) v(SZ4) v(XY4) v(XZ4) v(YZ4)
+ v(X4) v(Y4) v(Z4)
* case 02: c = (+0.3, +1.0, +0.6)  ->  expected X
alter Vcx = 0.3
alter Vcy = 1.0
alter Vcz = 0.6
dc Vamp 200u 0.02 200u
wrdata oct_02.txt v(cx) v(cy) v(cz) v(S1P) v(S1N) v(S2P) v(S2N) v(S3P) v(S3N)
+ v(x3.SX) v(x3.SY) v(x3.SZ) v(x3.net1) v(x3.net2) v(x3.net3)
+ v(X2) v(Y2) v(Z2)
+ v(SX4) v(SY4) v(SZ4) v(XY4) v(XZ4) v(YZ4)
+ v(X4) v(Y4) v(Z4)
* case 03: c = (+0.6, +0.3, +1.0)  ->  expected Y
alter Vcx = 0.6
alter Vcy = 0.3
alter Vcz = 1.0
dc Vamp 200u 0.02 200u
wrdata oct_03.txt v(cx) v(cy) v(cz) v(S1P) v(S1N) v(S2P) v(S2N) v(S3P) v(S3N)
+ v(x3.SX) v(x3.SY) v(x3.SZ) v(x3.net1) v(x3.net2) v(x3.net3)
+ v(X2) v(Y2) v(Z2)
+ v(SX4) v(SY4) v(SZ4) v(XY4) v(XZ4) v(YZ4)
+ v(X4) v(Y4) v(Z4)
* case 04: c = (+1.0, +0.6, -0.3)  ->  expected Z
alter Vcx = 1.0
alter Vcy = 0.6
alter Vcz = -0.3
dc Vamp 200u 0.02 200u
wrdata oct_04.txt v(cx) v(cy) v(cz) v(S1P) v(S1N) v(S2P) v(S2N) v(S3P) v(S3N)
+ v(x3.SX) v(x3.SY) v(x3.SZ) v(x3.net1) v(x3.net2) v(x3.net3)
+ v(X2) v(Y2) v(Z2)
+ v(SX4) v(SY4) v(SZ4) v(XY4) v(XZ4) v(YZ4)
+ v(X4) v(Y4) v(Z4)
* case 05: c = (+0.3, +1.0, -0.6)  ->  expected Z
alter Vcx = 0.3
alter Vcy = 1.0
alter Vcz = -0.6
dc Vamp 200u 0.02 200u
wrdata oct_05.txt v(cx) v(cy) v(cz) v(S1P) v(S1N) v(S2P) v(S2N) v(S3P) v(S3N)
+ v(x3.SX) v(x3.SY) v(x3.SZ) v(x3.net1) v(x3.net2) v(x3.net3)
+ v(X2) v(Y2) v(Z2)
+ v(SX4) v(SY4) v(SZ4) v(XY4) v(XZ4) v(YZ4)
+ v(X4) v(Y4) v(Z4)
* case 06: c = (+0.6, +0.3, -1.0)  ->  expected Z
alter Vcx = 0.6
alter Vcy = 0.3
alter Vcz = -1.0
dc Vamp 200u 0.02 200u
wrdata oct_06.txt v(cx) v(cy) v(cz) v(S1P) v(S1N) v(S2P) v(S2N) v(S3P) v(S3N)
+ v(x3.SX) v(x3.SY) v(x3.SZ) v(x3.net1) v(x3.net2) v(x3.net3)
+ v(X2) v(Y2) v(Z2)
+ v(SX4) v(SY4) v(SZ4) v(XY4) v(XZ4) v(YZ4)
+ v(X4) v(Y4) v(Z4)
* case 07: c = (+1.0, -0.6, +0.3)  ->  expected Y
alter Vcx = 1.0
alter Vcy = -0.6
alter Vcz = 0.3
dc Vamp 200u 0.02 200u
wrdata oct_07.txt v(cx) v(cy) v(cz) v(S1P) v(S1N) v(S2P) v(S2N) v(S3P) v(S3N)
+ v(x3.SX) v(x3.SY) v(x3.SZ) v(x3.net1) v(x3.net2) v(x3.net3)
+ v(X2) v(Y2) v(Z2)
+ v(SX4) v(SY4) v(SZ4) v(XY4) v(XZ4) v(YZ4)
+ v(X4) v(Y4) v(Z4)
* case 08: c = (+0.3, -1.0, +0.6)  ->  expected Y
alter Vcx = 0.3
alter Vcy = -1.0
alter Vcz = 0.6
dc Vamp 200u 0.02 200u
wrdata oct_08.txt v(cx) v(cy) v(cz) v(S1P) v(S1N) v(S2P) v(S2N) v(S3P) v(S3N)
+ v(x3.SX) v(x3.SY) v(x3.SZ) v(x3.net1) v(x3.net2) v(x3.net3)
+ v(X2) v(Y2) v(Z2)
+ v(SX4) v(SY4) v(SZ4) v(XY4) v(XZ4) v(YZ4)
+ v(X4) v(Y4) v(Z4)
* case 09: c = (+0.6, -0.3, +1.0)  ->  expected Y
alter Vcx = 0.6
alter Vcy = -0.3
alter Vcz = 1.0
dc Vamp 200u 0.02 200u
wrdata oct_09.txt v(cx) v(cy) v(cz) v(S1P) v(S1N) v(S2P) v(S2N) v(S3P) v(S3N)
+ v(x3.SX) v(x3.SY) v(x3.SZ) v(x3.net1) v(x3.net2) v(x3.net3)
+ v(X2) v(Y2) v(Z2)
+ v(SX4) v(SY4) v(SZ4) v(XY4) v(XZ4) v(YZ4)
+ v(X4) v(Y4) v(Z4)
* case 10: c = (+1.0, -0.6, -0.3)  ->  expected Y
alter Vcx = 1.0
alter Vcy = -0.6
alter Vcz = -0.3
dc Vamp 200u 0.02 200u
wrdata oct_10.txt v(cx) v(cy) v(cz) v(S1P) v(S1N) v(S2P) v(S2N) v(S3P) v(S3N)
+ v(x3.SX) v(x3.SY) v(x3.SZ) v(x3.net1) v(x3.net2) v(x3.net3)
+ v(X2) v(Y2) v(Z2)
+ v(SX4) v(SY4) v(SZ4) v(XY4) v(XZ4) v(YZ4)
+ v(X4) v(Y4) v(Z4)
* case 11: c = (+0.3, -1.0, -0.6)  ->  expected Y
alter Vcx = 0.3
alter Vcy = -1.0
alter Vcz = -0.6
dc Vamp 200u 0.02 200u
wrdata oct_11.txt v(cx) v(cy) v(cz) v(S1P) v(S1N) v(S2P) v(S2N) v(S3P) v(S3N)
+ v(x3.SX) v(x3.SY) v(x3.SZ) v(x3.net1) v(x3.net2) v(x3.net3)
+ v(X2) v(Y2) v(Z2)
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
* case 24: c = (-0.6, -0.3, -1.0)  ->  expected Z
alter Vcx = -0.6
alter Vcy = -0.3
alter Vcz = -1.0
dc Vamp 200u 0.02 200u
wrdata oct_24.txt v(cx) v(cy) v(cz) v(S1P) v(S1N) v(S2P) v(S2N) v(S3P) v(S3N)
+ v(x3.SX) v(x3.SY) v(x3.SZ) v(x3.net1) v(x3.net2) v(x3.net3)
+ v(X2) v(Y2) v(Z2)
+ v(SX4) v(SY4) v(SZ4) v(XY4) v(XZ4) v(YZ4)
+ v(X4) v(Y4) v(Z4)
* --------------------------------------------------------------------------
* LIMIT CASES. The octant block above says the block is 94.8 % correct and
* leaves it there. That number is the average of a test where NINE of its
* twenty-four cases sit in the same corner, so it moves when the case list
* moves and says nothing about the circuit. This block measures the corner.
*
* WHAT THE CORNER IS. The decoder puts out the SMALLEST reading, so two of the
* three contend for it and the answer holds only while the amplifier still
* separates those two. Measured on the octant runs, the amplifier rests at
* 0.72 V with 4.24 V of room upward and 0.68 V downward -- SIX TIMES less --
* so a contending pair heading DOWN pins against its rail six times sooner
* than the same pair heading up. That, and not the sign of the octant, is what
* the 94.8 % is made of.
*
* Three families, same margin d between the two contenders, the third reading
* parked where it cannot compete:
*
*   A  pair DOWN, full scale   c = (-1.0, -1.0+d, +0.3)   expected X
*   B  pair DOWN, half scale   c = (-0.5, -0.5+d, +1.0)   expected X
*   C  pair UP,   half scale   c = (+0.5, +0.5+d, +1.0)   expected X
*
* A against B separates the RAIL from the SIZE. B against C separates the two
* rails at equal size, which is the six-to-one asymmetry on its own. Four
* margins each: twelve runs, and the answer is always X, so a flipped output
* is a failure and nothing else.
*
* Files are `lim_NN.txt` and NOT `oct_NN.txt` on purpose: `figuras_octantes.py`
* globs `oct_*.txt`, and a file of a different meaning landing in that glob
* would be read as a ninth octant and would quietly move a published number.
* limit 01: family A, d = 0.05, pair down at 1.0  ->  expected X
alter Vcx = -1.0
alter Vcy = -0.95
alter Vcz = 0.3
dc Vamp 200u 0.02 200u
wrdata lim_01.txt v(cx) v(cy) v(cz) v(S1P) v(S1N) v(S2P) v(S2N) v(S3P) v(S3N)
+ v(x3.SX) v(x3.SY) v(x3.SZ) v(x3.net1) v(x3.net2) v(x3.net3)
+ v(X2) v(Y2) v(Z2)
+ v(SX4) v(SY4) v(SZ4) v(XY4) v(XZ4) v(YZ4)
+ v(X4) v(Y4) v(Z4)
* limit 02: family A, d = 0.10, pair down at 1.0  ->  expected X
alter Vcx = -1.0
alter Vcy = -0.90
alter Vcz = 0.3
dc Vamp 200u 0.02 200u
wrdata lim_02.txt v(cx) v(cy) v(cz) v(S1P) v(S1N) v(S2P) v(S2N) v(S3P) v(S3N)
+ v(x3.SX) v(x3.SY) v(x3.SZ) v(x3.net1) v(x3.net2) v(x3.net3)
+ v(X2) v(Y2) v(Z2)
+ v(SX4) v(SY4) v(SZ4) v(XY4) v(XZ4) v(YZ4)
+ v(X4) v(Y4) v(Z4)
* limit 03: family A, d = 0.20, pair down at 1.0  ->  expected X
alter Vcx = -1.0
alter Vcy = -0.80
alter Vcz = 0.3
dc Vamp 200u 0.02 200u
wrdata lim_03.txt v(cx) v(cy) v(cz) v(S1P) v(S1N) v(S2P) v(S2N) v(S3P) v(S3N)
+ v(x3.SX) v(x3.SY) v(x3.SZ) v(x3.net1) v(x3.net2) v(x3.net3)
+ v(X2) v(Y2) v(Z2)
+ v(SX4) v(SY4) v(SZ4) v(XY4) v(XZ4) v(YZ4)
+ v(X4) v(Y4) v(Z4)
* limit 04: family A, d = 0.40, pair down at 1.0  ->  expected X
alter Vcx = -1.0
alter Vcy = -0.60
alter Vcz = 0.3
dc Vamp 200u 0.02 200u
wrdata lim_04.txt v(cx) v(cy) v(cz) v(S1P) v(S1N) v(S2P) v(S2N) v(S3P) v(S3N)
+ v(x3.SX) v(x3.SY) v(x3.SZ) v(x3.net1) v(x3.net2) v(x3.net3)
+ v(X2) v(Y2) v(Z2)
+ v(SX4) v(SY4) v(SZ4) v(XY4) v(XZ4) v(YZ4)
+ v(X4) v(Y4) v(Z4)
* limit 05: family B, d = 0.05, pair down at 0.5  ->  expected X
alter Vcx = -0.5
alter Vcy = -0.45
alter Vcz = 1.0
dc Vamp 200u 0.02 200u
wrdata lim_05.txt v(cx) v(cy) v(cz) v(S1P) v(S1N) v(S2P) v(S2N) v(S3P) v(S3N)
+ v(x3.SX) v(x3.SY) v(x3.SZ) v(x3.net1) v(x3.net2) v(x3.net3)
+ v(X2) v(Y2) v(Z2)
+ v(SX4) v(SY4) v(SZ4) v(XY4) v(XZ4) v(YZ4)
+ v(X4) v(Y4) v(Z4)
* limit 06: family B, d = 0.10, pair down at 0.5  ->  expected X
alter Vcx = -0.5
alter Vcy = -0.40
alter Vcz = 1.0
dc Vamp 200u 0.02 200u
wrdata lim_06.txt v(cx) v(cy) v(cz) v(S1P) v(S1N) v(S2P) v(S2N) v(S3P) v(S3N)
+ v(x3.SX) v(x3.SY) v(x3.SZ) v(x3.net1) v(x3.net2) v(x3.net3)
+ v(X2) v(Y2) v(Z2)
+ v(SX4) v(SY4) v(SZ4) v(XY4) v(XZ4) v(YZ4)
+ v(X4) v(Y4) v(Z4)
* limit 07: family B, d = 0.20, pair down at 0.5  ->  expected X
alter Vcx = -0.5
alter Vcy = -0.30
alter Vcz = 1.0
dc Vamp 200u 0.02 200u
wrdata lim_07.txt v(cx) v(cy) v(cz) v(S1P) v(S1N) v(S2P) v(S2N) v(S3P) v(S3N)
+ v(x3.SX) v(x3.SY) v(x3.SZ) v(x3.net1) v(x3.net2) v(x3.net3)
+ v(X2) v(Y2) v(Z2)
+ v(SX4) v(SY4) v(SZ4) v(XY4) v(XZ4) v(YZ4)
+ v(X4) v(Y4) v(Z4)
* limit 08: family B, d = 0.40, pair down at 0.5  ->  expected X
alter Vcx = -0.5
alter Vcy = -0.10
alter Vcz = 1.0
dc Vamp 200u 0.02 200u
wrdata lim_08.txt v(cx) v(cy) v(cz) v(S1P) v(S1N) v(S2P) v(S2N) v(S3P) v(S3N)
+ v(x3.SX) v(x3.SY) v(x3.SZ) v(x3.net1) v(x3.net2) v(x3.net3)
+ v(X2) v(Y2) v(Z2)
+ v(SX4) v(SY4) v(SZ4) v(XY4) v(XZ4) v(YZ4)
+ v(X4) v(Y4) v(Z4)
* limit 09: family C, d = 0.05, pair up at 0.5  ->  expected X
alter Vcx = 0.5
alter Vcy = 0.55
alter Vcz = 1.0
dc Vamp 200u 0.02 200u
wrdata lim_09.txt v(cx) v(cy) v(cz) v(S1P) v(S1N) v(S2P) v(S2N) v(S3P) v(S3N)
+ v(x3.SX) v(x3.SY) v(x3.SZ) v(x3.net1) v(x3.net2) v(x3.net3)
+ v(X2) v(Y2) v(Z2)
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
