AnBuiUCI/sscs-2026-zotnetic/(commit log)

2026-06-28 added bias and opamp schematic
    [bias.sch]
2026-06-29 Added the glayout rules
    [opamp.sch]
2026-07-01 added the bias and opamp schematic
    [bias.sch, opamp.sch]
2026-07-01 Fixed the symbol and added opAmp test bench
    [testBenchOpamp.sch]
2026-07-04 Added to the testbench by assigining tags to everything
    [testBenchOpamp.sch]
2026-07-04 netlist for schematic
    [testBenchOpamp.sch]
2026-07-04 new lib
    [opamp.sch, testBenchOpamp.sch]
2026-07-05 first sweep
    [testBenchOpamp.sch]
2026-07-07 Revised Structure
    [testBenchOpamp.sch, testingBias4.sch]
2026-07-07 GAIN 10
    [gain10.sch, high1&2low3&4.sch, untitled-2.sch]
2026-07-08 test2 schematic
    [test2.sch]
2026-07-08 Fix PDK netlist mapping bugs and get testbench simulation working
    [test2 (1).sch, test2.sch]
2026-07-08 add extracted spice netlist
    [test2.sch]
2026-07-09 opamp testbench
    [biasTestbench.sch, sub_diff.sch]
2026-07-10 updated test bench for bias
    [biasTestbench.sch]
2026-07-11 Improves bias block for op amp
    [juanBias.sch, test_opam.sch]
2026-07-11 gain 10 for op amp
    [biasTestbench.sch, gain10.sch]
2026-07-14 Gain 10 final
    [gain10.sch]
2026-07-14 Improved testbench and gain 10 final
    [biasTestbench.sch, gain10.sch]
2026-07-15 Gain 10, I think i did it right this time no illegal tech
    [biasTestbench.sch, gain10.sch, gain10OpAmpSweep.sch, gain10opAmp.sch]
2026-07-16 Add NMOS resistor schematic and testbench
    [NMOSresistor.sch, NMOSresistor_tb.sch]
2026-07-16 Added working NMOS resistor schematic and testbench
    [FINAL_NMOSresistor_tb.sch, NMOSresistor_tb.sch]
2026-07-16 Update NMOS resistor testbench
    [FINAL_NMOSresistor_tb.sch, NMOSresistor_tb.sch]
2026-07-16 Gain10 V2
    [gain10OpAmpSweep.sch, ogOpAmp.sch]
2026-07-17 updated ogOpAmp
    [bias.sch, ogOpAmp.sch]
2026-07-19 sample TB added
    [sample_opamp_close_loop_tb.sch]
2026-07-19 Opamp resistance test bench
    [resistance.sch, untitled-6.sch]
2026-07-19 99k resistance
    [resistance.sch]
2026-07-21 And gate and Invertor gate + their symbols
    [andGate.sch, invertor.sch, resistance.sch]
2026-07-22 testbnech for both the and gate and the invertor gate to measure the propagation delay
    [delayTB.sch, invertor.sch]
2026-07-23 Ignoring venv and adding project files
    [Act1T1.sch]
2026-07-24 propagation delay for all x, y and z logic
    [nor.sch, xDelayTB.sch, xGates.sch, yDelayTB.sch, yGates.sch, zDelayTB.sch, zGate.sch]
2026-07-25 propagation delay with the output load
    [xDelayTB2.sch, yDelayTBV2.sch, zDelayTB2.sch]
2026-07-25 opamp testbench: 10k Gain, need to figure out the voltage biases
    [10kGain.sch, 1k.sch, 9k.sch, untitled-7.sch]
2026-07-25 saving TB
    [untitled.sch]
2026-07-25 added resistors and opamp sim
    [JuanOpAmpSimulate.sch, N_PMOS1kresistor.sch, N_PMOS9kresistor.sch, untitled.sch]
2026-07-25 rename files
    [OpAmpWFeedback.sch]
2026-07-26 added linearity checks
    [JuanOpAmpSimulate.sch, N_PMOS1kresistor.sch, N_PMOS99kresistor.sch, N_PMOS9kresistor.sch, OpAmpWFeedback.sch, OpAmpWFeedbackFull.sch, RfLinearityCheck.sch, RinLinearityCheck.sch]
2026-07-26 resistance.txt changed
2026-07-26 changed 9k resistor bias
    [RfLinearityCheck.sch]
2026-07-26 feedback resistors updated
    [OpAmpWFeedbackFull.sch, RfLinearityCheck.sch, RinLinearityCheck.sch]
2026-07-29 VTH checks
    [nfetVGScheck.sch, pfetVGScheck.sch]
2026-07-31 add NMOS linearity check
    [JuanOpAmpSimulate.sch, NMOS_Linearity_Check.sch]
2026-08-05 Remove NMOS resistor testbench and schematic
    [NMOSresistor.sch, NMOSresistor_tb.sch]
2026-08-05 Magic directory with and gate spice
    [randomIgnore.sch]
2026-08-05 closed loop op amp mods
    [20k_NMOSresistor_tb.sch, 22GAINOpAmpWFeedbackFull.sch, 50k_NMOSresistor_tb.sch, ModifiedOpAmpWFeedbackFull.sch, NMOS_Linearity_Check.sch]
2026-08-05 revise spice for gain simulation
    [10GAINOpAmpWFeedbackFull.sch, 490k_NMOSresistor_tb.sch, JuanOpAmpSimulate.sch, ModifiedOpAmpWFeedbackFull.sch]
2026-08-05 more rail to rail gain sims
    [25GAINOpAmpWFeedbackFull.sch, 75GAINOpAmpWFeedbackFull.sch]
2026-08-07 Add FINAL: GF180 layouts for COMP and WEIGHT_COMP
    Schematics, flattened netlists and generated layouts for the two blocks:
    GDS, magic views and extracted netlists with and without parasitics.
    Both blocks are DRC clean and match the schematic in LVS.
    [COMP.sch, COMP_sc.sch, DECODER.sch, GRADIENT.sch, GRADIENT_NAV.sch, INV_1.sch, OPAM.sch, WEIGHT.sch]
2026-08-08 Pin for and gate
2026-08-09 FINAL: flujo de OpenROAD y top GRADIENT_NAV verificado
    Anade a FINAL/ el flujo completo de integracion en openroad/ y actualiza los
    bloques y esquematicos al estado actual.
    El top GRADIENT_NAV: 371.70 x 408.52 um, 31 macros (12 COMP, 12 OPAM,
    4 DECODER, 3 WEIGHT_COMP), 53 nets de senal ruteadas.
    Estado de verificacion:
    bloque DRC KLayout LVS KLayout DRC magic LVS netgen
    COMP limpio match limpio match
    OPAM limpio match limpio match
    WEIGHT_COMP limpio match limpio match
    DECODER limpio match limpio match
    GRADIENT_NAV limpio abierto limpio abierto
    El DRC d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
    [COMP.sch, COMP_OUT.sch, COMP_sc.sch, DECODER.sch, GRADIENT.sch, GRADIENT_NAV.sch, INV_1.sch, OPAM.sch]
2026-08-09 FINAL: relleno de densidad y documentacion del flujo
    Anade scripts/fill_density.py y las reglas de densidad al flujo, y reescribe el
    README con el proceso completo, como subir a GitHub y las reglas aprendidas.
    El DRC de firma no comprueba densidad si no se le pide (`--density`), asi que
    nunca se habia comprobado. El top las incumplia las siete; son de minimo, falta
    metal. El relleno va DESPUES del GDS: lee out/GRADIENT_NAV.gds y escribe
    out/GRADIENT_NAV_filled.gds, que es el fichero de submision.
    regla capa antes ahora pide
    DCF.1b COMP 10.19% 32.27% 25%
    PL.8 Poly2 7.26% 16.84% 14%
    M1.4 Metal1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
2026-08-10 Apuntar la submision al GDS con relleno de densidad
    info.yaml y lvs_config.json seguian con los marcadores de la plantilla, asi que
    la cadena que lee el chipathon (info.yaml -> lvs_config.json -> LAYOUT_FILE) no
    llegaba a ningun fichero de este repo: apuntaba a $UPRJ_ROOT/gds/A01_topcell.gds,
    que no existe.
    Ahora apunta a FINAL/openroad/out/GRADIENT_NAV_filled.gds, que es el unico GDS
    del repo que pasa las reglas de densidad: sobre el de trabajo el deck saca 8
    violaciones (DCF.1b, PL.8, M1.4, M2.4, M3.4, M4.4, M5.4, MT.3, todas de minimo)
    y sobre el rellenado saca 0. TOP_SOURCE pasa de A01_topcell a GRADIENT_NAV, que
    es como se llama la celda top del GDS y la del esquematico.
    Co-Authored-B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
2026-08-10 LVS del top: Circuits match uniquely
    La causa de fondo era el ORIGIN del LEF. OpenROAD normaliza el master (le suma el
    ORIGIN, de modo que la esquina inferior izquierda de la caja del macro cae en
    (0,0) y el punto del DEF es esa esquina); el lector de DEF de KLayout, al
    sustituir el abstracto por el GDS, coloca el GDS en las coordenadas del propio
    bloque, que aqui empiezan en negativo porque los taps de sustrato salen por la
    izquierda. Los 31 macros salian corridos su ORIGIN en el GDS, hasta 4.21 um en
    WEIGHT_COMP: 42 de las 55 nets abiertas, que era el hueco de 54 nets que netgen
    llevaba meses cantando. El router nunca se equivoco -- su DEF es coherente y su
    informe de DRC sale vacio -- y e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
2026-08-11 LVS de KLayout del top, y una prueba de que las comprobaciones fallan
    == El LVS de KLayout ==
    Correccion de lo que dije en el commit anterior: "168 nets de fanout cero" y
    "17 puertos, faltan VSS y ZP" eran las dos falsas, y salian de un parser mio que
    no seguia las lineas de continuacion `+` de SPICE. La extraccion del deck tiene
    los 19 puertos, 1707 dispositivos y 880 nets, igual que la referencia.
    La causa real es que el deck del PDK llama a `compare` con los limites por
    defecto del comparador (max_depth 8, max_branch_complexity 500) y no los expone.
    Para un circuito plano de 1707 dispositivos con doce rebanadas analogicas iguales
    no dan. Lo demuestra que el deck **falla comparando el la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
2026-08-11 make probar-drc, y los numeros crudos de la prueba
    `make probar --con-drc` no vale: make se cree que `--con-drc` es una opcion suya
    y aborta. Objetivo aparte, `make probar-drc`.
    Y la tabla del README con lo que sale de verdad, no con "lo ve":
    Metal3 a 0.10 um de otro, en COMP -> 4 violaciones M3.2a
    el DRC sobre el GDS CON el corto -> 0 violaciones en 63 ficheros de reglas
    La segunda linea es la que hay que recordar: el deck entero, sus 63 comprobaciones,
    sobre un chip con dos nets cortocircuitadas, y ni una violacion. Un corto no viola
    ninguna regla de DRC.
    Claude-Session: https://claude.ai/code/session_015sT2HeVFGKGv8R9LqCTc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
2026-08-11 final op amp tb added
    [FINAL_OPAMP_TB.sch]
2026-08-23 Submit GRADIENT_NAV2 as the top, and add the missing pin definitions
    info.yaml had no `pins:` section at all, which is the one thing the chipathon
    review explicitly asks for. It now lists all 19 pins clockwise from bottom-left,
    read from the placed coordinates in GRADIENT_NAV2_routed.def rather than written
    by hand, on the assumption that the project sits in the top-left quadrant.
    Two choices are flagged in the file and still worth reviewing: the nine digital
    outputs are declared `analog` because the io_type list has no plain digital
    output, and VSS is declared even though ground is announced as common.
    The submission now points at GRADIENT_NAV2 instead of GRADIENT_NAV:
    * openroad/out_v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
    [DECAP.sch, DECODER.sch, DECODER_MAX.sch, GRADIENT2.sch, GRADIENT3.sch, GRADIENT_NAV2.sch, GRADIENT_NAV2_V2.sch, GRADIENT_NAV3.sch]
2026-08-23 Translate the whole flow to English, and restore the OpenROAD README
    Everything a reader of this repository sees is now in English: comments,
    docstrings, printed messages and identifiers. Around 2,900 lines across the
    OpenROAD flow, the xschem benches and the schematic text blocks.
    FINAL/openroad/README.md comes back, translated rather than deleted. It is the
    only prose in the repository that explains how the collateral is built and what
    each verification step actually checks -- the full process from schematic to
    submission GDS, why three DRC/LVS tools are needed instead of one, and the
    lessons that cost hours to find (the LEF ORIGIN read differently by OpenROAD and
    KLayout, magic evaluatin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
    [DECODER_MAX.sch, GRADIENT3.sch, GRADIENT_NAV2.sch, GRADIENT_NAV2_V2.sch, RED_SUMA.sch, test_GRADIENT.sch, test_NAV2.sch, test_NAV2_geo.sch]
2026-08-27 Secondary ESD on every analogue pin, and the output decision fixed
    SECONDARY (CDM) ESD. The GF180MCU analogue pads carry HBM diodes only
    (gf180mcu_fd_io 4.5), so the CDM network has to be inside the block. A new
    cell, ESD_CDM, goes on each of the eleven analogue pins: a series poly
    resistor and two pairs of clamp diodes, diode_nd2ps_06v0 down to VSS and
    diode_pd2nw_06v0 up to VDD. Measured on the GDS, each junction has a 30 um
    perimeter where the PDK asks for more than 25, and there are two per
    direction.
    It is drawn by openroad/scripts/esd_layout.py and not by the block generator,
    which knows MOSFETs, poly resistors and MIM capacitors and nothing else. Three
    things had to be found by measu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
    [ESD_CDM.sch, GRADIENT_NAV2.sch, WEIGHT.sch, ancho.csv, ancho_nav2.csv, ancho_nav2_v2.csv, caja.csv, disparo_vdd.csv]
2026-08-29 Add the padring user-area integration (B26_A)
    out_integration/ holds the routed user area: our GRADIENT_NAV2 macro placed
    inside the organisers' 1110 x 1110 um slot, the routing to the 73 pins and
    the tie-offs that program the six digital pads. route_drc.rpt is empty.
    Everything needed to reproduce it goes with it:
    scripts/integrate_padframe.py derives verilog/B26_A.v, the pin boxes and
    the macro origin from the padring files and
    info.yaml -- nothing below is typed by hand
    scripts/integrate_top.tcl floorplan + route of the user area
    scripts/macro_lef.py the macro abstract the integration reads
    scripts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
2026-08-29 Secondary ESD out of the block, into the user area; two schematics
    WHERE THE SECONDARY ESD LIVES. It moves out of GRADIENT_NAV2 and into the
    padring's user area, one cell per analogue pin, next to the pad it protects.
    That is what a CDM clamp is for -- the shorter the pad -> clamp -> gate path the
    better it works -- and out there the area was empty anyway: the eleven cells
    take 71,027 um2 of the 1,047,158 that were free, 6.8 %, where inside the block
    they would have grown it by 35 %.
    The cell is the organisers' own io_secondary_5p0, adopted AS DRAWN. Measured,
    not assumed: their GDS passes the sign-off DRC over 63 rule tables with 0
    violations and passes LVS against a reference that describ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
    [B26_A.sch, GRADIENT_NAV2.sch, io_secondary_5p0.sch]
2026-08-29 Density fill on the integrated area, and a handoff document
    The fill guard was the MINIMUM metal spacing; it has to be the WIDE one.
    Every metal carries a second spacing rule, M*.2b (0.30 um, and MT.2b 0.50
    on the top metal), that applies as soon as the neighbour is wider AND
    longer than 10 um. The 73 pin ports of the padring are 44 x 55 um plates
    of Metal2, so everything placed beside them is judged by the wide number.
    Filling at 0.28 left a 0.285 um gap: 57 x M2.2b on a B26_A_filled.gds that
    the density pass called clean. fill_density.LAYERS now uses the wide
    spacing on every metal.
    B26_A_filled.gds re-generated with it. The seven density minimums are met
    with room to spare: COMP 41.66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
    [ESD_CDM.sch, ESD_CDM2.sch, OPAM_LIN_flat.sch, manifiesto.csv, sub_diff_2_LIN.sch]
2026-08-29 Documentation out of the design repository
    The four markdown files under FINAL/ move to Juander28/GDS_GENERATOR, next to
    the generator they describe, so that this repository stays what it is meant to
    be: the design. Schematics, layouts, netlists, GDS.
    FINAL/HANDOFF.md -> docs/HANDOFF.md
    FINAL/openroad/README.md -> docs/openroad-flow.md
    FINAL/XSCHEM_v2/README.md -> docs/xschem-v2.md
    FINAL/XSCHEM/TEST_TOTAL/FUNCIONALIDAD_TOP.md -> docs/top-functionality.md
    Nothing is lost: all four are in that repository before this removes them here.
    FINAL/.gitignore now keeps *.md out, alongside the PDFs and the
    document-generator scripts.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
2026-08-29 Secondary ESD next to the pads, and the integrated area verified
    The eleven io_secondary_5p0 clamps move OUT of GRADIENT_NAV2 and into the
    padring's user area, each one beside the pad it protects: whatever sits between
    the pad and the clamp is unprotected, so inside the block they were in the wrong
    place. The signal now passes THROUGH them -- the pad drives ASIG5V and the core
    hangs off to_gate -- and who gets one is derived from `secondary_esd` in
    info.yaml, not from a list.
    5 west pads clamp at x 58, centred on the pad's y
    6 north pads clamp at y 964.65, centred on the pad's x
    GRADIENT_NAV2 rebuilt without them: 460.90 x 386.99 um, router DRC empty, DRC
    clean, 55/55 nets conn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
    [B26_A.sch, GRADIENT_NAV2.sch]
2026-08-29 check_integration: the chain is pad -> clamp -> block, not pad -> block
    Its criterion predated the secondary ESD. It asked that the boundary pin and
    the block's pin come out on the SAME net, which since the eleven clamps went in
    is exactly backwards: the signal passes through the clamp -- the pad drives
    ASIG5V, the core hangs off to_gate -- so the two sides are different nets by
    design. Six of the eleven were being reported as broken while they were right,
    and five were being reported as fine while they were shorted.
    Now the two hops are checked separately, and the two sides are required to be
    DIFFERENT. Equal means the series resistor is bypassed: the clamp is inert and
    no DRC says a wo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
2026-08-30 Our own secondary ESD, drawn to the organisers' exact schematic
    The eleven clamps stop being io_secondary_5p0 and become ESD_CDM: the SAME
    circuit, drawn by us. Straight from their io_secondary_5p0.sch:
    D1 diode_pd2nw_06v0 r_w=10u r_l=10u m=4
    D2 diode_nd2ps_06v0 r_w=10u r_l=10u m=4
    R1 ppolyf_u W=16e-6 L=4e-6 m=1
    `m=4` is written as four instances, because KLayout does not expand it, and the
    resistor's bulk goes to VDD -- the `B` pin of their symbol -- so the body sits
    over an n-well with its own n+ tap. The extraction reads back exactly that:
    four diode_nd2ps, four diode_pd2nw at A=100p P=40u, and
    `R$9 PAD CORE VDD 87.5 ppolyf_u L=4U W=16U`.
    per clamp 645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
    [B26_A.sch, ESD_CDM.sch]
2026-08-31 B26_A_filled2: the pin escapes become combs, and the eleven MSLOT.1 go
    The submission file is now out_integration/B26_A_filled2.gds. The "2" is the
    version, not a second chip; lvs_config.json and info.yaml point at it.
    WHAT WAS WRONG. Every signal pin gets a straight Metal2 escape past the two
    supply buses, and it was drawn as ONE SOLID BOX covering the whole pin. On a
    digital pin that is 0.38 um tall and harmless. On an analogue pad it is eight
    teeth spanning 44.32 um, so the box came out 55.7 x 44.3 um -- metal over 30 um
    wide in BOTH directions, which is MSLOT.1 without slotting. Eleven pads, eleven
    violations: five on the west edge, six on the north.
    They had been there since the escap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
2026-08-31 The deliverable passes the COMPLETE sign-off deck, mslot included
    out/drc_B26_A_FILLED/B26_A_filled_main.lyrdb -- one `main` table, deep mode,
    one thread, on B26_A_filled.gds itself:
    253 rule categories declared, 0 items
    MSLOT.1 among the categories, so the rule genuinely ran
    That is the first time in this project that the file being submitted has been
    through the whole deck. Every earlier "63 tables, 0 violations" came from the
    split-table run, which on a filled file loses five tables -- ldnmos, nwell,
    ldpmos, lvpwell and mslot -- and a lost table writes no .lyrdb, which a
    violation count reads as clean.
    The archive entry for 2026-08-31_02 records both runs and says which one is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
2026-08-31 lvs_klayout: alias the labels, and try a ladder instead of one setting
    The KLayout comparer was never given the two anchors that hold this circuit up.
    KLayout joins every label that lands on a net with `|`, and the fifty tie-offs
    put each pad-control label on a rail, so the extraction's supplies are named
    `VDD|XN_OE|...` and `VSS|XN_CS|...`. Matching whole names found neither `VDD`
    nor `VSS`. Every label now counts as an alias.
    And `max_depth=30, max_branch_complexity=10000` was tuned on GRADIENT_NAV2. On
    B26_A there is a cliff between depth 16 and 18 -- 810 nets matched on one side,
    32 on the other -- so a single setting cannot serve both. `ESCALERA` tries a
    ladder, one comparison per subp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
2026-08-31 B26_A.sch: the six <sig>_IN ports are gone, and they were wrong twice over
    XSCHEM/B26_A.sch had six ipin symbols parked in a corner at (-2000, -2000)
    onwards -- XP_IN, XN_IN, YP_IN, YN_IN, ZP_IN, ZN_IN -- wired to nothing.
    The name lies, and integrate_padframe.py already says so in its own header: on
    this pad `<sig>_OUT` is terminal A, which is the pad's data INPUT and the one
    our block drives, while `<sig>_IN` is the receiver output Y, which this design
    does not use -- it is classified as `suelto` there for exactly that reason. So
    they were declared as inputs of the user area when they are outputs of the pad,
    and nothing in the circuit touches them.
    And a port no device touches is not a p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
    [B26_A.sch]
2026-09-01 check_environment.py: the ground, before anything is built on it
    Run it first on a new machine. The flow does not live in one directory: it
    reaches out to a PDK, to a virtualenv with a PINNED gdsfactory, to five binaries
    and to a SIBLING tree that is not in this repository -- all by absolute path.
    On a fresh box the failure is not "it does not work": it is a script that runs,
    finds nothing where it expected something, and reports a clean result about a
    circuit it never read. This project has been bitten by that shape of failure
    four times.
    It checks the binaries and their versions, the PDK and the four deck entry
    points, that the SYSTEM python3 has docopt (run_lvs.py imports it, and without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
2026-09-02 Merge the clamp n-wells: the deck now passes with AND without connectivity
    The user ran the DRC by hand from the KLayout GUI and got 33 NW.2b_MV on
    B26_A_filled3.gds -- a file this flow had just called clean. Both answers were
    right. They are different rules:
    with connectivity unconnected_nwell_5p0v.overlapping(dualgate)
    without it nw_mv.isolated(1.7.um, euclidian)
    NW.2b_MV is "Min. Nwell Space [Different potential]", 1.7 um; its equipotential
    twin NW.2a_MV asks 0.74 um. Which applies depends on knowing the potentials, and
    without connectivity the deck cannot, so it assumes the worst and flags every
    neighbour. Each ESD_CDM drew four separate n-wells 1.330 um apart --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
2026-09-02 Root info.yaml: the versions are no longer interchangeable
    The pointer was already right -- lvs_config.json names B26_A_filled3.gds and
    that file in the repo is the corrected 41bef27a -- but the prose beside it in
    the ROOT info.yaml still said all three filled GDS were byte-identical at
    95ebcf92. That stopped being true when the clamp n-wells were merged.
    _filled3 is now 41bef27a and is the only one to read. B26_A_filled.gds and
    _filled2 are the older 95ebcf92 and are superseded, which is precisely why the
    submission reads the numbered file: the flow keeps writing B26_A_filled.gds as
    its own output, so an unnumbered name could be picked up stale.
    The comment now records both fixes _filled3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
2026-09-08 El nucleo del chip pasa a GRADIENT_NAV2_V3: B26_A_filled4.gds
    El area integrada lleva ahora el navegador con los puertos de sensor
    reordenados -- mismas celdas hoja, mismo interfaz y el mismo hueco de
    460.90 x 386.99 um -- que en simulacion sube el acierto del 76.2 % al
    90.7 % y baja las salidas indefinidas del 1.1 % al 0.0 %.
    Su alimentacion se rehizo con las filas espejadas: cada canal lleva un
    solo net, los railes abutan, y la separacion entre nets contrarios pasa
    de 2 um a 43.46. Los cuatro conductores dan 31 mA -- el doble del pico
    medido de 15.50 -- en el PEOR corte de cada eje, no en el del centro.
    Y la integracion ata TODOS los puertos de Metal5 del bloque, 29.95 um de
    VDD y 39.07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
    [B26_A.sch, DECODER_MAX.sch, GRADIENT_NAV2.sch, GRADIENT_NAV2_V3.sch, OPAM_LIN_flat.sch, ancho.csv, ancho_nav2.csv, caja.csv]
2026-09-08 Limpieza de conocimiento: check_docs.py, y las afirmaciones que ya no eran verdad
    Un comprobador nuevo, scripts/check_docs.py, contrasta contra ficheros de verdad
    lo que afirman los 16 .md del arbol: que el entregable que nombran
    lvs_config.json e info.yaml exista y sea el mismo en los dos, que su sha256
    coincida con el archivo de integration/gds/, que los recuentos de LVS citados
    salgan de los .rpt, que el tamano del bloque sea el de su DEF, que los ficheros
    citados existan, y que ningun documento presente como entregable uno anterior.
    Se ejecuta y falla con nombres y numeros, no con una opinion.
    Lo que caza, corregido:
    * HANDOFF.md daba _filled3 como entregable, 14.81 mA de consumo, 22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
2026-09-08 La presentacion deja de afirmar un DRC que no se corrio sobre el fichero que se entrega
    El pie de la diapositiva de verificacion decia "el DRC se corrio en los dos
    modos de conectividad, el diseno ya no depende de como lo ejecute quien lo
    revise". Eso es verdad de _filled3 y NO se ha vuelto a correr sobre _filled4:
    sobre el que se entrega esta el deck de 63 tablas con 0 violaciones, la pasada
    de densidad y el LVS. La diapositiva lo dice ahora tal cual, con el limite
    puesto donde esta.
    Es la misma clase de error que la limpieza de los .md acaba de barrer -- una
    frase que fue cierta y dejo de serlo al cambiar el fichero debajo -- y en una
    presentacion pesa mas, porque se proyecta delante de q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
2026-09-08 check_docs: README_GDS_GENERATOR.md describe el OTRO repositorio
    Sus rutas son relativas al arbol de GDS_GENERATOR, donde la documentacion vive
    en docs/ -- alli es donde la deja subir.sh -- mientras que en el arbol de
    trabajo HANDOFF.md esta en la raiz. El comprobador las cotejaba contra este
    arbol y marcaba como rota una referencia que es correcta donde se lee. Ahora
    las coteja contra el clon de las herramientas si existe.
    Marcarlas como rotas seria pedirle a ese fichero que mintiera sobre su propio
    repositorio, y silenciarlas a secas seria peor: dejaria de comprobarse.
    Quedan cuatro avisos y ningun fallo. Los cuatro son cifras y tamanos de tandas
    anteriores citados como historia, y los d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
2026-09-08 Sensado: la tabla por condicion, y un banco que lleva ese fallo al limite
    LA TABLA. La de octantes enseñaba ocho barras desiguales y dejaba suponer que
    el chip trata distinto a un signo que a otro. No es eso. El decodificador saca
    el MENOR, y "el menor" cae en la señal mas pequeña cuando los tres sentidos son
    positivos y en la MAS GRANDE cuando son negativos; como saturar depende del
    tamaño y no del signo, los octantes negativos le piden al comparador que
    resuelva justo el par que se pega antes al rail.
    Agrupados por esa condicion, los 24 casos se ordenan solos: cuatro de las cinco
    filas al 100 % sin fallar en todo el barrido, y una sola cae -- la que necesita
    las DOS condiciones a la v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
    [test_GRADIENT.sch]
2026-09-08 Fuera el fichero de bloqueo que se colo, y que no vuelva
    `~$reporte_zotnetic_EN.pptx` son 165 bytes que deja LibreOffice mientras
    alguien tiene la presentacion abierta, y `cp -a` los copia como cualquier
    otro fichero. Se quita del repositorio, se ignora en FINAL/.gitignore, y
    subir.sh los borra de la copia antes de mirar que va a subir -- las dos cosas,
    para no depender de una sola.
    Claude-Session: https://claude.ai/code/session_01NjEUpYegLtxYGG1MpRg98R
2026-09-08 subir.sh borra los ficheros de bloqueo de la copia
    Se probo: con la presentacion abierta, un $-lock de 165 bytes llega al commit.
    Ahora `find FINAL \( -name '~$*' -o -name '.~lock.*' \) -delete` corre justo
    despues del `cp -a` y antes de mirar que va a subir.
    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
2026-09-08 Fuera las capturas de la v2, y GRADIENT2 con lo ultimo medido
    LAS CAPTURAS. La diapositiva del navegador ponia el ESQUEMATICO de
    GRADIENT_NAV2 al lado del LAYOUT de la v3: dos versiones distintas en la misma
    hoja, y con el titulo de la que ya no se fabrica. Ahora las dos son de la v3.
    sch_GRADIENT_NAV2 -> sch_GRADIENT_NAV2_V3, recapturado (el esquematico
    cambio el 09-07 al escribirle el bloque DESACOPLE)
    layout_GRADIENT_NAV2 -> layout_GRADIENT_NAV2_V3, que es lo que ya contenia:
    el fichero se llamaba como la version anterior
    tb_NAV2, tb_NAV2_geo -> tb_NAV3, tb_NAV3_geo. El de geometria instancia LAS
    DOS versi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
2026-09-08 Auditoria de la v2 en la presentacion: lo que quedaba, y por que
    Se reviso figura por figura de donde salen sus datos, no solo como se llaman.
    APUNTABAN A LOS DATOS DEL NAVEGADOR ANTERIOR y ahora leen los de la v3, que
    tienen las MISMAS 54 columnas porque el banco es el mismo con el top cambiado:
    figuras_decision.py total_1_votes, total_2_outputs
    figuras_layout_vs_esq.py esq_vs_layout_salidas / _error / _consumo
    Con eso cambian numeros que la presentacion daba como del chip:
    salidas digitales 99.5 % en X e Y y 98.9 % en Z -> 99.72 % los tres
    desacuerdo 2-4 grados -> 1.5 grados
    consumo 75.32 / 74.15 mW -> 74.85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
2026-09-08 El mazo ingles iba con cuatro tablas en castellano, y verificar.py no lo veia
    EL FALLO. Meti CONDICIONES, LIMITE, GRAD2 y POTENCIA como literales en
    hacer_pptx.py en vez de en textos.py, asi que las cuatro se emitian igual en
    los dos idiomas. Ahora estan en textos.py con su version de cada uno.
    Y POR QUE NO SALTO. `verificar.py` miraba `sh.has_text_frame`, que es FALSO en
    un GraphicFrame: no entraba en ninguna tabla. Daba cero fugas con cuatro tablas
    enteras en castellano dentro del mazo ingles. Ahora las recorre, y ademas junta
    la tabla ENTERA en un texto antes de contar palabras: celda a celda, una como
    "a railes opuestos, el mayor a 0.6" trae una sola palabra de la lista y no
    llega al um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
2026-09-08 El guion va ya en las notas del PowerPoint, y con la procedencia de cada cifra
    EL GUION SOLO VIVIA EN EL .txt DE AL LADO. Quien abre el PowerPoint para
    presentar no tenia delante ni una linea. Ahora `Guion.notas()` lo deja tambien
    en el panel de notas de cada diapositiva: 88 de 88 en los dos mazos.
    Dos cosas que hubo que arreglar para eso. `estilo._nace()` avisaba solo con el
    titulo, asi que quien escuchaba no tenia la diapositiva donde escribir; ahora
    se la pasa. Y la primera version escribia las notas desde `escribir()`, que
    corre DESPUES de `prs.save()`: se añadian a un objeto que ya estaba en disco y
    el fichero salia con cero notas. Van antes de guardar.
    LA PROCEDENCIA, en 21 diaposit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
2026-09-08 La diapositiva de los octantes del navegador enseñaba los votos del reparto anterior
    El `hay()` de esa diapositiva decia `oct_nav2` y no `oct_nav3`: salia el mapa de
    76.2 %, el del reparto ANTERIOR, con el subtitulo "all eight sign combinations
    of the gradient" y todo el guion hablando de la version que se fabrica. La
    siguiente, la de comparacion, tambien lleva `oct_nav2`, asi que la presentacion
    enseñaba dos veces el mismo mapa y ninguna vez el nuevo.
    El cambio se hizo una vez y se PERDIO en una reescritura posterior de
    hacer_pptx.py. No lo caza nada: la diapositiva sale, con su titulo, con su
    narracion y con una figura valida.
    Asi que ademas de corregirlo hay una comprobacion nueva en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
    [OPAM_LIN_flat.sch]
2026-09-08 El orden de las diapositivas pasa a ser el que puso el usuario a mano
    Comparando su mazo con el generado salen TRES diferencias de orden reales. El
    resto de lo que se movia eran diapositivas añadidas despues, no reordenaciones.
    1. El esquematico y el layout del top (`GRADIENT_NAV2_V3`) estaban en la
    seccion 2, entre el diagrama del navegador y la alimentacion. Van al
    principio de la seccion 3, justo tras el separador de resultados. Es donde
    los movio el, y tiene sentido: en la seccion 2 se explica el bloque por
    bloque, y una foto del top entero ahi interrumpe; abriendo los resultados
    del sistema completo, situa.
    2. El "por dentro" de OPAM_LIN y de COMP -- gene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
2026-09-11 waferspace: proyecto del slot quarter e integracion completa
    El bloque GRADIENT_NAV2_V3 metido en el marco de wafer.space, en la esquina
    superior izquierda del core, con padring, ESD secundario, alimentacion y
    ruteo. Todo en waferspace/, con su propio PDK y sus propios guiones.
    waferspace/
    ZOTNETIC.md que se cambio de la plantilla y por que
    PINES.md el plan de pines y conexiones
    flow/ floorplan, integracion, gds, render y figuras
    out/ el estudio de espacio del quarter y del die en cuatro
    out_integracion/ la integracion: DEF, GDS 25 MB, route_drc.rpt de 0 bytes
    Lo que esta medido, no supuesto:
    - alimentacion a 31 mA por los cuatro lados: 120 um en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
2026-09-29 info.yaml: readiness flags for the 2026-09-21 format
    Adds gf_def_ready, ws_def_ready, drc_ready and lvs_ready, all true: the pin
    list is final for either pad frame, and B26_A_filled4.gds is the DRC- and
    LVS-checked integration against the user-area DEF of 2026-08-29 (identical
    to the one of 2026-08-27 it was built on).
    Drops secondary_esd from the analogue pins, which the format now ignores;
    the CDM network is in the user area regardless. Removes the header note
    saying the padring had to be regenerated -- it was, in August.
    Claude-Session: https://claude.ai/code/session_01ErRDobedgaMZyACxVttC4H
2026-09-30 info.yaml: 13 pins, fits a wafer.space quarter-size project
    Drops the three negated outputs (XN YN ZN) and the three analogue test points
    (X Y Z): 8 sensor pins + XP YP ZP + VDD + VSS = 13, which fits every
    wafer.space quarter-size configuration (13-15 pins) as well as the GF frame.
    The block itself does not change; those six ports are left unconnected in
    the user area.
    drc_ready and lvs_ready go to false: B26_A_filled4.gds was integrated against
    the 19-pin user-area DEF and does not match this pin list. They go back to
    true once the block is integrated into the new DEF and checked.
    Claude-Session: https://claude.ai/code/session_01ErR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
